AndriesTuinhof/stmbl/hardware/IRAM256A/doc/f405_dma.png

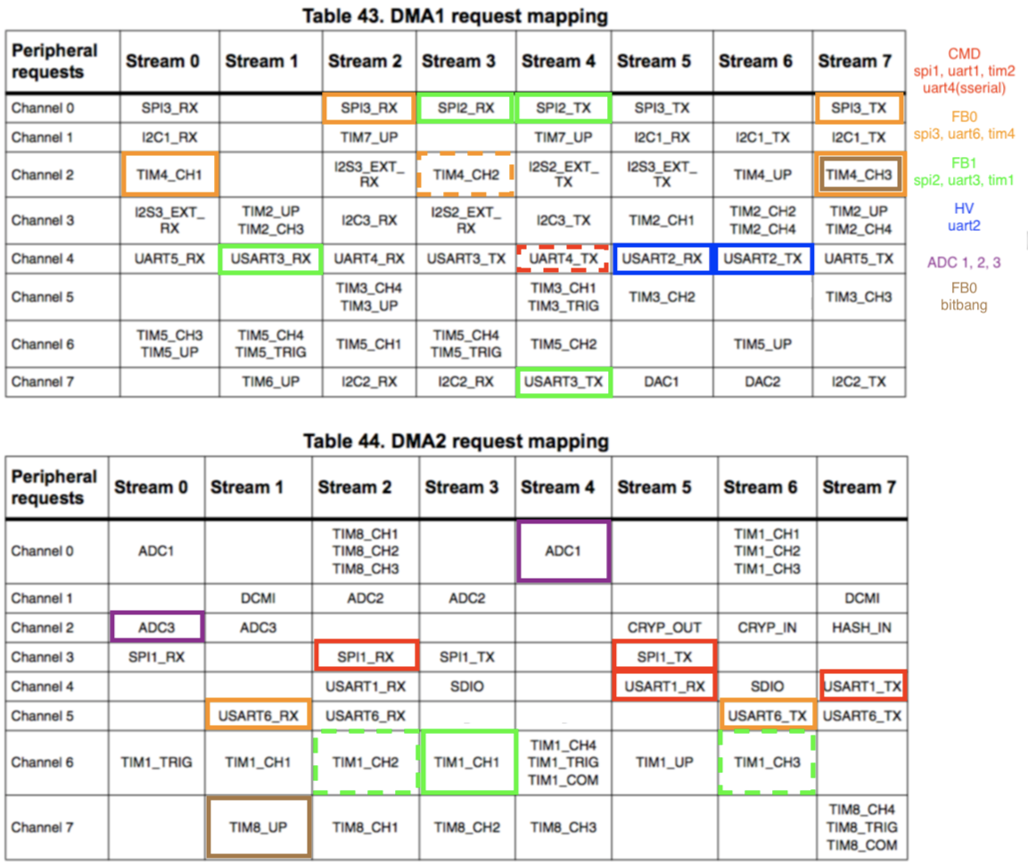
hardware/IRAM256A/doc/f405_dma.png
