AndriesTuinhof/stmbl/hardware/IRAM256A/doc/f303_dma1.png

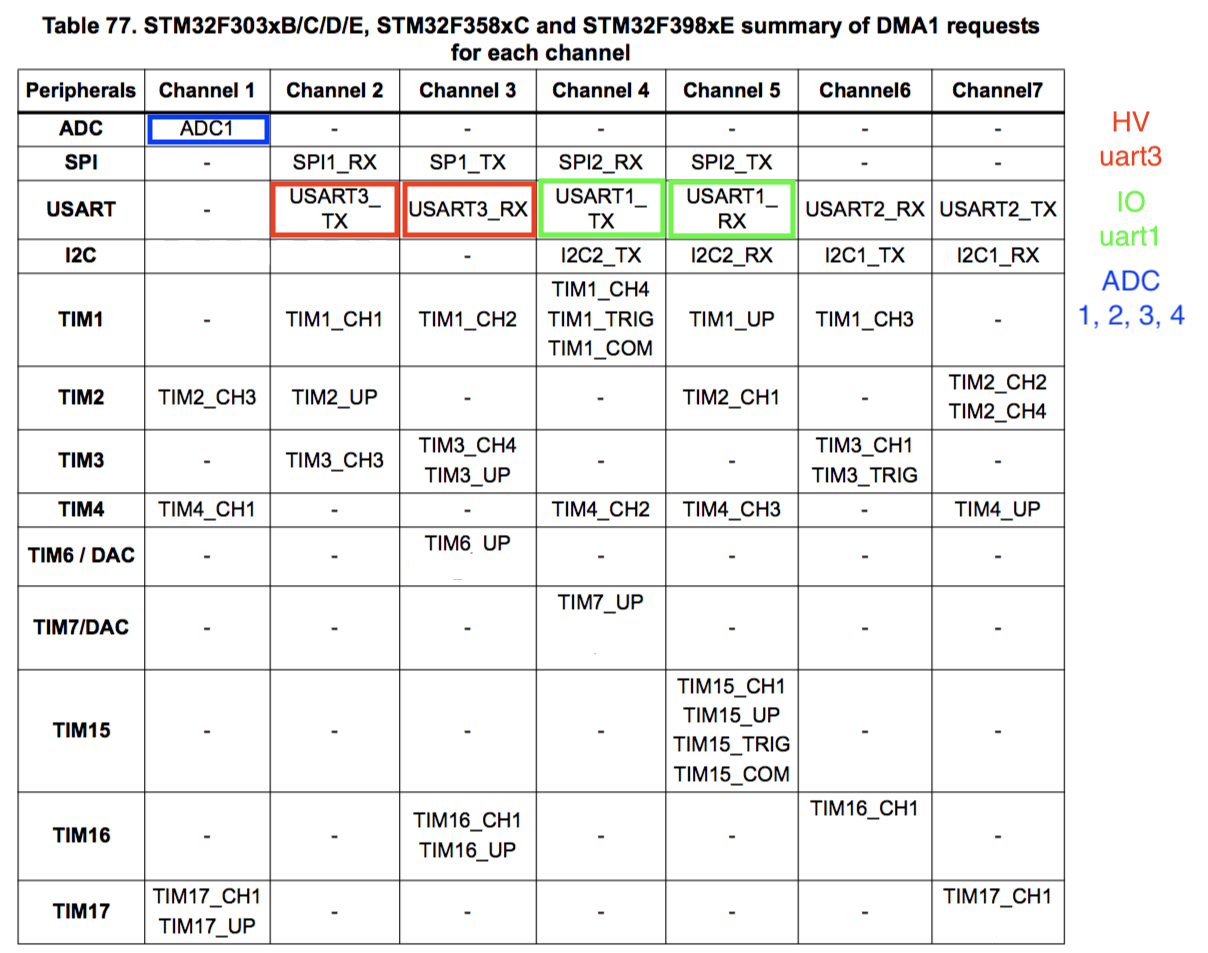
hardware/IRAM256A/doc/f303_dma1.png
