AndriesTuinhof/stmbl/hardware/IRAM256A/doc/f303_dma2.png

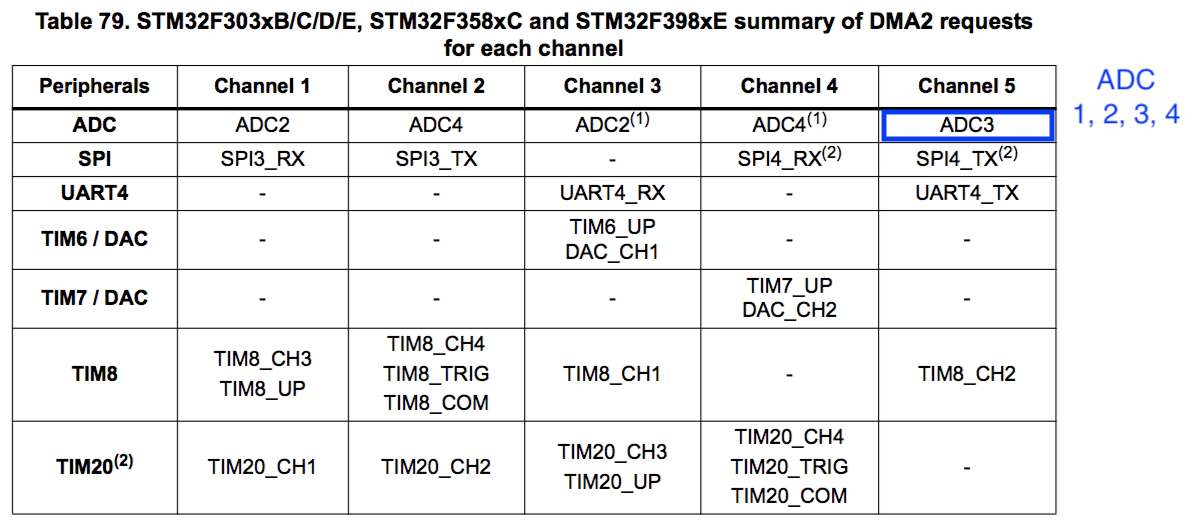
hardware/IRAM256A/doc/f303_dma2.png
