AndriesTuinhof/stmbl/hardware/IRAM256A/doc/heatsink.dxf

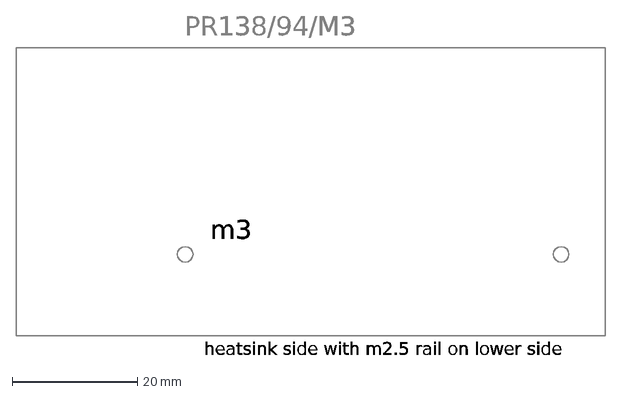
[picture p4: CAD file, 2022-10-24]
hardware/IRAM256A/doc/heatsink.dxf
m3
heatsink side with m2.5 rail on lower side
PR138/94/M3
