AndriesTuinhof/stmbl/hardware/old designs/kicad/troller/troller.dxf

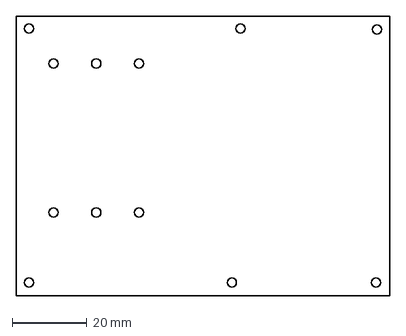
[picture p5: CAD file, 2022-10-24, an earlier design]
hardware/old designs/kicad/troller/troller.dxf
100.0 x 75.0 mm
