AndriesTuinhof/stmbl/hardware/old designs/platte.dxf

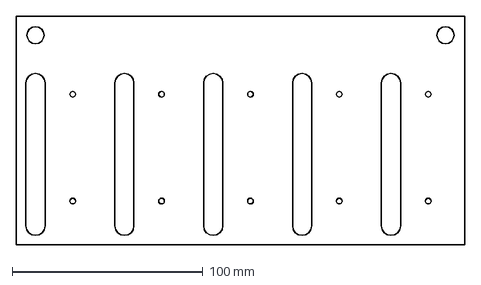
[picture p6: CAD file, 2022-10-24, an earlier design]
hardware/old designs/platte.dxf
235.0 x 120.0 mm
