AndriesTuinhof/stmbl/hardware/old designs/tools/case_v4.stl

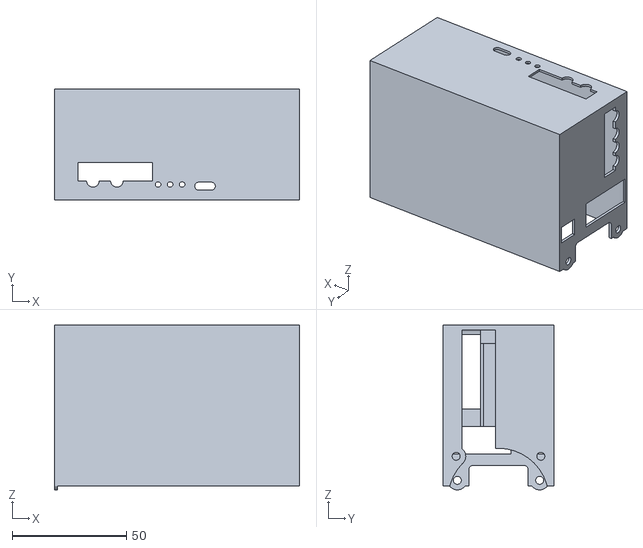
[picture p7: CAD file, 2022-10-24, an earlier design]
hardware/old designs/tools/case_v4.stl
107.1 x 48.6 x 72.0
