AndriesTuinhof/stmbl/hardware/old designs/tools/clip.dxf

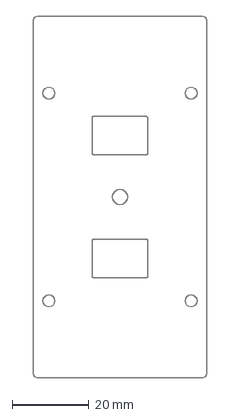
[picture p9: CAD file, 2022-10-24, an earlier design]
hardware/old designs/tools/clip.dxf
45.0 x 94.0 mm
