AndriesTuinhof/stmbl/hardware/old designs/tools/v4_bracket2.stl

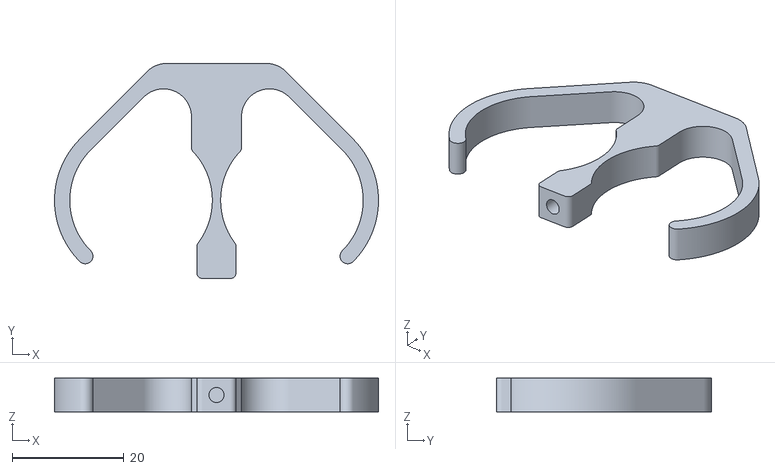
[picture p10: CAD file, 2022-10-24, an earlier design]
hardware/old designs/tools/v4_bracket2.stl
58.0 x 38.5 x 6.00
