AndriesTuinhof/stmbl/hardware/old designs/tools/v4_bracket3.stl

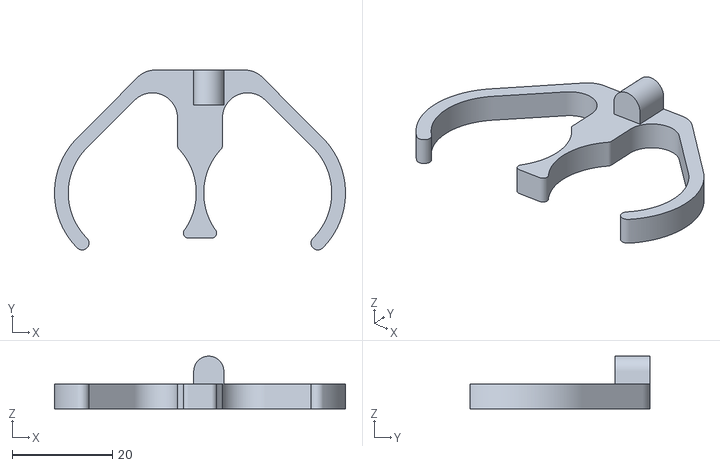
[picture p11: CAD file, 2022-10-24, an earlier design]
hardware/old designs/tools/v4_bracket3.stl
58.0 x 35.9 x 10.5
