AndriesTuinhof/stmbl/hardware/old designs/tools/sheet_metal_case_08.dxf

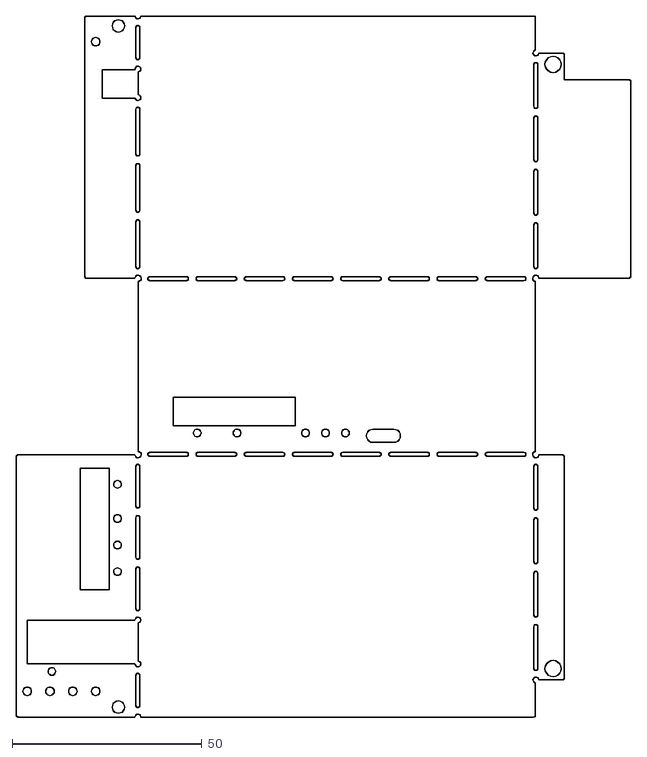
[picture p12: CAD file, 2022-10-24, an earlier design]
hardware/old designs/tools/sheet_metal_case_08.dxf
161.7 x 184.5
