AndriesTuinhof/stmbl/hardware/old designs/tools/v4_bracket.stl

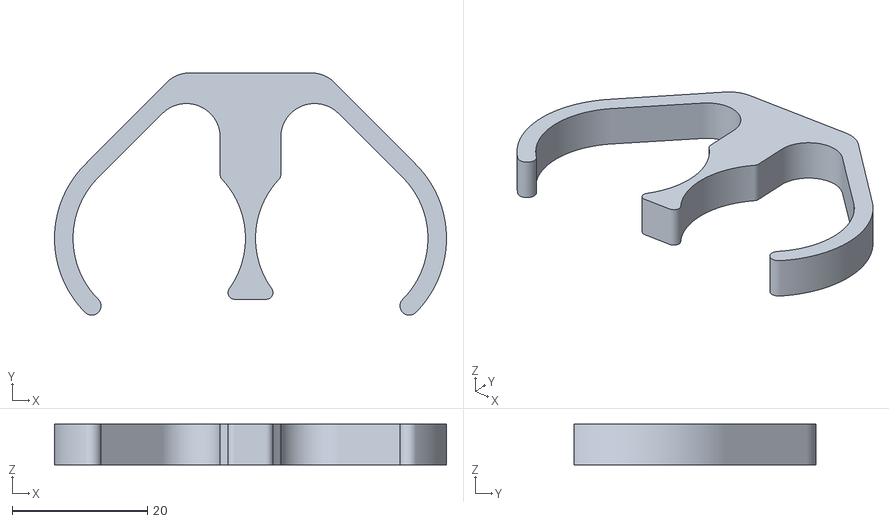
[picture p13: CAD file, 2022-10-24, an earlier design]
hardware/old designs/tools/v4_bracket.stl
58.0 x 35.9 x 6.00
