AndriesTuinhof/stmbl/(list of files, cad)

Other CAD files:
hardware/IRAM256A/stmbl.scad
hardware/old designs/tools/clip.scad
hardware/old designs/tools/lib.scad
hardware/old designs/tools/pcb.scad
hardware/old designs/tools/pcb_simple.scad
hardware/old designs/tools/sheet_metal_case.scad
hardware/old designs/tools/stmbl.scad
hardware/old designs/tools/v4_bracket.dxf
hardware/old designs/tools/v4_bracket.scad
