AndriesTuinhof/stmbl/hardware/IRAM256A/stmbl_4.0.kicad_pcb

## KiCad design hardware/IRAM256A/stmbl_4.0.kicad_pcb (2022-10-24)

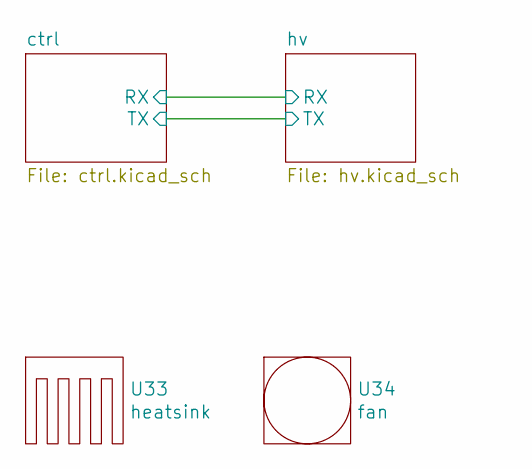
[picture p28: schematic stmbl_4.0.kicad_sch]

Parts:
U33: heatsink
U34: fan; Voltage 12V

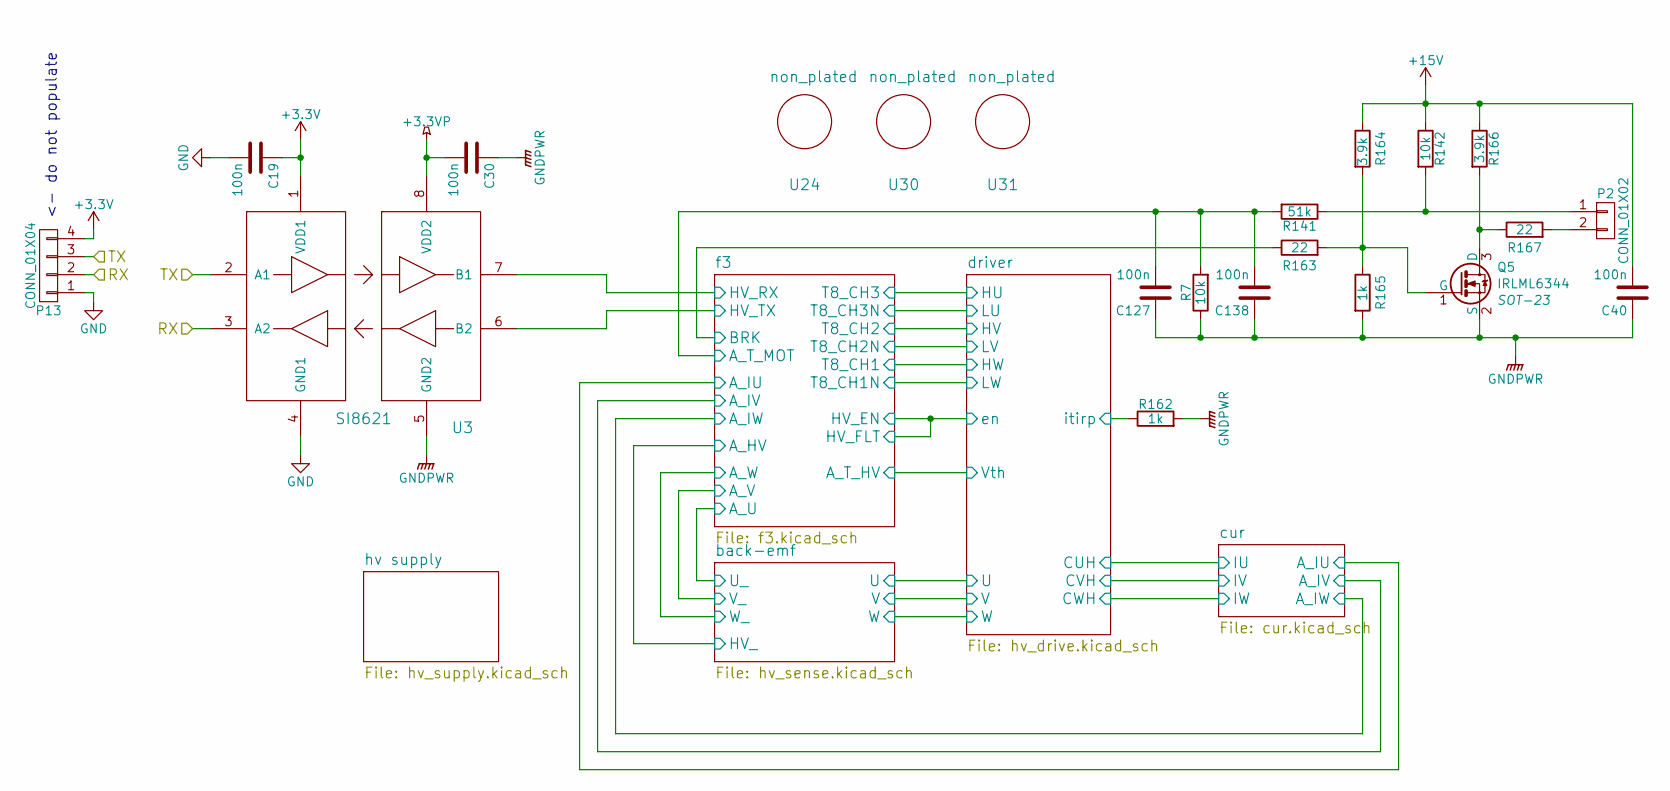
[picture p29: schematic hv.kicad_sch]

Parts:
C19, C30, C40, C127, C138: 100n; C_0603; Voltage 50V; Tolerance X5R
P2: CONN_01X02; RM3.5_1x2
P13: CONN_01X04; Socket_Strip_Straight_1x04
Q5: IRLML6344; SOT-23
R7, R142: 10k; R_0603; Tolerance 1%
R141: 51k; R_0603; Tolerance 1%
R162, R165: 1k; R_0603; Tolerance 1%
R163, R167: 22; R_0603; Tolerance 1%
R164, R166: 3.9k; R_0603; Tolerance 1%
U3: SI8621; SOIC-8-N
U24, U30, U31: non_plated; non_plated_3mm

Connections:
+3.3VP: C30.2, U3.8 (VDD2); also elsewhere on the board
+3V3: C19.1, P13.4, U3.1 (VDD1); also elsewhere on the board
+15V: C40.2, R142.1, R164.1, R166.1; also elsewhere on the board
/ctrl/RX: P13.2, U3.3 (A2); also elsewhere on the board
/ctrl/TX: P13.3, U3.2 (A1); also elsewhere on the board
/hv/driver/itirp: R162.1; also elsewhere on the board
/hv/f3/A_T_MOT: C127.2, C138.2, R7.2, R141.2; also elsewhere on the board
/hv/f3/BRK: R163.1; also elsewhere on the board
/hv/f3/HV_RX: U3.7 (B1); also elsewhere on the board
/hv/f3/HV_TX: U3.6 (B2); also elsewhere on the board
GND: C19.2, P13.1, U3.4 (GND1); also elsewhere on the board
GNDPWR: C30.1, C40.1, C127.1, C138.1, Q5.2 (S), R7.1, R162.2, R165.2, U3.5 (GND2); also elsewhere on the board
unnamed: P2.1, R141.1, R142.2
unnamed: P2.2, R167.2
unnamed: Q5.1 (G), R163.2, R164.2, R165.1
unnamed: Q5.3 (D), R166.2, R167.1

Notes on the sheet:
<- do not populate

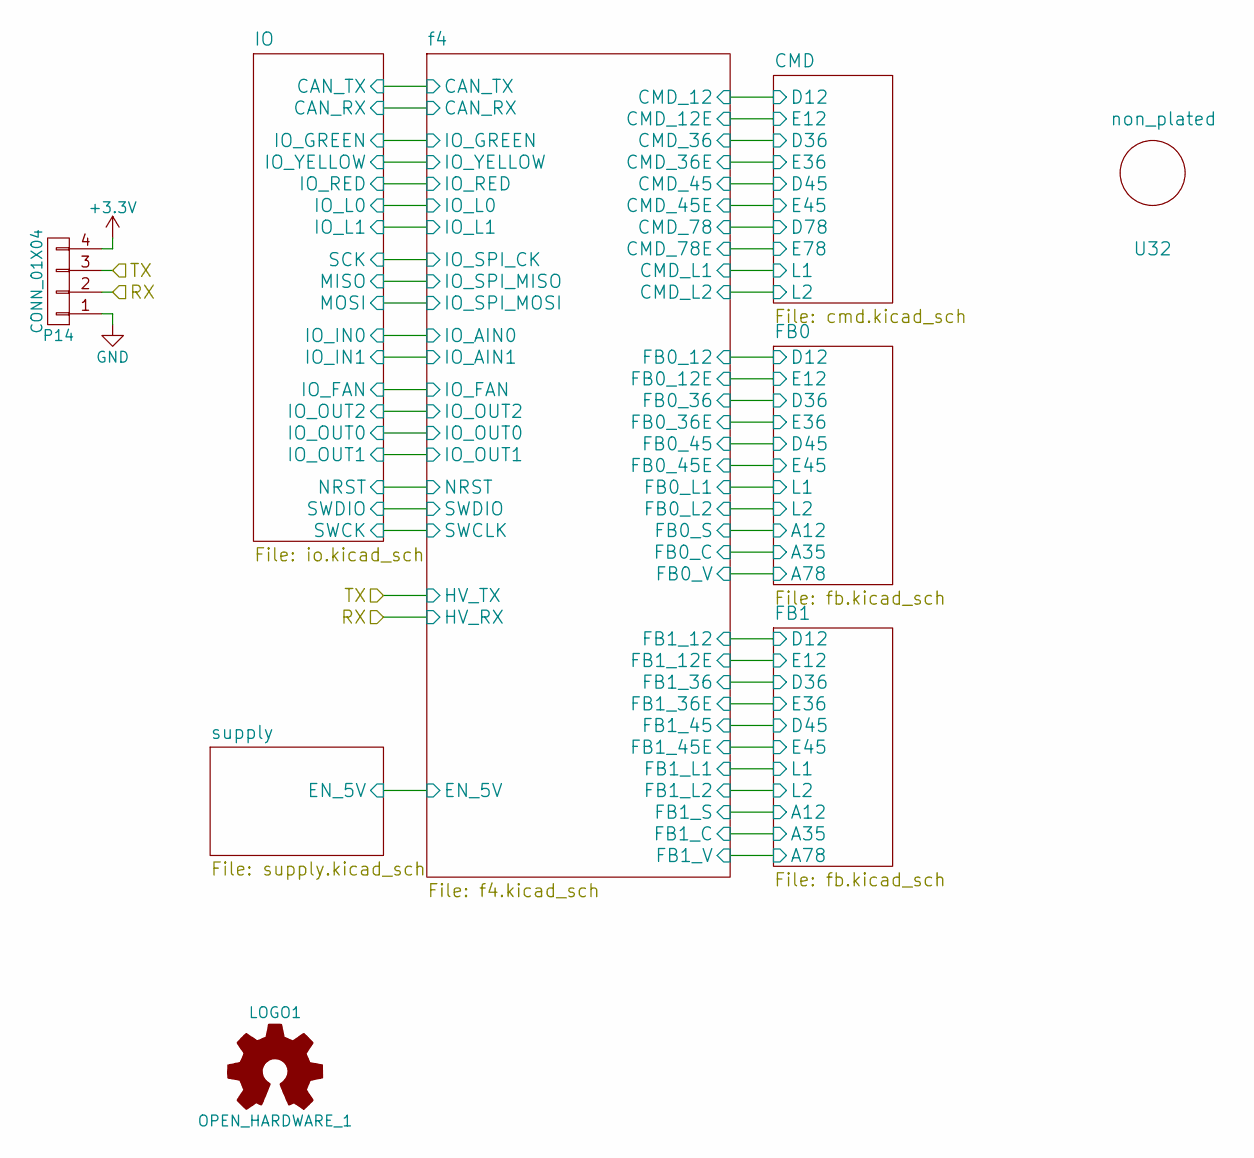
[picture p30: schematic ctrl.kicad_sch]

Parts:
LOGO1: OPEN_HARDWARE_1; Symbol_OSHW-Logo_SilkScreen
P14: CONN_01X04; Pin_Header_Angled_1x04
U32: non_plated; non_plated_3mm

Connections:
+3V3: P14.4; also elsewhere on the board
/ctrl/RX: P14.2; also elsewhere on the board
/ctrl/TX: P14.3; also elsewhere on the board
GND: P14.1; also elsewhere on the board

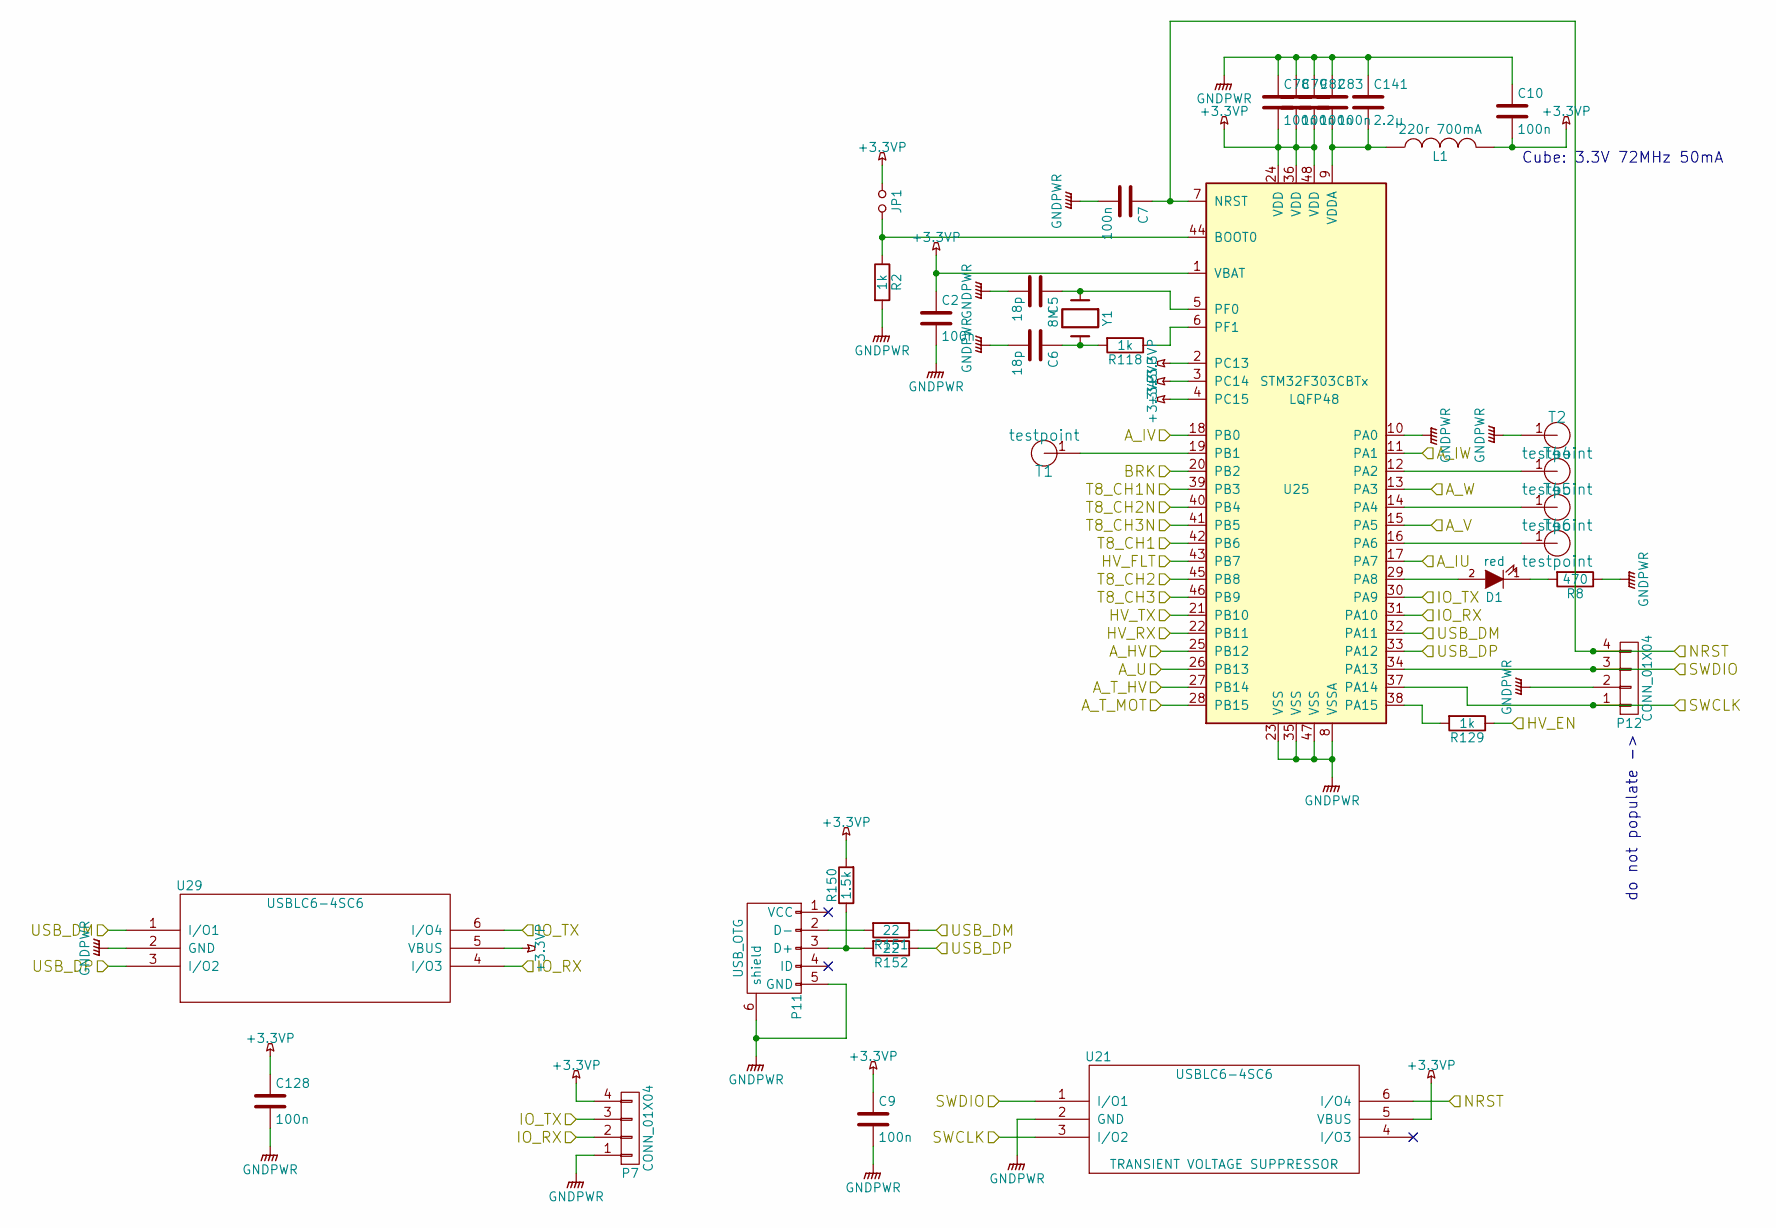
[picture p31: schematic f3.kicad_sch]

Parts:
C2, C7, C9, C10, C78, C79, C82, C83, C128: 100n; C_0603; Voltage 50V; Tolerance X5R
C5, C6: 18p; C_0603; Voltage 50V; Tolerance X5R
C141: 2.2µ; C_0603; Voltage 35V; Tolerance X5R
D1: red; LED-0805-SIDE
JP1: Jumper_NO_Small; SOLDER_JUMPER
L1: 220r 700mA; R_0603
P7, P12: CONN_01X04; Pin_Header_Straight_1x04
P11: USB_OTG; USB_Micro-B
R2, R118, R129: 1k; R_0603; Tolerance 1%
R8: 470; R_0603; Tolerance 1%
R150: 1.5k; R_0603; Tolerance 1%
R151, R152: 22; R_0603; Tolerance 1%
T1, T2, T44, T45, T46: testpoint; Measurement_Point_Round-SMD-Pad_Small
U21, U29: USBLC6-4SC6; SOT-23-6
U25: STM32F303CBTx; LQFP48
Y1: 8M; Crystal_SMD_0503_4Pads

Connections:
+3.3VP: C2.1, C9.1, C10.2, C78.2, C79.2, C82.2, C128.1, JP1.1, L1.2, P7.4, R150.2, U21.5 (VBUS), U25.1 (VBAT), U25.2 (PC13), U25.3 (PC14), U25.4 (PC15), U25.24 (VDD), U25.36 (VDD), U25.48 (VDD), U29.5 (VBUS); also elsewhere on the board
/hv/back-emf/HV_: U25.25 (PB12); also elsewhere on the board
/hv/back-emf/U_: U25.26 (PB13); also elsewhere on the board
/hv/back-emf/V_: U25.15 (PA5); also elsewhere on the board
/hv/back-emf/W_: U25.13 (PA3); also elsewhere on the board
/hv/cur/A_IU: U25.17 (PA7); also elsewhere on the board
/hv/cur/A_IV: U25.18 (PB0); also elsewhere on the board
/hv/cur/A_IW: U25.11 (PA1); also elsewhere on the board
/hv/driver/HU: U25.46 (PB9); also elsewhere on the board
/hv/driver/HV: U25.45 (PB8); also elsewhere on the board
/hv/driver/HW: U25.42 (PB6); also elsewhere on the board
/hv/driver/LU: U25.41 (PB5); also elsewhere on the board
/hv/driver/LV: U25.40 (PB4); also elsewhere on the board
/hv/driver/LW: U25.39 (PB3); also elsewhere on the board
/hv/driver/Vth: U25.27 (PB14); also elsewhere on the board
/hv/driver/en: R129.1, U25.43 (PB7); also elsewhere on the board
/hv/f3/A_T_MOT: U25.28 (PB15); also elsewhere on the board
/hv/f3/BRK: U25.20 (PB2); also elsewhere on the board
/hv/f3/HV_RX: U25.22 (PB11); also elsewhere on the board
/hv/f3/HV_TX: U25.21 (PB10); also elsewhere on the board
/hv/f3/IO_RX: P7.2, U25.31 (PA10), U29.4 (I/O3)
/hv/f3/IO_TX: P7.3, U25.30 (PA9), U29.6 (I/O4)
/hv/f3/NRST: C7.1, P12.4, U21.6 (I/O4), U25.7 (NRST)
/hv/f3/SWCLK: P12.1, U21.3 (I/O2), U25.37 (PA14)
/hv/f3/SWDIO: P12.3, U21.1 (I/O1), U25.34 (PA13)
/hv/f3/USB_DM: R151.1, U25.32 (PA11), U29.1 (I/O1)
/hv/f3/USB_DP: R152.1, U25.33 (PA12), U29.3 (I/O2)
GNDPWR: C2.2, C5.2, C6.2, C7.2, C9.2, C10.1, C78.1, C79.1, C82.1, C83.1, C128.2, C141.1, P7.1, P11.5 (GND), P11.6 (shield), P12.2, R2.2, R8.1, T2.1, U21.2 (GND), U25.8 (VSSA), U25.10 (PA0), U25.23 (VSS), U25.35 (VSS), U25.47 (VSS), U29.2 (GND); also elsewhere on the board
unnamed: C5.1, U25.5 (PF0), Y1.1
unnamed: C6.1, R118.2, Y1.2
unnamed: C83.2, C141.2, L1.1, U25.9 (VDDA)
unnamed: D1.1 (K), R8.2
unnamed: D1.2 (A), U25.29 (PA8)
unnamed: JP1.2, R2.1, U25.44 (BOOT0)
unnamed: P11.2 (D-), R151.2
unnamed: P11.3 (D+), R150.1, R152.2
unnamed: R118.1, U25.6 (PF1)
unnamed: R129.2, U25.38 (PA15)
unnamed: T1.1, U25.19 (PB1)
unnamed: T44.1, U25.12 (PA2)
unnamed: T45.1, U25.14 (PA4)
unnamed: T46.1, U25.16 (PA6)

Notes on the sheet:
Cube: 3.3V 72MHz 50mA
do not populate ->

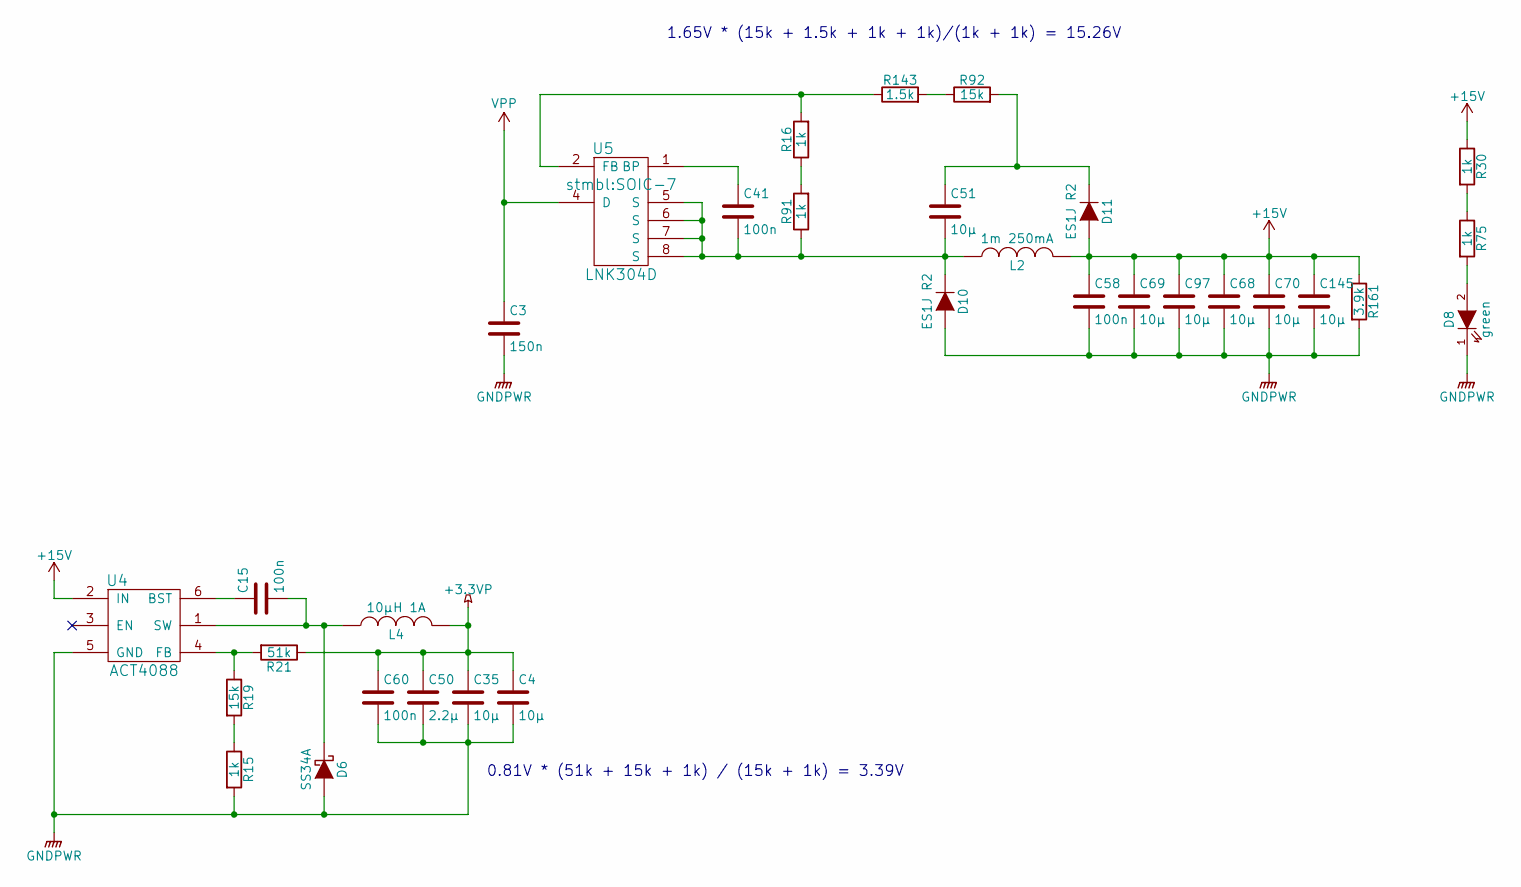
[picture p32: schematic hv_supply.kicad_sch]

Parts:
C3: 150n; C_1808; Voltage 500V; Tolerance X7R
C4, C35, C51, C68, C69, C70, C97, C145: 10µ; C_0805; Voltage 25V; Tolerance X5R
C15, C41, C58, C60: 100n; C_0603; Voltage 50V; Tolerance X5R
C50: 2.2µ; C_0603; Voltage 35V; Tolerance X5R
D6: SS34A; SMA_Standard
D8: green; LED-0805-SIDE
D10, D11: ES1J R2; SMA_Standard
L2: 1m 250mA; NPI31W
L4: 10µH 1A; SMD_INDUCTOR_32x25
R15, R16, R30, R75, R91: 1k; R_0603; Tolerance 1%
R19, R92: 15k; R_0603; Tolerance 1%
R21: 51k; R_0603; Tolerance 1%
R143: 1.5k; R_0603; Tolerance 1%
R161: 3.9k; R_0603; Tolerance 1%
U4: ACT4088; SOT-23-6
U5: LNK304D; SOIC-7

Connections:
+3.3VP: C4.1, C35.1, C50.1, C60.1, L4.2, R21.1; also elsewhere on the board
+15V: C58.1, C68.1, C69.1, C70.1, C97.1, C145.1, D11.2 (A), L2.2, R30.1, R161.1, U4.2 (IN); also elsewhere on the board
GNDPWR: C3.2, C4.2, C35.2, C50.2, C58.2, C60.2, C68.2, C69.2, C70.2, C97.2, C145.2, D6.2 (A), D8.1 (K), D10.2 (A), R15.2, R161.2, U4.5 (GND); also elsewhere on the board
unnamed: C15.1, U4.6 (BST)
unnamed: C15.2, D6.1 (K), L4.1, U4.1 (SW)
unnamed: C41.1, U5.1 (BP)
unnamed: C41.2, C51.2, D10.1 (K), L2.1, R91.1, U5.5 (S), U5.6 (S), U5.7 (S), U5.8 (S)
unnamed: C51.1, D11.1 (K), R92.2
unnamed: D8.2 (A), R75.2
unnamed: R15.1, R19.2
unnamed: R16.1, R91.2
unnamed: R19.1, R21.2, U4.4 (FB)
unnamed: R30.2, R75.1
unnamed: R16.2, R143.1, U5.2 (FB)
unnamed: R92.1, R143.2
VPP: C3.1, U5.4 (D); also elsewhere on the board

Notes on the sheet:
0.81V * (51k + 15k + 1k) / (15k + 1k) = 3.39V
1.65V * (15k + 1.5k + 1k + 1k)/(1k + 1k) = 15.26V

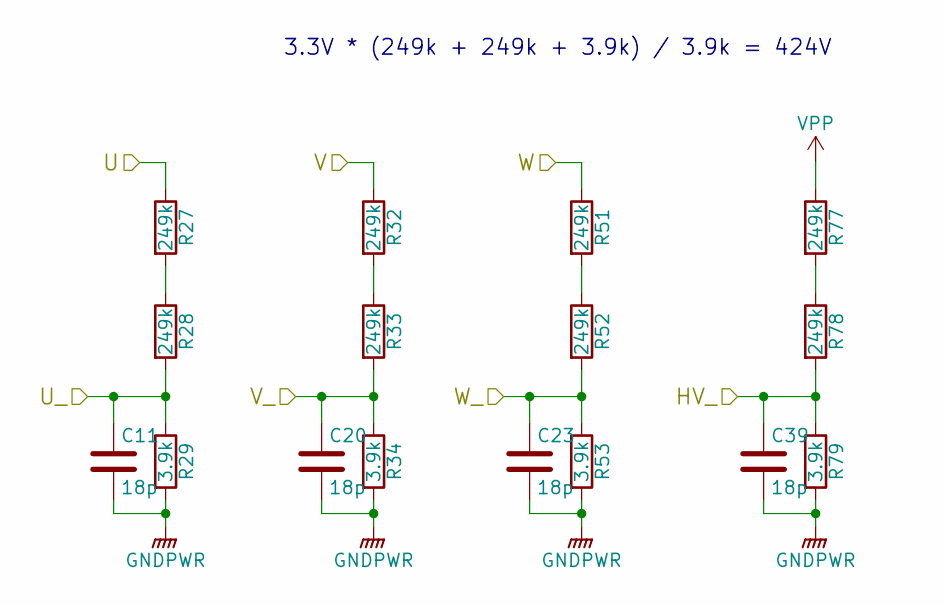
[picture p33: schematic hv_sense.kicad_sch]

Parts:
C11, C20, C23, C39: 18p; C_0603; Voltage 50V; Tolerance X5R
R27, R28, R32, R33, R51, R52, R77, R78: 249k; R_1206; Voltage 200V; Tolerance 1%
R29, R34, R53, R79: 3.9k; R_0603; Tolerance 1%

Connections:
/hv/back-emf/HV_: C39.1, R78.2, R79.1; also elsewhere on the board
/hv/back-emf/U: R27.1; also elsewhere on the board
/hv/back-emf/U_: C11.1, R28.2, R29.1; also elsewhere on the board
/hv/back-emf/V: R32.1; also elsewhere on the board
/hv/back-emf/V_: C20.1, R33.2, R34.1; also elsewhere on the board
/hv/back-emf/W: R51.1; also elsewhere on the board
/hv/back-emf/W_: C23.1, R52.2, R53.1; also elsewhere on the board
GNDPWR: C11.2, C20.2, C23.2, C39.2, R29.2, R34.2, R53.2, R79.2; also elsewhere on the board
unnamed: R27.2, R28.1
unnamed: R32.2, R33.1
unnamed: R51.2, R52.1
unnamed: R77.2, R78.1
VPP: R77.1; also elsewhere on the board

Notes on the sheet:
3.3V * (249k + 249k + 3.9k) / 3.9k = 424V

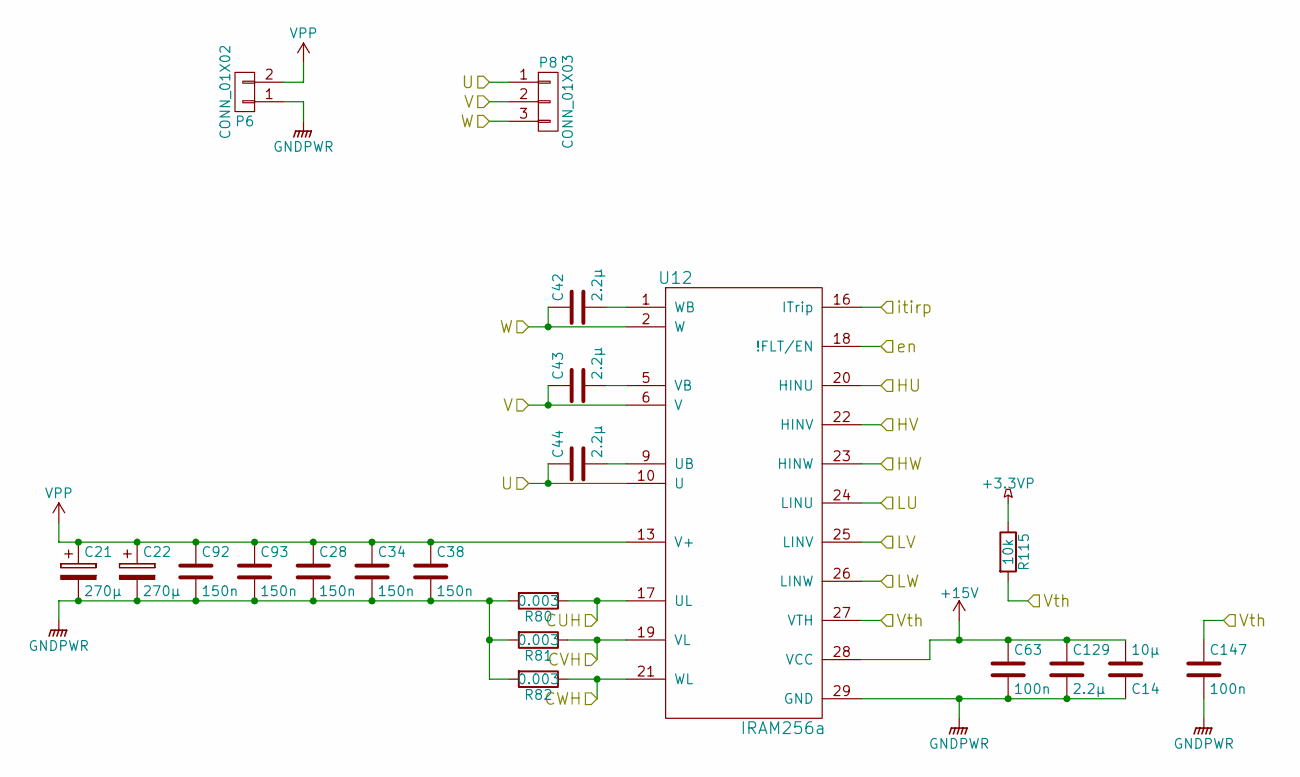
[picture p34: schematic hv_drive.kicad_sch]

Parts:
C14: 10µ; C_0805; Voltage 25V; Tolerance X5R
C21, C22: 270µ; C_Radial_D26_L45_P10; Voltage 400V
C28, C34, C38, C92, C93: 150n; C_1808; Voltage 500V; Tolerance X7R
C42, C43, C44, C129: 2.2µ; C_0603; Voltage 35V; Tolerance X5R
C63, C147: 100n; C_0603; Voltage 50V; Tolerance X5R
P6: CONN_01X02; RM5.08_1x2
P8: CONN_01X03; RM5.08_1x3
R80, R81, R82: 0.003; R_2512; Tolerance 1%
R115: 10k; R_0603; Tolerance 1%
U12: IRAM256a; IRAM256

Connections:
+3.3VP: R115.1; also elsewhere on the board
+15V: C14.2, C63.1, C129.1, U12.28 (VCC); also elsewhere on the board
/hv/back-emf/U: C44.1, P8.1, U12.10 (U); also elsewhere on the board
/hv/back-emf/V: C43.1, P8.2, U12.6 (V); also elsewhere on the board
/hv/back-emf/W: C42.1, P8.3, U12.2 (W); also elsewhere on the board
/hv/cur/IU: R80.1, U12.17 (UL); also elsewhere on the board
/hv/cur/IV: R81.1, U12.19 (VL); also elsewhere on the board
/hv/cur/IW: R82.1, U12.21 (WL); also elsewhere on the board
/hv/driver/HU: U12.20 (HINU); also elsewhere on the board
/hv/driver/HV: U12.22 (HINV); also elsewhere on the board
/hv/driver/HW: U12.23 (HINW); also elsewhere on the board
/hv/driver/LU: U12.24 (LINU); also elsewhere on the board
/hv/driver/LV: U12.25 (LINV); also elsewhere on the board
/hv/driver/LW: U12.26 (LINW); also elsewhere on the board
/hv/driver/Vth: C147.1, R115.2, U12.27 (VTH); also elsewhere on the board
/hv/driver/en: U12.18 (!FLT/EN); also elsewhere on the board
/hv/driver/itirp: U12.16 (ITrip); also elsewhere on the board
GNDPWR: C14.1, C21.2, C22.2, C28.2, C34.2, C38.2, C63.2, C92.2, C93.2, C129.2, C147.2, P6.1, R80.2, R81.2, R82.2, U12.29 (GND); also elsewhere on the board
unnamed: C42.2, U12.1 (WB)
unnamed: C43.2, U12.5 (VB)
unnamed: C44.2, U12.9 (UB)
VPP: C21.1, C22.1, C28.1, C34.1, C38.1, C92.1, C93.1, P6.2, U12.13 (V+); also elsewhere on the board

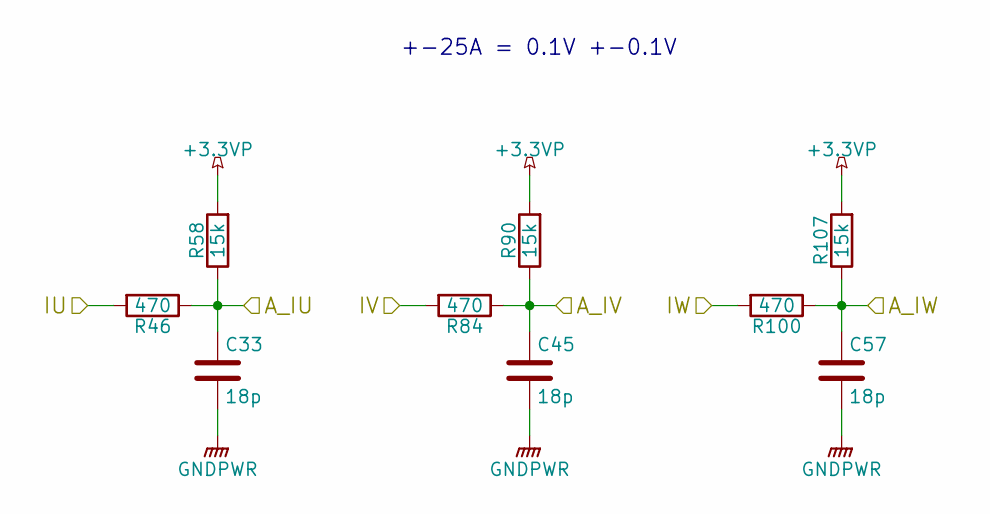
[picture p35: schematic cur.kicad_sch]

Parts:
C33, C45, C57: 18p; C_0603; Voltage 50V; Tolerance X5R
R46, R84, R100: 470; R_0603; Tolerance 1%
R58, R90, R107: 15k; R_0603; Tolerance 1%

Connections:
+3.3VP: R58.2, R90.2, R107.2; also elsewhere on the board
/hv/cur/A_IU: C33.1, R46.1, R58.1; also elsewhere on the board
/hv/cur/A_IV: C45.1, R84.1, R90.1; also elsewhere on the board
/hv/cur/A_IW: C57.1, R100.1, R107.1; also elsewhere on the board
/hv/cur/IU: R46.2; also elsewhere on the board
/hv/cur/IV: R84.2; also elsewhere on the board
/hv/cur/IW: R100.2; also elsewhere on the board
GNDPWR: C33.2, C45.2, C57.2; also elsewhere on the board

Notes on the sheet:
+-25A = 0.1V +-0.1V

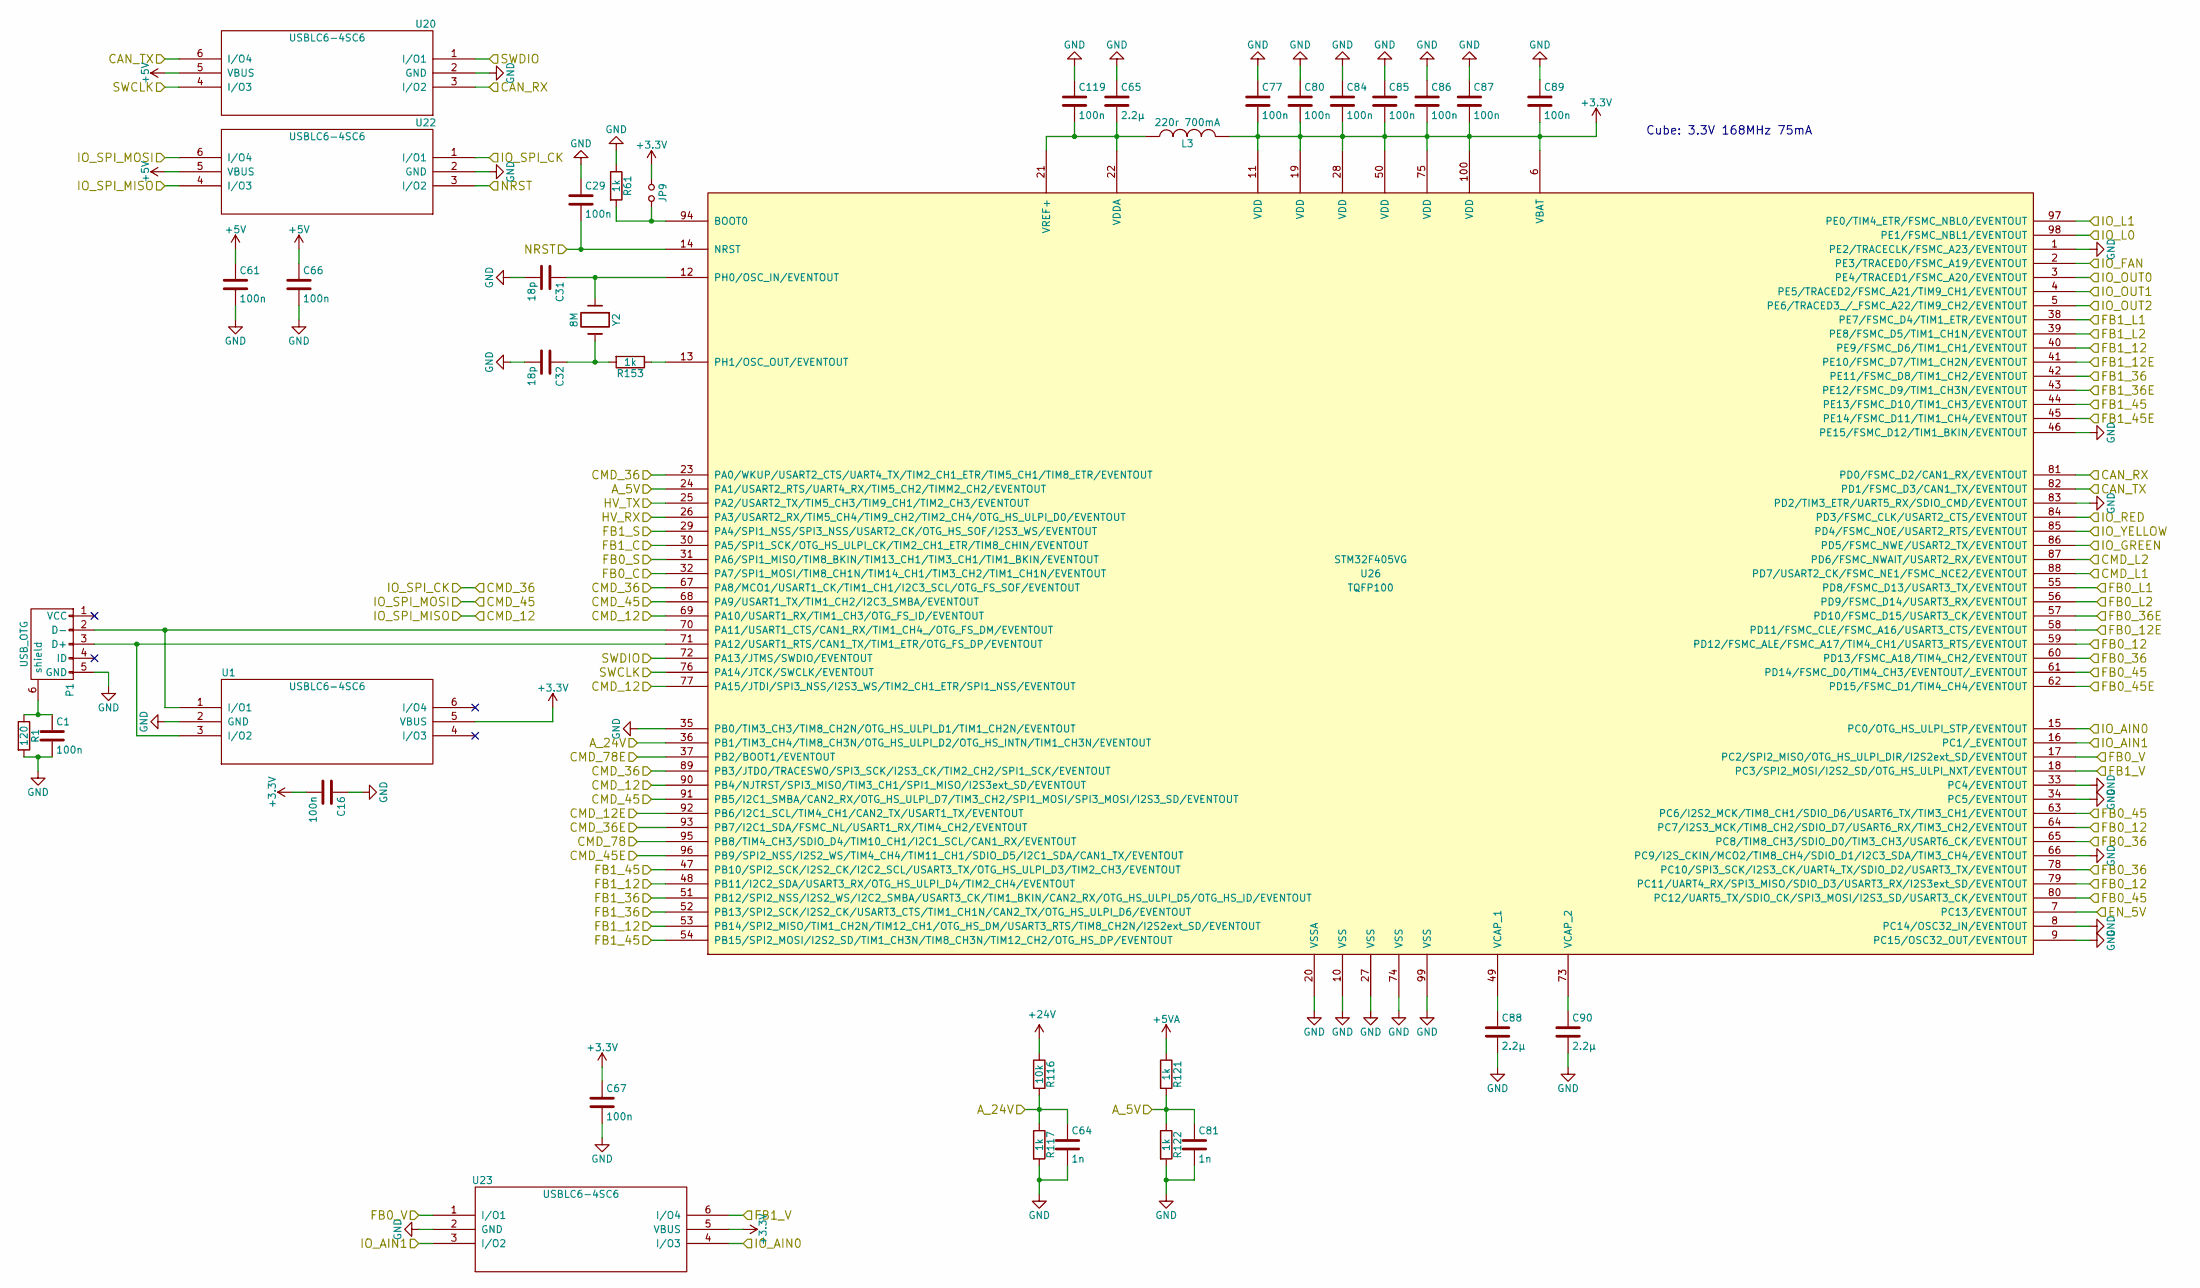
[picture p36: schematic f4.kicad_sch]

Parts:
C1, C16, C29, C61, C66, C67, C77, C80, C84, C85, C86, C87, C89, C119: 100n; C_0603; Voltage 50V; Tolerance X5R
C31, C32: 18p; C_0603; Voltage 50V; Tolerance X5R
C64, C81: 1n; C_0603; Voltage 50V; Tolerance X5R
C65, C88, C90: 2.2µ; C_0603; Voltage 35V; Tolerance X5R
JP9: Jumper_NO_Small; SOLDER_JUMPER
L3: 220r 700mA; R_0603
P1: USB_OTG; USB_Micro-B
R1: 120; R_0603; Tolerance 1%
R61, R117, R121, R122, R153: 1k; R_0603; Tolerance 1%
R116: 10k; R_0603; Tolerance 1%
U1, U20, U22, U23: USBLC6-4SC6; SOT-23-6
U26: STM32F405VG; TQFP100
Y2: 8M; Crystal_SMD_0503_4Pads

Connections:
+3V3: C16.2, C67.1, C77.2, C80.2, C84.2, C85.2, C86.2, C87.2, C89.2, JP9.1, L3.2, U1.5 (VBUS), U23.5 (VBUS), U26.6 (VBAT), U26.11 (VDD), U26.19 (VDD), U26.28 (VDD), U26.50 (VDD), U26.75 (VDD), U26.100 (VDD); also elsewhere on the board
+5V: C61.1, C66.1, U20.5 (VBUS), U22.5 (VBUS); also elsewhere on the board
+5VA: R121.1; also elsewhere on the board
+24V: R116.1; also elsewhere on the board
/ctrl/CMD/D12: U22.4 (I/O3), U26.69 (PA10/USART1_RX/TIM1_CH3/OTG_FS_ID/EVENT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), U26.77 (PA15/JTDI/SPI3_NSS/I2S3_WS/TIM2_CH1_ETR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), U26.90 (PB4/NJTRST/SPI3_MISO/TIM3_CH1/SPI1_MISO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); also elsewhere on the board
/ctrl/CMD/D36: U22.1 (I/O1), U26.23 (PA0/WKUP/USART2_CTS/UART4_TX/TIM2_CH1_E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), U26.67 (PA8/MCO1/USART1_CK/TIM1_CH1/I2C3_SCL/OT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), U26.89 (PB3/JTDO/TRACESWO/SPI3_SCK/I2S3_CK/TIM2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); also elsewhere on the board
/ctrl/CMD/D45: U22.6 (I/O4), U26.68 (PA9/USART1_TX/TIM1_CH2/I2C3_SMBA/EVENTO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), U26.91 (PB5/I2C1_SMBA/CAN2_RX/OTG_HS_ULPI_D7/TI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); also elsewhere on the board
/ctrl/CMD/D78: U26.95 (PB8/TIM4_CH3/SDIO_D4/TIM10_CH1/I2C1_SCL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); also elsewhere on the board
/ctrl/CMD/E12: U26.92 (PB6/I2C1_SCL/TIM4_CH1/CAN2_TX/USART1_TX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); also elsewhere on the board
/ctrl/CMD/E36: U26.93 (PB7/I2C1_SDA/FSMC_NL/USART1_RX/TIM4_CH2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); also elsewhere on the board
/ctrl/CMD/E45: U26.96 (PB9/SPI2_NSS/I2S2_WS/TIM4_CH4/TIM11_CH1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); also elsewhere on the board
/ctrl/CMD/E78: U26.37 (PB2/BOOT1/EVENTOUT); also elsewhere on the board
/ctrl/CMD/L1: U26.88 (PD7/USART2_CK/FSMC_NE1/FSMC_NCE2/EVENTO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); also elsewhere on the board
/ctrl/CMD/L2: U26.87 (PD6/FSMC_NWAIT/USART2_RX/EVENTOUT); also elsewhere on the board
/ctrl/FB0/A12: U26.31 (PA6/SPI1_MISO/TIM8_BKIN/TIM13_CH1/TIM3_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); also elsewhere on the board
/ctrl/FB0/A35: U26.32 (PA7/SPI1_MOSI/TIM8_CH1N/TIM14_CH1/TIM3_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); also elsewhere on the board
/ctrl/FB0/A78: U23.1 (I/O1), U26.17 (PC2/SPI2_MISO/OTG_HS_ULPI_DIR/I2S2ext_S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); also elsewhere on the board
/ctrl/FB0/D12: U26.59 (PD12/FSMC_ALE/FSMC_A17/TIM4_CH1/USART3_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), U26.64 (PC7/I2S3_MCK/TIM8_CH2/SDIO_D7/USART6_RX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), U26.79 (PC11/UART4_RX/SPI3_MISO/SDIO_D3/USART3_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); also elsewhere on the board
/ctrl/FB0/D36: U26.60 (PD13/FSMC_A18/TIM4_CH2/EVENTOUT), U26.65 (PC8/TIM8_CH3/SDIO_D0/TIM3_CH3/USART6_CK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), U26.78 (PC10/SPI3_SCK/I2S3_CK/UART4_TX/SDIO_D2/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); also elsewhere on the board
/ctrl/FB0/D45: U26.61 (PD14/FSMC_D0/TIM4_CH3/EVENTOUT/_EVENTOUT), U26.63 (PC6/I2S2_MCK/TIM8_CH1/SDIO_D6/USART6_TX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), U26.80 (PC12/UART5_TX/SDIO_CK/SPI3_MOSI/I2S3_SD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); also elsewhere on the board
/ctrl/FB0/E12: U26.58 (PD11/FSMC_CLE/FSMC_A16/USART3_CTS/EVENT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); also elsewhere on the board
/ctrl/FB0/E36: U26.57 (PD10/FSMC_D15/USART3_CK/EVENTOUT); also elsewhere on the board
/ctrl/FB0/E45: U26.62 (PD15/FSMC_D1/TIM4_CH4/EVENTOUT); also elsewhere on the board
/ctrl/FB0/L1: U26.55 (PD8/FSMC_D13/USART3_TX/EVENTOUT); also elsewhere on the board
/ctrl/FB0/L2: U26.56 (PD9/FSMC_D14/USART3_RX/EVENTOUT); also elsewhere on the board
/ctrl/FB1/A12: U26.29 (PA4/SPI1_NSS/SPI3_NSS/USART2_CK/OTG_HS_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); also elsewhere on the board
/ctrl/FB1/A35: U26.30 (PA5/SPI1_SCK/OTG_HS_ULPI_CK/TIM2_CH1_ET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); also elsewhere on the board
/ctrl/FB1/A78: U23.6 (I/O4), U26.18 (PC3/SPI2_MOSI/I2S2_SD/OTG_HS_ULPI_NXT/E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); also elsewhere on the board
/ctrl/FB1/D12: U26.40 (PE9/FSMC_D6/TIM1_CH1/EVENTOUT), U26.48 (PB11/I2C2_SDA/USART3_RX/OTG_HS_ULPI_D4/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), U26.53 (PB14/SPI2_MISO/TIM1_CH2N/TIM12_CH1/OTG_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); also elsewhere on the board
/ctrl/FB1/D36: U26.42 (PE11/FSMC_D8/TIM1_CH2/EVENTOUT), U26.51 (PB12/SPI2_NSS/I2S2_WS/I2C2_SMBA/USART3_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), U26.52 (PB13/SPI2_SCK/I2S2_CK/USART3_CTS/TIM1_C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); also elsewhere on the board
/ctrl/FB1/D45: U26.44 (PE13/FSMC_D10/TIM1_CH3/EVENTOUT), U26.47 (PB10/SPI2_SCK/I2S2_CK/I2C2_SCL/USART3_T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), U26.54 (PB15/SPI2_MOSI/I2S2_SD/TIM1_CH3N/TIM8_C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); also elsewhere on the board
/ctrl/FB1/E12: U26.41 (PE10/FSMC_D7/TIM1_CH2N/EVENTOUT); also elsewhere on the board
/ctrl/FB1/E36: U26.43 (PE12/FSMC_D9/TIM1_CH3N/EVENTOUT); also elsewhere on the board
/ctrl/FB1/E45: U26.45 (PE14/FSMC_D11/TIM1_CH4/EVENTOUT); also elsewhere on the board
/ctrl/FB1/L1: U26.38 (PE7/FSMC_D4/TIM1_ETR/EVENTOUT); also elsewhere on the board
/ctrl/FB1/L2: U26.39 (PE8/FSMC_D5/TIM1_CH1N/EVENTOUT); also elsewhere on the board
/ctrl/IO/CAN_RX: U20.3 (I/O2), U26.81 (PD0/FSMC_D2/CAN1_RX/EVENTOUT); also elsewhere on the board
/ctrl/IO/CAN_TX: U20.6 (I/O4), U26.82 (PD1/FSMC_D3/CAN1_TX/EVENTOUT); also elsewhere on the board
/ctrl/IO/IO_FAN: U26.2 (PE3/TRACED0/FSMC_A19/EVENTOUT); also elsewhere on the board
/ctrl/IO/IO_GREEN: U26.86 (PD5/FSMC_NWE/USART2_TX/EVENTOUT); also elsewhere on the board
/ctrl/IO/IO_IN0: U23.4 (I/O3), U26.15 (PC0/OTG_HS_ULPI_STP/EVENTOUT); also elsewhere on the board
/ctrl/IO/IO_IN1: U23.3 (I/O2), U26.16 (PC1/_EVENTOUT); also elsewhere on the board
/ctrl/IO/IO_L0: U26.98 (PE1/FSMC_NBL1/EVENTOUT); also elsewhere on the board
/ctrl/IO/IO_L1: U26.97 (PE0/TIM4_ETR/FSMC_NBL0/EVENTOUT); also elsewhere on the board
/ctrl/IO/IO_OUT0: U26.3 (PE4/TRACED1/FSMC_A20/EVENTOUT); also elsewhere on the board
/ctrl/IO/IO_OUT1: U26.4 (PE5/TRACED2/FSMC_A21/TIM9_CH1/EVENTOUT); also elsewhere on the board
/ctrl/IO/IO_OUT2: U26.5 (PE6/TRACED3_/_FSMC_A22/TIM9_CH2/EVENTOUT); also elsewhere on the board
/ctrl/IO/IO_RED: U26.84 (PD3/FSMC_CLK/USART2_CTS/EVENTOUT); also elsewhere on the board
/ctrl/IO/IO_YELLOW: U26.85 (PD4/FSMC_NOE/USART2_RTS/EVENTOUT); also elsewhere on the board
/ctrl/IO/NRST: C29.2, U22.3 (I/O2), U26.14 (NRST); also elsewhere on the board
/ctrl/IO/SWCK: U20.4 (I/O3), U26.76 (PA14/JTCK/SWCLK/EVENTOUT); also elsewhere on the board
/ctrl/IO/SWDIO: U20.1 (I/O1), U26.72 (PA13/JTMS/SWDIO/EVENTOUT); also elsewhere on the board
/ctrl/RX: U26.26 (PA3/USART2_RX/TIM5_CH4/TIM9_CH2/TIM2_CH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); also elsewhere on the board
/ctrl/TX: U26.25 (PA2/USART2_TX/TIM5_CH3/TIM9_CH1/TIM2_CH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); also elsewhere on the board
/ctrl/f4/A_5V: C81.1, R121.2, R122.1, U26.24 (PA1/USART2_RTS/UART4_RX/TIM5_CH2/TIMM2_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)
/ctrl/f4/A_24V: C64.1, R116.2, R117.1, U26.36 (PB1/TIM3_CH4/TIM8_CH3N/OTG_HS_ULPI_D2/O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)
/ctrl/f4/EN_5V: U26.7 (PC13/EVENTOUT); also elsewhere on the board
GND: C1.2, C16.1, C29.1, C31.2, C32.2, C61.2, C64.2, C65.1, C66.2, C67.2, C77.1, C80.1, C81.2, C84.1, C85.1, C86.1, C87.1, C88.2, C89.1, C90.2, C119.1, P1.5 (GND), R1.2, R61.1, R117.2, R122.2, U1.2 (GND), U20.2 (GND), U22.2 (GND), U23.2 (GND), U26.1 (PE2/TRACECLK/FSMC_A23/EVENTOUT), U26.8 (PC14/OSC32_IN/EVENTOUT), U26.9 (PC15/OSC32_OUT/EVENTOUT), U26.10 (VSS), U26.20 (VSSA), U26.27 (VSS), U26.33 (PC4/EVENTOUT), U26.34 (PC5/EVENTOUT), U26.35 (PB0/TIM3_CH3/TIM8_CH2N/OTG_HS_ULPI_D1/T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), U26.46 (PE15/FSMC_D12/TIM1_BKIN/EVENTOUT), U26.66 (PC9/I2S_CKIN/MCO2/TIM8_CH4/SDIO_D1/I2C3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), U26.74 (VSS), U26.83 (PD2/TIM3_ETR/UART5_RX/SDIO_CMD/EVENTOUT), U26.99 (VSS); also elsewhere on the board
unnamed: C1.1, P1.6 (shield), R1.1
unnamed: C31.1, U26.12 (PH0/OSC_IN/EVENTOUT), Y2.1
unnamed: C32.1, R153.2, Y2.2
unnamed: C88.1, U26.49 (VCAP_1)
unnamed: C90.1, U26.73 (VCAP_2)
unnamed: C65.2, C119.2, L3.1, U26.21 (VREF+), U26.22 (VDDA)
unnamed: JP9.2, R61.2, U26.94 (BOOT0)
unnamed: P1.2 (D-), U1.1 (I/O1), U26.70 (PA11/USART1_CTS/CAN1_RX/TIM1_CH4_/OTG_F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)
unnamed: P1.3 (D+), U1.3 (I/O2), U26.71 (PA12/USART1_RTS/CAN1_TX/TIM1_ETR/OTG_FS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)
unnamed: R153.1, U26.13 (PH1/OSC_OUT/EVENTOUT)

Notes on the sheet:
Cube: 3.3V 168MHz 75mA
