AndriesTuinhof/stmbl/hardware/IRAM256A/stmbl_4.0.kicad_pcb

## KiCad design hardware/IRAM256A/stmbl_4.0.kicad_pcb (continued)

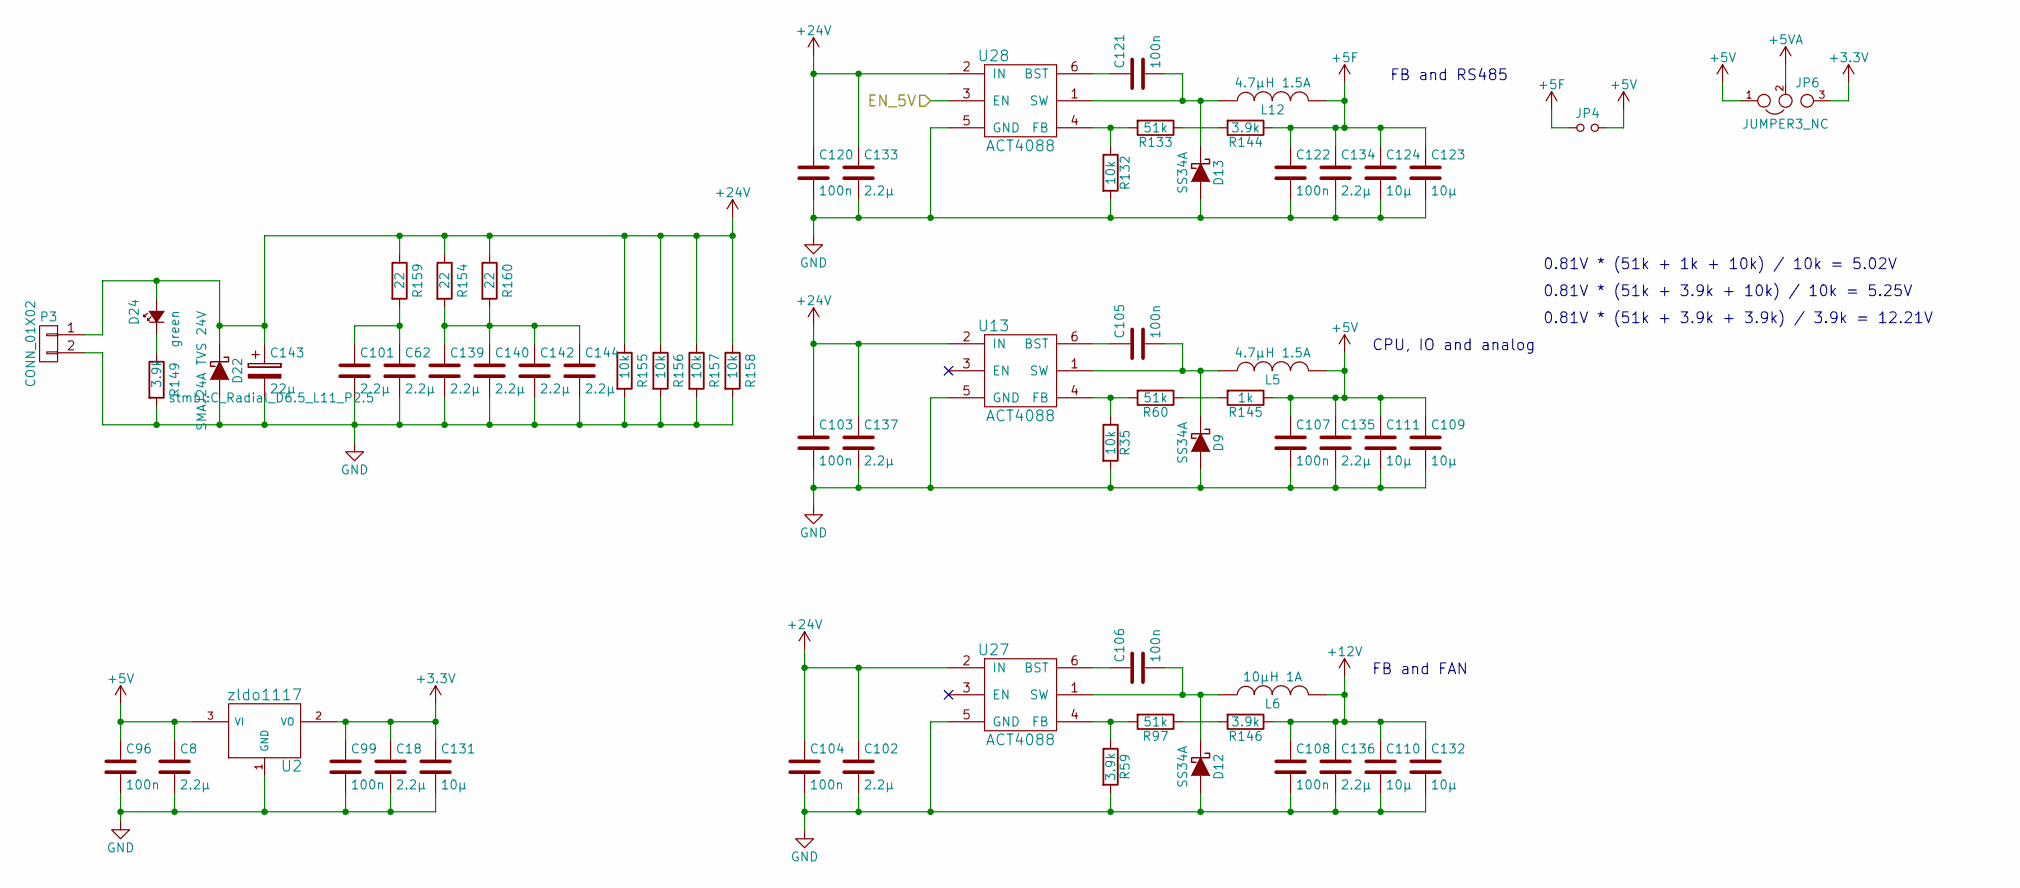
[picture p37: schematic supply.kicad_sch]

Parts:
C8, C18, C62, C101, C102, C133, C134, C135, C136, C137, C139, C140, C142, C144: 2.2µ; C_0603; Voltage 35V; Tolerance X5R
C96, C99, C103, C104, C105, C106, C107, C108, C120, C121, C122: 100n; C_0603; Voltage 50V; Tolerance X5R
C109, C110, C111, C123, C124, C131, C132: 10µ; C_0805; Voltage 25V; Tolerance X5R
C143: 22µ; C_Radial_D6.5_L11_P2.5; Voltage 50V
D9, D12, D13: SS34A; SMA_Standard
D22: SMAJ24A TVS 24V; SMA_Standard
D24: green; LED-0805-SIDE
JP4: Jumper_NO_Small; SOLDER_JUMPER
JP6: JUMPER3_NC; SOLDER_JUMPER_3_NC
L5, L12: 4.7µH 1.5A; SMD_INDUCTOR_32x25
L6: 10µH 1A; SMD_INDUCTOR_32x25
P3: CONN_01X02; RM3.5_1x2
R35, R132, R155, R156, R157, R158: 10k; R_0603; Tolerance 1%
R59, R144, R146, R149: 3.9k; R_0603; Tolerance 1%
R60, R97, R133: 51k; R_0603; Tolerance 1%
R145: 1k; R_0603; Tolerance 1%
R154, R159, R160: 22; R_0603; Tolerance 1%
U2: zldo1117; SOT-223
U13, U27, U28: ACT4088; SOT-23-6

Connections:
+3V3: C18.1, C99.1, C131.1, JP6.3, U2.2 (VO); also elsewhere on the board
+5F: C122.1, C123.1, C124.1, C134.1, JP4.1, L12.2, R144.1; also elsewhere on the board
+5V: C8.1, C96.1, C107.1, C109.1, C111.1, C135.1, JP4.2, JP6.1, L5.2, R145.1, U2.3 (VI); also elsewhere on the board
+5VA: JP6.2; also elsewhere on the board
+12V: C108.1, C110.1, C132.1, C136.1, L6.2, R146.1; also elsewhere on the board
+24V: C102.1, C103.1, C104.1, C120.1, C133.1, C137.1, C143.1, D22.1 (K), D24.2 (A), P3.1, R154.1, R155.1, R156.1, R157.1, R158.1, R159.1, R160.1, U13.2 (IN), U27.2 (IN), U28.2 (IN); also elsewhere on the board
/ctrl/f4/EN_5V: U28.3 (EN); also elsewhere on the board
GND: C8.2, C18.2, C62.2, C96.2, C99.2, C101.2, C102.2, C103.2, C104.2, C107.2, C108.2, C109.2, C110.2, C111.2, C120.2, C122.2, C123.2, C124.2, C131.2, C132.2, C133.2, C134.2, C135.2, C136.2, C137.2, C139.2, C140.2, C142.2, C143.2, C144.2, D9.2 (A), D12.2 (A), D13.2 (A), D22.2 (A), P3.2, R35.2, R59.2, R132.2, R149.2, R155.2, R156.2, R157.2, R158.2, U2.1 (GND), U13.5 (GND), U27.5 (GND), U28.5 (GND); also elsewhere on the board
unnamed: C62.1, C101.1, R159.2
unnamed: C105.1, U13.6 (BST)
unnamed: C105.2, D9.1 (K), L5.1, U13.1 (SW)
unnamed: C106.1, U27.6 (BST)
unnamed: C106.2, D12.1 (K), L6.1, U27.1 (SW)
unnamed: C121.1, U28.6 (BST)
unnamed: C121.2, D13.1 (K), L12.1, U28.1 (SW)
unnamed: C139.1, C140.1, C142.1, C144.1, R154.2, R160.2
unnamed: D24.1 (K), R149.1
unnamed: R35.1, R60.2, U13.4 (FB)
unnamed: R59.1, R97.2, U27.4 (FB)
unnamed: R132.1, R133.2, U28.4 (FB)
unnamed: R133.1, R144.2
unnamed: R60.1, R145.2
unnamed: R97.1, R146.2

Notes on the sheet:
0.81V * (51k + 3.9k + 3.9k) / 3.9k = 12.21V
0.81V * (51k + 3.9k + 10k) / 10k = 5.25V
0.81V * (51k + 1k + 10k) / 10k = 5.02V
FB and FAN
CPU, IO and analog
FB and RS485

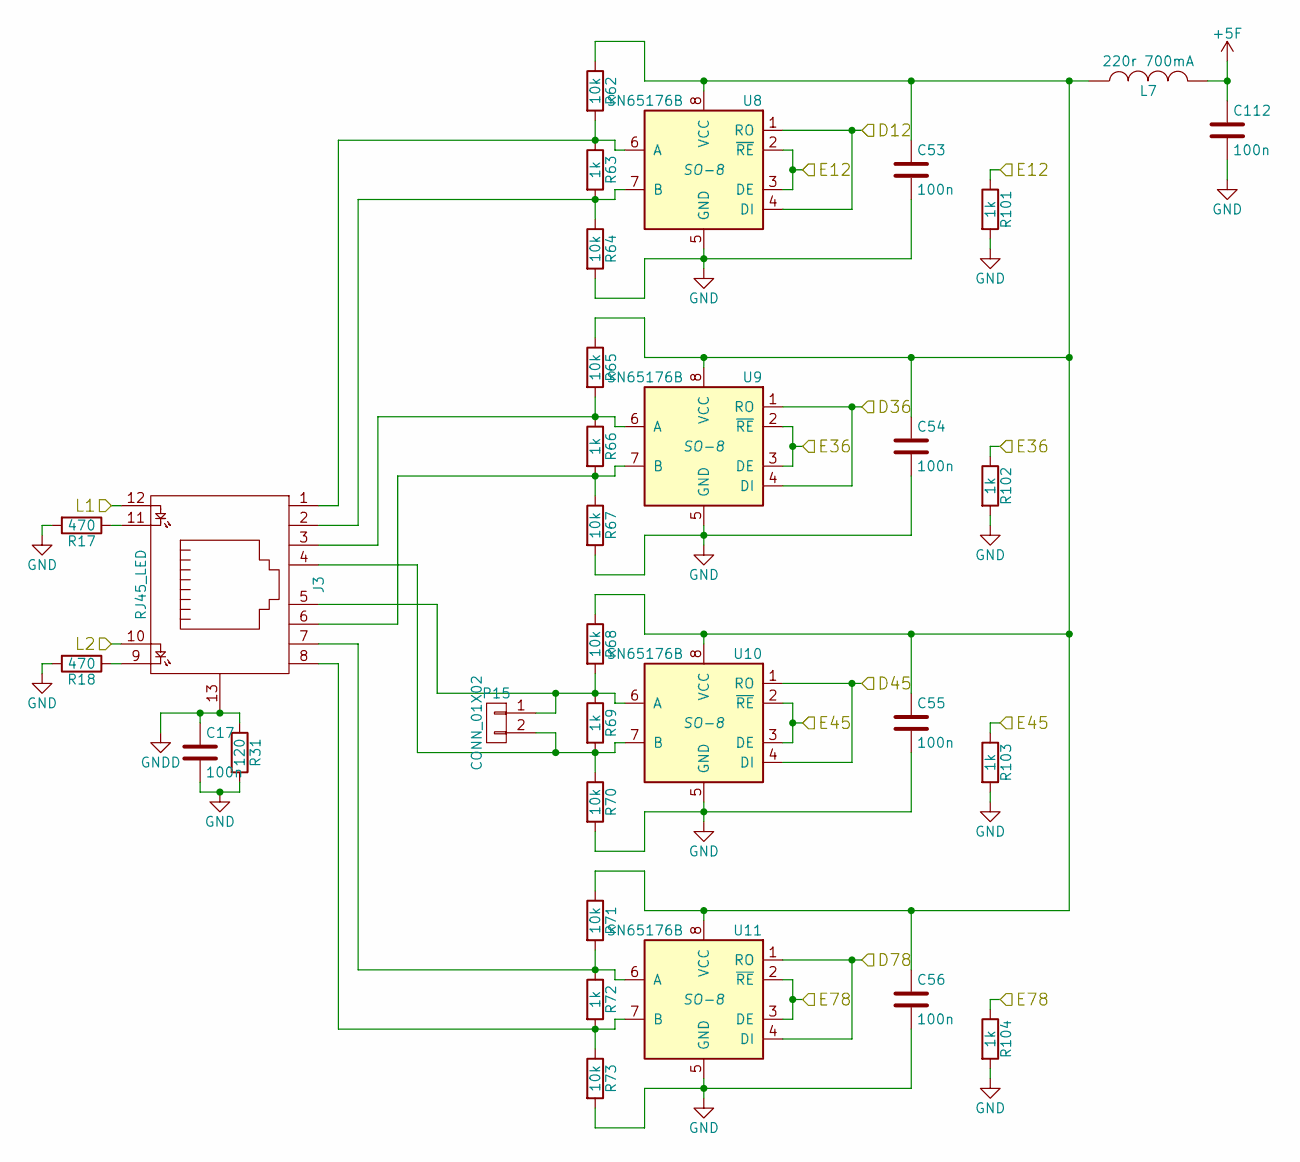
[picture p38: schematic cmd.kicad_sch]

Parts:
C17, C53, C54, C55, C56, C112: 100n; C_0603; Tolerance X5R; Voltage 50V
J3: RJ45_LED
L7: 220r 700mA; R_0603
P15: CONN_01X02; RM3.5_1x2
R17, R18: 470; R_0603; Tolerance 1%
R31: 120; R_0603; Tolerance 1%
R62, R64, R65, R67, R68, R70, R71, R73: 10k; R_0603; Tolerance 1%
R63, R66, R69, R72, R101, R102, R103, R104: 1k; R_0603; Tolerance 1%
U8, U9, U10, U11: SN65176B; SO-8

Connections:
+5F: C112.1, L7.2; also elsewhere on the board
/ctrl/CMD/D12: U8.1 (RO), U8.4 (DI); also elsewhere on the board
/ctrl/CMD/D36: U9.1 (RO), U9.4 (DI); also elsewhere on the board
/ctrl/CMD/D45: U10.1 (RO), U10.4 (DI); also elsewhere on the board
/ctrl/CMD/D78: U11.1 (RO), U11.4 (DI); also elsewhere on the board
/ctrl/CMD/E12: R101.1, U8.2 (~RE), U8.3 (DE); also elsewhere on the board
/ctrl/CMD/E36: R102.1, U9.2 (~RE), U9.3 (DE); also elsewhere on the board
/ctrl/CMD/E45: R103.1, U10.2 (~RE), U10.3 (DE); also elsewhere on the board
/ctrl/CMD/E78: R104.1, U11.2 (~RE), U11.3 (DE); also elsewhere on the board
/ctrl/CMD/L1: J3.12; also elsewhere on the board
/ctrl/CMD/L2: J3.10; also elsewhere on the board
GND: C17.2, C53.2, C54.2, C55.2, C56.2, C112.2, R17.2, R18.2, R31.2, R64.2, R67.2, R70.2, R73.2, R101.2, R102.2, R103.2, R104.2, U8.5 (GND), U9.5 (GND), U10.5 (GND), U11.5 (GND); also elsewhere on the board
GNDD: C17.1, J3.13, R31.1; also elsewhere on the board
unnamed: C53.1, C54.1, C55.1, C56.1, L7.1, R62.1, R65.1, R68.1, R71.1, U8.8 (VCC), U9.8 (VCC), U10.8 (VCC), U11.8 (VCC)
unnamed: J3.1, R62.2, R63.1, U8.6 (A)
unnamed: J3.2, R63.2, R64.1, U8.7 (B)
unnamed: J3.3, R65.2, R66.1, U9.6 (A)
unnamed: J3.4, P15.2, R69.2, R70.1, U10.7 (B)
unnamed: J3.5, P15.1, R68.2, R69.1, U10.6 (A)
unnamed: J3.6, R66.2, R67.1, U9.7 (B)
unnamed: J3.7, R71.2, R72.1, U11.6 (A)
unnamed: J3.8, R72.2, R73.1, U11.7 (B)
unnamed: J3.9, R18.1
unnamed: J3.11, R17.1

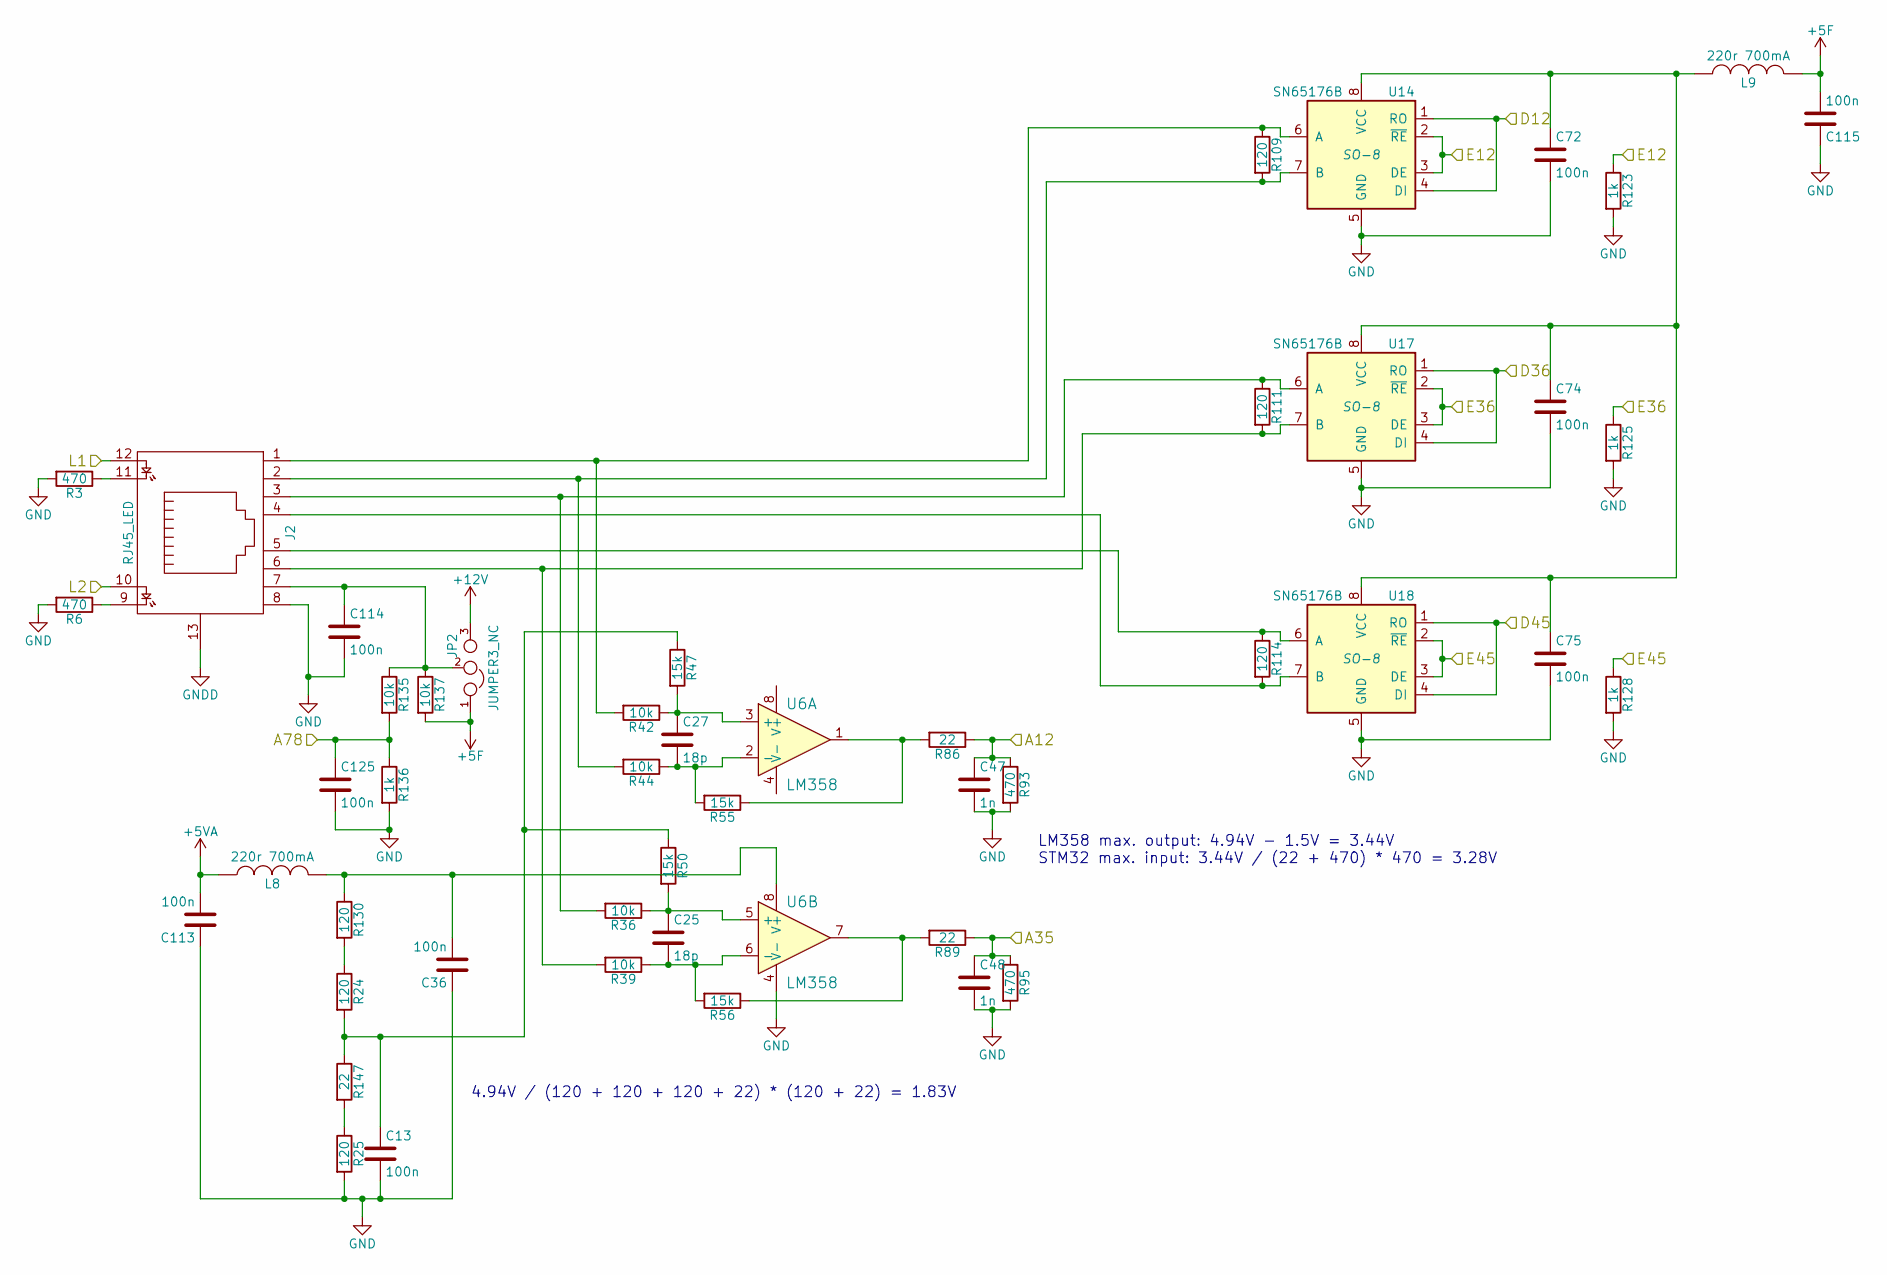
[picture p39: schematic fb.kicad_sch]

Parts:
C13, C36, C72, C74, C75, C113, C114, C115, C125: 100n; C_0603; Voltage 50V; Tolerance X5R
C25, C27: 18p; C_0603; Voltage 50V; Tolerance X5R
C47, C48: 1n; C_0603; Voltage 50V; Tolerance X5R
J2: RJ45_LED
JP2: JUMPER3_NC; SOLDER_JUMPER_3_NC
L8, L9: 220r 700mA; R_0603
R3, R6, R93, R95: 470; R_0603; Tolerance 1%
R24, R25, R109, R111, R114, R130: 120; R_0603; Tolerance 1%
R36, R39, R42, R44, R135, R137: 10k; R_0603; Tolerance 1%
R47, R50, R55, R56: 15k; R_0603; Tolerance 1%
R86, R89, R147: 22; R_0603; Tolerance 1%
R123, R125, R128, R136: 1k; R_0603; Tolerance 1%
U6: LM358; SOIC-8-N
U14, U17, U18: SN65176B; SO-8

Connections:
+5F: C115.2, JP2.1, L9.1, R137.2; also elsewhere on the board
+5VA: C113.2, L8.1; also elsewhere on the board
+12V: JP2.3; also elsewhere on the board
/ctrl/FB0/A12: C47.1, R86.1, R93.1; also elsewhere on the board
/ctrl/FB0/A35: C48.1, R89.1, R95.1; also elsewhere on the board
/ctrl/FB0/A78: C125.1, R135.2, R136.1; also elsewhere on the board
/ctrl/FB0/D12: U14.1 (RO), U14.4 (DI); also elsewhere on the board
/ctrl/FB0/D36: U17.1 (RO), U17.4 (DI); also elsewhere on the board
/ctrl/FB0/D45: U18.1 (RO), U18.4 (DI); also elsewhere on the board
/ctrl/FB0/E12: R123.1, U14.2 (~RE), U14.3 (DE); also elsewhere on the board
/ctrl/FB0/E36: R125.1, U17.2 (~RE), U17.3 (DE); also elsewhere on the board
/ctrl/FB0/E45: R128.1, U18.2 (~RE), U18.3 (DE); also elsewhere on the board
/ctrl/FB0/L1: J2.12; also elsewhere on the board
/ctrl/FB0/L2: J2.10; also elsewhere on the board
GND: C13.2, C36.1, C47.2, C48.2, C72.2, C74.2, C75.2, C113.1, C114.2, C115.1, C125.2, J2.8, R3.2, R6.2, R25.2, R93.2, R95.2, R123.2, R125.2, R128.2, R136.2, U6.4 (V-), U14.5 (GND), U17.5 (GND), U18.5 (GND); also elsewhere on the board
GNDD: J2.13; also elsewhere on the board
unnamed: C13.1, R24.2, R47.1, R50.1, R147.1
unnamed: C25.1, R36.1, R50.2, U6.5 (+)
unnamed: C25.2, R39.1, R56.2, U6.6 (-)
unnamed: C27.1, R42.1, R47.2, U6.3 (+)
unnamed: C27.2, R44.1, R55.2, U6.2 (-)
unnamed: C36.2, L8.2, R130.1, U6.8 (V+)
unnamed: C72.1, C74.1, C75.1, L9.2, U14.8 (VCC), U17.8 (VCC), U18.8 (VCC)
unnamed: C114.1, J2.7, JP2.2, R135.1, R137.1
unnamed: J2.1, R42.2, R109.1, U14.6 (A)
unnamed: J2.2, R44.2, R109.2, U14.7 (B)
unnamed: J2.3, R36.2, R111.1, U17.6 (A)
unnamed: J2.4, R114.2, U18.7 (B)
unnamed: J2.5, R114.1, U18.6 (A)
unnamed: J2.6, R39.2, R111.2, U17.7 (B)
unnamed: J2.9, R6.1
unnamed: J2.11, R3.1
unnamed: R55.1, R86.2, U6.1
unnamed: R56.1, R89.2, U6.7
unnamed: R24.1, R130.2
unnamed: R25.1, R147.2

Notes on the sheet:
4.94V / (120 + 120 + 120 + 22) * (120 + 22) = 1.83V
LM358 max. output: 4.94V - 1.5V = 3.44V STM32 max. input: 3.44V / (22 + 470) * 470 = 3.28V

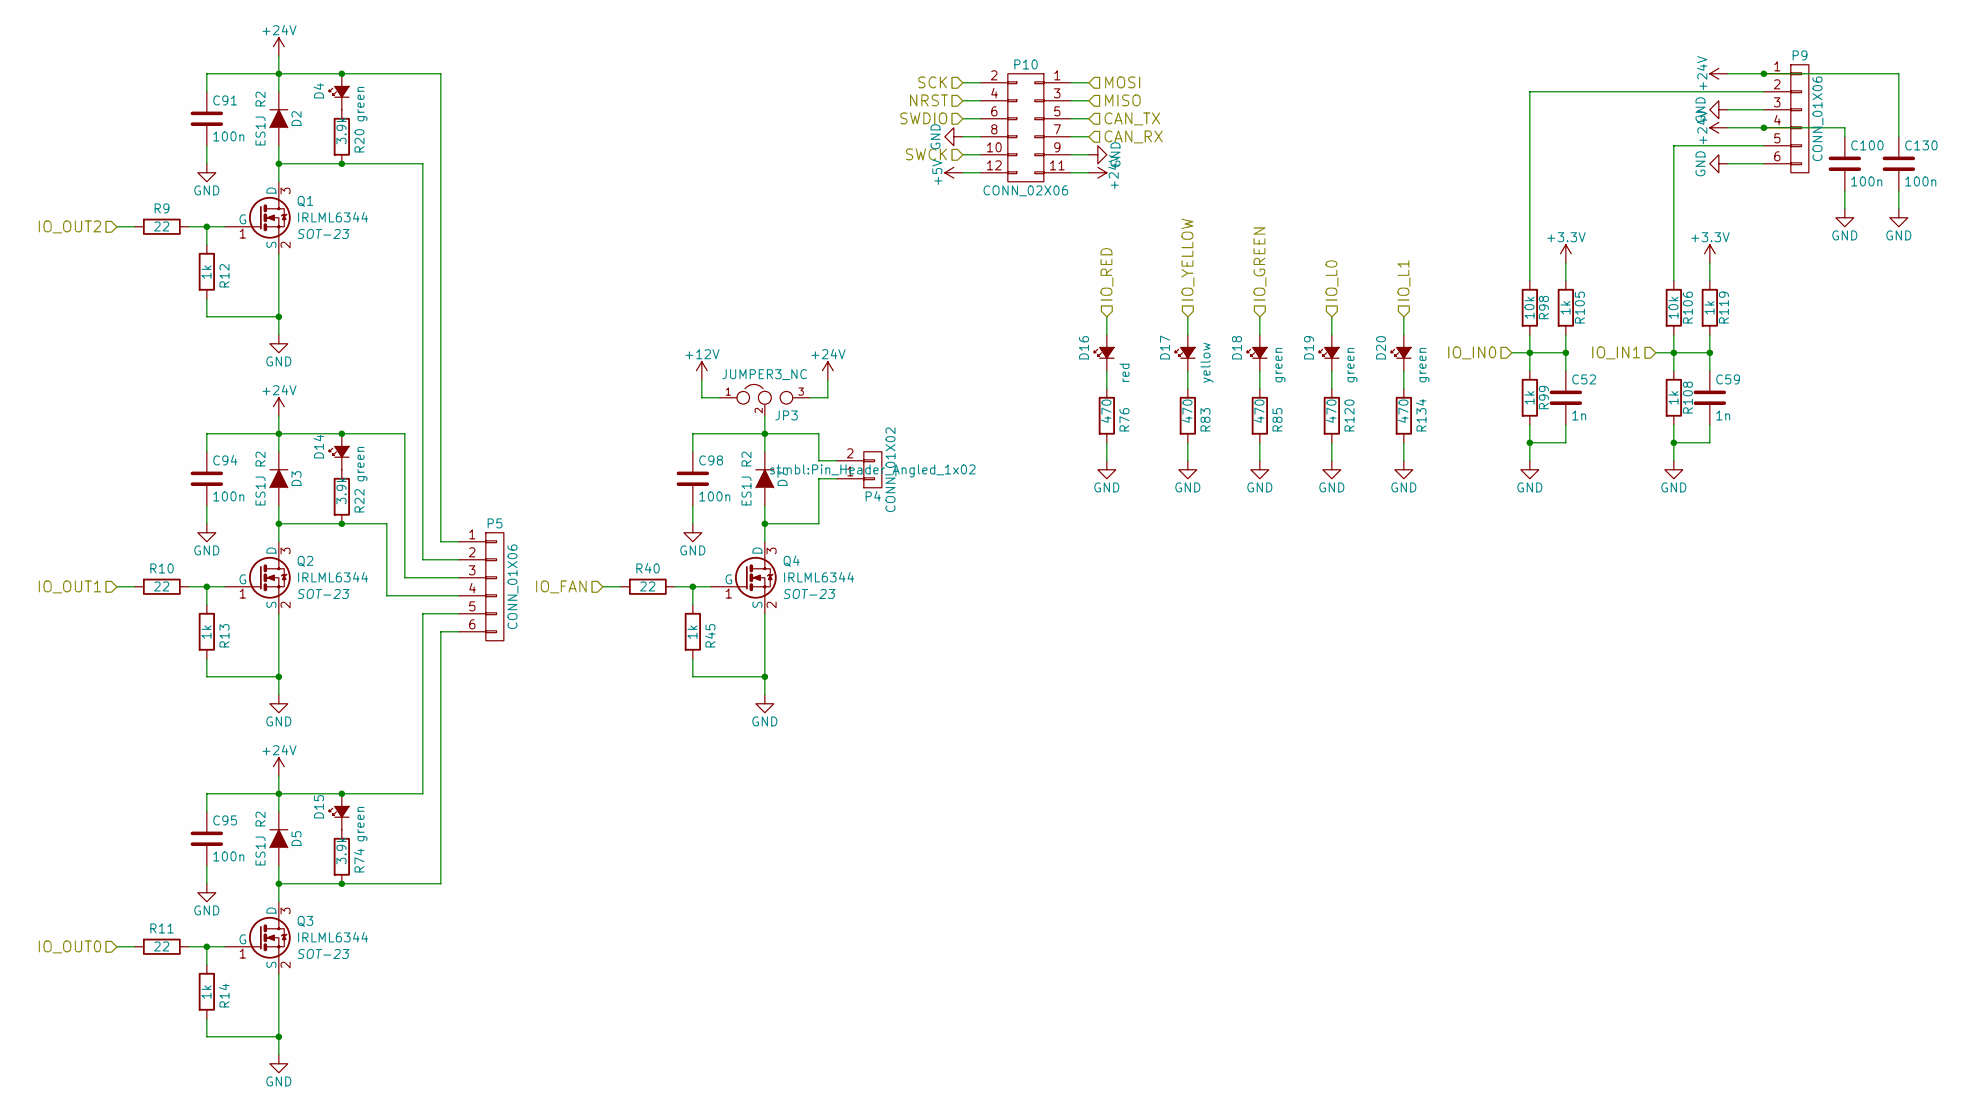
[picture p40: schematic io.kicad_sch]

Parts:
C52, C59: 1n; C_0603; Voltage 50V; Tolerance X5R
C91, C94, C95, C98, C100, C130: 100n; C_0603; Voltage 50V; Tolerance X5R
D2, D3, D5, D7: ES1J R2; SMA_Standard
D4, D14, D15, D18, D19, D20: green; LED-0805-SIDE
D16: red; LED-0805-SIDE
D17: yellow; LED-0805-SIDE
JP3: JUMPER3_NC; SOLDER_JUMPER_3_NC
P4: CONN_01X02; Pin_Header_Angled_1x02
P5, P9: CONN_01X06; RM3.5_1x6
P10: CONN_02X06; Socket_Strip_Angled_2x06
Q1, Q2, Q3, Q4: IRLML6344; SOT-23
R9, R10, R11, R40: 22; R_0603; Tolerance 1%
R12, R13, R14, R45, R99, R105, R108, R119: 1k; R_0603; Tolerance 1%
R20, R22, R74: 3.9k; R_0603; Tolerance 1%
R76, R83, R85, R120, R134: 470; R_0603; Tolerance 1%
R98, R106: 10k; R_0603; Tolerance 1%

Connections:
+3V3: R105.1, R119.1; also elsewhere on the board
+5V: P10.12; also elsewhere on the board
+12V: JP3.1; also elsewhere on the board
+24V: C91.1, C94.1, C95.1, C100.1, C130.1, D2.1 (K), D3.1 (K), D4.2 (A), D5.1 (K), D14.2 (A), D15.2 (A), JP3.3, P5.1, P5.3, P5.5, P9.1, P9.4, P10.11; also elsewhere on the board
/ctrl/CMD/D12: P10.3; also elsewhere on the board
/ctrl/CMD/D36: P10.2; also elsewhere on the board
/ctrl/CMD/D45: P10.1; also elsewhere on the board
/ctrl/IO/CAN_RX: P10.7; also elsewhere on the board
/ctrl/IO/CAN_TX: P10.5; also elsewhere on the board
/ctrl/IO/IO_FAN: R40.2; also elsewhere on the board
/ctrl/IO/IO_GREEN: D18.2 (A); also elsewhere on the board
/ctrl/IO/IO_IN0: C52.1, R98.2, R99.1, R105.2; also elsewhere on the board
/ctrl/IO/IO_IN1: C59.1, R106.2, R108.1, R119.2; also elsewhere on the board
/ctrl/IO/IO_L0: D19.2 (A); also elsewhere on the board
/ctrl/IO/IO_L1: D20.2 (A); also elsewhere on the board
/ctrl/IO/IO_OUT0: R11.2; also elsewhere on the board
/ctrl/IO/IO_OUT1: R10.2; also elsewhere on the board
/ctrl/IO/IO_OUT2: R9.2; also elsewhere on the board
/ctrl/IO/IO_RED: D16.2 (A); also elsewhere on the board
/ctrl/IO/IO_YELLOW: D17.2 (A); also elsewhere on the board
/ctrl/IO/NRST: P10.4; also elsewhere on the board
/ctrl/IO/SWCK: P10.10; also elsewhere on the board
/ctrl/IO/SWDIO: P10.6; also elsewhere on the board
GND: C52.2, C59.2, C91.2, C94.2, C95.2, C98.2, C100.2, C130.2, P9.3, P9.6, P10.8, P10.9, Q1.2 (S), Q2.2 (S), Q3.2 (S), Q4.2 (S), R12.2, R13.2, R14.2, R45.2, R76.2, R83.2, R85.2, R99.2, R108.2, R120.2, R134.2; also elsewhere on the board
unnamed: C98.1, D7.1 (K), JP3.2, P4.2
unnamed: D2.2 (A), P5.2, Q1.3 (D), R20.2
unnamed: D3.2 (A), P5.4, Q2.3 (D), R22.2
unnamed: D4.1 (K), R20.1
unnamed: D5.2 (A), P5.6, Q3.3 (D), R74.2
unnamed: D7.2 (A), P4.1, Q4.3 (D)
unnamed: D14.1 (K), R22.1
unnamed: D15.1 (K), R74.1
unnamed: D16.1 (K), R76.1
unnamed: D17.1 (K), R83.1
unnamed: D18.1 (K), R85.1
unnamed: D19.1 (K), R120.1
unnamed: D20.1 (K), R134.1
unnamed: P9.2, R98.1
unnamed: P9.5, R106.1
unnamed: Q1.1 (G), R9.1, R12.1
unnamed: Q2.1 (G), R10.1, R13.1
unnamed: Q3.1 (G), R11.1, R14.1
unnamed: Q4.1 (G), R40.1, R45.1

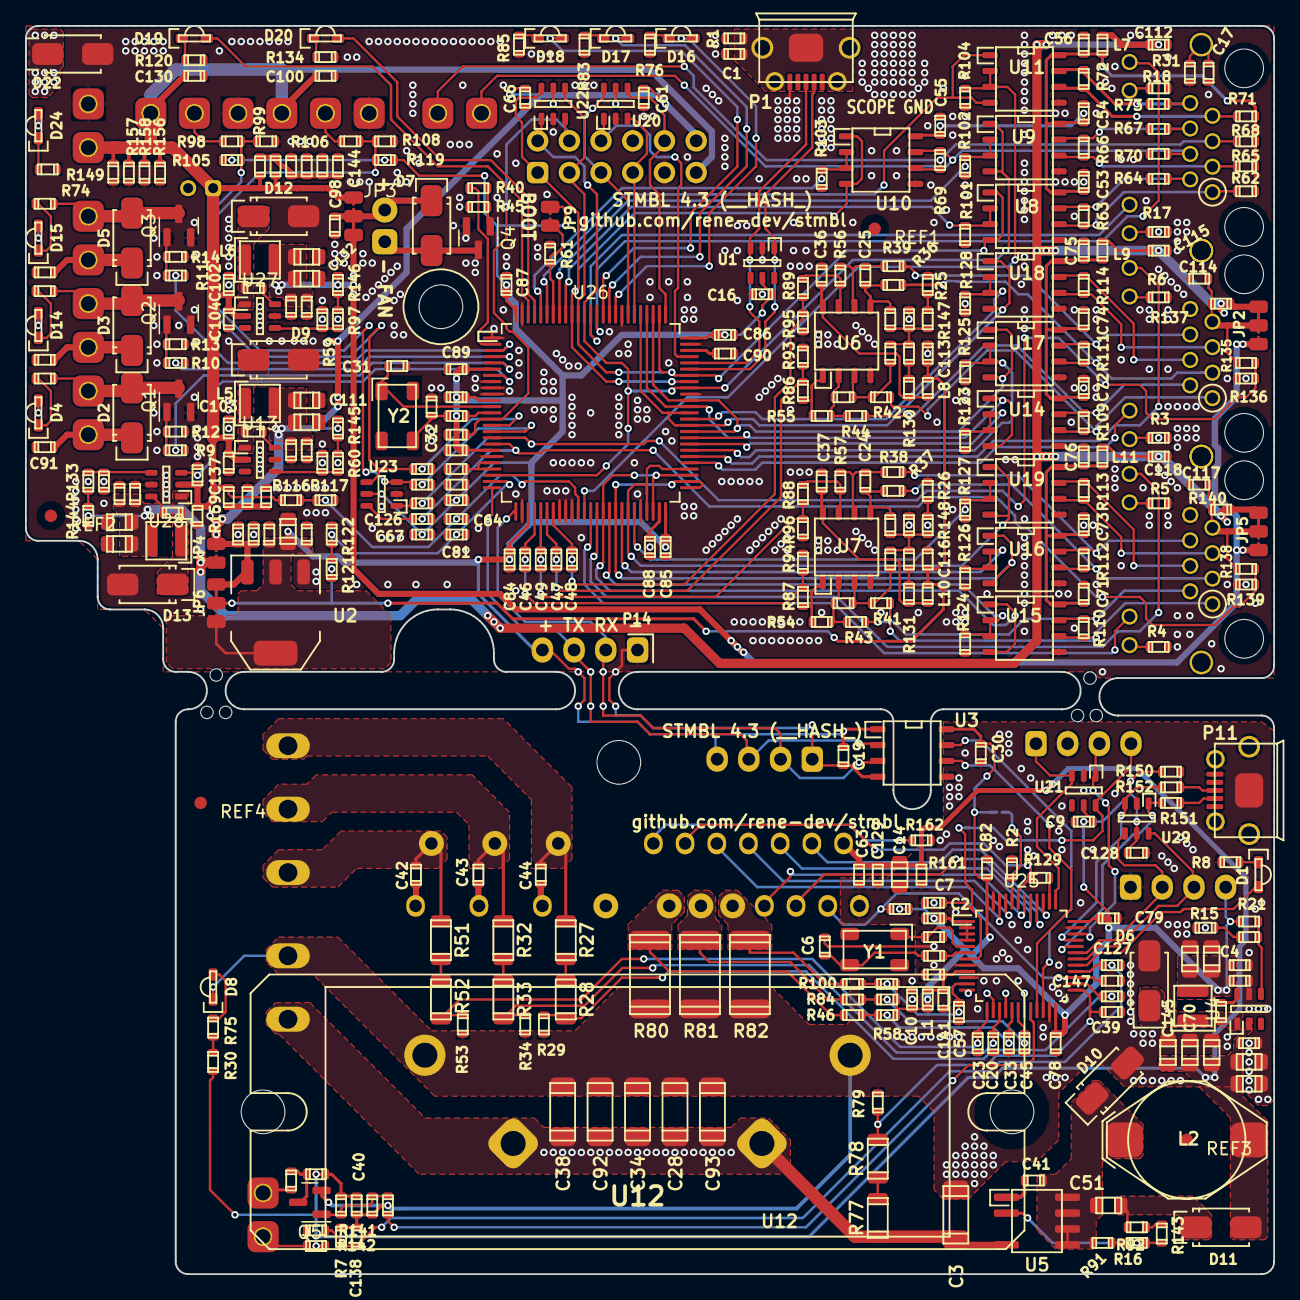
[picture p41: board stmbl_4.0.kicad_pcb from above]

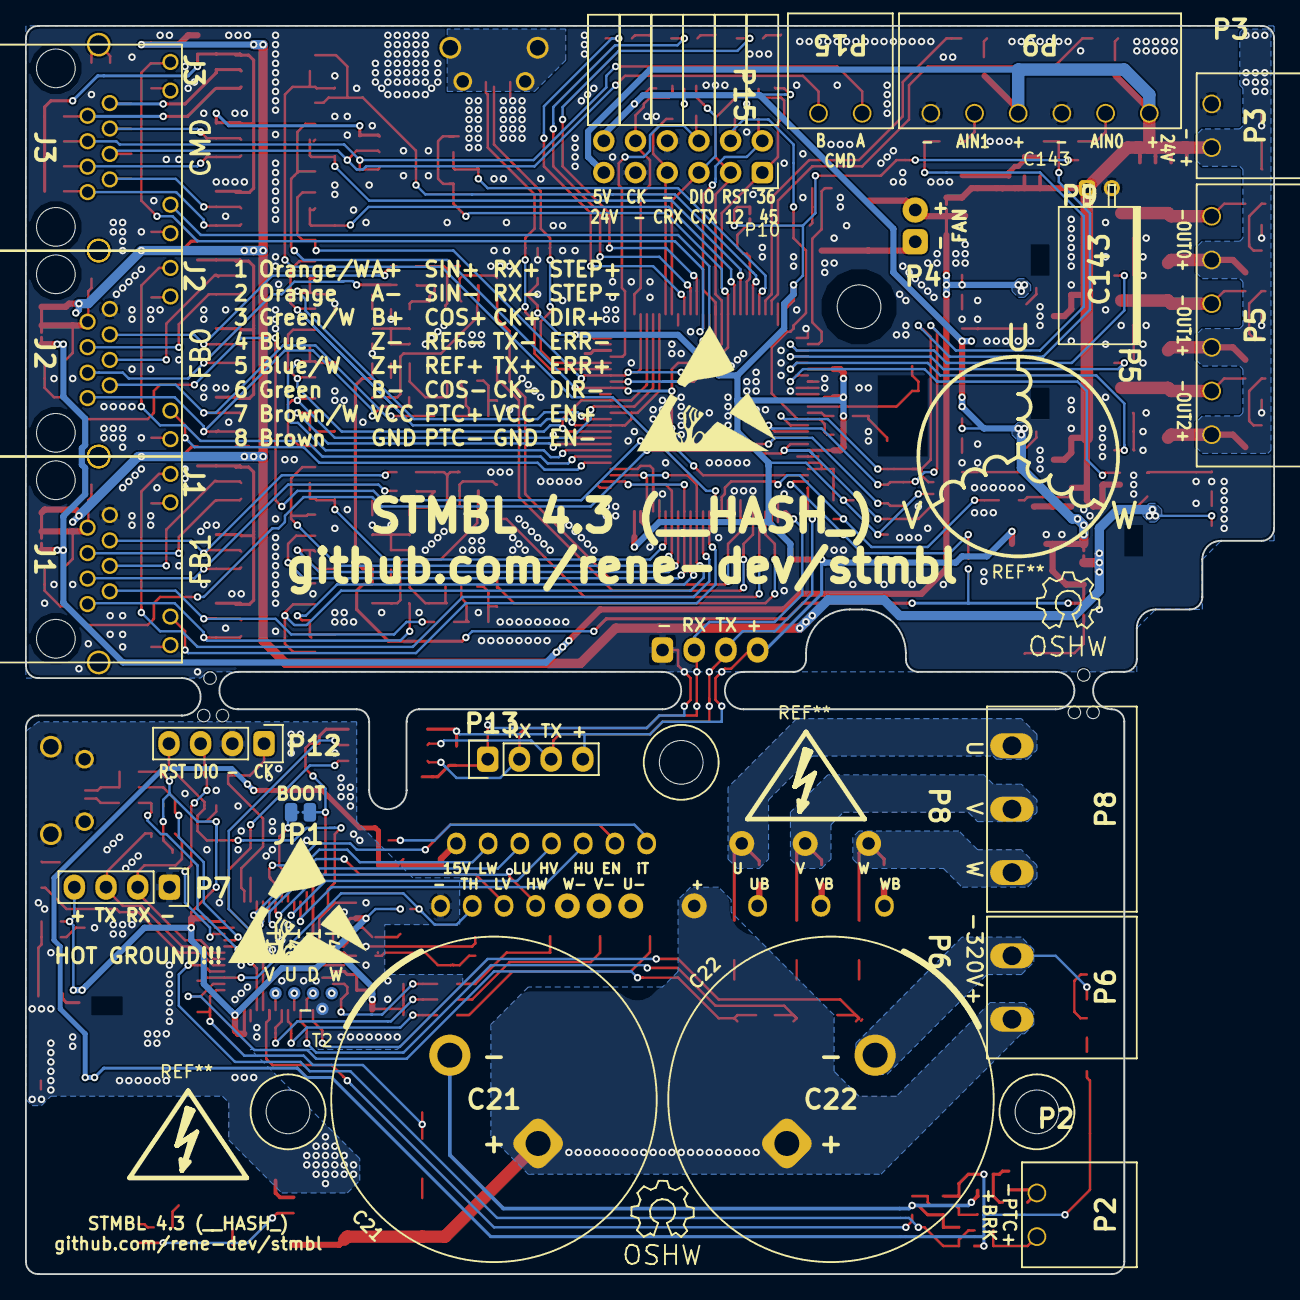
[picture p42: board stmbl_4.0.kicad_pcb from below]

Board: 2 copper layers, 100.0 x 100.0 mm, 428 parts (29 on the bottom side), 230 nets.

Other parts of the board:
C12, C37, C71, C73, C76, C116, C117, C118, C126: 100n; C_0603
C24, C26: 18p; C_0603
C46, C49: 1n; C_0603
J1: RJ45_LED
JP5: JUMPER3_NC; SOLDER_JUMPER_3_NC
L10, L11: 220r 700mA; R_0603
LOGO1#2: OPEN_HARDWARE_1; Symbol_OSHW-Logo_SilkScreen
R4, R5, R94, R96: 470; R_0603
R23, R26, R110, R112, R113, R131: 120; R_0603
R37, R38, R41, R43, R138, R140: 10k; R_0603
R48, R49, R54, R57: 15k; R_0603
R87, R88, R148: 22; R_0603
R124, R126, R127, R139: 1k; R_0603
REF1, REF2, REF3, REF4: Fiducial_1mm_Dia_2.54mm_Outer_CopperTop; Fiducial_1mm_Outer_CopperTop
U7: LM358; SOIC-8-N
U15, U16, U19: SN65176B; SOIC-8-N
U35, U36, U37, U39: non_plated; non_plated_1mm

Their connections:
+5F: C118.2, JP5.1, L11.1, R140.2; also elsewhere on the board
+5VA: C116.2, L10.1; also elsewhere on the board
+12V: JP5.3; also elsewhere on the board
/ctrl/FB1/A12: C46.1, R87.1, R94.1; also elsewhere on the board
/ctrl/FB1/A35: C49.1, R88.1, R96.1; also elsewhere on the board
/ctrl/FB1/A78: C126.1, R138.2, R139.1; also elsewhere on the board
/ctrl/FB1/D12: U15.1 (RO), U15.4 (DI); also elsewhere on the board
/ctrl/FB1/D36: U16.1 (RO), U16.4 (DI); also elsewhere on the board
/ctrl/FB1/D45: U19.1 (RO), U19.4 (DI); also elsewhere on the board
/ctrl/FB1/E12: R124.1, U15.2 (~RE), U15.3 (DE); also elsewhere on the board
/ctrl/FB1/E36: R126.1, U16.2 (~RE), U16.3 (DE); also elsewhere on the board
/ctrl/FB1/E45: R127.1, U19.2 (~RE), U19.3 (DE); also elsewhere on the board
/ctrl/FB1/L1: J1.12; also elsewhere on the board
/ctrl/FB1/L2: J1.10; also elsewhere on the board
GND: C12.2, C37.1, C46.2, C49.2, C71.2, C73.2, C76.2, C116.1, C117.2, C118.1, C126.2, J1.8, R4.2, R5.2, R26.2, R94.2, R96.2, R124.2, R126.2, R127.2, R139.2, U7.4 (V-), U15.5 (GND), U16.5 (GND), U19.5 (GND); also elsewhere on the board
GNDD: J1.13; also elsewhere on the board
unnamed: C12.1, R23.2, R48.1, R49.1, R148.1
unnamed: C24.1, R37.1, R49.2, U7.5 (+)
unnamed: C24.2, R38.1, R57.2, U7.6 (-)
unnamed: C26.1, R41.1, R48.2, U7.3 (+)
unnamed: C26.2, R43.1, R54.2, U7.2 (-)
unnamed: C37.2, L10.2, R131.1, U7.8 (V+)
unnamed: C71.1, C73.1, C76.1, L11.2, U15.8 (VCC), U16.8 (VCC), U19.8 (VCC)
unnamed: C117.1, J1.7, JP5.2, R138.1, R140.1
unnamed: J1.1, R41.2, R110.1, U15.6 (A)
unnamed: J1.2, R43.2, R110.2, U15.7 (B)
unnamed: J1.3, R37.2, R112.1, U16.6 (A)
unnamed: J1.4, R113.2, U19.7 (B)
unnamed: J1.5, R113.1, U19.6 (A)
unnamed: J1.6, R38.2, R112.2, U16.7 (B)
unnamed: J1.9, R5.1
unnamed: J1.11, R4.1
unnamed: R54.1, R87.2, U7.1
unnamed: R57.1, R88.2, U7.7
unnamed: R23.1, R131.2
unnamed: R26.1, R148.2
