AndriesTuinhof/stmbl/hardware/old designs/kicad/bob/db25_bob_v2/db25_bob_v2.kicad_pcb

## KiCad design hardware/old designs/kicad/bob/db25_bob_v2/db25_bob_v2.kicad_pcb (2022-10-24, an earlier design)

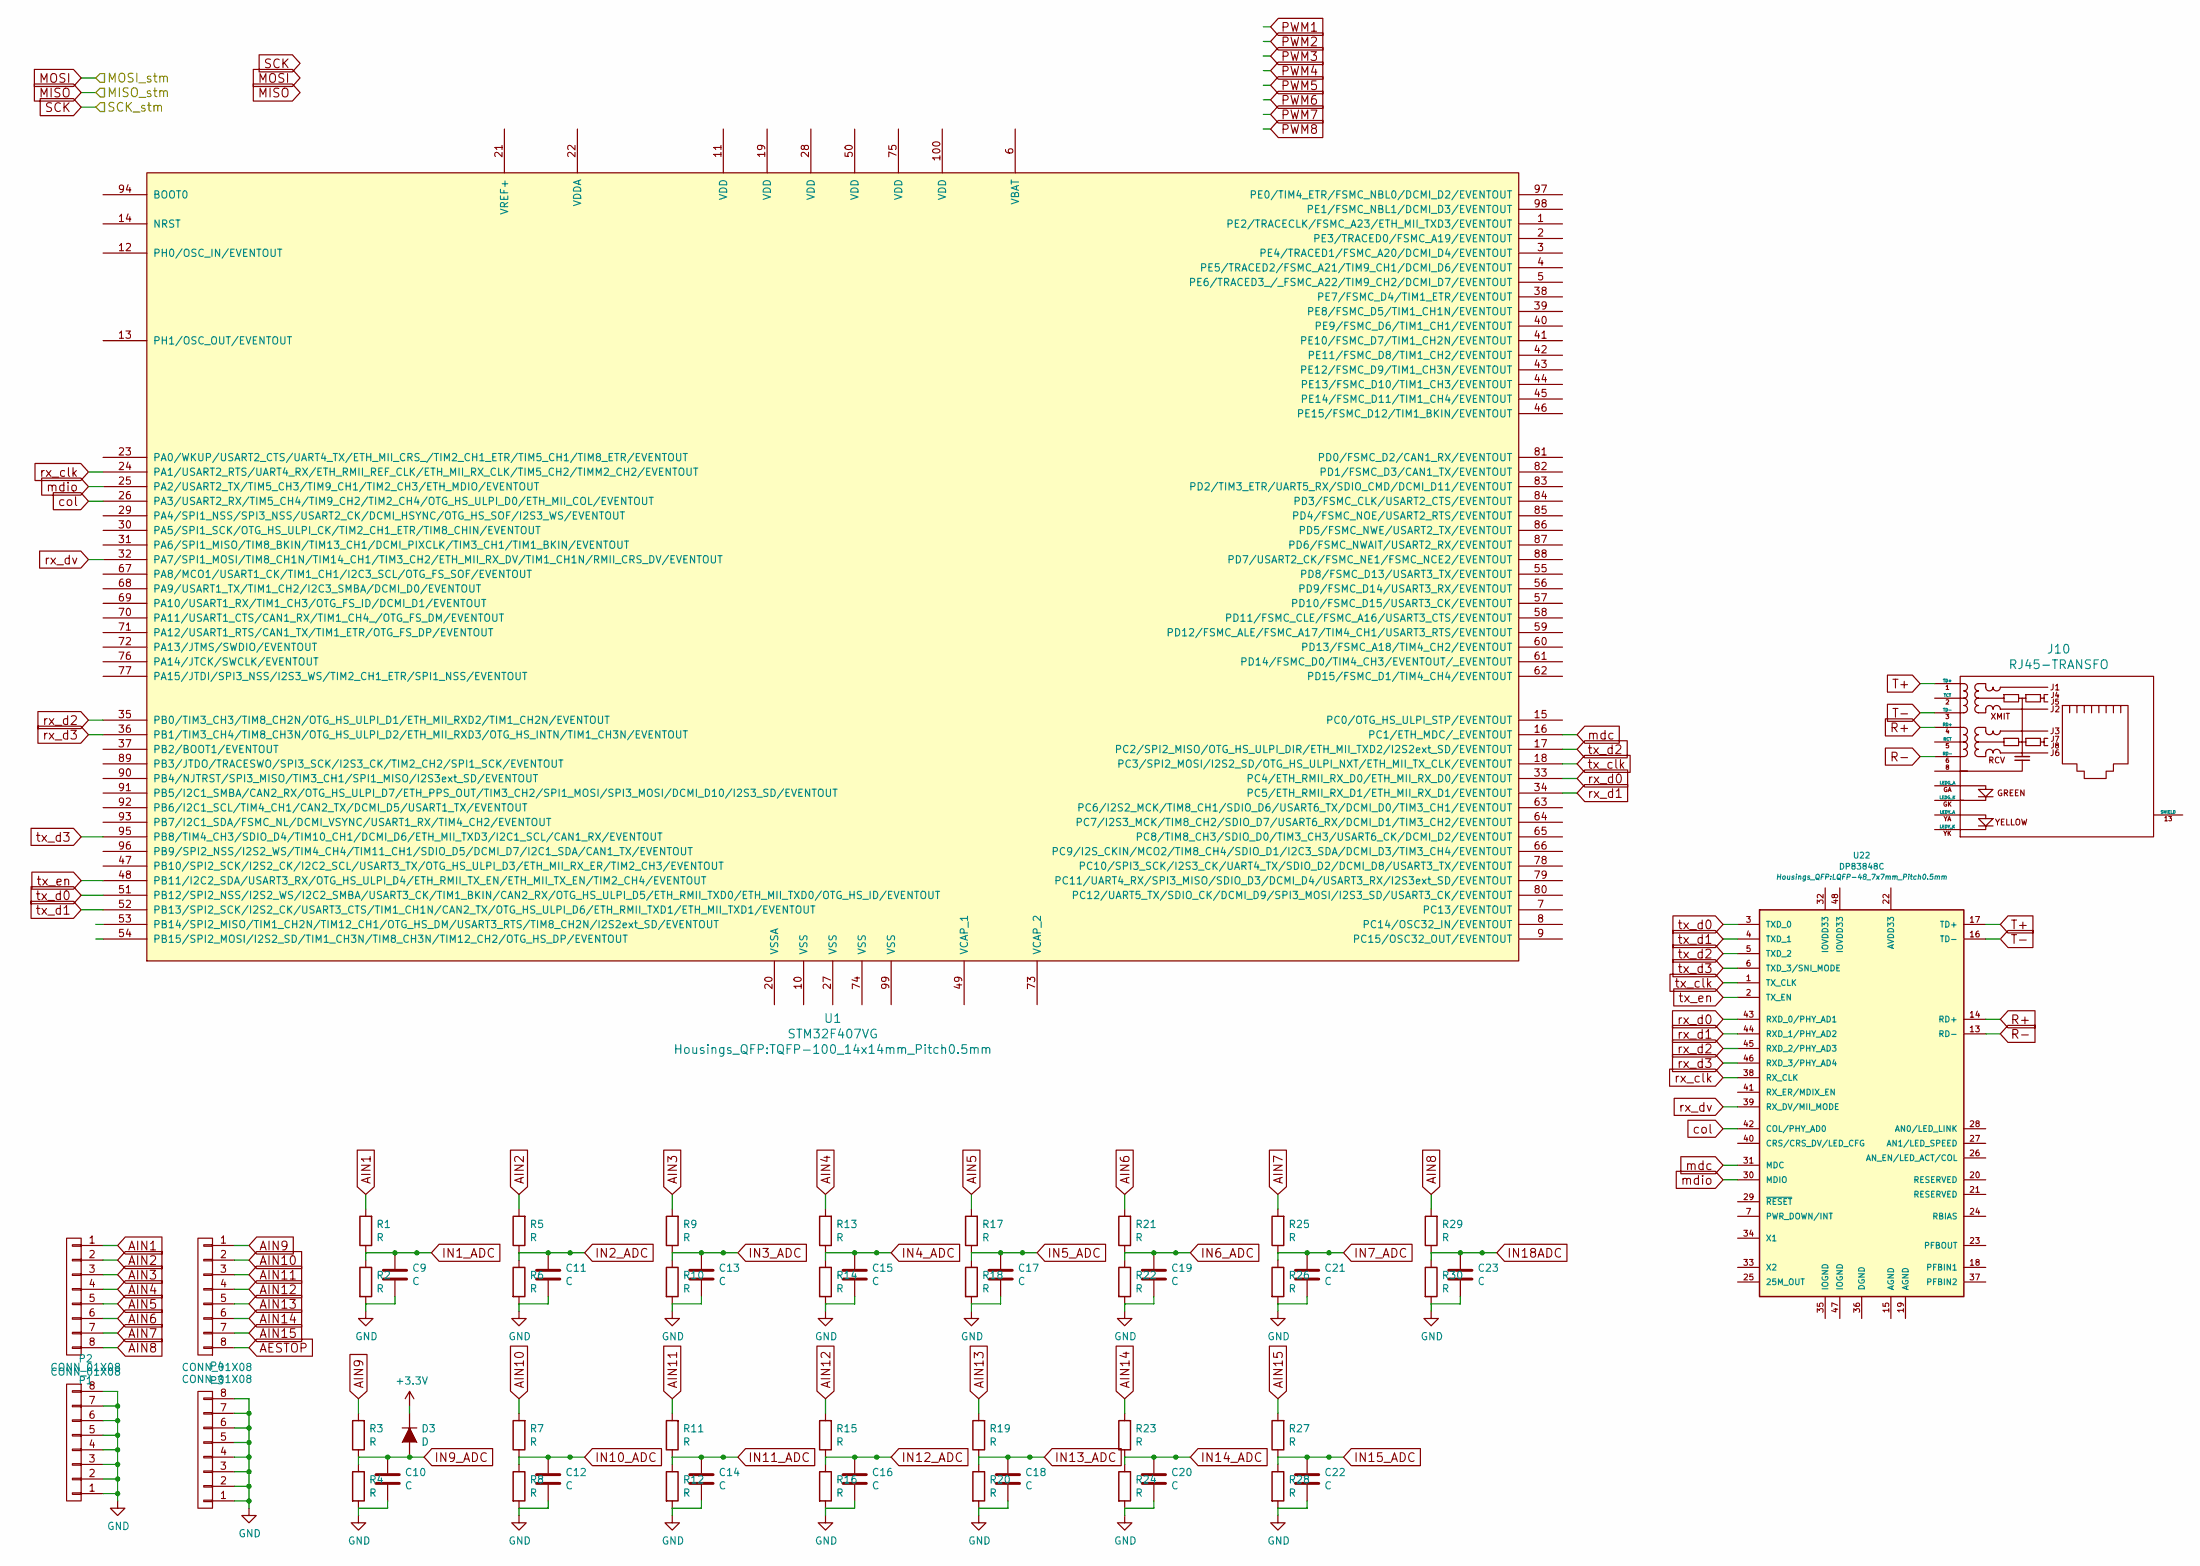
[picture p43: schematic stm32.sch]

Parts:
C9, C10, C11, C12, C13, C14, C15, C16, C17, C18, C19, C20, C21, C22, C23: C; C_0603
D3: D; MiniMELF_Standard
J10: RJ45-TRANSFO; MHRJJ88NFVS
P1, P2, P3, P4: CONN_01X08; TerminalBlock_Pheonix_MPT-2.54mm_8pol
R1, R2, R3, R4, R5, R6, R7, R8, R9, R10, R11, R12, R13, R14, R15, R16, R17, R18, R19, R20, R21, R22, R23, R24, R25, R26, R27, R28, R29, R30: R; R_0805
U1: STM32F407VG; TQFP-100_14x14mm_Pitch0.5mm
U22: DP83848C; LQFP-48_7x7mm_Pitch0.5mm

Connections:
+3V3: D3.1 (K); also elsewhere on the board
AESTOP: P3.8
AIN1: P1.1, R1.2
AIN2: P1.2, R5.2
AIN3: P1.3, R9.2
AIN4: P1.4, R13.2
AIN5: P1.5, R17.2
AIN6: P1.6, R21.2
AIN7: P1.7, R25.2
AIN8: P1.8, R29.2
AIN9: P3.1, R3.2
AIN10: P3.2, R7.2
AIN11: P3.3, R11.2
AIN12: P3.4, R15.2
AIN13: P3.5, R19.2
AIN14: P3.6, R23.2
AIN15: P3.7, R27.2
GND: C9.2, C10.2, C11.2, C12.2, C13.2, C14.2, C15.2, C16.2, C17.2, C18.2, C19.2, C20.2, C21.2, C22.2, C23.2, P2.1, P2.2, P2.3, P2.4, P2.5, P2.6, P2.7, P2.8, P4.1, P4.2, P4.3, P4.4, P4.5, P4.6, P4.7, P4.8, R2.2, R4.2, R6.2, R8.2, R10.2, R12.2, R14.2, R16.2, R18.2, R20.2, R22.2, R24.2, R26.2, R28.2, R30.2; also elsewhere on the board
IN1_ADC: C9.1, R1.1, R2.1
IN2_ADC: C11.1, R5.1, R6.1
IN3_ADC: C13.1, R9.1, R10.1
IN4_ADC: C15.1, R13.1, R14.1
IN5_ADC: C17.1, R17.1, R18.1
IN6_ADC: C19.1, R21.1, R22.1
IN7_ADC: C21.1, R25.1, R26.1
IN9_ADC: C10.1, D3.2 (A), R3.1, R4.1
IN10_ADC: C12.1, R7.1, R8.1
IN11_ADC: C14.1, R11.1, R12.1
IN12_ADC: C16.1, R15.1, R16.1
IN13_ADC: C18.1, R19.1, R20.1
IN14_ADC: C20.1, R23.1, R24.1
IN15_ADC: C22.1, R27.1, R28.1
IN18ADC: C23.1, R29.1, R30.1
R+: J10.4 (RD+), U22.14 (RD+)
R-: J10.6 (RD-), U22.13 (RD-)
T+: J10.1 (TD+), U22.17 (TD+)
T-: J10.3 (TD-), U22.16 (TD-)
col: U1.26 (PA3/USART2_RX/TIM5_CH4/TIM9_CH2/TIM2_CH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), U22.42 (COL/PHY_AD0)
mdc: U1.16 (PC1/ETH_MDC/_EVENTOUT), U22.31 (MDC)
mdio: U1.25 (PA2/USART2_TX/TIM5_CH3/TIM9_CH1/TIM2_CH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), U22.30 (MDIO)
rx_clk: U1.24 (PA1/USART2_RTS/UART4_RX/ETH_RMII_REF_CL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), U22.38 (RX_CLK)
rx_d0: U1.33 (PC4/ETH_RMII_RX_D0/ETH_MII_RX_D0/EVENTO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), U22.43 (RXD_0/PHY_AD1)
rx_d1: U1.34 (PC5/ETH_RMII_RX_D1/ETH_MII_RX_D1/EVENTO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), U22.44 (RXD_1/PHY_AD2)
rx_d2: U1.35 (PB0/TIM3_CH3/TIM8_CH2N/OTG_HS_ULPI_D1/E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), U22.45 (RXD_2/PHY_AD3)
rx_d3: U1.36 (PB1/TIM3_CH4/TIM8_CH3N/OTG_HS_ULPI_D2/E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), U22.46 (RXD_3/PHY_AD4)
rx_dv: U1.32 (PA7/SPI1_MOSI/TIM8_CH1N/TIM14_CH1/TIM3_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), U22.39 (RX_DV/MII_MODE)
tx_clk: U1.18 (PC3/SPI2_MOSI/I2S2_SD/OTG_HS_ULPI_NXT/E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), U22.1 (TX_CLK)
tx_d0: U1.51 (PB12/SPI2_NSS/I2S2_WS/I2C2_SMBA/USART3_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), U22.3 (TXD_0)
tx_d1: U1.52 (PB13/SPI2_SCK/I2S2_CK/USART3_CTS/TIM1_C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), U22.4 (TXD_1)
tx_d2: U1.17 (PC2/SPI2_MISO/OTG_HS_ULPI_DIR/ETH_MII_T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), U22.5 (TXD_2)
tx_d3: U1.95 (PB8/TIM4_CH3/SDIO_D4/TIM10_CH1/DCMI_D6/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), U22.6 (TXD_3/SNI_MODE)
tx_en: U1.48 (PB11/I2C2_SDA/USART3_RX/OTG_HS_ULPI_D4/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), U22.2 (TX_EN)

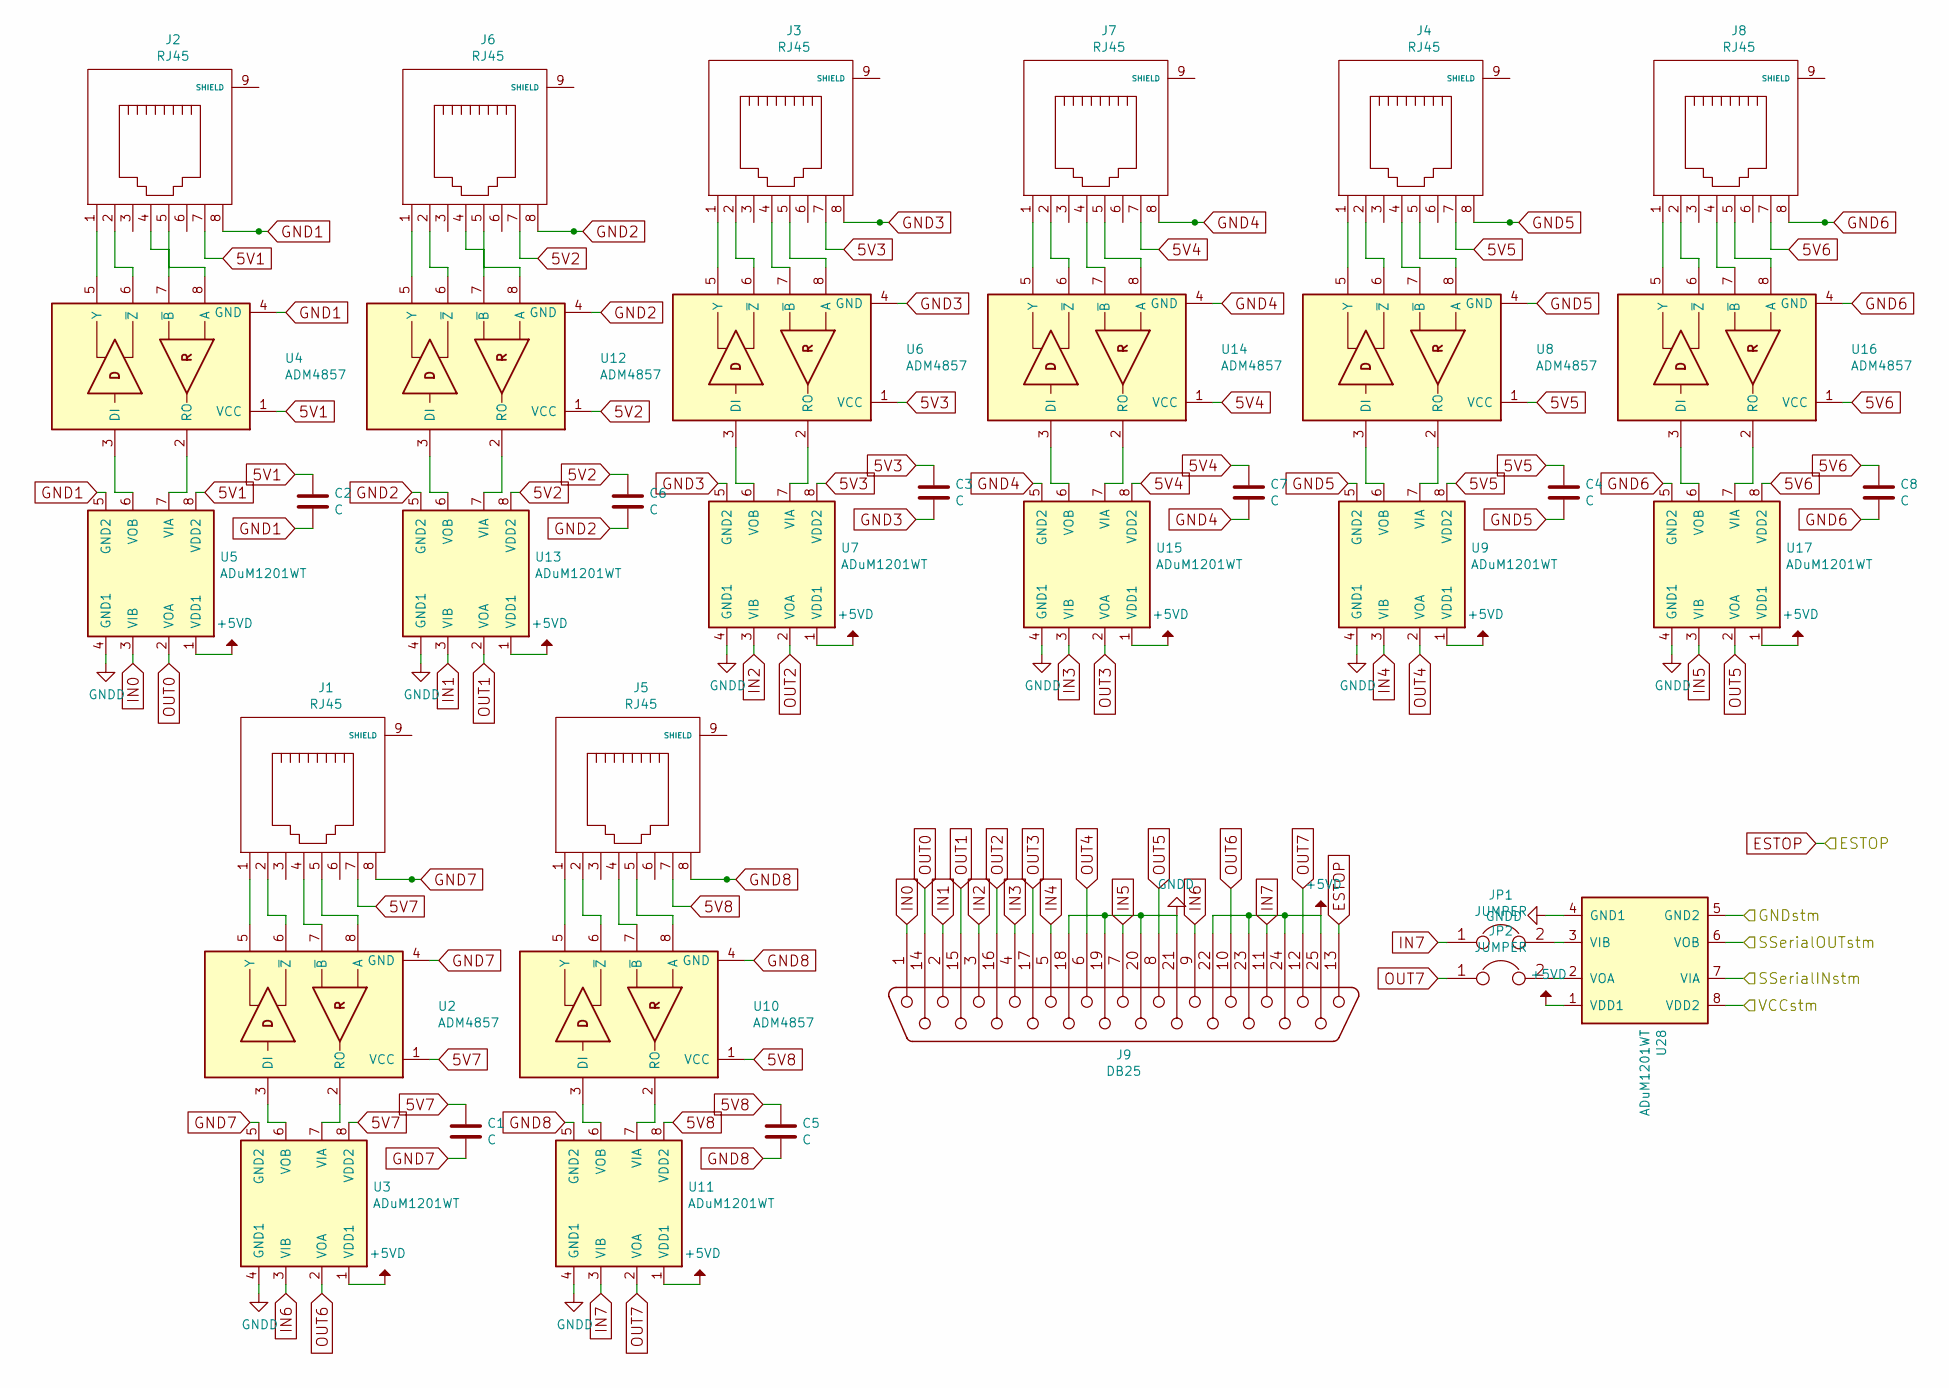
[picture p44: schematic sserial.sch]

Parts:
C1, C2, C3, C4, C5, C6, C7, C8: C; C_1206
J1, J2, J3, J4, J5, J6, J7, J8: RJ45; MHRJJ88NFVS
J9: DB25; DB25FD
JP1, JP2: JUMPER; Pin_Header_Straight_1x02
U2, U4, U6, U8, U10, U12, U14, U16: ADM4857; SOIC-8_3.9x4.9mm_Pitch1.27mm
U3, U5, U7, U9, U11, U13, U15, U17, U28: ADuM1201WT; SOIC-8_3.9x4.9mm_Pitch1.27mm

Connections:
5V1: C2.1, J2.7, U4.1 (VCC), U5.8 (VDD2)
5V2: C6.1, J6.7, U12.1 (VCC), U13.8 (VDD2)
5V3: C3.1, J3.7, U6.1 (VCC), U7.8 (VDD2)
5V4: C7.1, J7.7, U14.1 (VCC), U15.8 (VDD2)
5V5: C4.1, J4.7, U8.1 (VCC), U9.8 (VDD2)
5V6: C8.1, J8.7, U16.1 (VCC), U17.8 (VDD2)
5V7: C1.1, J1.7, U2.1 (VCC), U3.8 (VDD2)
5V8: C5.1, J5.7, U10.1 (VCC), U11.8 (VDD2)
+5VD: J9.22, J9.23, J9.24, J9.25, U3.1 (VDD1), U5.1 (VDD1), U7.1 (VDD1), U9.1 (VDD1), U11.1 (VDD1), U13.1 (VDD1), U15.1 (VDD1), U17.1 (VDD1), U28.1 (VDD1)
/sserial/GNDstm: U28.5 (GND2)
/sserial/SSerialINstm: U28.7 (VIA)
/sserial/SSerialOUTstm: U28.6 (VOB)
/sserial/VCCstm: U28.8 (VDD2)
ESTOP: J9.13
GND1: C2.2, J2.8, U4.4 (GND), U5.5 (GND2)
GND2: C6.2, J6.8, U12.4 (GND), U13.5 (GND2)
GND3: C3.2, J3.8, U6.4 (GND), U7.5 (GND2)
GND4: C7.2, J7.8, U14.4 (GND), U15.5 (GND2)
GND5: C4.2, J4.8, U8.4 (GND), U9.5 (GND2)
GND6: C8.2, J8.8, U16.4 (GND), U17.5 (GND2)
GND7: C1.2, J1.8, U2.4 (GND), U3.5 (GND2)
GND8: C5.2, J5.8, U10.4 (GND), U11.5 (GND2)
GNDD: J9.18, J9.19, J9.20, J9.21, U3.4 (GND1), U5.4 (GND1), U7.4 (GND1), U9.4 (GND1), U11.4 (GND1), U13.4 (GND1), U15.4 (GND1), U17.4 (GND1), U28.4 (GND1)
IN0: J9.1, U5.3 (VIB)
IN1: J9.2, U13.3 (VIB)
IN2: J9.3, U7.3 (VIB)
IN3: J9.4, U15.3 (VIB)
IN4: J9.5, U9.3 (VIB)
IN5: J9.7, U17.3 (VIB)
IN6: J9.9, U3.3 (VIB)
IN7: J9.11, JP1.1, U11.3 (VIB)
unnamed: J1.1, U2.5 (Y)
unnamed: J1.2, U2.6 (~Z~)
unnamed: J1.4, U2.7 (~B)
unnamed: J1.5, U2.8 (A)
unnamed: J2.1, U4.5 (Y)
unnamed: J2.2, U4.6 (~Z~)
unnamed: J2.4, U4.7 (~B)
unnamed: J2.5, U4.8 (A)
unnamed: J3.1, U6.5 (Y)
unnamed: J3.2, U6.6 (~Z~)
unnamed: J3.4, U6.7 (~B)
unnamed: J3.5, U6.8 (A)
unnamed: J4.1, U8.5 (Y)
unnamed: J4.2, U8.6 (~Z~)
unnamed: J4.4, U8.7 (~B)
unnamed: J4.5, U8.8 (A)
unnamed: J5.1, U10.5 (Y)
unnamed: J5.2, U10.6 (~Z~)
unnamed: J5.4, U10.7 (~B)
unnamed: J5.5, U10.8 (A)
unnamed: J6.1, U12.5 (Y)
unnamed: J6.2, U12.6 (~Z~)
unnamed: J6.4, U12.7 (~B)
unnamed: J6.5, U12.8 (A)
unnamed: J7.1, U14.5 (Y)
unnamed: J7.2, U14.6 (~Z~)
unnamed: J7.4, U14.7 (~B)
unnamed: J7.5, U14.8 (A)
unnamed: J8.1, U16.5 (Y)
unnamed: J8.2, U16.6 (~Z~)
unnamed: J8.4, U16.7 (~B)
unnamed: J8.5, U16.8 (A)
unnamed: JP1.2, U28.3 (VIB)
unnamed: JP2.2, U28.2 (VOA)
unnamed: U2.2 (RO), U3.7 (VIA)
unnamed: U2.3 (DI), U3.6 (VOB)
unnamed: U4.2 (RO), U5.7 (VIA)
unnamed: U4.3 (DI), U5.6 (VOB)
unnamed: U6.2 (RO), U7.7 (VIA)
unnamed: U6.3 (DI), U7.6 (VOB)
unnamed: U8.2 (RO), U9.7 (VIA)
unnamed: U8.3 (DI), U9.6 (VOB)
unnamed: U10.2 (RO), U11.7 (VIA)
unnamed: U10.3 (DI), U11.6 (VOB)
unnamed: U12.2 (RO), U13.7 (VIA)
unnamed: U12.3 (DI), U13.6 (VOB)
unnamed: U14.2 (RO), U15.7 (VIA)
unnamed: U14.3 (DI), U15.6 (VOB)
unnamed: U16.2 (RO), U17.7 (VIA)
unnamed: U16.3 (DI), U17.6 (VOB)
OUT0: J9.14, U5.2 (VOA)
OUT1: J9.15, U13.2 (VOA)
OUT2: J9.16, U7.2 (VOA)
OUT3: J9.17, U15.2 (VOA)
OUT4: J9.6, U9.2 (VOA)
OUT5: J9.8, U17.2 (VOA)
OUT6: J9.10, U3.2 (VOA)
OUT7: J9.12, JP2.1, U11.2 (VOA)

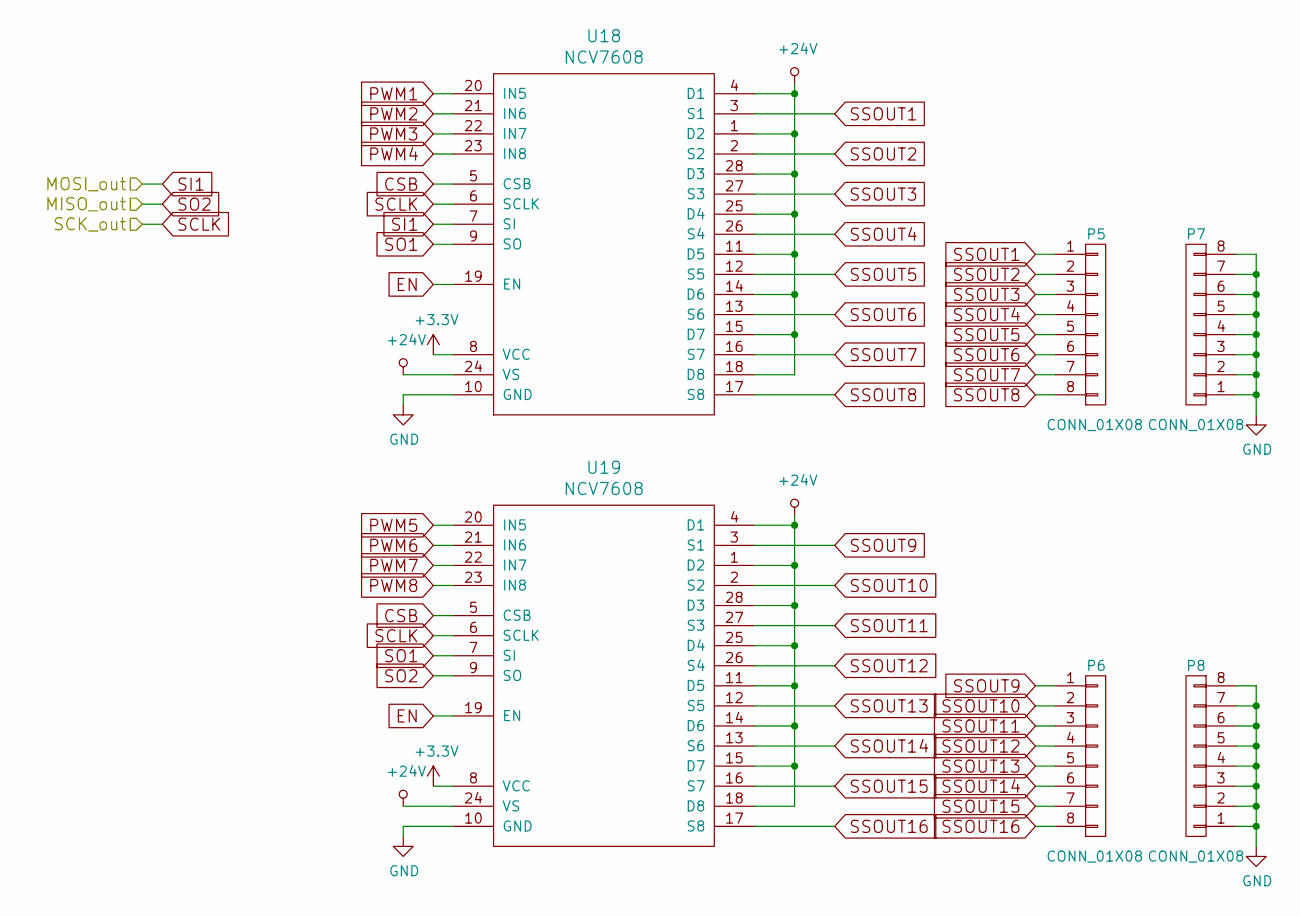
[picture p45: schematic output.sch]

Parts:
P5, P6, P7, P8: CONN_01X08; TerminalBlock_Pheonix_MPT-2.54mm_8pol
U18, U19: NCV7608; SOIC-28

Connections:
+3V3: U18.8 (VCC), U19.8 (VCC); also elsewhere on the board
+24V: U18.1 (D2), U18.4 (D1), U18.11 (D5), U18.14 (D6), U18.15 (D7), U18.18 (D8), U18.24 (VS), U18.25 (D4), U18.28 (D3), U19.1 (D2), U19.4 (D1), U19.11 (D5), U19.14 (D6), U19.15 (D7), U19.18 (D8), U19.24 (VS), U19.25 (D4), U19.28 (D3)
CSB: U18.5 (CSB), U19.5 (CSB)
EN: U18.19 (EN), U19.19 (EN)
GND: P7.1, P7.2, P7.3, P7.4, P7.5, P7.6, P7.7, P7.8, P8.1, P8.2, P8.3, P8.4, P8.5, P8.6, P8.7, P8.8, U18.10 (GND), U19.10 (GND); also elsewhere on the board
MISO: U19.9 (SO)
MOSI: U18.7 (SI)
PWM1: U18.20 (IN5)
PWM2: U18.21 (IN6)
PWM3: U18.22 (IN7)
PWM4: U18.23 (IN8)
PWM5: U19.20 (IN5)
PWM6: U19.21 (IN6)
PWM7: U19.22 (IN7)
PWM8: U19.23 (IN8)
SCK: U18.6 (SCLK), U19.6 (SCLK)
SO1: U18.9 (SO), U19.7 (SI)
SSOUT1: P5.1, U18.3 (S1)
SSOUT2: P5.2, U18.2 (S2)
SSOUT3: P5.3, U18.27 (S3)
SSOUT4: P5.4, U18.26 (S4)
SSOUT5: P5.5, U18.12 (S5)
SSOUT6: P5.6, U18.13 (S6)
SSOUT7: P5.7, U18.16 (S7)
SSOUT8: P5.8, U18.17 (S8)
SSOUT9: P6.1, U19.3 (S1)
SSOUT10: P6.2, U19.2 (S2)
SSOUT11: P6.3, U19.27 (S3)
SSOUT12: P6.4, U19.26 (S4)
SSOUT13: P6.5, U19.12 (S5)
SSOUT14: P6.6, U19.13 (S6)
SSOUT15: P6.7, U19.16 (S7)
SSOUT16: P6.8, U19.17 (S8)

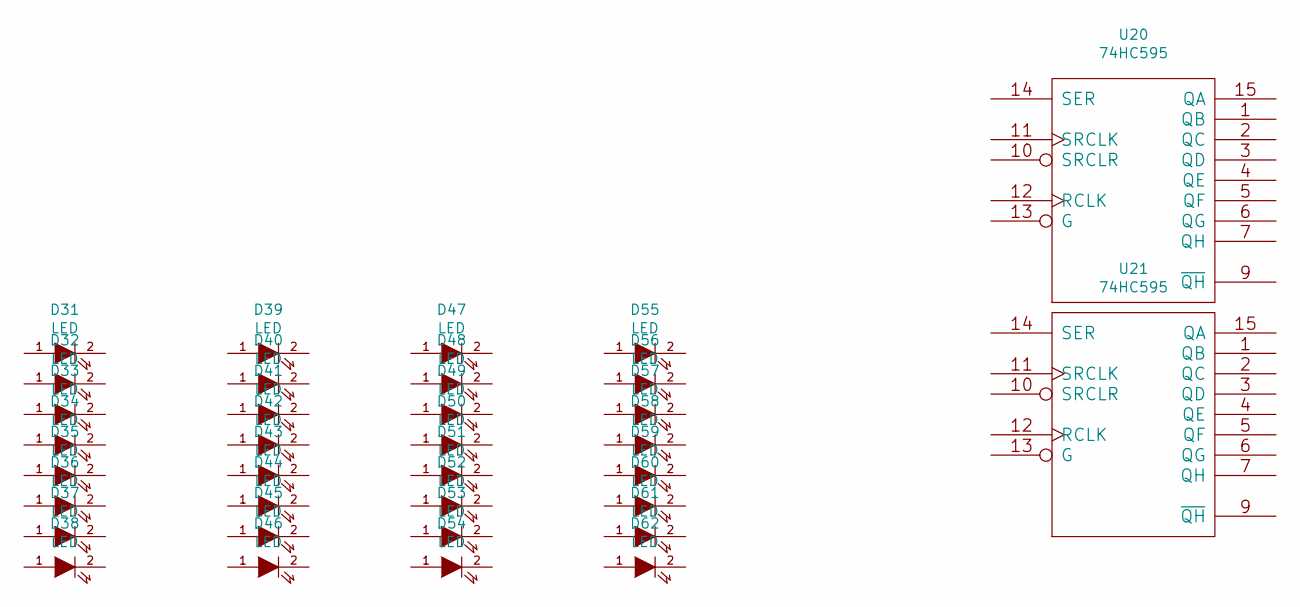
[picture p46: schematic led.sch]

Parts:
D31, D32, D33, D34, D35, D36, D37, D38, D39, D40, D41, D42, D43, D44, D45, D46, D47, D48, D49, D50, D51, D52, D53, D54, D55, D56, D57, D58, D59, D60, D61, D62: LED; LED_0603
U20, U21: 74HC595; SO-16-N

Connections:
GND: U20.8 (GND), U21.8 (GND); also elsewhere on the board
VCC: U20.16 (VCC), U21.16 (VCC)

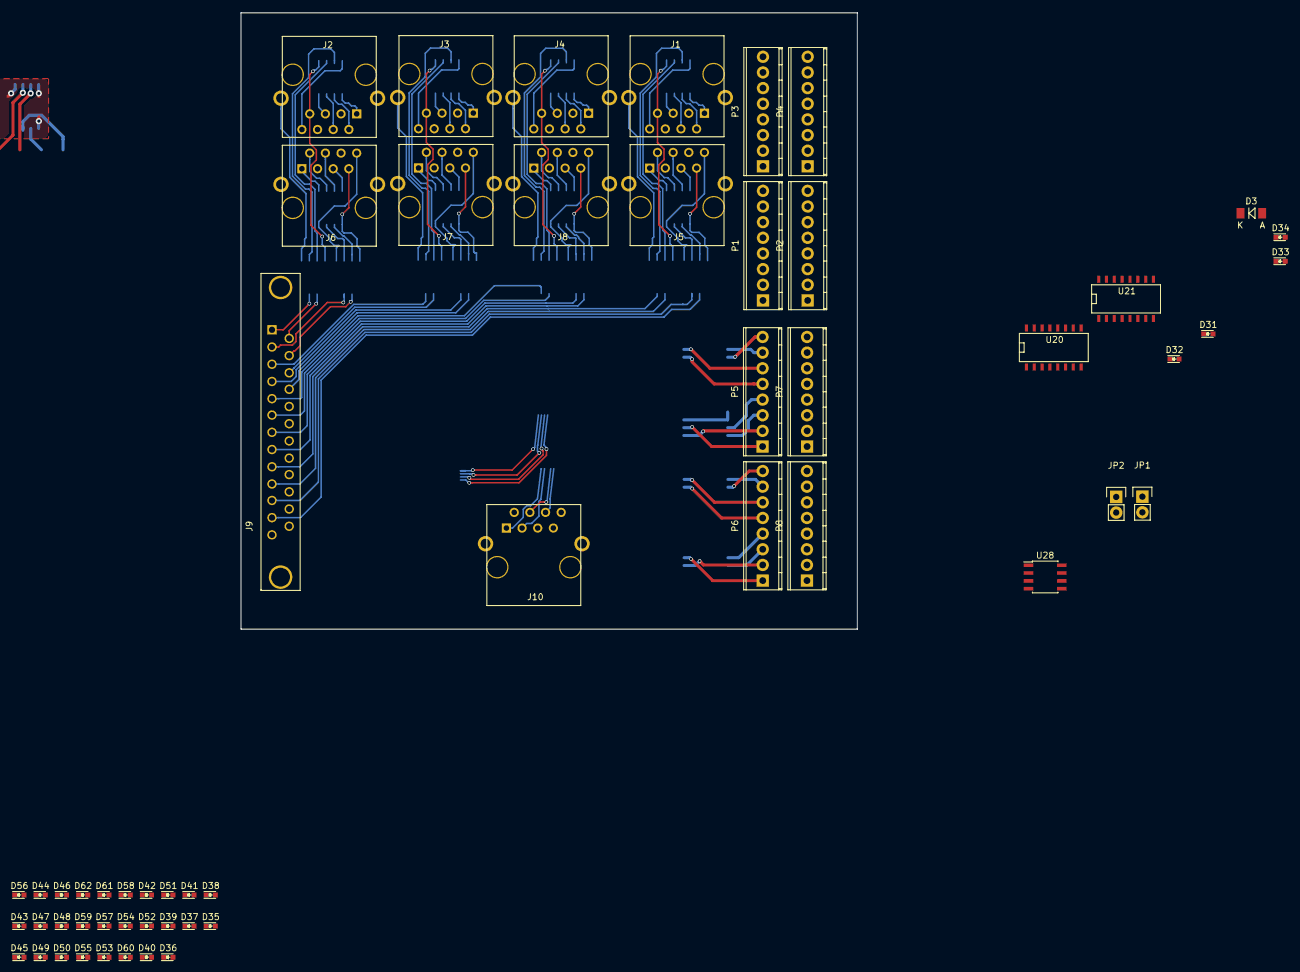
[picture p47: board db25_bob_v2.kicad_pcb from above]

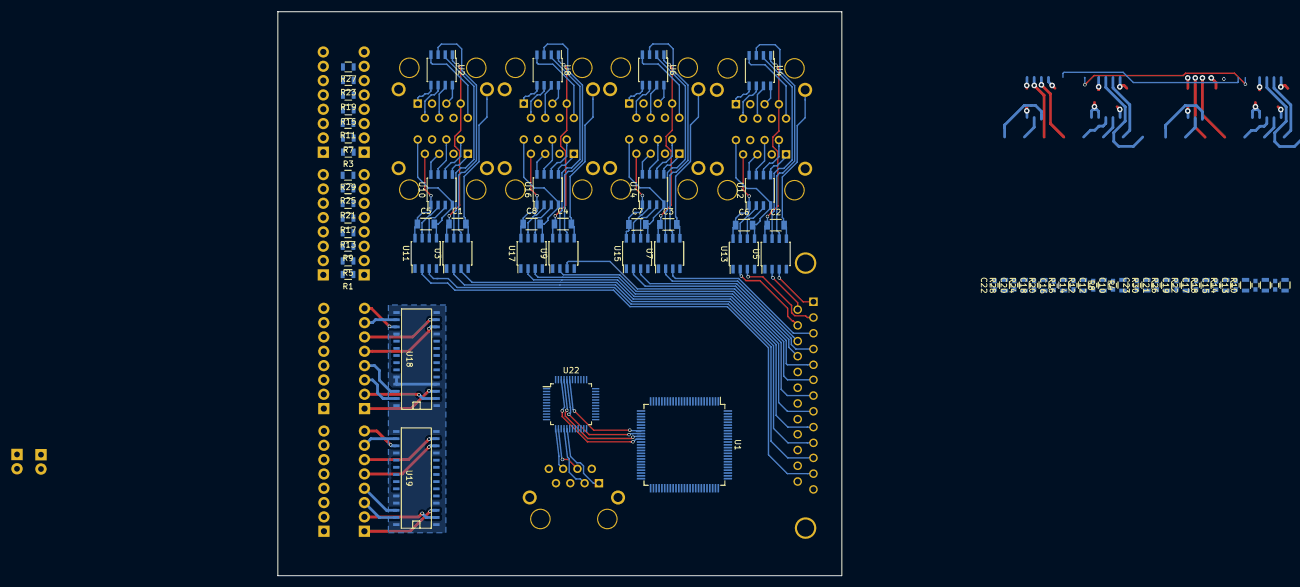
[picture p48: board db25_bob_v2.kicad_pcb from below]

Board: 2 copper layers, 100.0 x 100.0 mm, 129 parts (73 on the bottom side), 157 nets.
