AndriesTuinhof/stmbl/hardware/old designs/kicad/bob/db25_bob/db25_bob.kicad_pcb

## KiCad design hardware/old designs/kicad/bob/db25_bob/db25_bob.kicad_pcb (2022-10-24, an earlier design)

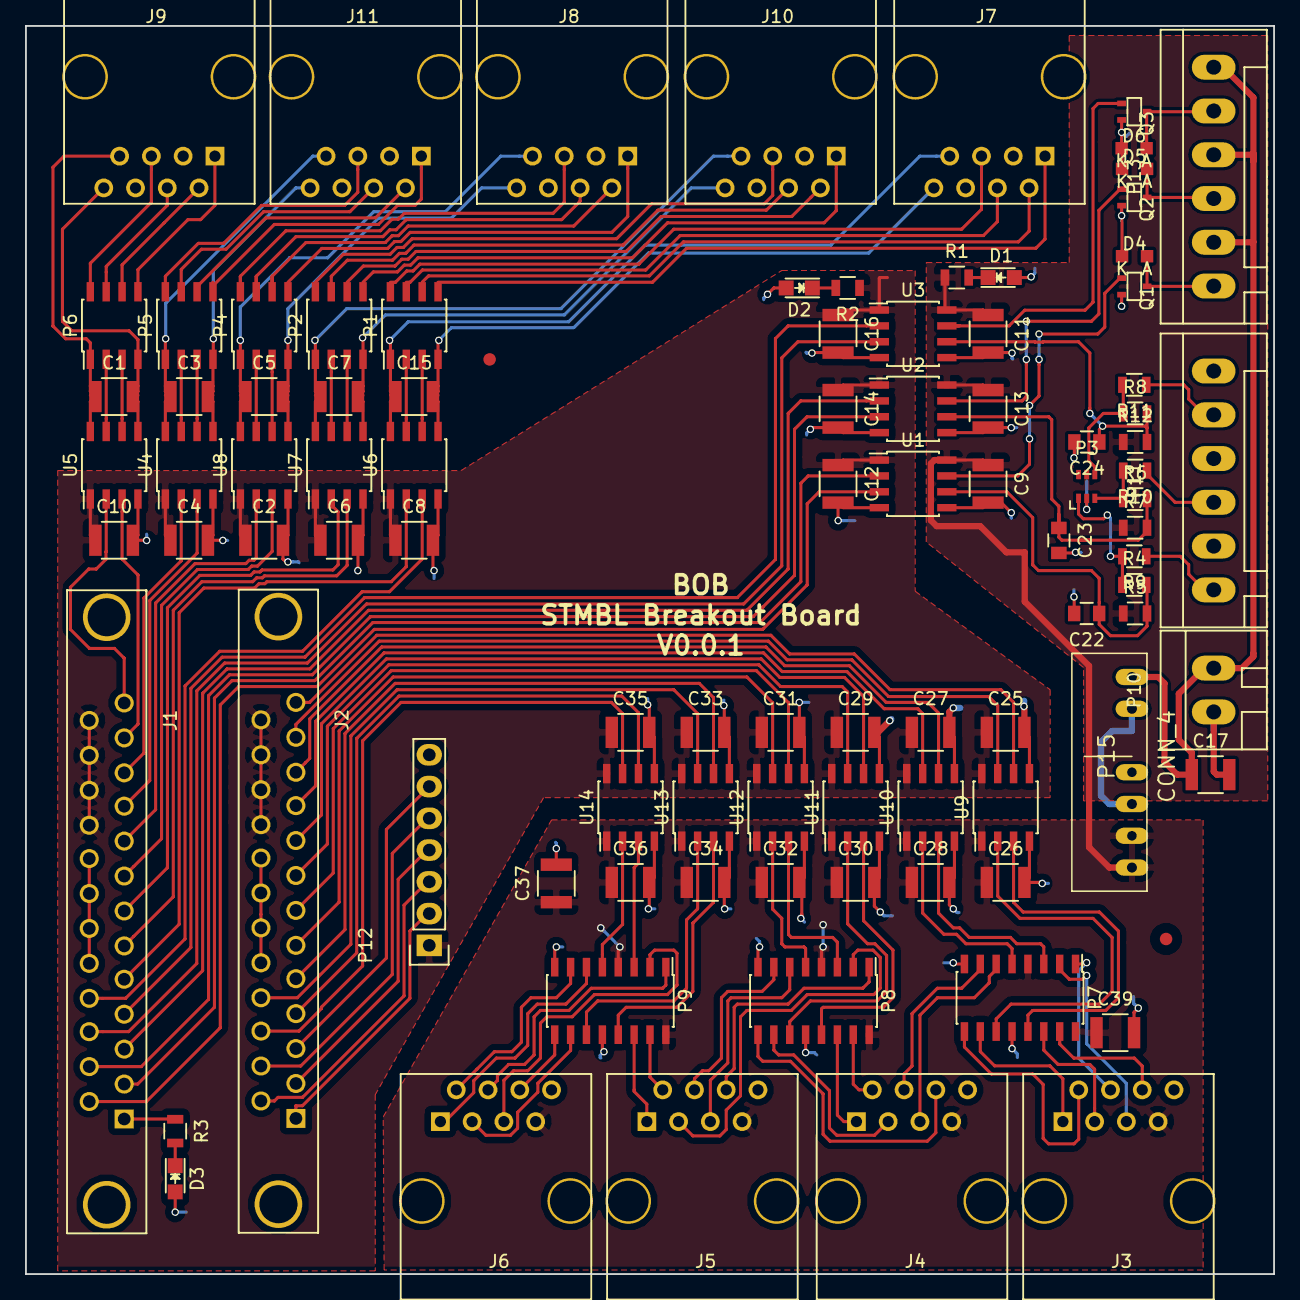
[picture p49: board db25_bob.kicad_pcb from above]

Board: 2 copper layers, 99.8 x 99.8 mm, 94 parts (0 on the bottom side), 133 nets.

Parts:
C1, C2, C3, C4, C5, C6, C7, C8, C9, C10, C11, C12, C13, C14, C15, C16, C17, C25, C26, C27, C28, C29, C30, C31, C32, C33, C34, C35, C36, C37, C39: C; C_1210
C22, C23, C24: C; C_0805
D1, D2, D3: LED; LED-0805
D4, D5, D6: DIODE; MiniMELF_Standard
J1, J2: DB25; DB25FD
J3, J4, J5, J6, J7, J8, J9, J10, J11: RJ45; RJ45_8
P1, P2, P4, P5, P6: DIL8; SOIC-8_3.9x4.9mm_Pitch1.27mm
P3: DIL6; SC-70-6
P7, P8, P9: DIL16; SOIC-16_3.9x9.9mm_Pitch1.27mm
P10: CONN_2; WAGO_734_2pin_Straight_RuggedPads
P11, P13: CONN_6; WAGO_734_6pin_Straight_RuggedPads
P12: CONN_7; Socket_Strip_Straight_1x07
P15: CONN_4; SIP7
Q1, Q2, Q3: FET_N; sc70
R1, R2, R3, R4, R5, R6, R7, R8, R9, R10, R11, R12: R; R_0805
U1, U2, U3, U4, U5, U6, U7, U8: ADuM1201WT; SOIC-8_3.9x4.9mm_Pitch1.27mm
U9, U10, U11, U12, U13, U14: ADuM1200CR; SOIC-8_3.9x4.9mm_Pitch1.27mm

Connections:
0RX: P1.2, U6.7
0RX+: J7.5, P1.8
0RX-: J7.4, P1.7
0TX: P1.3, U6.6
0TX+: J7.1, P1.5
0TX-: J7.2, P1.6
1RX: P2.2, U7.7
1RX+: J10.5, P2.8
1RX-: J10.4, P2.7
1TX: P2.3, U7.6
1TX+: J10.1, P2.5
1TX-: J10.2, P2.6
2RX: P4.2, U8.7
2RX+: J8.5, P4.8
2RX-: J8.4, P4.7
2TX: P4.3, U8.6
2TX+: J8.1, P4.5
2TX-: J8.2, P4.6
3RX: P5.2, U4.7
3RX+: J11.5, P5.8
3RX-: J11.4, P5.7
3TX: P5.3, U4.6
3TX+: J11.1, P5.5
3TX-: J11.2, P5.6
4RX: P6.2, U5.7
4RX+: J9.5, P6.8
4RX-: J9.4, P6.7
4TX: P6.3, U5.6
4TX+: J9.1, P6.5
4TX-: J9.2, P6.6
5V0: C15.1, J7.7, P1.1, U6.8
5V1: C7.1, J10.7, P2.1, U7.8
5V2: C5.1, J8.7, P4.1, U8.8
5V3: C3.1, J11.7, P5.1, U4.8
5V4: C1.1, J9.7, P6.1, U5.8
+5V: C2.1, C4.1, C6.1, C8.1, C10.1, C12.1, C14.1, C16.1, C25.1, C27.1, C29.1, C31.1, C33.1, C35.1, J1.22, J1.23, J1.24, J1.25, J2.22, J2.23, J2.24, J2.25, P12.1, R2.1, U1.1, U2.1, U3.1, U4.1, U5.1, U6.1, U7.1, U8.1, U9.8, U10.8, U11.8, U12.8, U13.8, U14.8
+5VA: C9.1, C11.1, C13.1, C26.1, C28.1, C30.1, C32.1, C34.1, C36.1, C37.1, C39.1, J3.7, J4.7, J5.7, J6.7, P3.5, P7.4, P7.16, P8.4, P8.16, P9.4, P9.16, P15.4, R1.1, R5.1, R7.1, R12.1, U1.8, U2.8, U3.8, U9.1, U10.1, U11.1, U12.1, U13.1, U14.1
+24V: C17.1, P10.2, P13.2, P13.4, P13.6, P15.1
EN-: C9.2, C11.2, C13.2, C17.2, C22.2, C23.2, C24.2, C26.2, C28.2, C30.2, C32.2, C34.2, C36.2, C37.2, C39.2, D1.2, D4.1, D5.1, D6.1, J3.8, J4.8, J5.8, J6.8, P3.2, P7.8, P7.12, P8.8, P8.12, P9.8, P9.12, P10.1, P11.2, P11.4, P11.6, P15.2, P15.3, Q1.S, Q2.S, Q3.S, U1.5, U2.5, U3.5, U9.4, U10.4, U11.4, U12.4, U13.4, U14.4
ENC0A: P7.11, U9.2
ENC0A+: J3.1, P7.10
ENC0A-: J3.2, P7.9
ENC0AO: J2.12, U9.7
ENC0B: P7.13, U9.3
ENC0B+: J3.3, P7.14
ENC0B-: J3.6, P7.15
ENC0BO: J2.13, U9.6
ENC0Z: P7.3, U10.3
ENC0Z+: J3.5, P7.2
ENC0Z-: J3.4, P7.1
ENC0ZO: J2.11, U10.6
ENC1A: P8.13, U11.3
ENC1A+: J4.1, P8.14
ENC1A-: J4.2, P8.15
ENC1AO: J2.9, U11.6
ENC1B: P8.11, U11.2
ENC1B+: J4.3, P8.10
ENC1B-: J4.6, P8.9
ENC1BO: J2.8, U11.7
ENC1Z: P7.5, U10.2
ENC1Z+: J4.5, P7.6
ENC1Z-: J4.4, P7.7
ENC1ZO: J2.10, U10.7
ENC2A: P9.13, U13.3
ENC2A+: J5.1, P9.14
ENC2A-: J5.2, P9.15
ENC2AO: J2.5, U13.6
ENC2B: P8.3, U12.3
ENC2B+: J5.3, P8.2
ENC2B-: J5.6, P8.1
ENC2BO: J2.7, U12.6
ENC2Z: P8.5, U12.2
ENC2Z+: J5.5, P8.6
ENC2Z-: J5.4, P8.7
ENC2ZO: J2.6, U12.7
ENC3A: P9.5, U14.2
ENC3A+: J6.1, P9.6
ENC3A-: J6.2, P9.7
ENC3AO: J2.16, U14.7
ENC3B: P9.11, U13.2
ENC3B+: J6.3, P9.10
ENC3B-: J6.6, P9.9
ENC3BO: J2.17, U13.7
ENC3Z: P9.3, U14.3
ENC3Z+: J6.5, P9.2
ENC3Z-: J6.4, P9.1
ENC3ZO: J2.4, U14.6
GND: C2.2, C4.2, C6.2, C8.2, C10.2, C12.2, C14.2, C16.2, C25.2, C27.2, C29.2, C31.2, C33.2, C35.2, D2.2, D3.2, J1.18, J1.19, J1.20, J1.21, J2.18, J2.19, J2.20, J2.21, P12.7, U1.4, U2.4, U3.4, U4.4, U5.4, U6.4, U7.4, U8.4, U9.5, U10.5, U11.5, U12.5, U13.5, U14.5
GND0: C15.2, J7.8, P1.4, U6.5
GND1: C7.2, J10.8, P2.4, U7.5
GND2: C5.2, J8.8, P4.4, U8.5
GND3: C3.2, J11.8, P5.4, U4.5
GND4: C1.2, J9.8, P6.4, U5.5
IN0: P11.1, R9.1
IN0P: C22.1, R4.2, R5.2, U1.6
IN0R: P3.1, R4.1, R9.2
IN1: P11.3, R10.1
IN1P: C23.1, R6.2, R7.2, U2.6
IN1R: P3.3, R6.1, R10.2
IN2: P11.5, R11.1
IN2P: C24.1, R8.2, R12.2, U3.6
IN2R: P3.4, R8.1, R11.2
IO0: J1.17, U6.3
IO1: J1.5, U6.2
IO2: J1.6, U7.3
IO3: J1.7, U7.2
IO4: J1.8, U8.3
IO5: J1.9, U8.2
IO6: J1.10, U4.3
IO7: J1.11, U4.2
IO8: J1.12, U5.3
IO9: J1.13, U5.2
IO10: J1.14, U1.3
IO11: J1.2, U1.2
IO12: J1.15, U2.3
IO13: J1.3, U2.2
IO14: J1.16, U3.3
IO15: J1.4, U3.2
IO16: J1.1, R3.1
unnamed: D1.1, R1.2
unnamed: D2.1, R2.2
unnamed: D3.1, R3.2
unnamed: J2.1, P12.2
unnamed: J2.2, P12.4
unnamed: J2.3, P12.6
unnamed: J2.14, P12.3
unnamed: J2.15, P12.5
OUT0: Q1.G, U1.7
OUT0FET: D4.2, P13.1, Q1.D
OUT1: Q2.G, U2.7
OUT1FET: D5.2, P13.3, Q2.D
OUT2: Q3.G, U3.7
OUT2FET: D6.2, P13.5, Q3.D
