AndriesTuinhof/stmbl/hardware/old designs/kicad/stmsp/stmsp.kicad_pcb

## KiCad design hardware/old designs/kicad/stmsp/stmsp.kicad_pcb (2022-10-24, an earlier design)

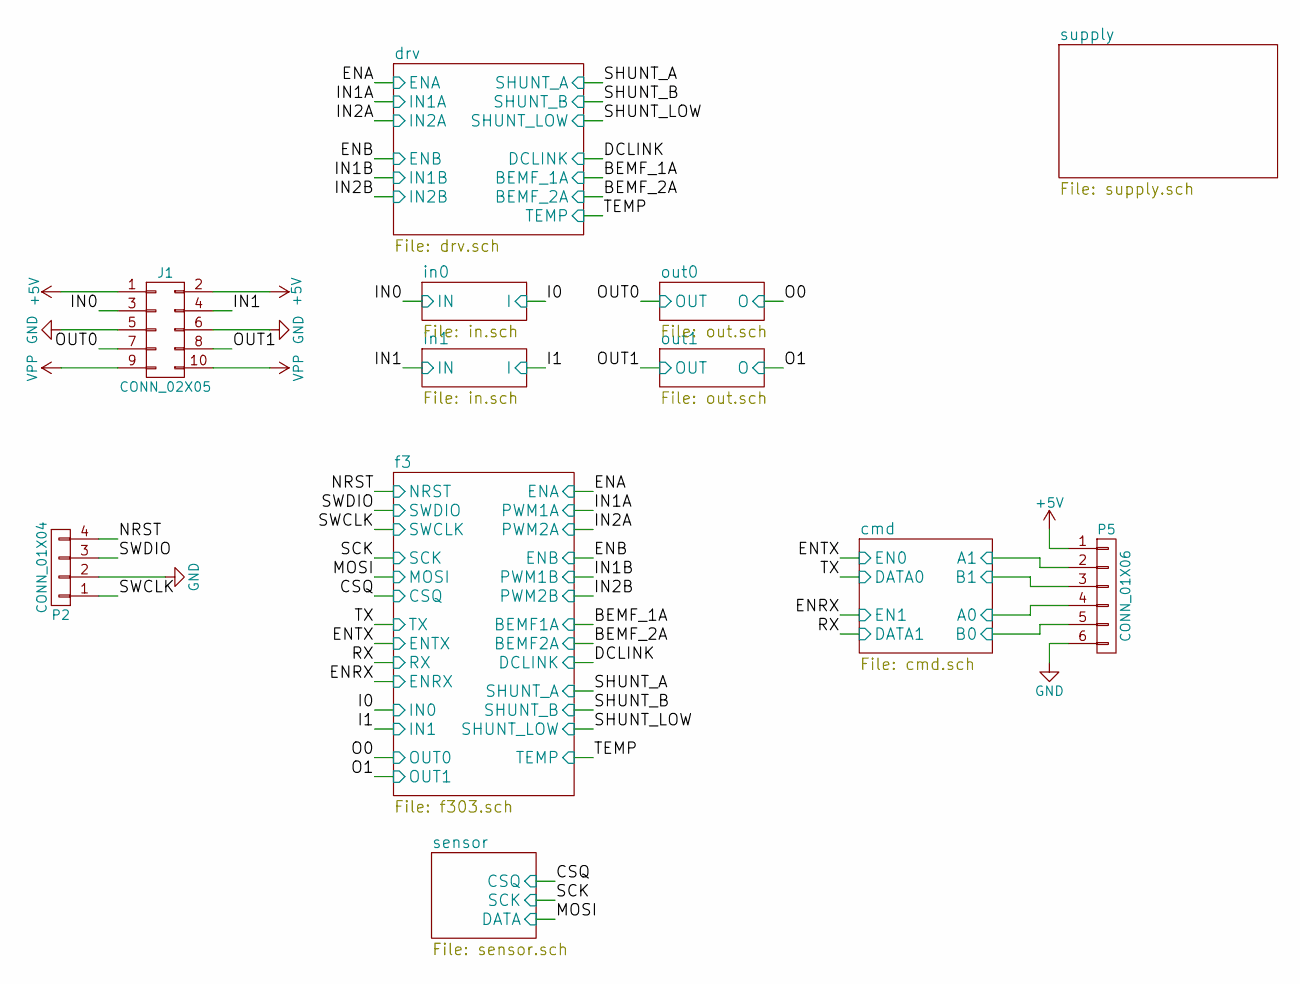
[picture p50: schematic stmsp.sch]

Parts:
J1: CONN_02X05; Pin_Header_Straight_2x05
P2: CONN_01X04; Pin_Header_Straight_1x04
P5: CONN_01X06; Pin_Header_Straight_1x06

Connections:
+5V: J1.1, J1.2, P5.1; also elsewhere on the board
/IN0: J1.3; also elsewhere on the board
/IN1: J1.4; also elsewhere on the board
/NRST: P2.4; also elsewhere on the board
/OUT0: J1.7; also elsewhere on the board
/OUT1: J1.8; also elsewhere on the board
/SWCLK: P2.1; also elsewhere on the board
/SWDIO: P2.3; also elsewhere on the board
/cmd/A0: P5.4; also elsewhere on the board
/cmd/A1: P5.2; also elsewhere on the board
/cmd/B0: P5.5; also elsewhere on the board
/cmd/B1: P5.3; also elsewhere on the board
GND: J1.5, J1.6, P2.2, P5.6; also elsewhere on the board
VPP: J1.9, J1.10; also elsewhere on the board
