AndriesTuinhof/stmbl/hardware/old designs/kicad/stmsp/stmsp.kicad_pcb

## KiCad design hardware/old designs/kicad/stmsp/stmsp.kicad_pcb (continued)

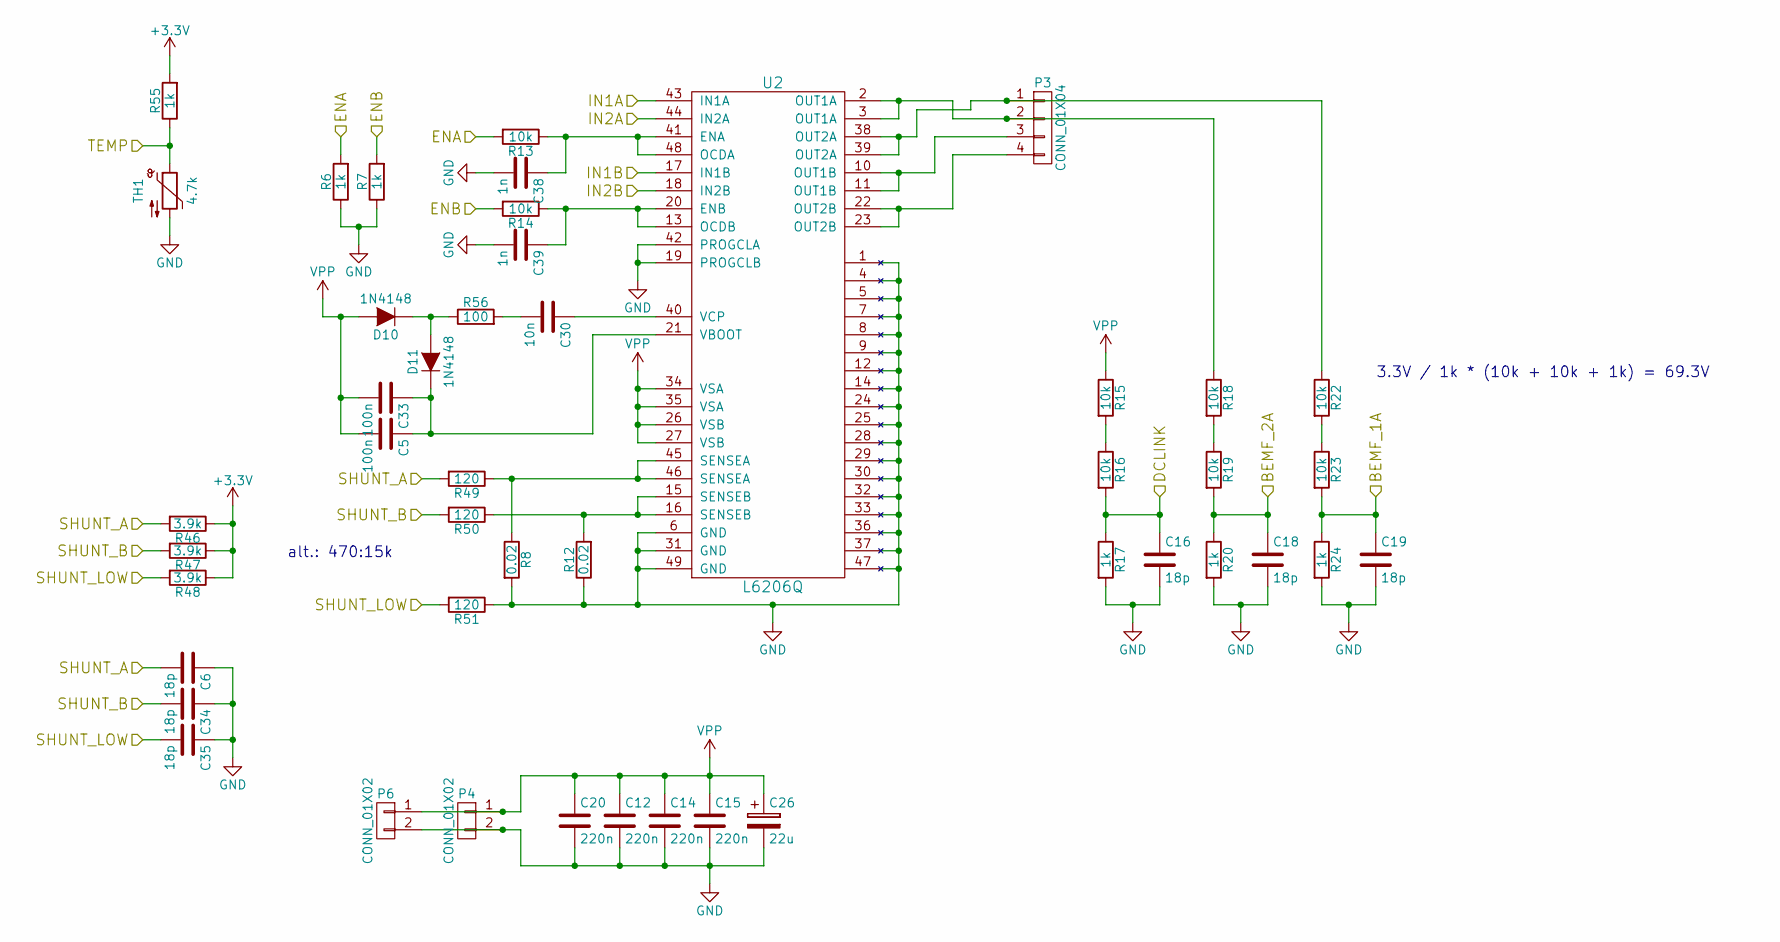
[picture p51: schematic drv.sch]

Parts:
C5, C33: 100n; C_0603
C6, C16, C18, C19, C34, C35: 18p; C_0603
C12, C14, C15, C20: 220n; C_0805
C26: 22u; c_elec_5x5.3
C30: 10n; C_0603
C38, C39: 1n; C_0603
D10, D11: 1N4148; SOD-123
P3: CONN_01X04; Pin_Header_Straight_1x04_dual
P4: CONN_01X02; akl182-2
P6: CONN_01X02; akl183-2
R6, R7, R17, R20, R24, R55: 1k; R_0603
R8, R12: 0.02; R_0805
R13, R14, R15, R16, R18, R19, R22, R23: 10k; R_0603
R46, R47, R48: 3.9k; R_0603
R49, R50, R51: 120; R_0603
R56: 100; R_0603
TH1: 4.7k; R_0603
U2: L6206Q; VFQFPN48

Connections:
+3V3: R46.1, R47.1, R48.1, R55.2; also elsewhere on the board
/BEMF_1A: C19.1, R23.2, R24.1; also elsewhere on the board
/BEMF_2A: C18.1, R19.2, R20.1; also elsewhere on the board
/DCLINK: C16.1, R16.2, R17.1; also elsewhere on the board
/ENA: R6.2, R13.2; also elsewhere on the board
/ENB: R7.2, R14.2; also elsewhere on the board
/IN1A: U2.43 (IN1A); also elsewhere on the board
/IN1B: U2.17 (IN1B); also elsewhere on the board
/IN2A: U2.44 (IN2A); also elsewhere on the board
/IN2B: U2.18 (IN2B); also elsewhere on the board
/SHUNT_A: C6.2, R46.2, R49.2; also elsewhere on the board
/SHUNT_B: C34.2, R47.2, R50.2; also elsewhere on the board
/SHUNT_LOW: C35.2, R48.2, R51.2; also elsewhere on the board
/TEMP: R55.1, TH1.1; also elsewhere on the board
GND: C6.1, C12.2, C14.2, C15.2, C16.2, C18.2, C19.2, C20.2, C26.2, C34.1, C35.1, C38.2, C39.2, P4.2, P6.2, R6.1, R7.1, R8.2, R12.1, R17.2, R20.2, R24.2, R51.1, TH1.2, U2.1, U2.4, U2.5, U2.6 (GND), U2.7, U2.8, U2.9, U2.12, U2.14, U2.19 (PROGCLB), U2.24, U2.25, U2.28, U2.29, U2.30, U2.31 (GND), U2.32, U2.33, U2.36, U2.37, U2.42 (PROGCLA), U2.47, U2.49 (GND); also elsewhere on the board
unnamed: C30.1, U2.40 (VCP)
unnamed: C30.2, R56.2
unnamed: C5.1, C33.1, D11.1 (K), U2.21 (VBOOT)
unnamed: C38.1, R13.1, U2.41 (ENA), U2.48 (OCDA)
unnamed: C39.1, R14.1, U2.13 (OCDB), U2.20 (ENB)
unnamed: D10.1 (K), D11.2 (A), R56.1
unnamed: P3.1, R22.1, U2.38 (OUT2A), U2.39 (OUT2A)
unnamed: P3.2, R18.1, U2.2 (OUT1A), U2.3 (OUT1A)
unnamed: P3.3, U2.10 (OUT1B), U2.11 (OUT1B)
unnamed: P3.4, U2.22 (OUT2B), U2.23 (OUT2B)
unnamed: R12.2, R50.1, U2.15 (SENSEB), U2.16 (SENSEB)
unnamed: R15.2, R16.1
unnamed: R18.2, R19.1
unnamed: R22.2, R23.1
unnamed: R8.1, R49.1, U2.45 (SENSEA), U2.46 (SENSEA)
VPP: C5.2, C12.1, C14.1, C15.1, C20.1, C26.1, C33.2, D10.2 (A), P4.1, P6.1, R15.1, U2.26 (VSB), U2.27 (VSB), U2.34 (VSA), U2.35 (VSA); also elsewhere on the board

Notes on the sheet:
3.3V / 1k * (10k + 10k + 1k) = 69.3V
alt.: 470:15k

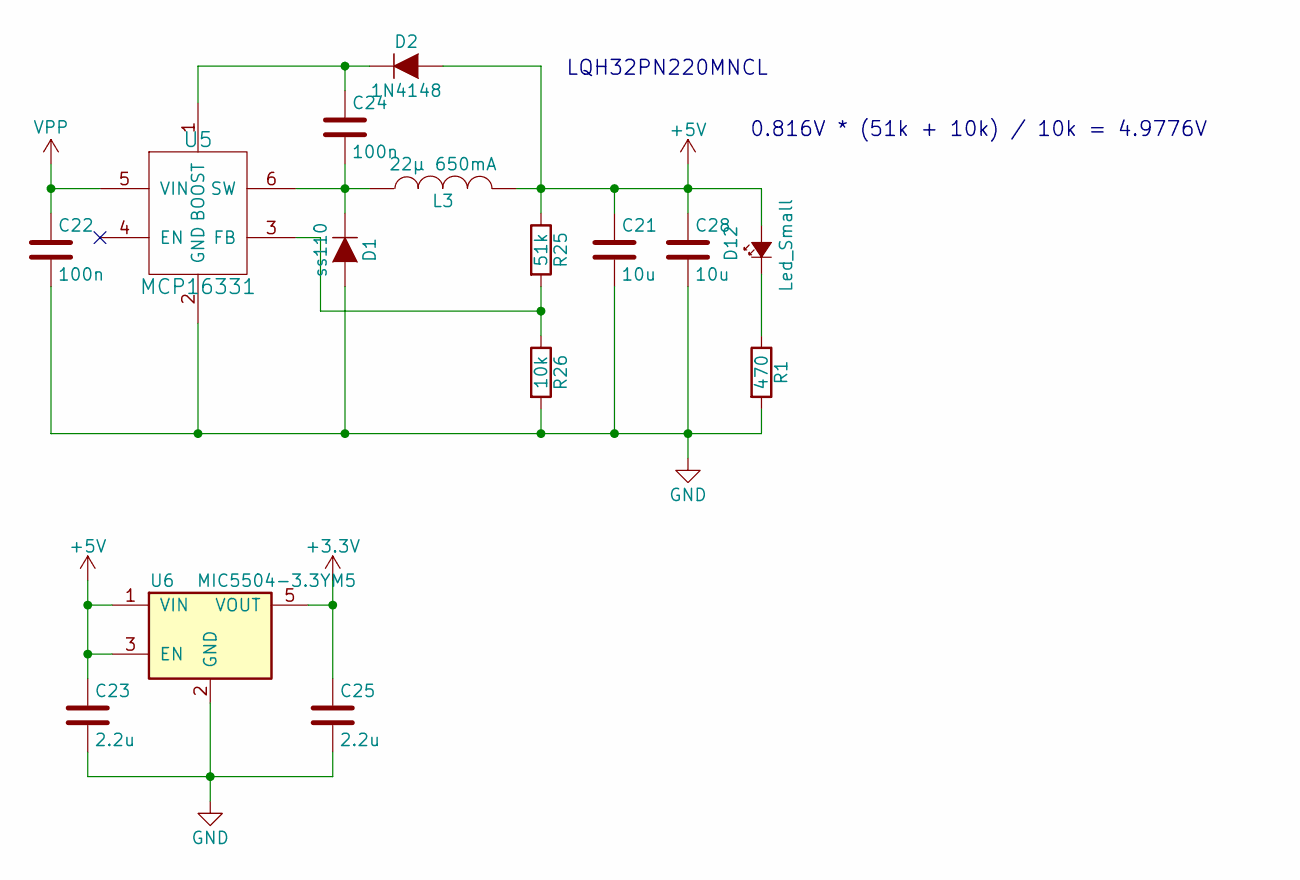
[picture p52: schematic supply.sch]

Parts:
C21, C28: 10u; C_0805
C22, C24: 100n; C_0603
C23, C25: 2.2u; C_0603
D1: ss110; SMA_Standard
D2: 1N4148; SOD-123
D12: Led_Small; LED-0805-SIDE
L3: 22µ 650mA; SMD_INDUCTOR_32x25
R1: 470; R_0603
R25: 51k; R_0603
R26: 10k; R_0603
U5: MCP16331; SOT-23-6
U6: MIC5504-3.3YM5; SOT-23-5

Connections:
+3V3: C25.1, U6.5 (VOUT); also elsewhere on the board
+5V: C21.1, C23.1, C28.1, D2.2 (A), D12.2 (A), L3.2, R25.1, U6.1 (VIN), U6.3 (EN); also elsewhere on the board
GND: C21.2, C22.2, C23.2, C25.2, C28.2, D1.2 (A), R1.2, R26.2, U5.2 (GND), U6.2 (GND); also elsewhere on the board
unnamed: C24.1, D2.1 (K), U5.1 (BOOST)
unnamed: C24.2, D1.1 (K), L3.1, U5.6 (SW)
unnamed: D12.1 (K), R1.1
unnamed: R25.2, R26.1, U5.3 (FB)
VPP: C22.1, U5.5 (VIN); also elsewhere on the board

Notes on the sheet:
LQH32PN220MNCL
0.816V * (51k + 10k) / 10k = 4.9776V

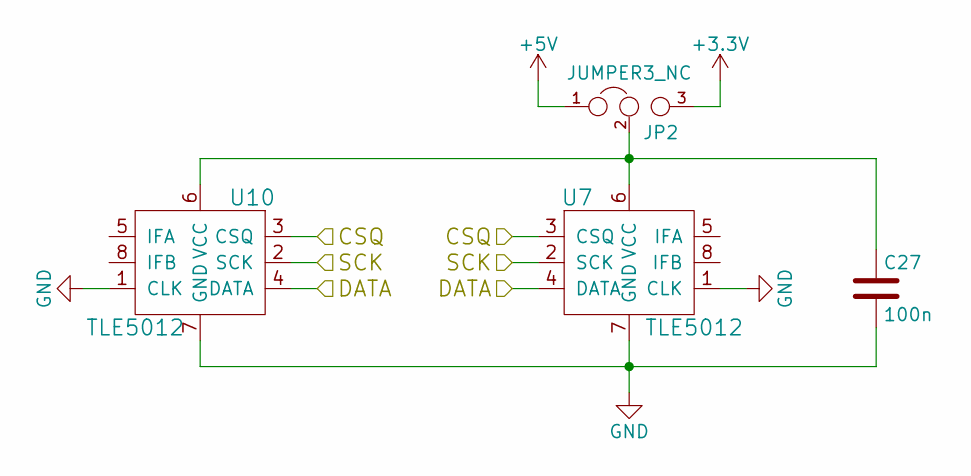
[picture p53: schematic sensor.sch]

Parts:
C27: 100n; C_0603
JP2: JUMPER3_NC; SOLDER_JUMPER_3_NC
U7, U10: TLE5012; SOIC-8-N

Connections:
+3V3: JP2.3; also elsewhere on the board
+5V: JP2.1; also elsewhere on the board
/CSQ: U7.3 (CSQ), U10.3 (CSQ); also elsewhere on the board
/MOSI: U7.4 (DATA), U10.4 (DATA); also elsewhere on the board
/SCK: U7.2 (SCK), U10.2 (SCK); also elsewhere on the board
GND: C27.2, U7.1 (CLK), U7.7 (GND), U10.1 (CLK), U10.7 (GND); also elsewhere on the board
unnamed: C27.1, JP2.2, U7.6 (VCC), U10.6 (VCC)

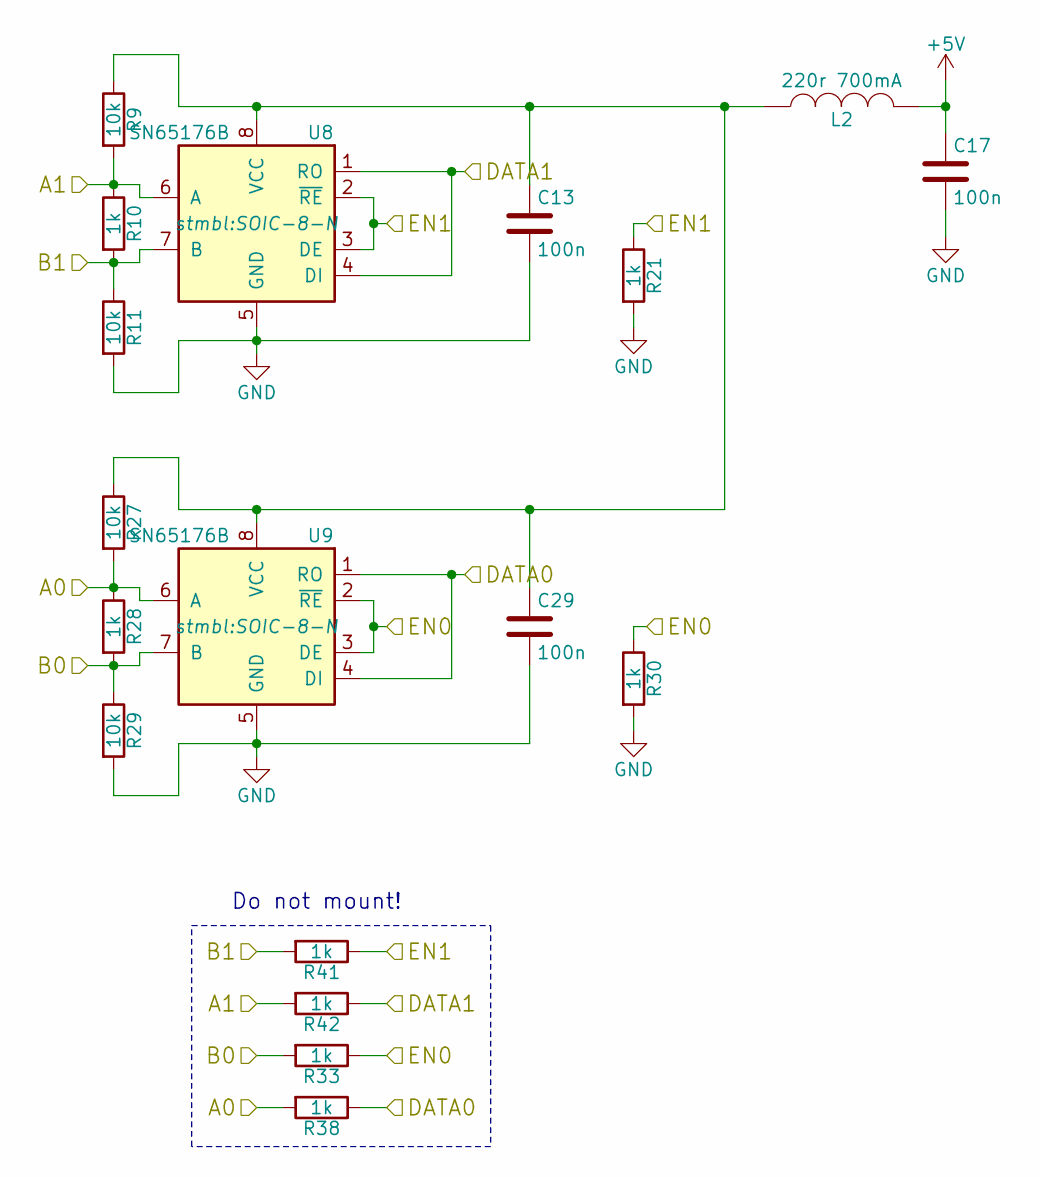
[picture p54: schematic cmd.sch]

Parts:
C13, C17, C29: 100n; C_0603
L2: 220r 700mA; R_0603
R9, R11, R27, R29: 10k; R_0603
R10, R21, R28, R30, R33, R38, R41, R42: 1k; R_0603
U8, U9: SN65176B; SOIC-8-N

Connections:
+5V: C17.1, L2.2; also elsewhere on the board
/ENRX: R21.1, R41.1, U8.2 (~RE~), U8.3 (DE); also elsewhere on the board
/ENTX: R30.1, R33.1, U9.2 (~RE~), U9.3 (DE); also elsewhere on the board
/RX: R42.1, U8.1 (RO), U8.4 (DI); also elsewhere on the board
/TX: R38.1, U9.1 (RO), U9.4 (DI); also elsewhere on the board
/cmd/A0: R27.2, R28.1, R38.2, U9.6 (A); also elsewhere on the board
/cmd/A1: R9.2, R10.1, R42.2, U8.6 (A); also elsewhere on the board
/cmd/B0: R28.2, R29.1, R33.2, U9.7 (B); also elsewhere on the board
/cmd/B1: R10.2, R11.1, R41.2, U8.7 (B); also elsewhere on the board
GND: C13.2, C17.2, C29.2, R11.2, R21.2, R29.2, R30.2, U8.5 (GND), U9.5 (GND); also elsewhere on the board
unnamed: C13.1, C29.1, L2.1, R9.1, R27.1, U8.8 (VCC), U9.8 (VCC)

Notes on the sheet:
Do not mount!

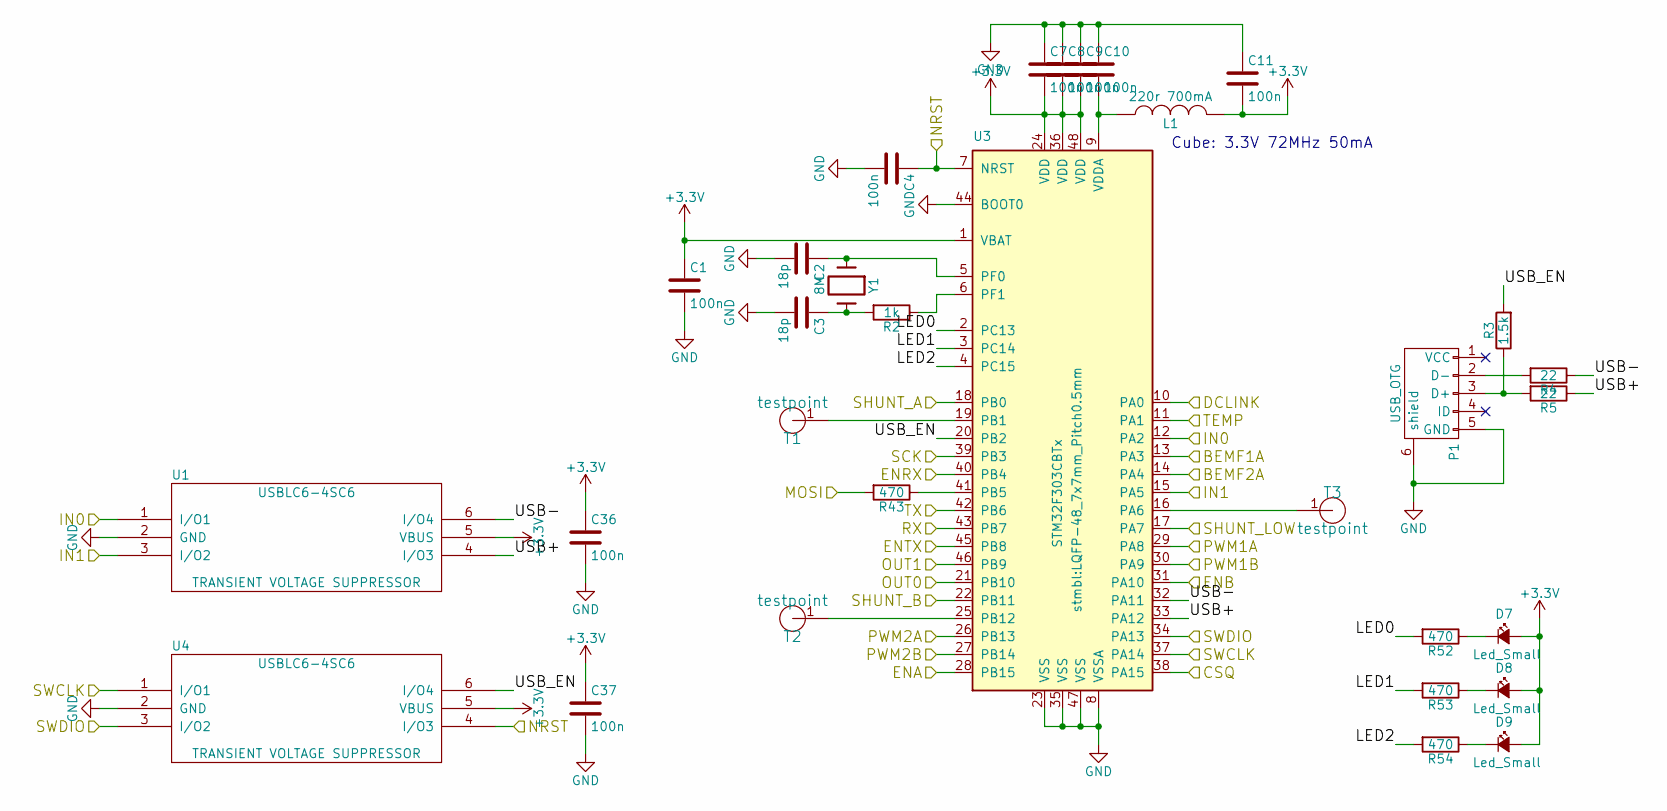
[picture p55: schematic f303.sch]

Parts:
C1, C4, C7, C8, C9, C10, C11, C36, C37: 100n; C_0603
C2, C3: 18p; C_0603
D7, D8, D9: Led_Small; LED-0805-SIDE
L1: 220r 700mA; R_0603
P1: USB_OTG; USB_Micro-B
R2: 1k; R_0603
R3: 1.5k; R_0603
R4, R5: 22; R_0603
R43, R52, R53, R54: 470; R_0603
T1, T2, T3: testpoint; Measurement_Point_Round-SMD-Pad_Small
U1, U4: USBLC6-4SC6; SOT-23-6
U3: STM32F303CBTx; LQFP-48_7x7mm_Pitch0.5mm
Y1: 8M; Crystal_SMD_0503_4Pads

Connections:
+3V3: C1.1, C7.2, C8.2, C9.2, C11.2, C36.1, C37.1, D7.2 (A), D8.2 (A), D9.2 (A), L1.2, U1.5 (VBUS), U3.1 (VBAT), U3.24 (VDD), U3.36 (VDD), U3.48 (VDD), U4.5 (VBUS); also elsewhere on the board
/BEMF_1A: U3.13 (PA3); also elsewhere on the board
/BEMF_2A: U3.14 (PA4); also elsewhere on the board
/CSQ: U3.38 (PA15); also elsewhere on the board
/DCLINK: U3.10 (PA0); also elsewhere on the board
/ENA: U3.28 (PB15); also elsewhere on the board
/ENB: U3.31 (PA10); also elsewhere on the board
/ENRX: U3.40 (PB4); also elsewhere on the board
/ENTX: U3.45 (PB8); also elsewhere on the board
/I0: U1.1 (I/O1), U3.12 (PA2); also elsewhere on the board
/I1: U1.3 (I/O2), U3.15 (PA5); also elsewhere on the board
/IN1A: U3.29 (PA8); also elsewhere on the board
/IN1B: U3.30 (PA9); also elsewhere on the board
/IN2A: U3.26 (PB13); also elsewhere on the board
/IN2B: U3.27 (PB14); also elsewhere on the board
/MOSI: R43.2; also elsewhere on the board
/NRST: C4.1, U3.7 (NRST), U4.4 (I/O3); also elsewhere on the board
/O0: U3.21 (PB10); also elsewhere on the board
/O1: U3.46 (PB9); also elsewhere on the board
/RX: U3.43 (PB7); also elsewhere on the board
/SCK: U3.39 (PB3); also elsewhere on the board
/SHUNT_A: U3.18 (PB0); also elsewhere on the board
/SHUNT_B: U3.22 (PB11); also elsewhere on the board
/SHUNT_LOW: U3.17 (PA7); also elsewhere on the board
/SWCLK: U3.37 (PA14), U4.1 (I/O1); also elsewhere on the board
/SWDIO: U3.34 (PA13), U4.3 (I/O2); also elsewhere on the board
/TEMP: U3.11 (PA1); also elsewhere on the board
/TX: U3.42 (PB6); also elsewhere on the board
/f3/LED0: R52.2, U3.2 (PC13)
/f3/LED1: R53.2, U3.3 (PC14)
/f3/LED2: R54.2, U3.4 (PC15)
/f3/USB+: R5.1, U1.4 (I/O3), U3.33 (PA12)
/f3/USB-: R4.1, U1.6 (I/O4), U3.32 (PA11)
/f3/USB_EN: R3.2, U3.20 (PB2), U4.6 (I/O4)
GND: C1.2, C2.2, C3.2, C4.2, C7.1, C8.1, C9.1, C10.1, C11.1, C36.2, C37.2, P1.5 (GND), P1.6 (shield), U1.2 (GND), U3.8 (VSSA), U3.23 (VSS), U3.35 (VSS), U3.44 (BOOT0), U3.47 (VSS), U4.2 (GND); also elsewhere on the board
unnamed: C2.1, U3.5 (PF0), Y1.1
unnamed: C3.1, R2.2, Y1.2
unnamed: C10.2, L1.1, U3.9 (VDDA)
unnamed: D7.1 (K), R52.1
unnamed: D8.1 (K), R53.1
unnamed: D9.1 (K), R54.1
unnamed: P1.2 (D-), R4.2
unnamed: P1.3 (D+), R3.1, R5.2
unnamed: R2.1, U3.6 (PF1)
unnamed: R43.1, U3.41 (PB5)
unnamed: T1.1, U3.19 (PB1)
unnamed: T2.1, U3.25 (PB12)
unnamed: T3.1, U3.16 (PA6)

Notes on the sheet:
Cube: 3.3V 72MHz 50mA

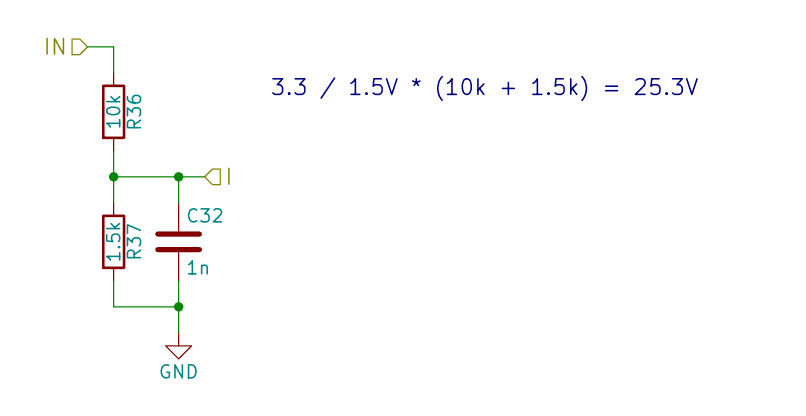
[picture p56: schematic in.sch]

Parts:
C31: 1n; C_0603
R31: 10k; R_0603
R32: 1.5k; R_0603

Connections:
/I0: C31.1, R31.2, R32.1; also elsewhere on the board
/IN0: R31.1; also elsewhere on the board
GND: C31.2, R32.2; also elsewhere on the board

Parts of its further copies:
C32: 1n; C_0603
R36: 10k; R_0603
R37: 1.5k; R_0603

Connections of its further copies:
/I1: C32.1, R36.2, R37.1; also elsewhere on the board
/IN1: R36.1; also elsewhere on the board
GND: C32.2, R37.2; also elsewhere on the board

Notes on the sheet:
3.3 / 1.5V * (10k + 1.5k) = 25.3V

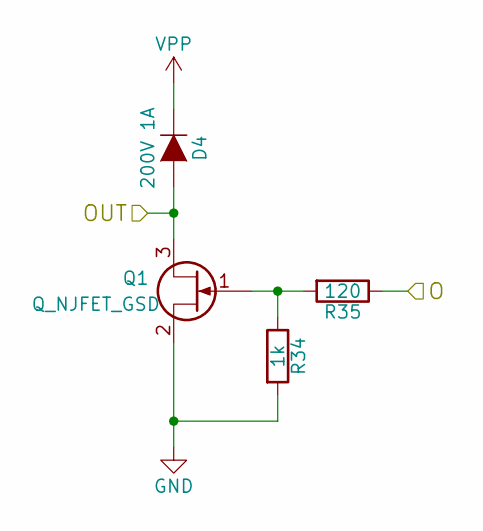
[picture p57: schematic out.sch]

Parts:
D4: 200V 1A; SOD-123
Q1: Q_NJFET_GSD; SOT-23
R34: 1k; R_0603
R35: 120; R_0603

Connections:
/O0: R35.1; also elsewhere on the board
/OUT0: D4.2 (A), Q1.3 (D); also elsewhere on the board
GND: Q1.2 (S), R34.2; also elsewhere on the board
unnamed: Q1.1 (G), R34.1, R35.2
VPP: D4.1 (K); also elsewhere on the board

Parts of its further copies:
D6: 200V 1A; SOD-123
Q2: Q_NJFET_GSD; SOT-23
R39: 1k; R_0603
R40: 120; R_0603

Connections of its further copies:
/O1: R40.1; also elsewhere on the board
/OUT1: D6.2 (A), Q2.3 (D); also elsewhere on the board
GND: Q2.2 (S), R39.2; also elsewhere on the board
unnamed: Q2.1 (G), R39.1, R40.2
VPP: D6.1 (K); also elsewhere on the board

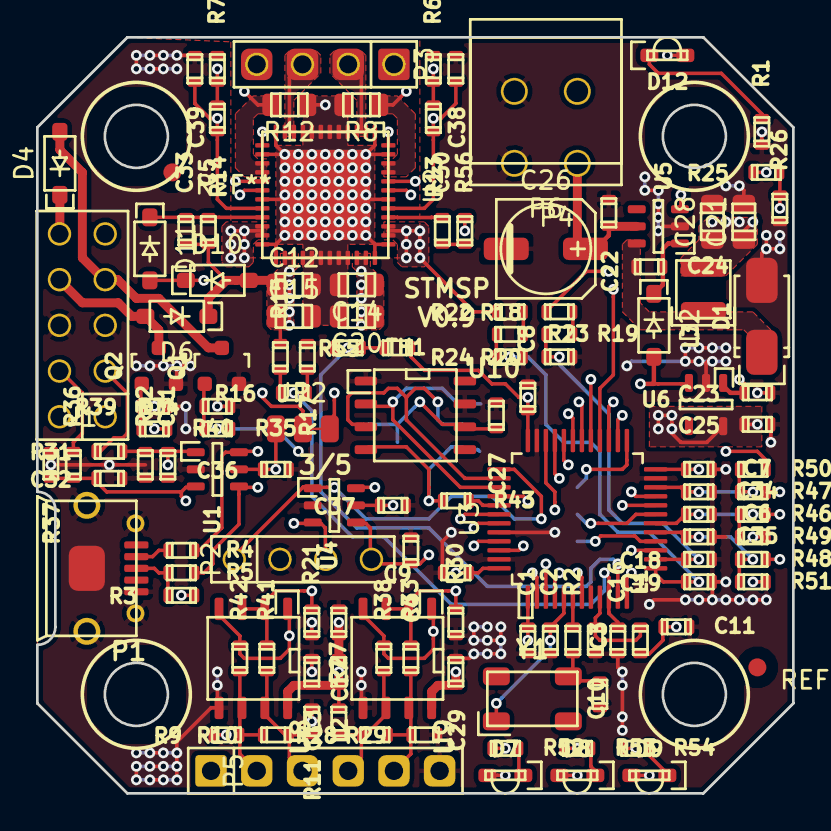
[picture p58: board stmsp.kicad_pcb from above]

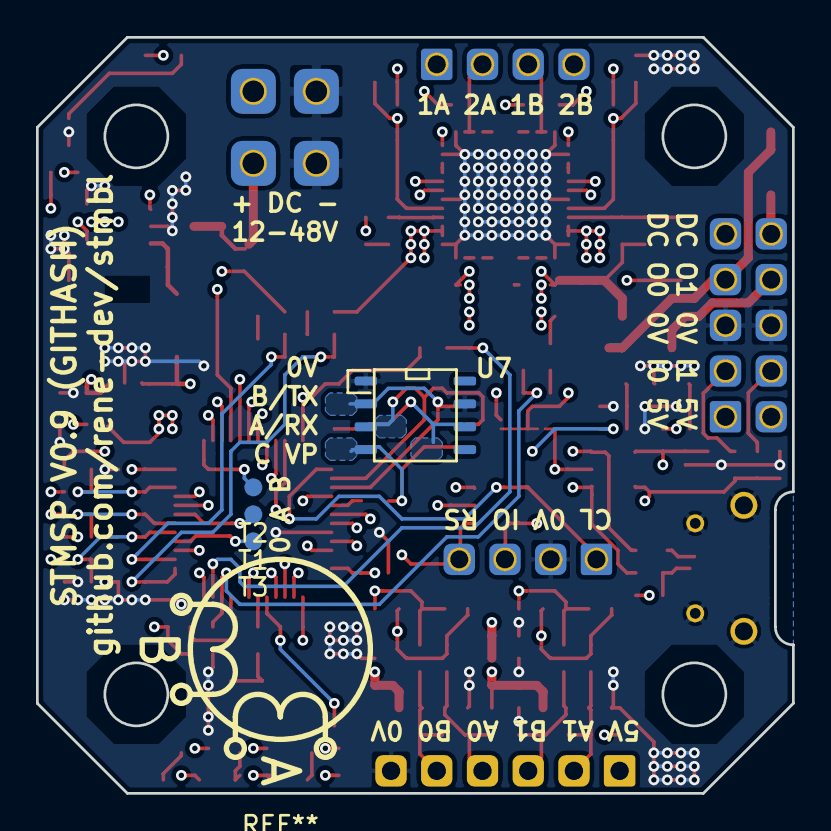
[picture p59: board stmsp.kicad_pcb from below]

Board: 4 copper layers, 42.0 x 42.0 mm, 131 parts (4 on the bottom side), 81 nets.
