AndriesTuinhof/stmbl/hardware/old designs/kicad/trollerV2/trollerv2.kicad_pcb

## KiCad design hardware/old designs/kicad/trollerV2/trollerv2.kicad_pcb (2022-10-24, an earlier design)

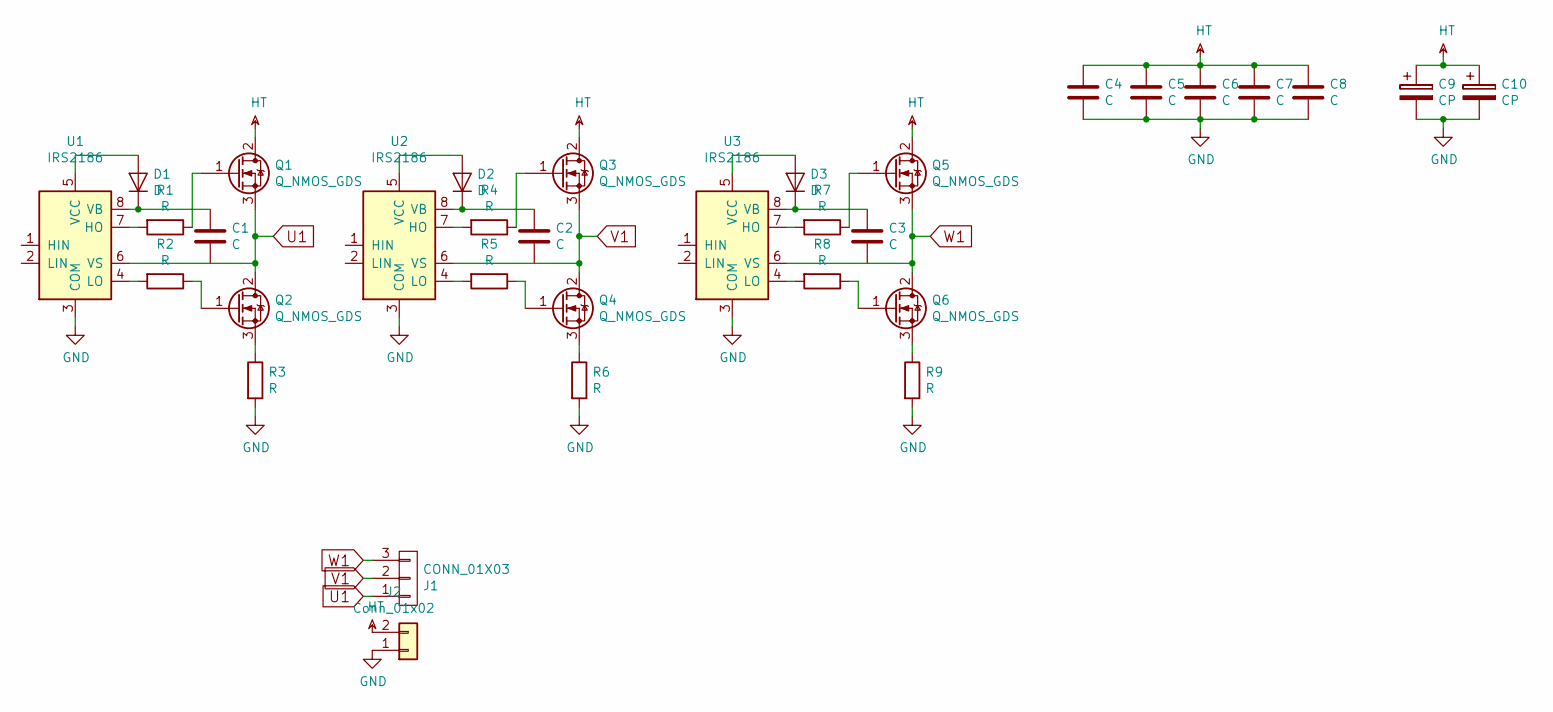
[picture p60: schematic trollerv2.sch]

Parts:
C1, C2, C3, C4, C5, C6, C7, C8: C; C_1210
C9, C10: CP; C_Radial_D26_L45_P10
D1, D2, D3: D; D_SMA
J1: CONN_01X03; RM5.08_1x3
J2: Conn_01x02; RM5.08_1x2
Q1, Q2, Q3, Q4, Q5, Q6: Q_NMOS_GDS; TO-263-2
R1, R2, R4, R5, R7, R8: R; R_1206
R3, R6, R9: R; R_2010
U1, U2, U3: IRS2186; SOIC-8_3.9x4.9mm_Pitch1.27mm

Connections:
GND: C4.2, C5.2, C6.2, C7.2, C8.2, C9.2, C10.2, J2.1, R3.2, R6.2, R9.2, U1.3 (COM), U2.3 (COM), U3.3 (COM)
HT: C4.1, C5.1, C6.1, C7.1, C8.1, C9.1, C10.1, J2.2, Q1.2 (D), Q3.2 (D), Q5.2 (D)
unnamed: C1.1, D1.1 (K), U1.8 (VB)
unnamed: C2.1, D2.1 (K), U2.8 (VB)
unnamed: C3.1, D3.1 (K), U3.8 (VB)
unnamed: D1.2 (A), U1.5 (VCC)
unnamed: D2.2 (A), U2.5 (VCC)
unnamed: D3.2 (A), U3.5 (VCC)
unnamed: Q1.1 (G), R1.1
unnamed: Q2.1 (G), R2.1
unnamed: Q2.3 (S), R3.1
unnamed: Q3.1 (G), R4.1
unnamed: Q4.1 (G), R5.1
unnamed: Q4.3 (S), R6.1
unnamed: Q5.1 (G), R7.1
unnamed: Q6.1 (G), R8.1
unnamed: Q6.3 (S), R9.1
unnamed: R1.2, U1.7 (HO)
unnamed: R2.2, U1.4 (LO)
unnamed: R4.2, U2.7 (HO)
unnamed: R5.2, U2.4 (LO)
unnamed: R7.2, U3.7 (HO)
unnamed: R8.2, U3.4 (LO)
U1: J1.1, Q1.3 (S), Q2.2 (D), U1.6 (VS)
V1: J1.2, Q3.3 (S), Q4.2 (D), U2.6 (VS)
W1: J1.3, Q5.3 (S), Q6.2 (D), U3.6 (VS)

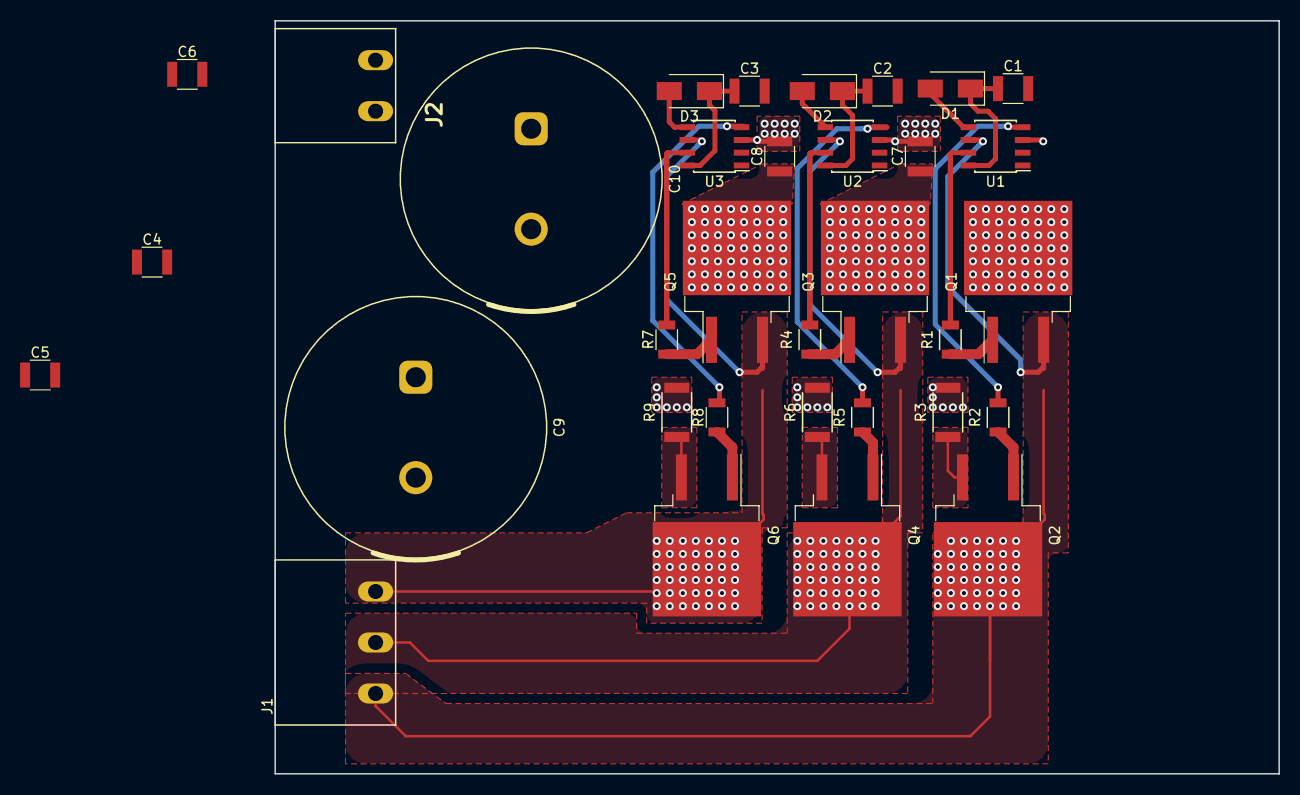
[picture p61: board trollerv2.kicad_pcb from above]

Board: 4 copper layers, 100.0 x 75.0 mm, 33 parts (0 on the bottom side), 26 nets.
