AndriesTuinhof/stmbl/hardware/old designs/kicad/rj45_breakout/rj45_breakout.kicad_pcb

## KiCad design hardware/old designs/kicad/rj45_breakout/rj45_breakout.kicad_pcb (2022-10-24, an earlier design)

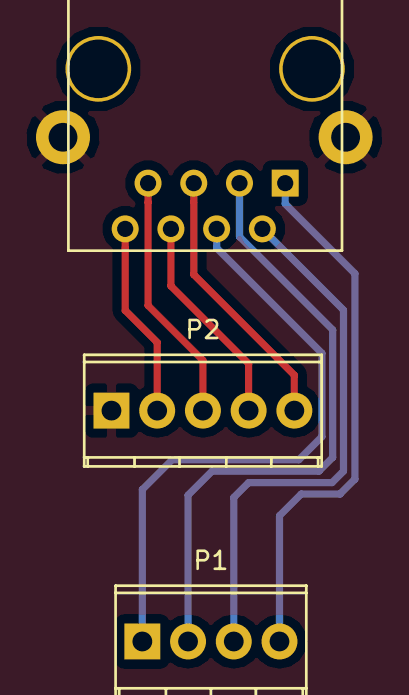
[picture p62: board rj45_breakout.kicad_pcb from above]

Board: 2 copper layers, 3 parts (0 on the bottom side), 9 nets.

Parts:
J1: RJ45; RJ45_8
P1: CONN_4; TerminalBlock_Pheonix_MPT-2.54mm_4pol
P2: CONN_5; TerminalBlock_Pheonix_MPT-2.54mm_5pol

Connections:
unnamed: J1.1, P1.4
unnamed: J1.2, P1.3
unnamed: J1.3, P1.2
unnamed: J1.4, P1.1
unnamed: J1.5, P2.5
unnamed: J1.6, P2.4
unnamed: J1.7, P2.3
unnamed: J1.8, P2.2
unnamed: J1.9, P2.1
