AndriesTuinhof/stmbl/hardware/old designs/kicad/de0bob/Bob.kicad_pcb

## KiCad design hardware/old designs/kicad/de0bob/Bob.kicad_pcb (2022-10-24, an earlier design)

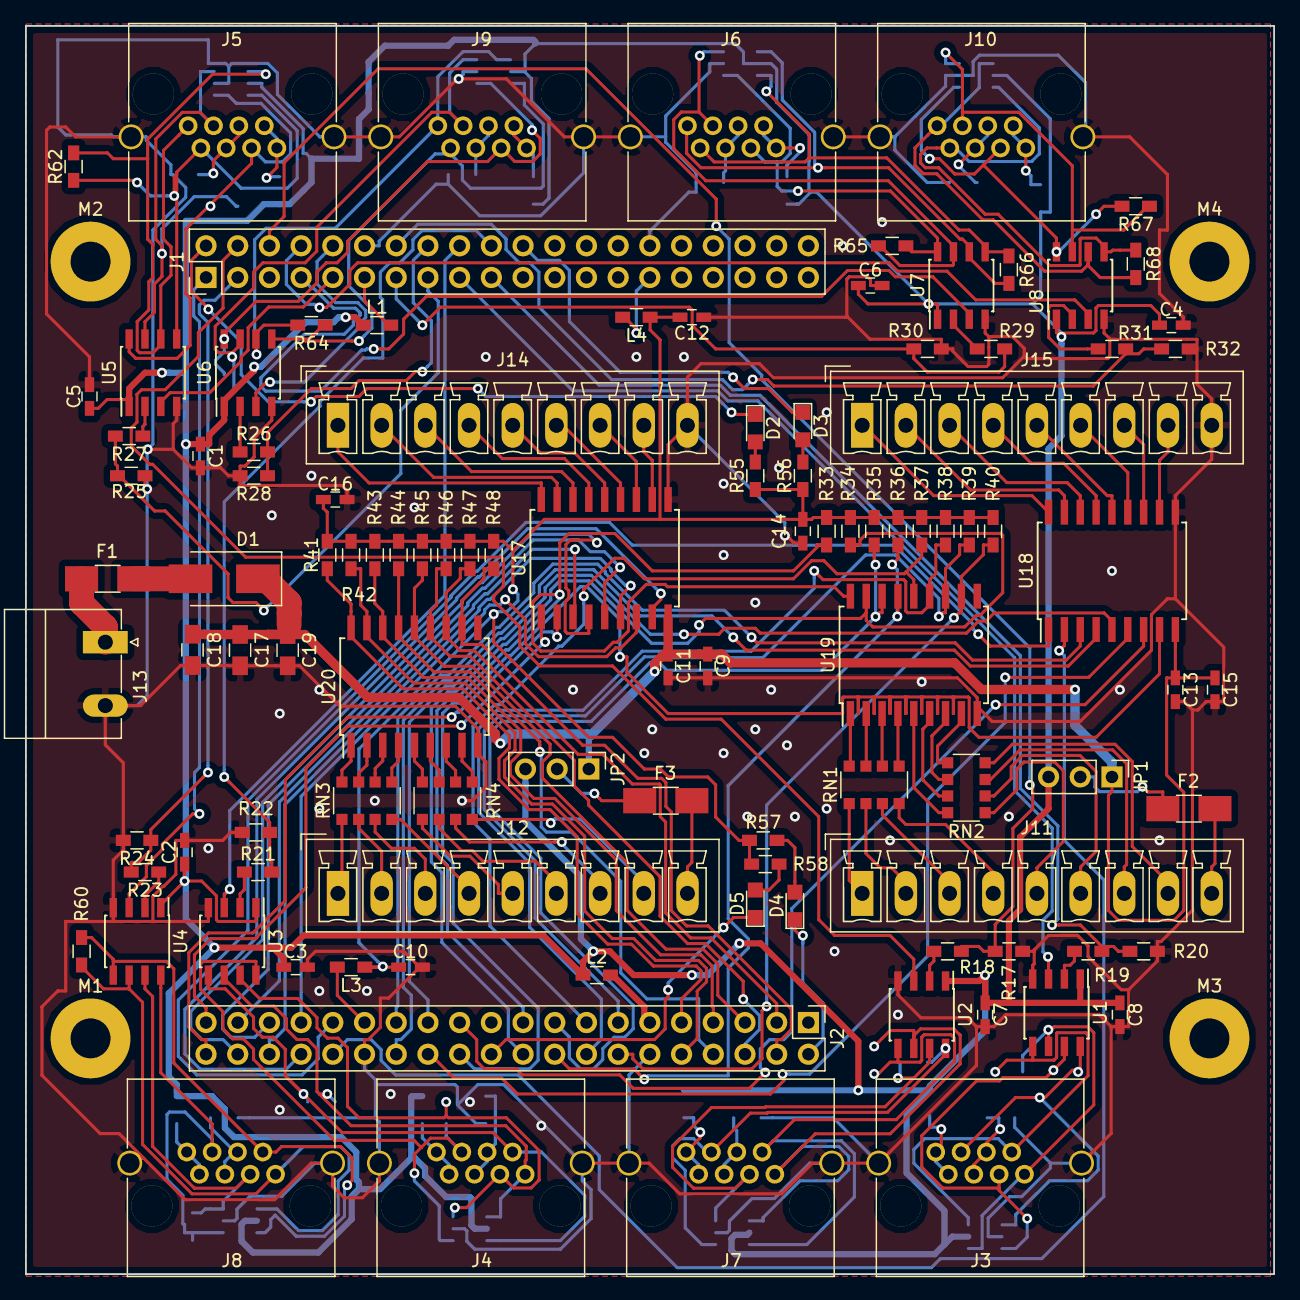
[picture p63: board Bob.kicad_pcb from above]

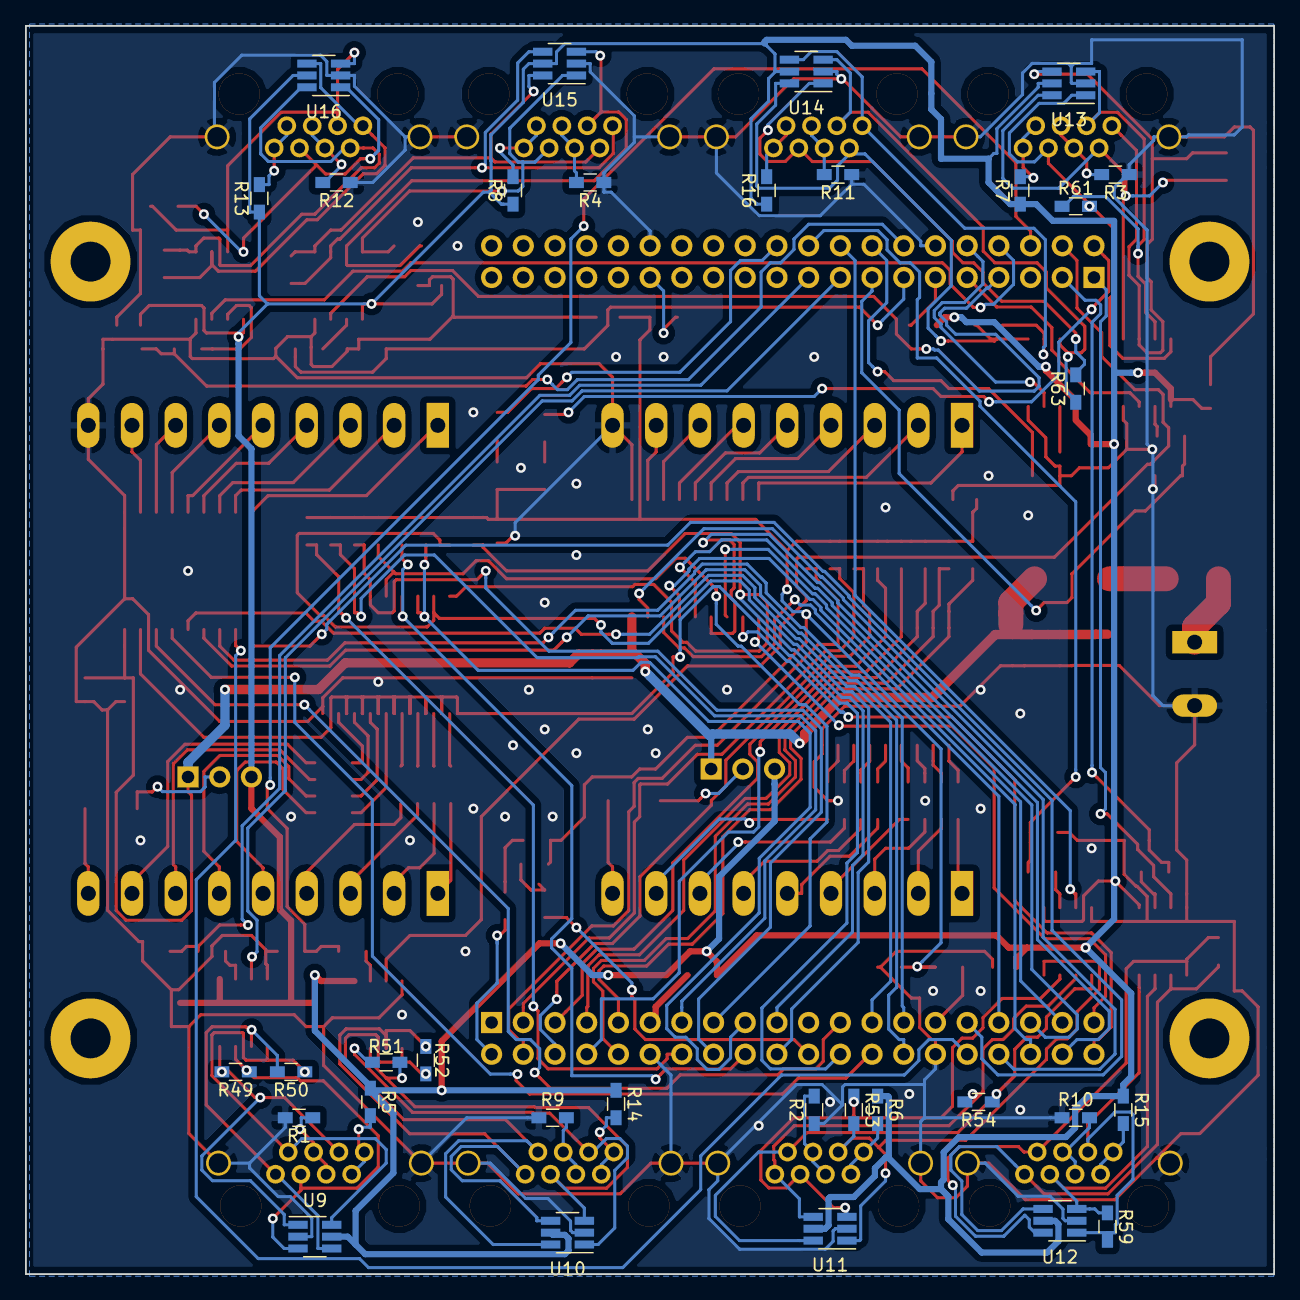
[picture p64: board Bob.kicad_pcb from below]

Board: 2 copper layers, 100.0 x 100.0 mm, 144 parts (33 on the bottom side), 174 nets.

Parts:
C1, C2, C3, C4, C5, C6, C7, C8, C9, C10, C11, C12, C13, C14, C15, C16: C; C_0603_HandSoldering
C17, C18, C19: C; C_0805_HandSoldering
D1: D; D_SMB_Handsoldering
D2, D3, D4, D5: LED; LED_0805
F1, F2, F3: Fuse; Fuse_SMD1206_HandSoldering
J1, J2: CONN_02X20; Pin_Header_Straight_2x20_Pitch2.54mm
J3, J4, J5, J6, J7, J8, J9, J10: RJ45
J11, J12, J14, J15: CONN_01X09; PhoenixContact_MCV-G_09x3.50mm_Vertical
J13: CONN_01X02; PhoenixContact_MC-G_02x5.08mm_Angled
JP1, JP2: Jumper_NC_Dual; Pin_Header_Straight_1x03_Pitch2.54mm
L1, L2, L3, L4: L_Small; R_0603_HandSoldering
M1, M2, M3, M4: MOUNT_3mm; MountingHole_3.2mm_M3_Pad
R1, R2, R5, R6, R9, R14: 0; R_0603_HandSoldering
R3, R4, R7, R8, R10, R11, R12, R13, R15, R16, R17, R18, R19, R20, R21, R22, R23, R24, R25, R26, R27, R28, R29, R30, R31, R32, R55, R56, R57, R58: R; R_0603_HandSoldering
R33, R34, R35, R36, R37, R38, R39, R40, R41, R42, R43, R44, R45, R46, R47, R48, R49, R50, R51, R52, R53, R54, R59, R60, R61, R62, R63, R64, R65, R66, R67, R68: 1k; R_0603_HandSoldering
RN1, RN2, RN3, RN4: R_Pack04; R_Array_Convex_4x1206
U1, U2, U3, U4, U5, U6, U7, U8: ADM4857; SOIC-8_3.9x4.9mm_Pitch1.27mm
U9, U10, U11, U12, U13, U14, U15, U16: USBLC6-4SC6; SOT-23-6_Handsoldering
U17, U18: TBD62783A; SOIC-18W_7.5x11.6mm_Pitch1.27mm
U19, U20: ULN2803ADWR; SOIC-18W_7.5x11.6mm_Pitch1.27mm

Connections:
+3V3: C10.1, C12.1, C14.1, C16.1, L3.1, L4.1, R33.1, R34.1, R35.1, R36.1, R37.1, R38.1, R39.1, R40.1, R41.1, R42.1, R43.1, R44.1, R45.1, R46.1, R47.1, R48.1, R55.1, R56.1, R57.1, R58.1
+5V: C1.1, C2.1, C3.1, C4.1, C5.1, C6.1, C7.1, C8.1, JP1.3, JP2.3, L1.1, L2.1, R5.1, R6.1, R7.1, R8.1, R13.1, R14.1, R15.1, R16.1, U1.1, U2.1, U3.1, U4.1, U5.1, U6.1, U7.1, U8.1, U9.5, U10.5, U11.5, U12.5, U13.5, U14.5, U15.5, U16.5
+24V: C9.1, C11.1, C13.1, C15.1, C17.1, C18.1, C19.1, D1.1, JP1.1, JP2.1, U17.9, U18.9
GND: C1.2, C2.2, C3.2, C4.2, C5.2, C6.2, C7.2, C8.2, C9.2, C10.2, C11.2, C12.2, C13.2, C14.2, C15.2, C16.2, C17.2, C18.2, C19.2, J1.12, J1.30, J2.12, J2.30, J3.9, J4.9, J5.9, J6.9, J7.9, J8.9, J9.9, J10.9, J13.2, J14.9, J15.9, R1.2, R2.1, R3.1, R4.1, R9.1, R10.1, R11.1, R12.1, R17.2, R20.2, R22.2, R24.2, R25.2, R28.2, R30.2, R32.2, U1.4, U2.4, U3.4, U4.4, U5.4, U6.4, U7.4, U8.4, U9.2, U10.2, U11.2, U12.2, U13.2, U14.2, U15.2, U16.2, U17.10, U18.10, U19.9, U20.9
J1B0: J1.19, R19.2, R20.1
J1B1: J1.20, R21.2, R22.1
J1B2: J1.17, U1.3
J1B3: J1.18, U3.3
J1B4: J1.15, R25.1, R27.2
J1B5: J1.16, R26.2, R28.1
J1B6: J1.13, R29.2, R30.1
J1B7: J1.14, R31.2, R32.1
J1B8: J1.9, U5.3
J1B9: J1.10, U6.3
J1B10: J1.7, U7.3
J1B11: J1.8, U8.3
J1B13: J1.6, R17.1, R18.2
J1B14: J1.3, R23.2, R24.1
J1B15: J1.4, U2.3
J1B16: J1.1, U4.3
J3B0: J2.19, R33.2, U19.18
J3B1: J2.20, R34.2, U19.17
J3B2: J2.17, R35.2, U19.16
J3B3: J2.18, R36.2, U19.15
J3B4: J2.15, R37.2, U19.14
J3B5: J2.16, R38.2, U19.13
J3B6: J2.13, R39.2, U19.12
J3B7: J2.14, R40.2, U19.11
J3B8: J2.9, R41.2, U20.18
J3B9: J2.10, R42.2, U20.17
J3B10: J2.7, R43.2, U20.16
J3B11: J2.8, R44.2, U20.15
J3B12: J2.5, R45.2, U20.14
J3B13: J2.6, R46.2, U20.13
J3B14: J2.3, R47.2, U20.12
J3B15: J2.4, R48.2, U20.11
J4B0: J2.39, U17.1
J4B1: J2.40, U17.2
J4B2: J2.37, U17.3
J4B3: J2.38, U17.4
J4B4: J2.35, U17.5
J4B5: J2.36, U17.6
J4B6: J2.33, U17.7
J4B7: J2.34, U17.8
J4B8: J2.31, U18.1
J4B9: J2.32, U18.2
J4B10: J2.27, U18.3
J4B11: J2.28, U18.4
J4B12: J2.25, U18.5
J4B13: J2.26, U18.6
J4B14: J2.23, U18.7
J4B15: J2.24, U18.8
LED0: D2.1, J1.2
LED1: D3.1, J1.22
LED2: D4.1, J2.2
LED3: D5.1, J2.22
NRX0: J3.3, R49.1, U1.7, U9.3
NRX1: J7.3, R51.1, U2.7, U10.3
NRX2: J4.3, R53.1, U3.7, U11.3
NRX3: J8.3, R59.1, U4.7, U12.3
NRX4: J5.3, R61.1, U5.7, U13.3
NRX5: J9.3, R63.1, U6.7, U14.3
NRX6: J6.3, R65.1, U7.7, U15.3
NRX7: J10.3, R67.1, U8.7, U16.3
NTX0: J3.1, R50.2, U1.6, U9.4
NTX1: J7.1, R52.2, U2.6, U10.4
NTX2: J4.1, R54.2, U3.6, U11.4
NTX3: J8.1, R60.2, U4.6, U12.4
NTX4: J5.1, R62.2, U5.6, U13.4
NTX5: J9.1, R64.2, U6.6, U14.4
NTX6: J6.1, R66.2, U7.6, U15.4
NTX7: J10.1, R68.2, U8.6, U16.4
unnamed: D1.2, F1.2
unnamed: D2.2, R55.2
unnamed: D3.2, R56.2
unnamed: D4.2, R57.2
unnamed: D5.2, R58.2
unnamed: F1.1, J13.1
unnamed: F2.1, JP1.2
unnamed: F2.2, J11.9
unnamed: F3.1, JP2.2
unnamed: F3.2, J12.9
unnamed: J1.11, L1.2
unnamed: J1.29, L4.2
unnamed: J2.11, L2.2
unnamed: J2.29, L3.2
unnamed: J3.4, J3.5, R1.1
unnamed: J3.7, J3.8, R5.2
unnamed: J4.4, J4.5, R2.2
unnamed: J4.7, J4.8, R6.2
unnamed: J5.4, J5.5, R3.2
unnamed: J5.7, J5.8, R7.2
unnamed: J6.4, J6.5, R4.2
unnamed: J6.7, J6.8, R8.2
unnamed: J7.4, J7.5, R9.2
unnamed: J7.7, J7.8, R14.2
unnamed: J8.4, J8.5, R10.2
unnamed: J8.7, J8.8, R15.2
unnamed: J9.4, J9.5, R11.2
unnamed: J9.7, J9.8, R16.2
unnamed: J10.4, J10.5, R12.2
unnamed: J10.7, J10.8, R13.2
unnamed: J11.1, RN1.1
unnamed: J11.2, RN1.2
unnamed: J11.3, RN1.3
unnamed: J11.4, RN1.4
unnamed: J11.5, RN2.1
unnamed: J11.6, RN2.2
unnamed: J11.7, RN2.3
unnamed: J11.8, RN2.4
unnamed: J12.1, RN3.1
unnamed: J12.2, RN3.2
unnamed: J12.3, RN3.3
unnamed: J12.4, RN3.4
unnamed: J12.5, RN4.1
unnamed: J12.6, RN4.2
unnamed: J12.7, RN4.3
unnamed: J12.8, RN4.4
unnamed: J14.1, U17.18
unnamed: J14.2, U17.17
unnamed: J14.3, U17.16
unnamed: J14.4, U17.15
unnamed: J14.5, U17.14
unnamed: J14.6, U17.13
unnamed: J14.7, U17.12
unnamed: J14.8, U17.11
unnamed: J15.1, U18.18
unnamed: J15.2, U18.17
unnamed: J15.3, U18.16
unnamed: J15.4, U18.15
unnamed: J15.5, U18.14
unnamed: J15.6, U18.13
unnamed: J15.7, U18.12
unnamed: J15.8, U18.11
unnamed: R18.1, U2.2
unnamed: R19.1, U1.2
unnamed: R21.1, U3.2
unnamed: R23.1, U4.2
unnamed: R26.1, U6.2
unnamed: R27.1, U5.2
unnamed: R29.1, U7.2
unnamed: R31.1, U8.2
unnamed: RN1.5, U19.4
unnamed: RN1.6, U19.3
unnamed: RN1.7, U19.2
unnamed: RN1.8, U19.1
unnamed: RN2.5, U19.8
unnamed: RN2.6, U19.7
unnamed: RN2.7, U19.6
unnamed: RN2.8, U19.5
unnamed: RN3.5, U20.4
unnamed: RN3.6, U20.3
unnamed: RN3.7, U20.2
unnamed: RN3.8, U20.1
unnamed: RN4.5, U20.8
unnamed: RN4.6, U20.7
unnamed: RN4.7, U20.6
unnamed: RN4.8, U20.5
RX0: J3.6, R49.2, U1.8, U9.1
RX1: J7.6, R51.2, U2.8, U10.1
RX2: J4.6, R53.2, U3.8, U11.1
RX3: J8.6, R59.2, U4.8, U12.1
RX4: J5.6, R61.2, U5.8, U13.1
RX5: J9.6, R63.2, U6.8, U14.1
RX6: J6.6, R65.2, U7.8, U15.1
RX7: J10.6, R67.2, U8.8, U16.1
TX0: J3.2, R50.1, U1.5, U9.6
TX1: J7.2, R52.1, U2.5, U10.6
TX2: J4.2, R54.1, U3.5, U11.6
TX3: J8.2, R60.1, U4.5, U12.6
TX4: J5.2, R62.1, U5.5, U13.6
TX5: J9.2, R64.1, U6.5, U14.6
TX6: J6.2, R66.1, U7.5, U15.6
TX7: J10.2, R68.1, U8.5, U16.6
