AndriesTuinhof/stmbl/hardware/old designs/kicad/rectifier2/rectifier.kicad_pcb

## KiCad design hardware/old designs/kicad/rectifier2/rectifier.kicad_pcb (2022-10-24, an earlier design)

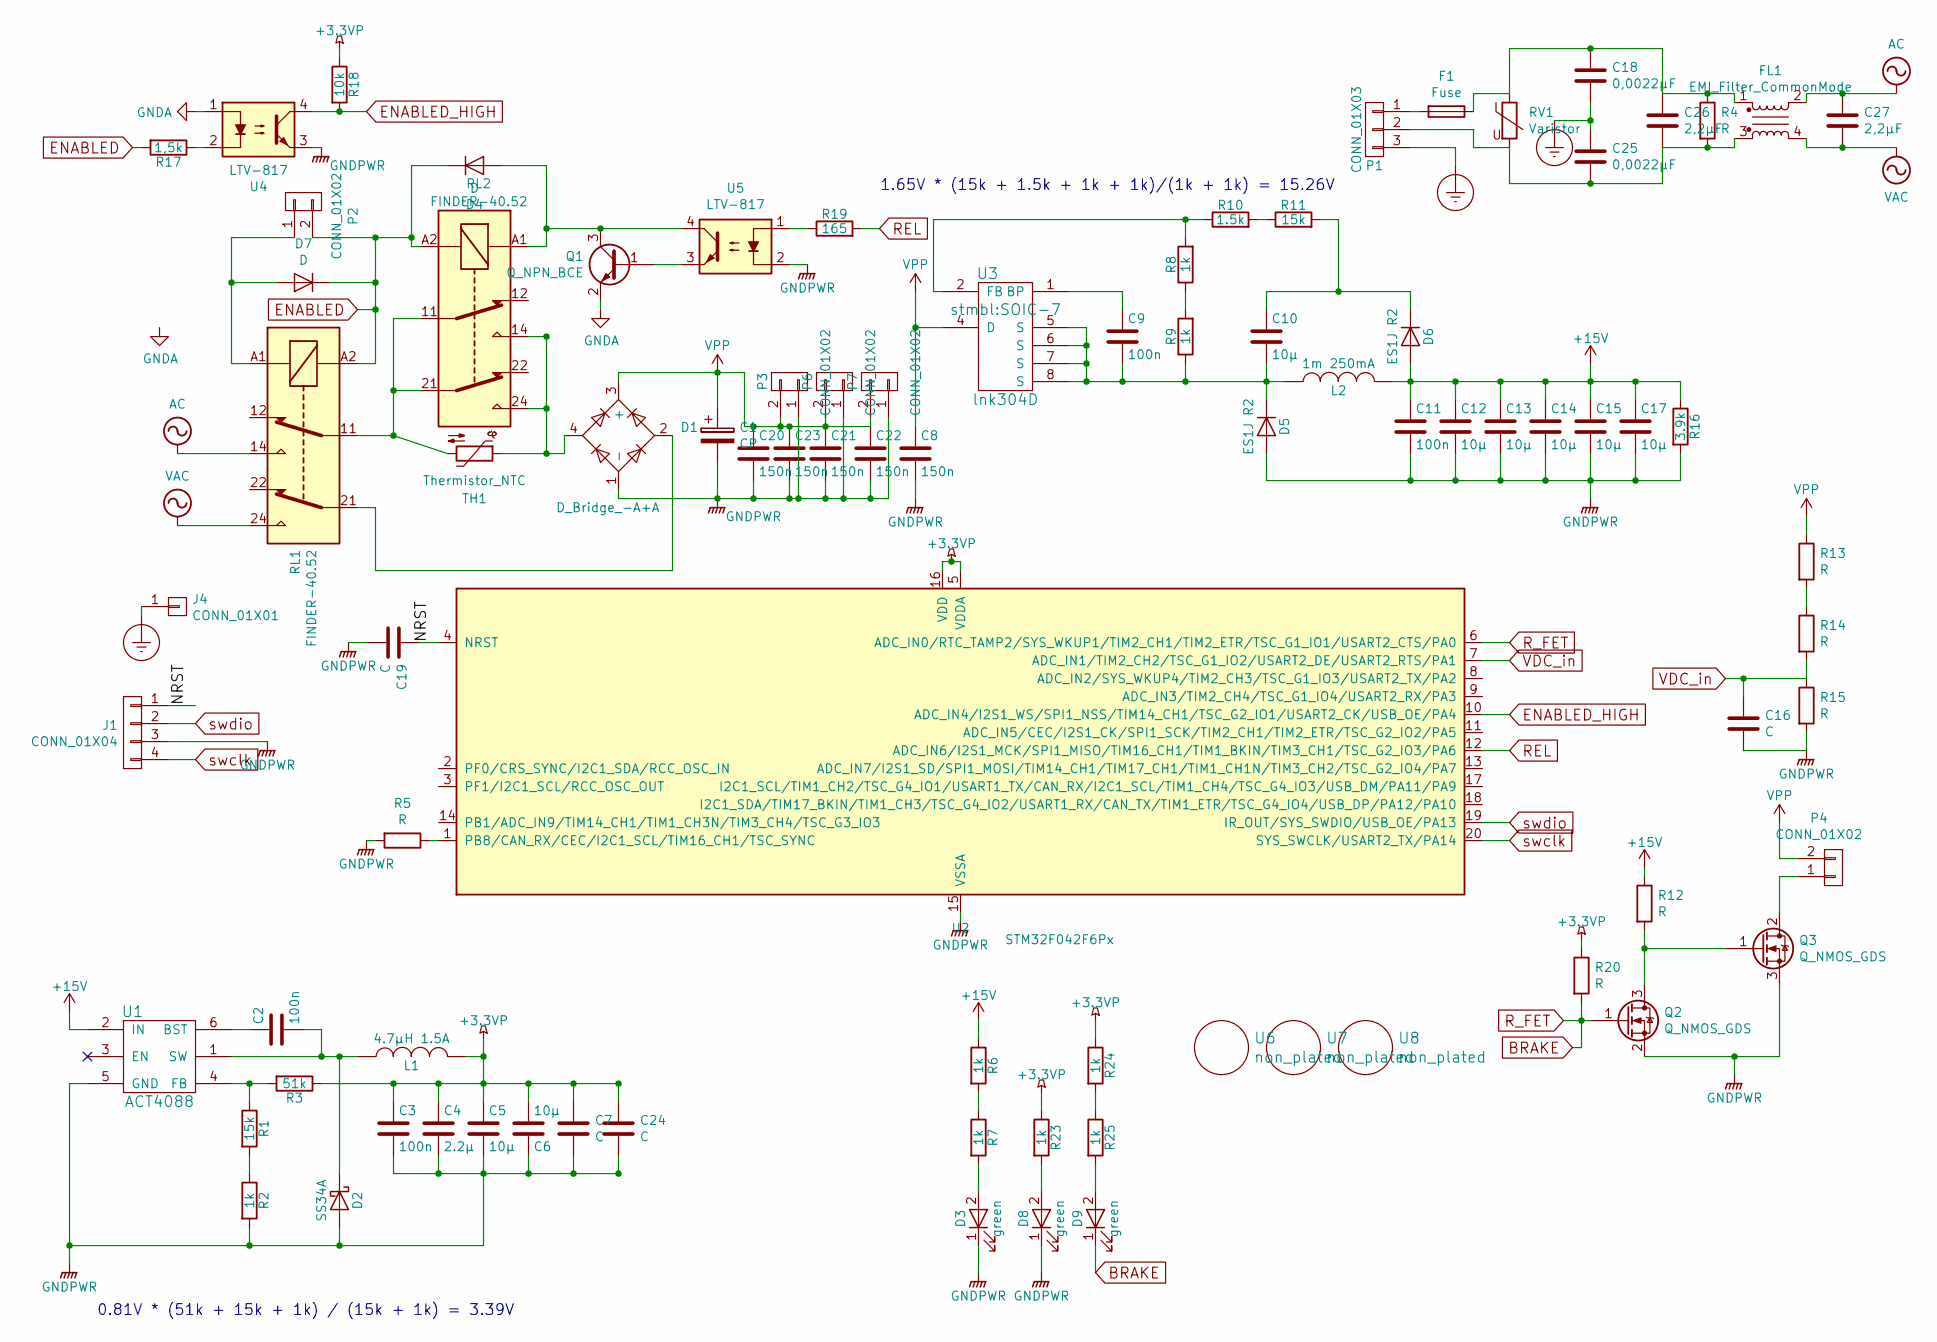
[picture p65: schematic rectifier.sch]

Parts:
C1: CP; C_Radial_D26_L31_P10
C2, C3: 100n; C_0603
C4: 2.2µ; C_0603; Voltage 25V
C5, C6, C12, C13, C14, C15, C17: 10µ; C_0805; Voltage 6.3V
C7, C16, C19, C24: C; C_0603
C8, C20, C21, C22, C23: 150n; C_1808
C9, C11: 100n; C_0603; Voltage 25V
C10: 10µ; C_0805; Voltage 25V
C18, C25: 0,0022µF; C_Rect_L18.0mm_W7.0mm_P15.00mm_FKS3_FKP3
C26, C27: 2,2µF; C_Rect_L31.5mm_W15.0mm_P27.50mm_MKS4; Part No EPCOS/TDK B32924C3225M
D1: D_Bridge_-A+A; dfb_bridge
D2: SS34A; SMA_Standard
D3, D8, D9: green; LED-0805-SIDE
D4, D7: D; SMA_Standard
D5, D6: ES1J R2; SMA_Standard
F1: Fuse; Fuseholder5x20_horiz_SemiClosed_Casing10x25mm
FL1: EMI_Filter_CommonMode; 7448061507
J1: CONN_01X04; Pin_Header_Straight_1x04
J4: CONN_01X01; MountingHole_3.2mm_M3
L1: 4.7µH 1.5A; SMD_INDUCTOR_32x25
L2: 1m 250mA; NPI31W
P1: CONN_01X03; RM5.08_1x3
P2: CONN_01X02; akl182-2
P3, P4, P6, P7: CONN_01X02; RM5.08_1x2
Q1: Q_NPN_BCE; SOT-23
Q2: Q_NMOS_GDS; SOT-23
Q3: Q_NMOS_GDS; TO-247_Horizontal_Neutral123_largePads
R1, R11: 15k; R_0603
R2, R6, R7, R8, R9, R23, R24, R25: 1k; R_0603
R3: 51k; R_0603
R4: R
R5, R12, R15, R20: R; R_0603
R10: 1.5k; R_0603
R13, R14: R; R_1206
R16: 3.9k; R_0603
R17: 1,5k; R_0603
R18: 10k; R_0603
R19: 165; R_0603
RL1, RL2: FINDER-40.52; Relay_DPDT_Schrack-RT2_RM5mm
RV1: Varistor; RV_Disc_D15.5_W5.4_P7.5
TH1: Thermistor_NTC; RV_Disc_D21.5_W6.1_P7.5
U1: ACT4088; SOT-23-6
U2: STM32F042F6Px; TSSOP-20_4.4x6.5mm_Pitch0.65mm
U3: lnk304D; SOIC-7
U4, U5: LTV-817; Optocoupler_SMD_HandSoldering_KPC357_LTV35x_PC357_SingleCha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
U6, U7, U8: non_plated; MountingHole_3.2mm_M3

Connections:
+3.3VP: C3.1, C4.1, C5.1, C6.2, C7.1, C24.1, L1.2, R3.1, R18.1, R20.1, R23.1, R24.1, U2.5 (VDDA), U2.16 (VDD)
+15V: C11.1, C12.1, C13.1, C14.1, C15.1, C17.1, D6.2 (A), L2.2, R6.1, R12.1, R16.1, U1.2 (IN)
/NRST: C19.1, J1.1, U2.4 (NRST)
AC: C27.1, FL1.2, RL1.14
BRAKE: D9.1 (K), Q2.1 (G), R20.2, U2.6 (ADC_IN0/RTC_TAMP2/SYS_WKUP1/TIM2_CH1/TI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)
ENABLED: D4.1 (K), D7.1 (K), P2.2, R17.2, RL1.A2, RL2.A2
ENABLED_HIGH: R18.2, U2.10 (ADC_IN4/I2S1_WS/SPI1_NSS/TIM14_CH1/TSC_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), U4.4
Earth_Protective: C18.2, C25.1, J4.1, P1.3
GNDA: Q1.2 (E), U4.1
GNDPWR: C1.2, C3.2, C4.2, C5.2, C6.1, C7.2, C8.2, C11.2, C12.2, C13.2, C14.2, C15.2, C16.2, C17.2, C19.2, C20.2, C21.2, C22.2, C23.2, C24.2, D1.1 (-), D2.2 (A), D3.1 (K), D5.2 (A), D8.1 (K), J1.3, P3.1, P6.1, P7.1, Q2.2 (S), Q3.3 (S), R2.2, R5.2, R15.2, R16.2, U1.5 (GND), U2.15 (VSSA), U4.3, U5.2
unnamed: C2.1, U1.6 (BST)
unnamed: C2.2, D2.1 (K), L1.1, U1.1 (SW)
unnamed: C9.1, U3.1 (BP)
unnamed: C10.1, D6.1 (K), R11.2
unnamed: C9.2, C10.2, D5.1 (K), L2.1, R9.1, U3.5 (S), U3.6 (S), U3.7 (S), U3.8 (S)
unnamed: C18.1, C26.1, F1.1, FL1.1, R4.1, RV1.1
unnamed: C25.2, C26.2, FL1.3, P1.2, R4.2, RV1.2
unnamed: D1.2, RL1.21
unnamed: D1.4, RL2.14, RL2.24, TH1.1
unnamed: D3.2 (A), R7.2
unnamed: D4.2 (A), Q1.3 (C), RL2.A1, U5.4
unnamed: D7.2 (A), P2.1, RL1.A1
unnamed: D8.2 (A), R23.2
unnamed: D9.2 (A), R25.2
unnamed: F1.2, P1.1
unnamed: P4.1, Q3.2 (D)
unnamed: Q1.1 (B), U5.3
unnamed: Q2.3 (D), Q3.1 (G), R12.2
unnamed: R1.1, R3.2, U1.4 (FB)
unnamed: R1.2, R2.1
unnamed: R5.1, U2.1 (PB8/CAN_RX/CEC/I2C1_SCL/TIM16_CH1/TSC_S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)
unnamed: R6.2, R7.1
unnamed: R8.1, R9.2
unnamed: R8.2, R10.1, U3.2 (FB)
unnamed: R10.2, R11.1
unnamed: R13.2, R14.1
unnamed: R17.1, U4.2
unnamed: R19.1, U5.1
unnamed: R24.2, R25.1
unnamed: RL1.11, RL2.11, RL2.21, TH1.2
REL: R19.2, U2.12 (ADC_IN6/I2S1_MCK/SPI1_MISO/TIM16_CH1/TI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)
VAC: C27.2, FL1.4, RL1.24
VDC_in: C16.1, R14.2, R15.1, U2.7 (ADC_IN1/TIM2_CH2/TSC_G1_IO2/USART2_DE/U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)
VPP: C1.1, C8.1, C20.1, C21.1, C22.1, C23.1, D1.3 (+), P3.2, P4.2, P6.2, P7.2, R13.1, U3.4 (D)
swclk: J1.4, U2.20 (SYS_SWCLK/USART2_TX/PA14)
swdio: J1.2, U2.19 (IR_OUT/SYS_SWDIO/USB_OE/PA13)

Notes on the sheet:
0.81V * (51k + 15k + 1k) / (15k + 1k) = 3.39V
1.65V * (15k + 1.5k + 1k + 1k)/(1k + 1k) = 15.26V

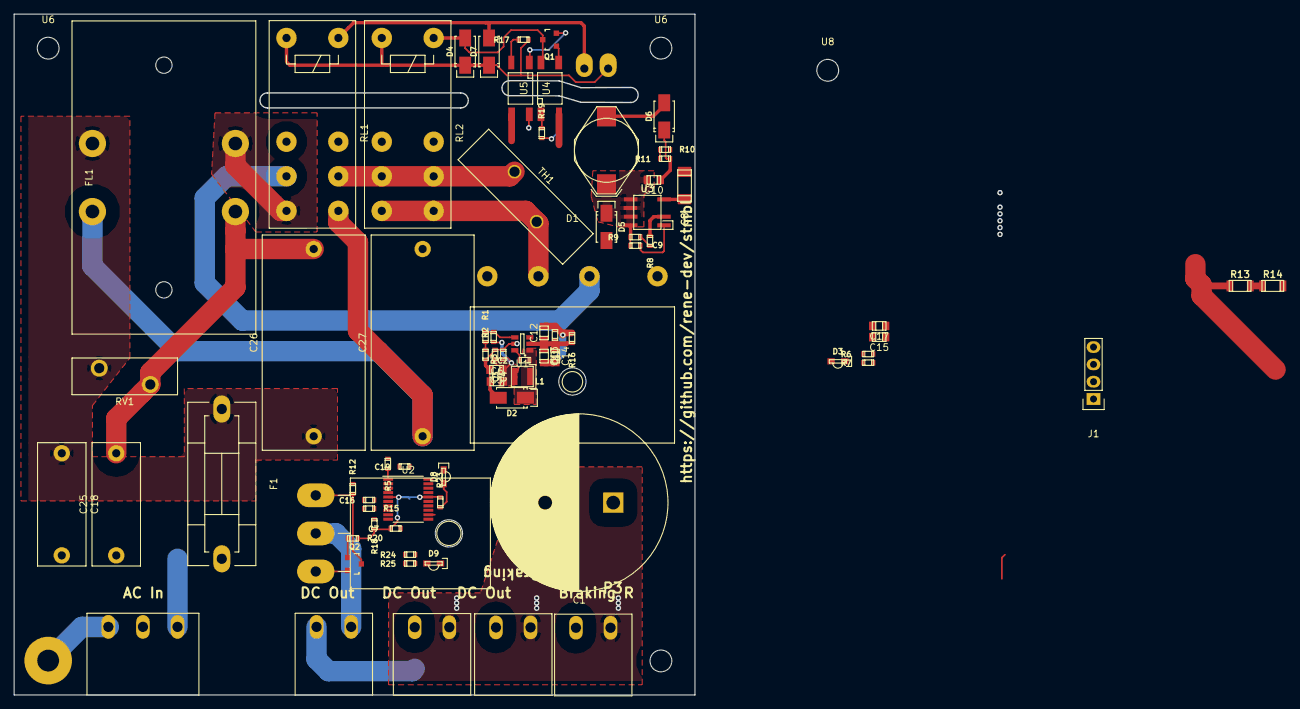
[picture p66: board hardware/old designs/kicad/rectifier2/rectifier.kicad_pcb from above]

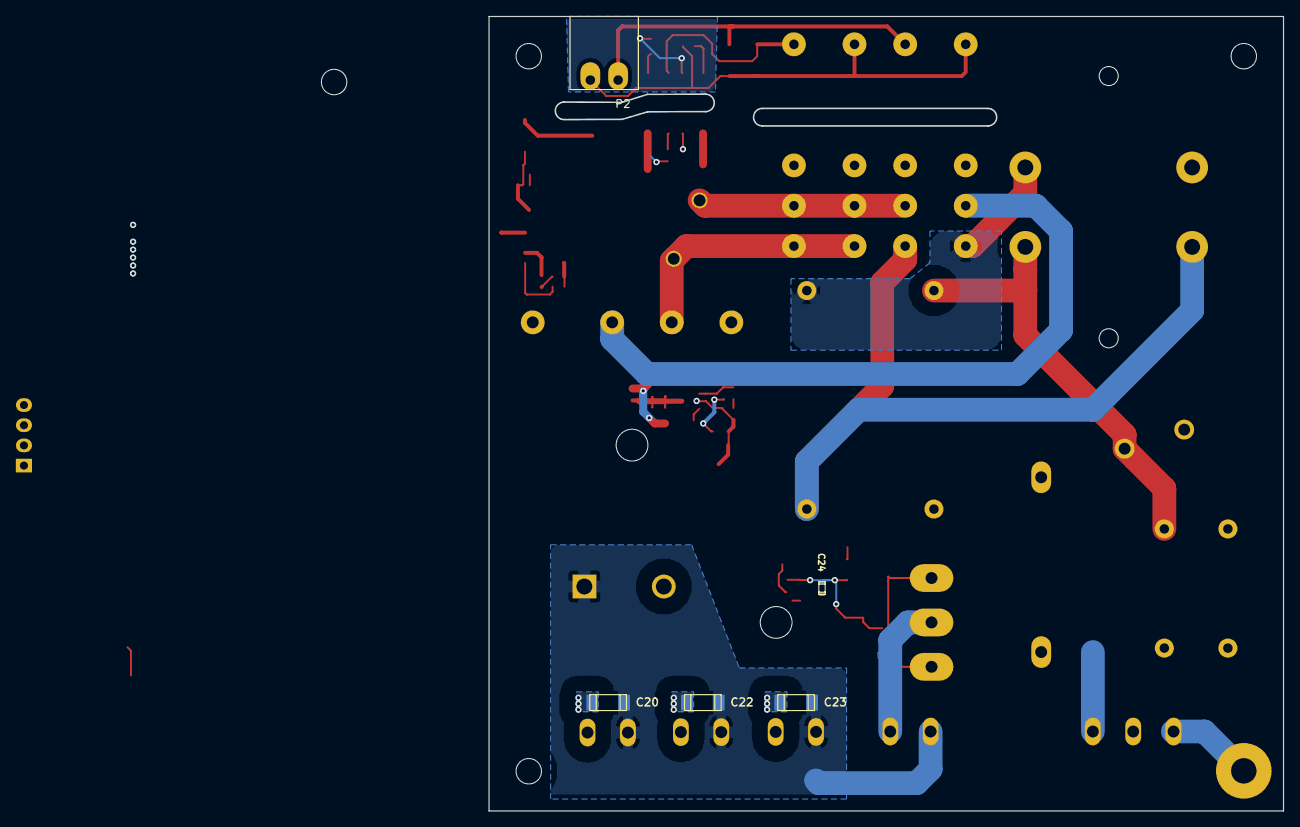
[picture p67: board hardware/old designs/kicad/rectifier2/rectifier.kicad_pcb from below]

Board: 2 copper layers, 100.0 x 100.0 mm, 85 parts (5 on the bottom side), 46 nets.

Other parts of the board:
U6#2: non_plated; MountingHole_3.2mm_M3
