AndriesTuinhof/stmbl/hardware/old designs/kicad/bob/ethernet_bob/io_base/io_base.kicad_pcb

## KiCad design hardware/old designs/kicad/bob/ethernet_bob/io_base/io_base.kicad_pcb (2022-10-24, an earlier design)

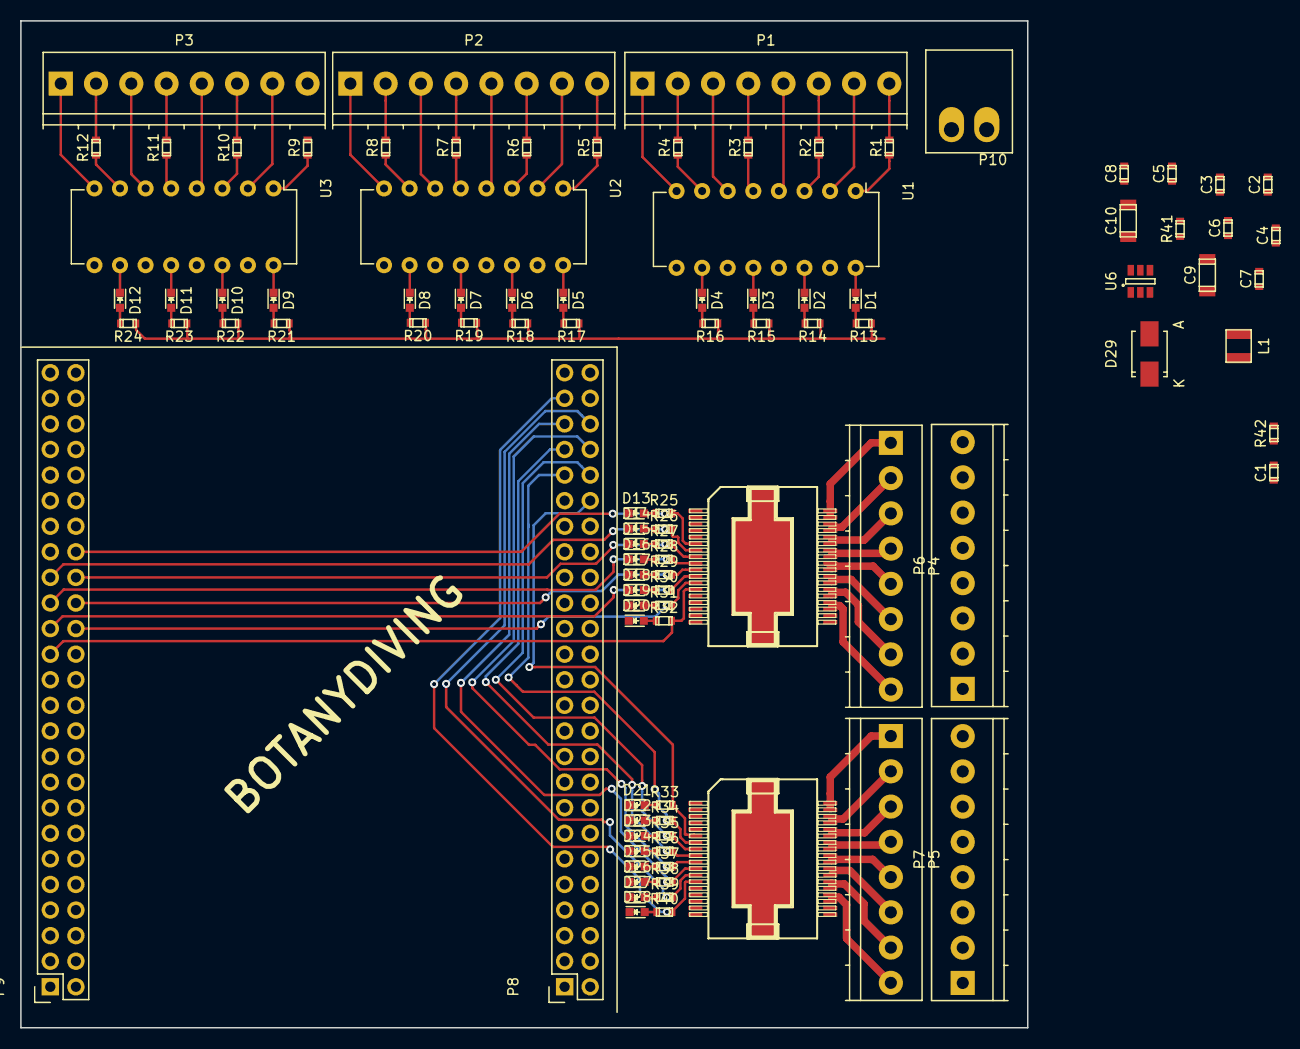
[picture p68: board io_base.kicad_pcb from above]

Board: 2 copper layers, 99.9 x 99.9 mm, 98 parts (0 on the bottom side), 115 nets.

Parts:
C1, C2, C3, C4, C5, C6, C7, C8: 100n; C_0603
C9, C10: 10µ; C_1206
D1, D2, D3, D4, D5, D6, D7, D8, D9, D10, D11, D12, D13, D14, D15, D16, D17, D18, D19, D20, D21, D22, D23, D24, D25, D26, D27, D28: LED; LED_0603
D29: B240A; SMA_Standard
L1: 4.7µH 1.5A; SMD_INDUCTOR_32x25
P1, P2, P3, P4, P5, P6, P7: CONN_01X08; TerminalBlock_Pheonix_PT-3.5mm_8pol
P8, P9: CONN_02X25; Socket_Strip_Straight_2x25
P10: CONN_01X02; akl182-2
R1, R2, R3, R4, R5, R6, R7, R8, R9, R10, R11, R12, R13, R14, R15, R16, R17, R18, R19, R20, R21, R22, R23, R24, R25, R26, R27, R28, R29, R30, R31, R32, R33, R34, R35, R36, R37, R38, R39, R40: R; R_0603
R41: 10k; R_0603
R42: 50k; R_0603
U1, U2, U3: OPTO-TRANSISTOR-4; DIP-16_W7.62mm
U4, U5: VN808; POWERSO36
U6: ACT4088; SOT-23-6

Connections:
+3V3: P8.3, P8.4, P9.5, P9.6, P9.22, R13.1, R14.1, R15.1, R16.1, R17.1, R18.1, R19.1, R20.1, R21.1, R22.1, R23.1, R24.1
+5V: C8.1, C9.1, C10.1, L1.2, P9.3, P9.4, R42.1
+24V: C1.1, C2.1, C3.1, C4.1, C5.1, C6.1, P10.2, U4.1, U5.1, U6.2
GND: C1.2, C2.2, C3.2, C4.2, C5.2, C6.2, C8.2, C9.2, C10.2, D13.1, D14.1, D15.1, D16.1, D17.1, D18.1, D19.1, D20.1, D21.1, D22.1, D23.1, D24.1, D25.1, D26.1, D27.1, D28.1, D29.2, P6.1, P6.2, P6.3, P6.4, P6.5, P6.6, P6.7, P6.8, P7.1, P7.2, P7.3, P7.4, P7.5, P7.6, P7.7, P7.8, P8.1, P8.2, P8.5, P8.23, P8.49, P8.50, P9.1, P9.2, P9.49, P9.50, P10.1, R41.2, U1.9, U1.11, U1.13, U1.15, U2.9, U2.11, U2.13, U2.15, U3.9, U3.11, U3.13, U3.15, U4.19, U5.19, U6.5
IN1: D1.1, P9.16, U1.16
IN2: D2.1, P8.26, U1.14
IN3: D3.1, P8.25, U1.12
IN4: D4.1, P8.28, U1.10
IN5: D5.1, P8.27, U2.16
IN6: D6.1, P8.30, U2.14
IN7: D7.1, P8.29, U2.12
IN8: D8.1, P8.32, U2.10
IN9: D9.1, P8.31, U3.16
IN10: D10.1, P9.13, U3.14
IN11: D11.1, P8.33, U3.12
IN12: D12.1, P9.11, U3.10
unnamed: C7.1, U6.6
unnamed: C7.2, D29.1, L1.1, U6.1
unnamed: D1.2, R13.2
unnamed: D2.2, R14.2
unnamed: D3.2, R15.2
unnamed: D4.2, R16.2
unnamed: D5.2, R17.2
unnamed: D6.2, R18.2
unnamed: D7.2, R19.2
unnamed: D8.2, R20.2
unnamed: D9.2, R21.2
unnamed: D10.2, R22.2
unnamed: D11.2, R23.2
unnamed: D12.2, R24.2
unnamed: D13.2, R25.1
unnamed: D14.2, R26.1
unnamed: D15.2, R27.1
unnamed: D16.2, R28.1
unnamed: D17.2, R29.1
unnamed: D18.2, R30.1
unnamed: D19.2, R31.1
unnamed: D20.2, R32.1
unnamed: D21.2, R33.1
unnamed: D22.2, R34.1
unnamed: D23.2, R35.1
unnamed: D24.2, R36.1
unnamed: D25.2, R37.1
unnamed: D26.2, R38.1
unnamed: D27.2, R39.1
unnamed: D28.2, R40.1
unnamed: P1.1, U1.8
unnamed: P1.2, R4.2
unnamed: P1.3, U1.6
unnamed: P1.4, R3.2
unnamed: P1.5, U1.4
unnamed: P1.6, R2.2
unnamed: P1.7, U1.2
unnamed: P1.8, R1.2
unnamed: P2.1, U2.8
unnamed: P2.2, R8.2
unnamed: P2.3, U2.6
unnamed: P2.4, R7.2
unnamed: P2.5, U2.4
unnamed: P2.6, R6.2
unnamed: P2.7, U2.2
unnamed: P2.8, R5.2
unnamed: P3.1, U3.8
unnamed: P3.2, R12.2
unnamed: P3.3, U3.6
unnamed: P3.4, R11.2
unnamed: P3.5, U3.4
unnamed: P3.6, R10.2
unnamed: P3.7, U3.2
unnamed: P3.8, R9.2
unnamed: R1.1, U1.1
unnamed: R2.1, U1.3
unnamed: R3.1, U1.5
unnamed: R4.1, U1.7
unnamed: R5.1, U2.1
unnamed: R6.1, U2.3
unnamed: R7.1, U2.5
unnamed: R8.1, U2.7
unnamed: R9.1, U3.1
unnamed: R10.1, U3.3
unnamed: R11.1, U3.5
unnamed: R12.1, U3.7
unnamed: R41.1, R42.2, U6.4
OUT1: P9.36, R25.2, U4.6
OUT2: P9.33, R26.2, U4.7
OUT3: P9.34, R27.2, U4.8
OUT4: P9.31, R28.2, U4.9
OUT5: P9.32, R29.2, U4.10
OUT6: P9.29, R30.2, U4.11
OUT7: P9.30, R31.2, U4.12
OUT8: P9.27, R32.2, U4.13
OUT9: P8.40, R33.2, U5.6
OUT10: P8.41, R34.2, U5.7
OUT11: P8.42, R35.2, U5.8
OUT12: P8.43, R36.2, U5.9
OUT13: P8.44, R37.2, U5.10
OUT14: P8.45, R38.2, U5.11
OUT15: P8.46, R39.2, U5.12
OUT16: P8.47, R40.2, U5.13
PO1: P4.1, U4.35
PO2: P4.2, U4.33
PO3: P4.3, U4.31
PO4: P4.4, U4.29
PO5: P4.5, U4.27
PO6: P4.6, U4.25
PO7: P4.7, U4.23
PO8: P4.8, U4.21
PO9: P5.1, U5.35
PO10: P5.2, U5.33
PO11: P5.3, U5.31
PO12: P5.4, U5.29
PO13: P5.5, U5.27
PO14: P5.6, U5.25
PO15: P5.7, U5.23
PO16: P5.8, U5.21
