AndriesTuinhof/stmbl/hardware/old designs/kicad/powerstep/powerstep.kicad_pcb

## KiCad design hardware/old designs/kicad/powerstep/powerstep.kicad_pcb (2022-10-24, an earlier design)

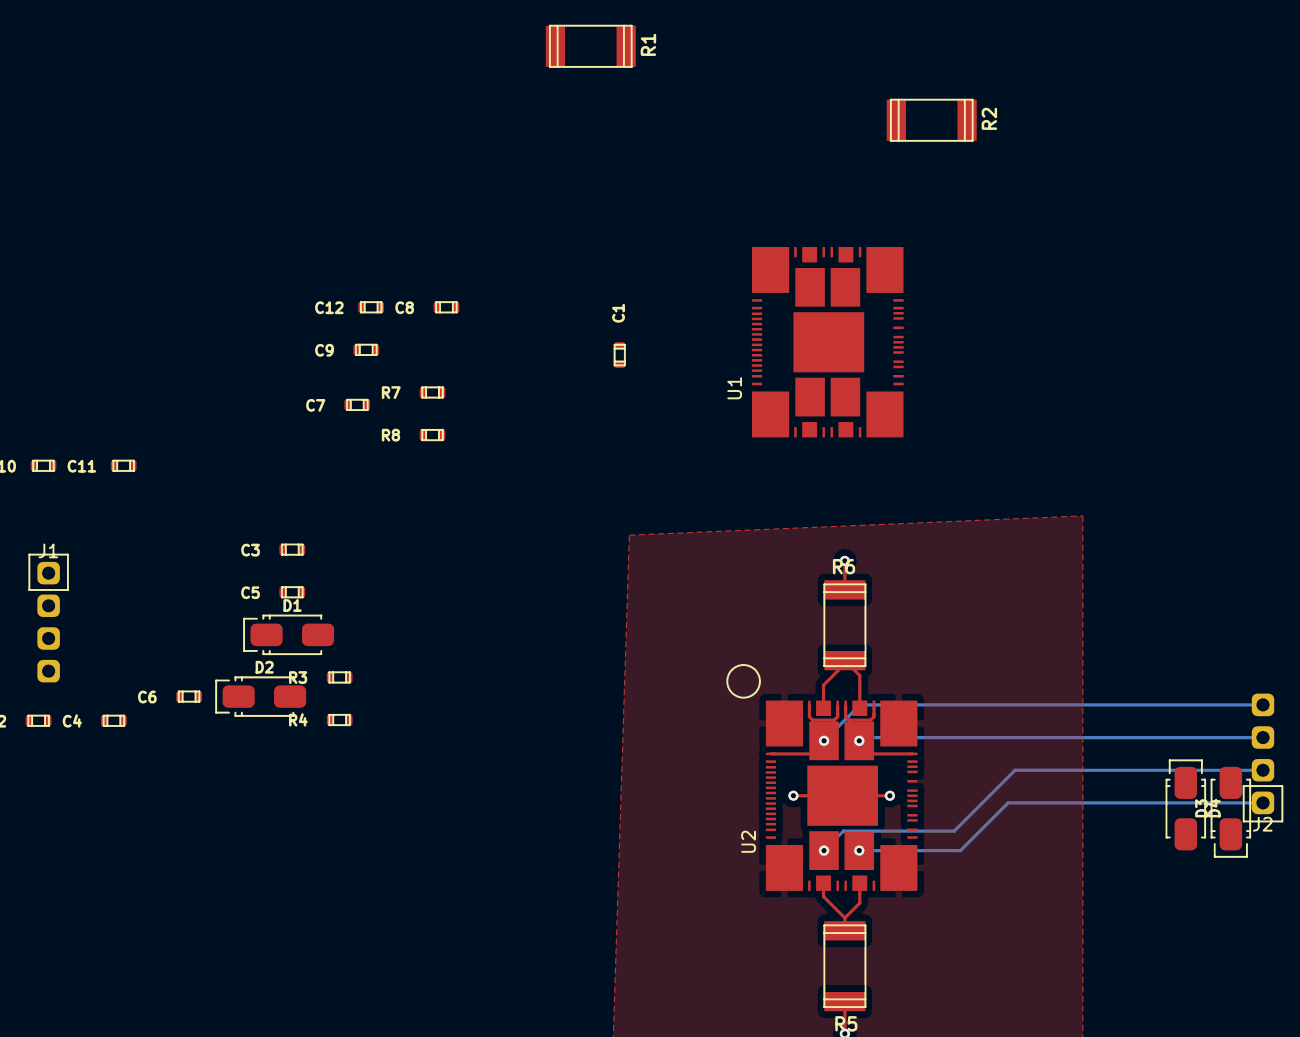
[picture p69: board powerstep.kicad_pcb from above]

Board: 4 copper layers, 28 parts (0 on the bottom side), 31 nets.

Parts:
C1, C2, C3, C4, C5, C6, C7, C8, C9, C10, C11, C12: C; C_0603
D1, D2, D3, D4: D; SMA_Standard
J1, J2: CONN_01X04; CONN_1x04_2.54
R1, R2, R5, R6: R; R_2512
R3, R4, R7, R8: R; R_0603
U1, U2: POWERSTEP01; VFQFPNPSTEP

Connections:
/stepper2/SDI: U1.14, U2.12
/stepper/CK: U1.11, U2.11
/stepper/~CS: U1.10, U2.10
/stepper/~STBY: U1.19, U2.19
GND: C1.1, C2.1, C5.1, C6.1, C7.1, C8.1, C11.1, C12.1, R1.2, R2.2, R4.2, R5.2, R6.2, R8.2, U1.8, U2.8
unnamed: C1.2, U1.13, U1.62
unnamed: C2.2, U1.58, U1.60
unnamed: C3.1, D2.1, U1.56
unnamed: C3.2, C5.2, C6.2, D1.2, R3.1, U1.1, U1.61
unnamed: C4.1, D1.1, D2.2
unnamed: C4.2, U1.57
unnamed: C7.2, U2.13, U2.62
unnamed: C8.2, U2.58, U2.60
unnamed: C9.1, D4.1, U2.56
unnamed: C10.1, D3.1, D4.2
unnamed: C10.2, U2.57
unnamed: C9.2, C11.2, C12.2, D3.2, R7.1, U2.1, U2.61
unnamed: J1.1, U1.38
unnamed: J1.2, U1.22
unnamed: J1.3, U1.65
unnamed: J1.4, U1.7
unnamed: J2.1, U2.38
unnamed: J2.2, U2.22
unnamed: J2.3, U2.65
unnamed: J2.4, U2.7
unnamed: R1.1, U1.20, U1.34
unnamed: R2.1, U1.9, U1.77
unnamed: R3.2, R4.1, U1.54
unnamed: R5.1, U2.20, U2.34
unnamed: R6.1, U2.9, U2.77
unnamed: R7.2, R8.1, U2.54
