AndriesTuinhof/stmbl/hardware/old designs/kicad/rectifier/rectifier.kicad_pcb

## KiCad design hardware/old designs/kicad/rectifier/rectifier.kicad_pcb (2022-10-24, an earlier design)

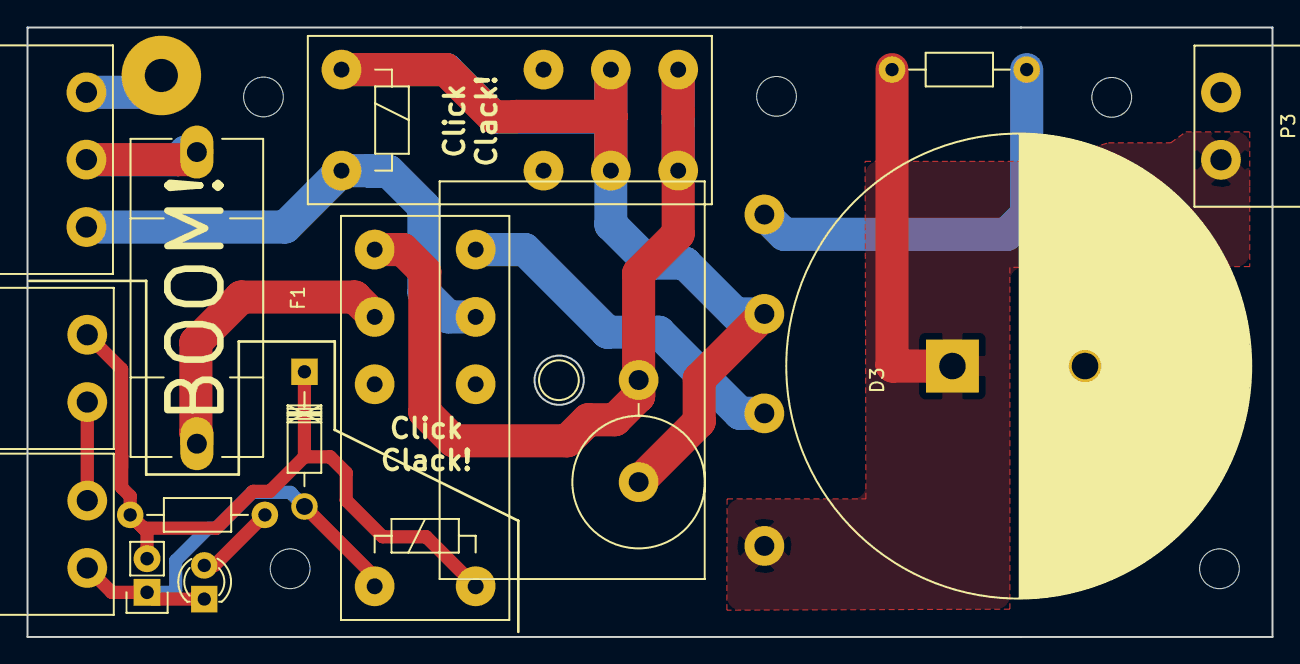
[picture p70: board hardware/old designs/kicad/rectifier/rectifier.kicad_pcb from above]

Board: 2 copper layers, 93.9 x 46.0 mm, 16 parts (0 on the bottom side), 13 nets.

Parts:
C1: CP1; C_Radial_D35_L51_P10
D1: LED; LED-3MM
D2: DIODE; Diode_DO-41_SOD81_Horizontal_RM10
D3: BRIDGE; dfb_bridge
F1: FUSE; Fuseholder5x20_horiz_SemiClosed_Casing10x25mm
K1: CONN_3; WE313-3
P1, P2, P3: CONN_2; WE313-2
P4: CONN_2; Socket_Strip_Straight_1x02
P5: CONN_1; SolderWirePad_single_2-5mmDrill
R1, R3: R; Resistor_Horizontal_RM10mm
R2: R; Resistor_Vertical_RM7.5mm
RL1, RL2: FINDER-40.52; Relay_DPDT_Schrack-RT2_RM5mm

Connections:
AC_fused: F1.2, RL2.11
AC_ntc: D3.4, R2.1, RL1.11, RL1.21, RL1.A1
AC_switched: R2.2, RL1.14, RL1.24, RL2.14
DC+: C1.1, D3.3, P3.1, R3.1
DC-: C1.2, D3.1, P3.2, R3.2
unnamed: D1.1, D2.2, P1.2, P4.1, RL2.A1
unnamed: D1.2, R1.1
unnamed: D2.1, P2.1, P4.2, R1.2, RL2.A2
unnamed: F1.1, K1.2
unnamed: P1.1, P2.2
Neutral: K1.3, RL1.A2, RL2.21
Neutral_Switched: D3.2, RL2.24
PE: K1.1, P5.1
