AndriesTuinhof/stmbl/hardware/old designs/kicad/mesabob/mesabob.kicad_pcb

## KiCad design hardware/old designs/kicad/mesabob/mesabob.kicad_pcb (2022-10-24, an earlier design)

Schematic: mesabob.sch

Parts:
C9, C10, C11: CP; CP_EIA-2012-12_Kemet-R
P1: CONN_02X13; IDC_Header_Straight_26pins

Connections:
+5V: C9.1, C10.1, C11.1, P1.18, P1.20, P1.22, P1.24; also elsewhere on the board
/rx0: P1.1; also elsewhere on the board
/rx1: P1.2; also elsewhere on the board
/rx2: P1.3; also elsewhere on the board
/rx3: P1.4; also elsewhere on the board
/rx4: P1.9; also elsewhere on the board
/rx5: P1.11; also elsewhere on the board
/rx6: P1.13; also elsewhere on the board
/rx7: P1.15; also elsewhere on the board
/tx0: P1.5; also elsewhere on the board
/tx1: P1.6; also elsewhere on the board
/tx2: P1.7; also elsewhere on the board
/tx3: P1.8; also elsewhere on the board
/tx4: P1.17; also elsewhere on the board
/tx5: P1.19; also elsewhere on the board
/tx6: P1.21; also elsewhere on the board
/tx7: P1.23; also elsewhere on the board
GND: C9.2, C10.2, C11.2, P1.10, P1.12, P1.14, P1.16; also elsewhere on the board
