AndriesTuinhof/stmbl/hardware/old designs/kicad/mesabob/mesabob.kicad_pcb

## KiCad design hardware/old designs/kicad/mesabob/mesabob.kicad_pcb (continued)

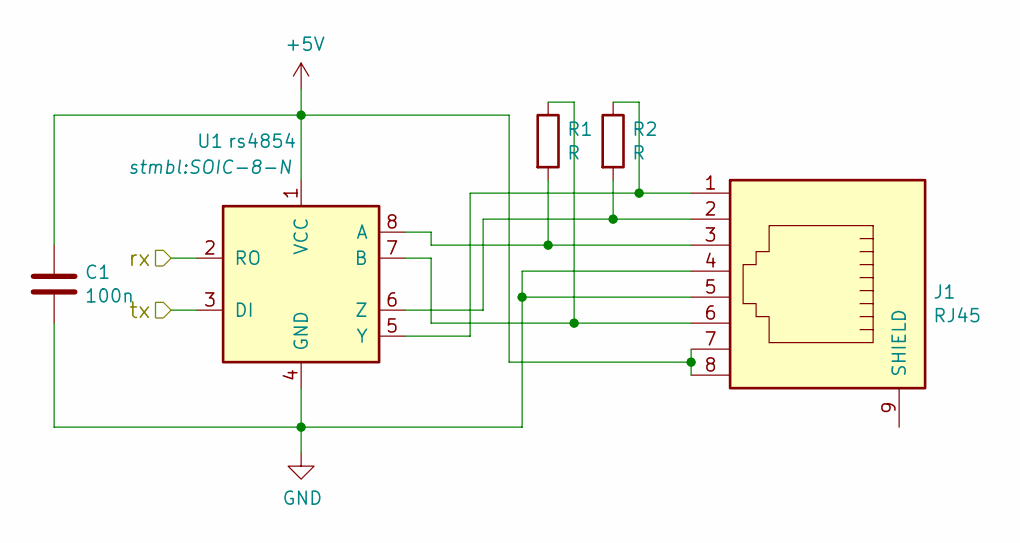
[picture p71: schematic port.sch]

Parts:
C1: 100n; C_0603
J1: RJ45; RJ45_8
R1, R2: R; R_0603
U1: rs4854; SOIC-8-N

Connections:
+5V: C1.1, J1.7, J1.8, U1.1 (VCC); also elsewhere on the board
/rx0: U1.2 (RO); also elsewhere on the board
/tx0: U1.3 (DI); also elsewhere on the board
GND: C1.2, J1.4, J1.5, U1.4 (GND); also elsewhere on the board
unnamed: J1.1, R2.1, U1.5 (Y)
unnamed: J1.2, R2.2, U1.6 (Z)
unnamed: J1.3, R1.2, U1.8 (A)
unnamed: J1.6, R1.1, U1.7 (B)

Parts of its further copies:
C2, C3, C4, C5, C6, C7, C8: 100n; C_0603
J2, J3, J4, J5, J6, J7, J8: RJ45; RJ45_8
R3, R4, R5, R6, R7, R8, R9, R10, R11, R12, R13, R14, R15, R16: R; R_0603
U2, U3, U4, U5, U6, U7, U8: rs4854; SOIC-8-N

Connections of its further copies:
+5V: C2.1, C3.1, C4.1, C5.1, C6.1, C7.1, C8.1, J2.7, J2.8, J3.7, J3.8, J4.7, J4.8, J5.7, J5.8, J6.7, J6.8, J7.7, J7.8, J8.7, J8.8, U2.1 (VCC), U3.1 (VCC), U4.1 (VCC), U5.1 (VCC), U6.1 (VCC), U7.1 (VCC), U8.1 (VCC); also elsewhere on the board
/rx1: U2.2 (RO); also elsewhere on the board
/rx2: U3.2 (RO); also elsewhere on the board
/rx3: U4.2 (RO); also elsewhere on the board
/rx4: U5.2 (RO); also elsewhere on the board
/rx5: U6.2 (RO); also elsewhere on the board
/rx6: U7.2 (RO); also elsewhere on the board
/rx7: U8.2 (RO); also elsewhere on the board
/tx1: U2.3 (DI); also elsewhere on the board
/tx2: U3.3 (DI); also elsewhere on the board
/tx3: U4.3 (DI); also elsewhere on the board
/tx4: U5.3 (DI); also elsewhere on the board
/tx5: U6.3 (DI); also elsewhere on the board
/tx6: U7.3 (DI); also elsewhere on the board
/tx7: U8.3 (DI); also elsewhere on the board
GND: C2.2, C3.2, C4.2, C5.2, C6.2, C7.2, C8.2, J2.4, J2.5, J3.4, J3.5, J4.4, J4.5, J5.4, J5.5, J6.4, J6.5, J7.4, J7.5, J8.4, J8.5, U2.4 (GND), U3.4 (GND), U4.4 (GND), U5.4 (GND), U6.4 (GND), U7.4 (GND), U8.4 (GND); also elsewhere on the board
unnamed: J2.1, R4.1, U2.5 (Y)
unnamed: J2.2, R4.2, U2.6 (Z)
unnamed: J2.3, R3.2, U2.8 (A)
unnamed: J2.6, R3.1, U2.7 (B)
unnamed: J3.1, R6.1, U3.5 (Y)
unnamed: J3.2, R6.2, U3.6 (Z)
unnamed: J3.3, R5.2, U3.8 (A)
unnamed: J3.6, R5.1, U3.7 (B)
unnamed: J4.1, R8.1, U4.5 (Y)
unnamed: J4.2, R8.2, U4.6 (Z)
unnamed: J4.3, R7.2, U4.8 (A)
unnamed: J4.6, R7.1, U4.7 (B)
unnamed: J5.1, R10.1, U5.5 (Y)
unnamed: J5.2, R10.2, U5.6 (Z)
unnamed: J5.3, R9.2, U5.8 (A)
unnamed: J5.6, R9.1, U5.7 (B)
unnamed: J6.1, R12.1, U6.5 (Y)
unnamed: J6.2, R12.2, U6.6 (Z)
unnamed: J6.3, R11.2, U6.8 (A)
unnamed: J6.6, R11.1, U6.7 (B)
unnamed: J7.1, R14.1, U7.5 (Y)
unnamed: J7.2, R14.2, U7.6 (Z)
unnamed: J7.3, R13.2, U7.8 (A)
unnamed: J7.6, R13.1, U7.7 (B)
unnamed: J8.1, R16.1, U8.5 (Y)
unnamed: J8.2, R16.2, U8.6 (Z)
unnamed: J8.3, R15.2, U8.8 (A)
unnamed: J8.6, R15.1, U8.7 (B)

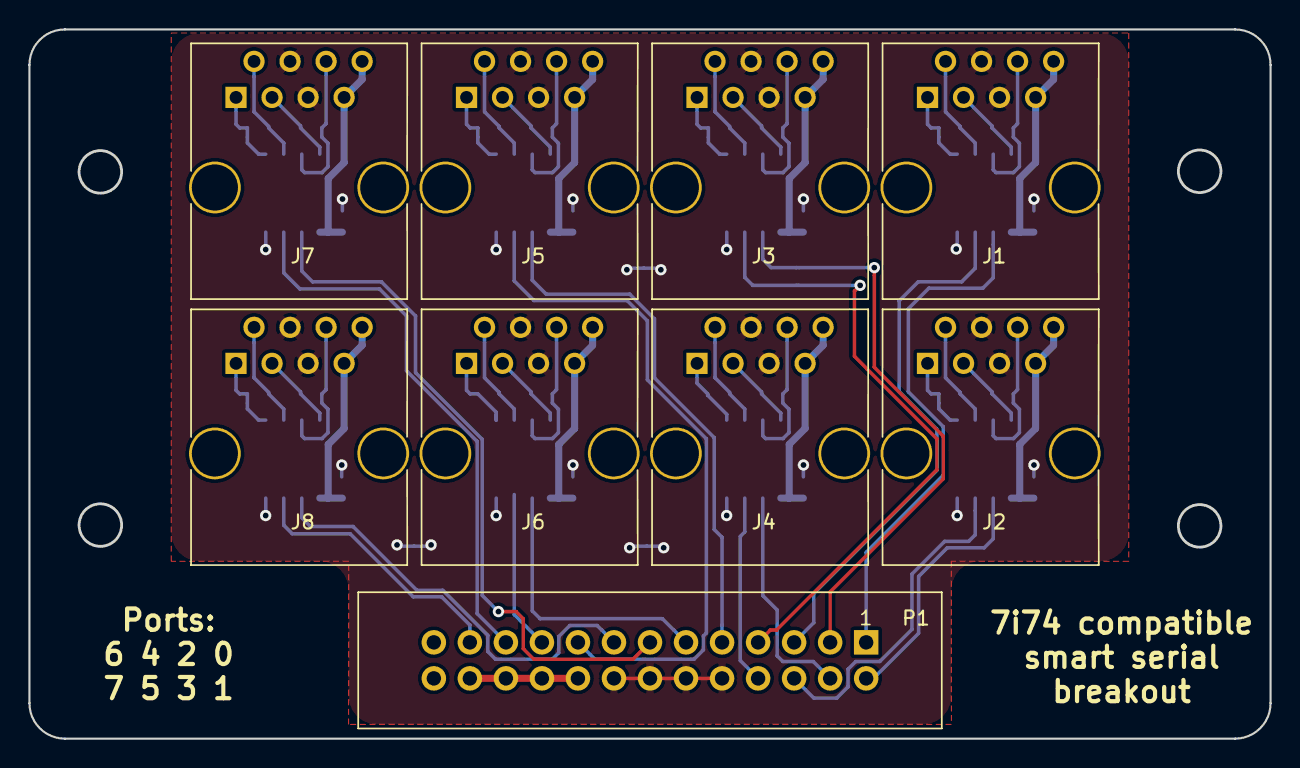
[picture p72: board mesabob.kicad_pcb from above]

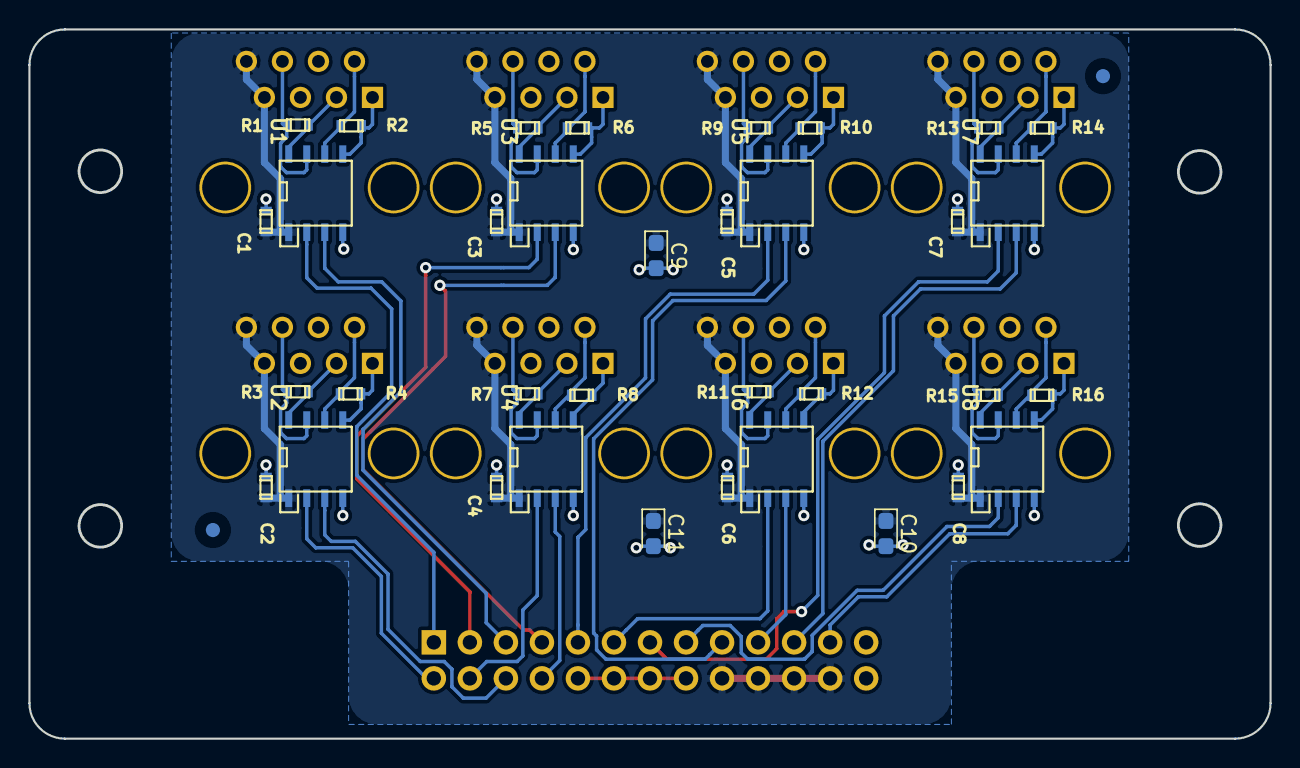
[picture p73: board mesabob.kicad_pcb from below]

Board: 2 copper layers, 87.5 x 50.0 mm, 44 parts (35 on the bottom side), 50 nets.
