AndriesTuinhof/stmbl/hardware/old designs/kicad/bob/ethernet_bob/ethernet_bob.kicad_pcb

## KiCad design hardware/old designs/kicad/bob/ethernet_bob/ethernet_bob.kicad_pcb (2022-10-24, an earlier design)

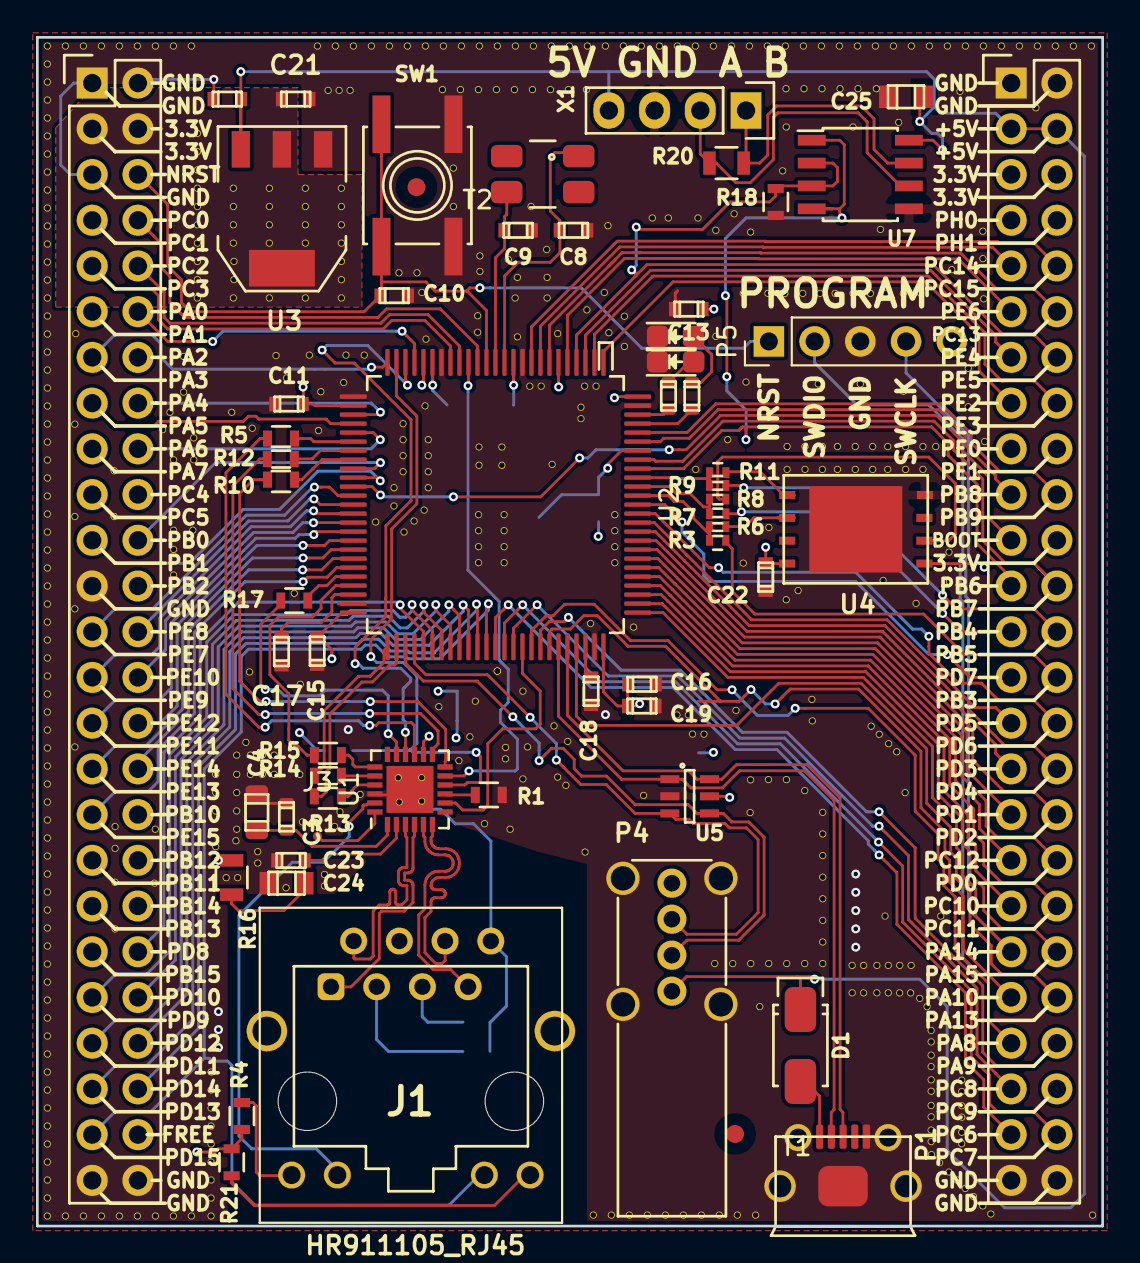
[picture p74: board ethernet_bob.kicad_pcb from above]

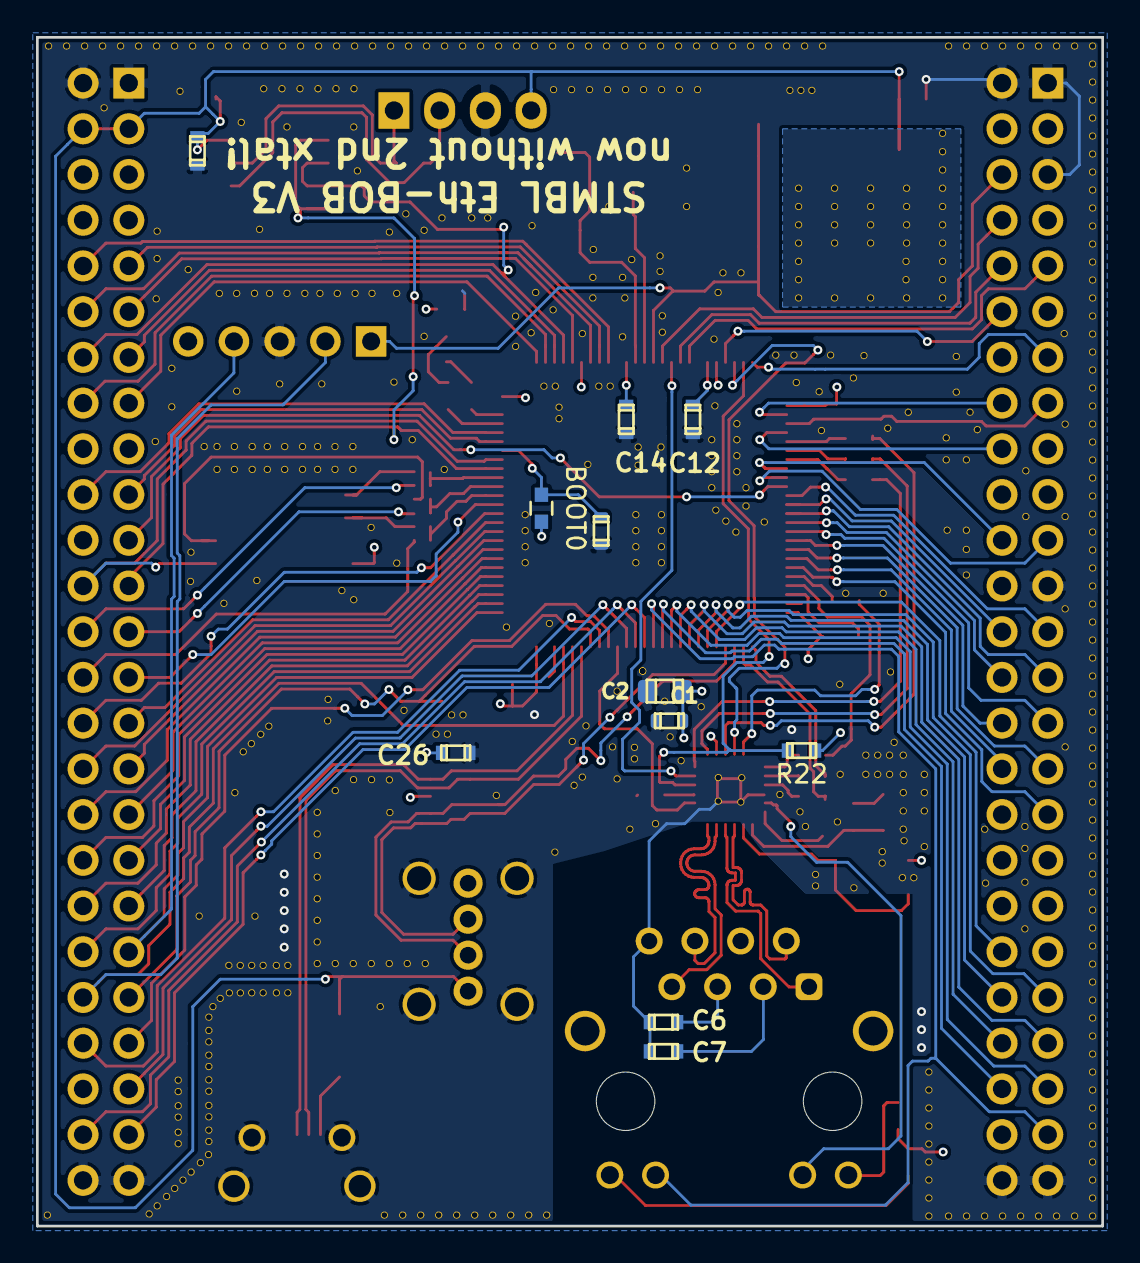
[picture p75: board ethernet_bob.kicad_pcb from below]

Board: 4 copper layers, 59.2 x 66.0 mm, 71 parts (11 on the bottom side), 120 nets.

Parts:
C1, C3, C6, C7, C11, C12, C13, C14, C15, C16, C17, C18, C19, C23, C26: 100n; C_0603
C2, C4, C24: 22µ; C_0805
C5, C10, C20, C21, C22: C; C_0603
C8, C9: 18pF; C_0603
C25: C; C_0805
D1: D_Schottky; SMA_Standard
D2, D3: LED; LED-0805
J1: HR911105_RJ45; HY951180A_RJ45
J3: CONN_01X01; Measurement_Point_Round-SMD-Pad_Big
JP1: BOOT0; C_0603
P1: USB_OTG; USB_Micro-B
P2, P3: CONN_02X25; Pin_Header_Straight_2x25
P4: USB_A; USB_A_Vertical
P5: CONN_01X04; PinHeader_1x05_P2.54mm_Vertical
P6: CONN_01X04; Pin_Header_Straight_1x04
R1: 6k49; R_0603
R3, R6, R7, R8, R9, R11: R; R_0402
R4, R21: 220; R_0603
R5, R10, R12, R13, R14, R15, R17: 1k; R_0603
R16, R20: R; R_0805
R18, R19, R22, R23, R24: R; R_0603
SW1: SW_PUSH; SW_SPST_EVQQ2
T1, T2: testpoint; Fiducial_1mm_Outer_CopperTop
U1: KSZ8081; QFN-24-1EP_4x4mm_Pitch0.5mm
U2: STM32F407VETx; LQFP-100_14x14mm_Pitch0.5mm
U3: NCP1117ST33T3G; SOT-223
U4: CAT250_EEPROM; MLP8_8x6
U5: USBLC6-4SC6; SOT-23-6
U7: SP3485EN; SOIC-8_3.9x4.9mm_Pitch1.27mm
X1: CRYSTAL_SMD_4pin; Crystal_SMD_0603_4Pads

Connections:
+1V2: C3.1, C4.1, U1.1
+3V3: C1.1, C2.1, C11.2, C12.2, C13.2, C14.2, C15.2, C16.2, C19.2, C21.1, C22.1, C26.2, JP1.1, P2.3, P2.4, P3.5, P3.6, P3.22, P5.5, R4.1, R16.2, R21.1, R22.1, U1.14, U2.6, U2.11, U2.20, U2.21, U2.27, U2.50, U2.75, U2.100, U3.2, U4.8, U5.5
+5VP: C5.1, C20.1, C25.1, D1.1, P3.3, P3.4, P4.1, P6.4, U3.3, U7.8
/Phy and RJ45/LED1A: J1.9, R4.2
/Phy and RJ45/LED1K: J1.10, U1.23
/Phy and RJ45/LED2A: J1.12, R21.2
/Phy and RJ45/PHY_CRS: R5.2, U2.31
/Phy and RJ45/PHY_MDC: U1.11, U2.16
/Phy and RJ45/PHY_MDIO: R22.2, U1.10, U2.24
/Phy and RJ45/PHY_REFCLK: U1.16, U2.23
/Phy and RJ45/PHY_RST: J3.1, U1.24
/Phy and RJ45/PHY_RXD0: R12.2, U2.32
/Phy and RJ45/PHY_RXD1: R10.2, U2.33
/Phy and RJ45/PHY_RXER: R17.1, U2.46
/Phy and RJ45/PHY_TXD0: R14.1, U2.51
/Phy and RJ45/PHY_TXD1: R13.1, U2.52
/Phy and RJ45/PHY_TXEN: R15.1, U2.47
/Phy and RJ45/PHY_XI: U1.8, U2.66
/flash/FLASH_MISO: R8.1, U4.2
/flash/FLASH_MOSI: R11.1, U4.5
/flash/FLASH_SCK: R6.1, U4.6
BOOT1: P3.21, U2.36
GND: C1.2, C2.2, C3.2, C4.2, C5.2, C6.2, C7.2, C8.2, C9.2, C10.2, C11.1, C12.1, C13.1, C14.1, C15.1, C16.1, C17.1, C18.1, C19.1, C20.2, C21.2, C22.2, C23.2, C24.2, C25.2, C26.1, D2.1, D3.1, J1.8, P1.5, P1.6, P2.1, P2.2, P2.5, P2.23, P2.49, P2.50, P3.1, P3.2, P3.49, P3.50, P4.5, P5.3, P6.3, R1.2, R18.2, R19.2, SW1.1, U1.22, U1.25, U2.10, U2.19, U2.26, U2.49, U2.74, U2.99, U3.1, U4.4, U5.2, U7.5
LED2: J1.11, P2.47, U2.62
NRST: C10.1, P2.6, P5.1, SW1.2, U2.14
unnamed: C6.1, J1.5
unnamed: C7.1, J1.3
unnamed: C8.1, U2.12, X1.1
unnamed: C9.1, U2.13, X1.2
unnamed: C17.2, U2.48
unnamed: C18.2, U2.73
unnamed: D1.2, P1.1
unnamed: D2.2, R23.2
unnamed: D3.2, R24.2
unnamed: JP1.2, R19.1, U2.94
unnamed: P6.1, R20.2, U7.7
unnamed: P6.2, R20.1, U7.6
unnamed: R1.1, U1.9
unnamed: R3.2, R6.2, U2.89
unnamed: R5.1, U1.15
unnamed: R7.2, R8.2, U2.90
unnamed: R10.1, U1.12
unnamed: R9.2, R11.2, U2.91
unnamed: R12.1, U1.13
unnamed: R13.2, U1.21
unnamed: R14.2, U1.20
unnamed: R15.2, U1.19
unnamed: R17.2, U1.17
unnamed: R23.1, U2.97
unnamed: R24.1, U2.98
PA0: P2.12, U2.22
PA3: P2.13, U2.25
PA4: P2.16, U2.28
PA5: P2.15, U2.29
PA6: P2.18, U2.30
PA8: P3.43, U2.67
PA9: P3.44, U2.68
PA10: P3.41, U2.69
PA13: P3.42, P5.2, U2.72
PA14: P3.39, P5.4, U2.76
PA15: P3.40, U2.77
PB0: P2.22, U2.34
PB1: P2.21, U2.35
PB3: P3.28, R3.1
PB4: P3.25, R7.1
PB5: P3.26, R9.1
PB6: P3.23, U2.92, U7.1, U7.4
PB7: P3.24, U2.93, U4.1
PB8: P3.19, U2.95
PB9: P3.20, U2.96
PC0: P2.8, U2.15
PC2: P2.10, U2.17
PC3: P2.9, U2.18
PC6: P3.47, U2.63
PC7: P3.48, U2.64
PC8: P3.45, U2.65
PC10: P3.37, U2.78
PC11: P3.38, U2.79
PC12: P3.35, U2.80
PC13: P3.12, U2.7
PC14: P3.9, U2.8
PC15: P3.10, U2.9
PD0: P3.36, U2.81
PD1: P3.33, U2.82
PD2: P3.34, U2.83
PD3: P3.31, U2.84
PD4: P3.32, U2.85
PD5: P3.29, U2.86
PD6: P3.30, U2.87
PD7: P3.27, U2.88
PD8: P2.40, U2.55
PD9: P2.41, U2.56
PD10: P2.42, U2.57
PD11: P2.43, U2.58
PD12: P2.44, U2.59
PD13: P2.45, U2.60
PD14: P2.46, U2.61
PE2: P3.15, U2.1
PE3: P3.16, U2.2
PE4: P3.13, U2.3
PE5: P3.14, R18.1, U2.4, U7.2, U7.3
PE6: P3.11, U2.5
PE7: P2.25, U2.37
PE8: P2.26, U2.38
PE9: P2.27, U2.39
PE10: P2.28, U2.40
PE11: P2.29, U2.41
PE12: P2.30, U2.42
PE13: P2.31, U2.43
PE14: P2.32, U2.44
PE15: P2.33, U2.45
RX_N: J1.2, U1.3
RX_P: J1.1, U1.4
TX_N: J1.7, U1.5
TX_P: J1.6, U1.6
USB+: P1.3, U2.71, U5.6
USB-: P1.2, U2.70, U5.1
USB_OTG+: P4.3, U2.54, U5.3
USB_OTG-: P4.2, U2.53, U5.4
VDDA: C23.1, C24.1, R16.1, U1.2
