AndriesTuinhof/stmbl/hardware/old designs/kicad/bob/ethernet_bob_base/ethernet_bob_base.kicad_pcb

## KiCad design hardware/old designs/kicad/bob/ethernet_bob_base/ethernet_bob_base.kicad_pcb (2022-10-24, an earlier design)

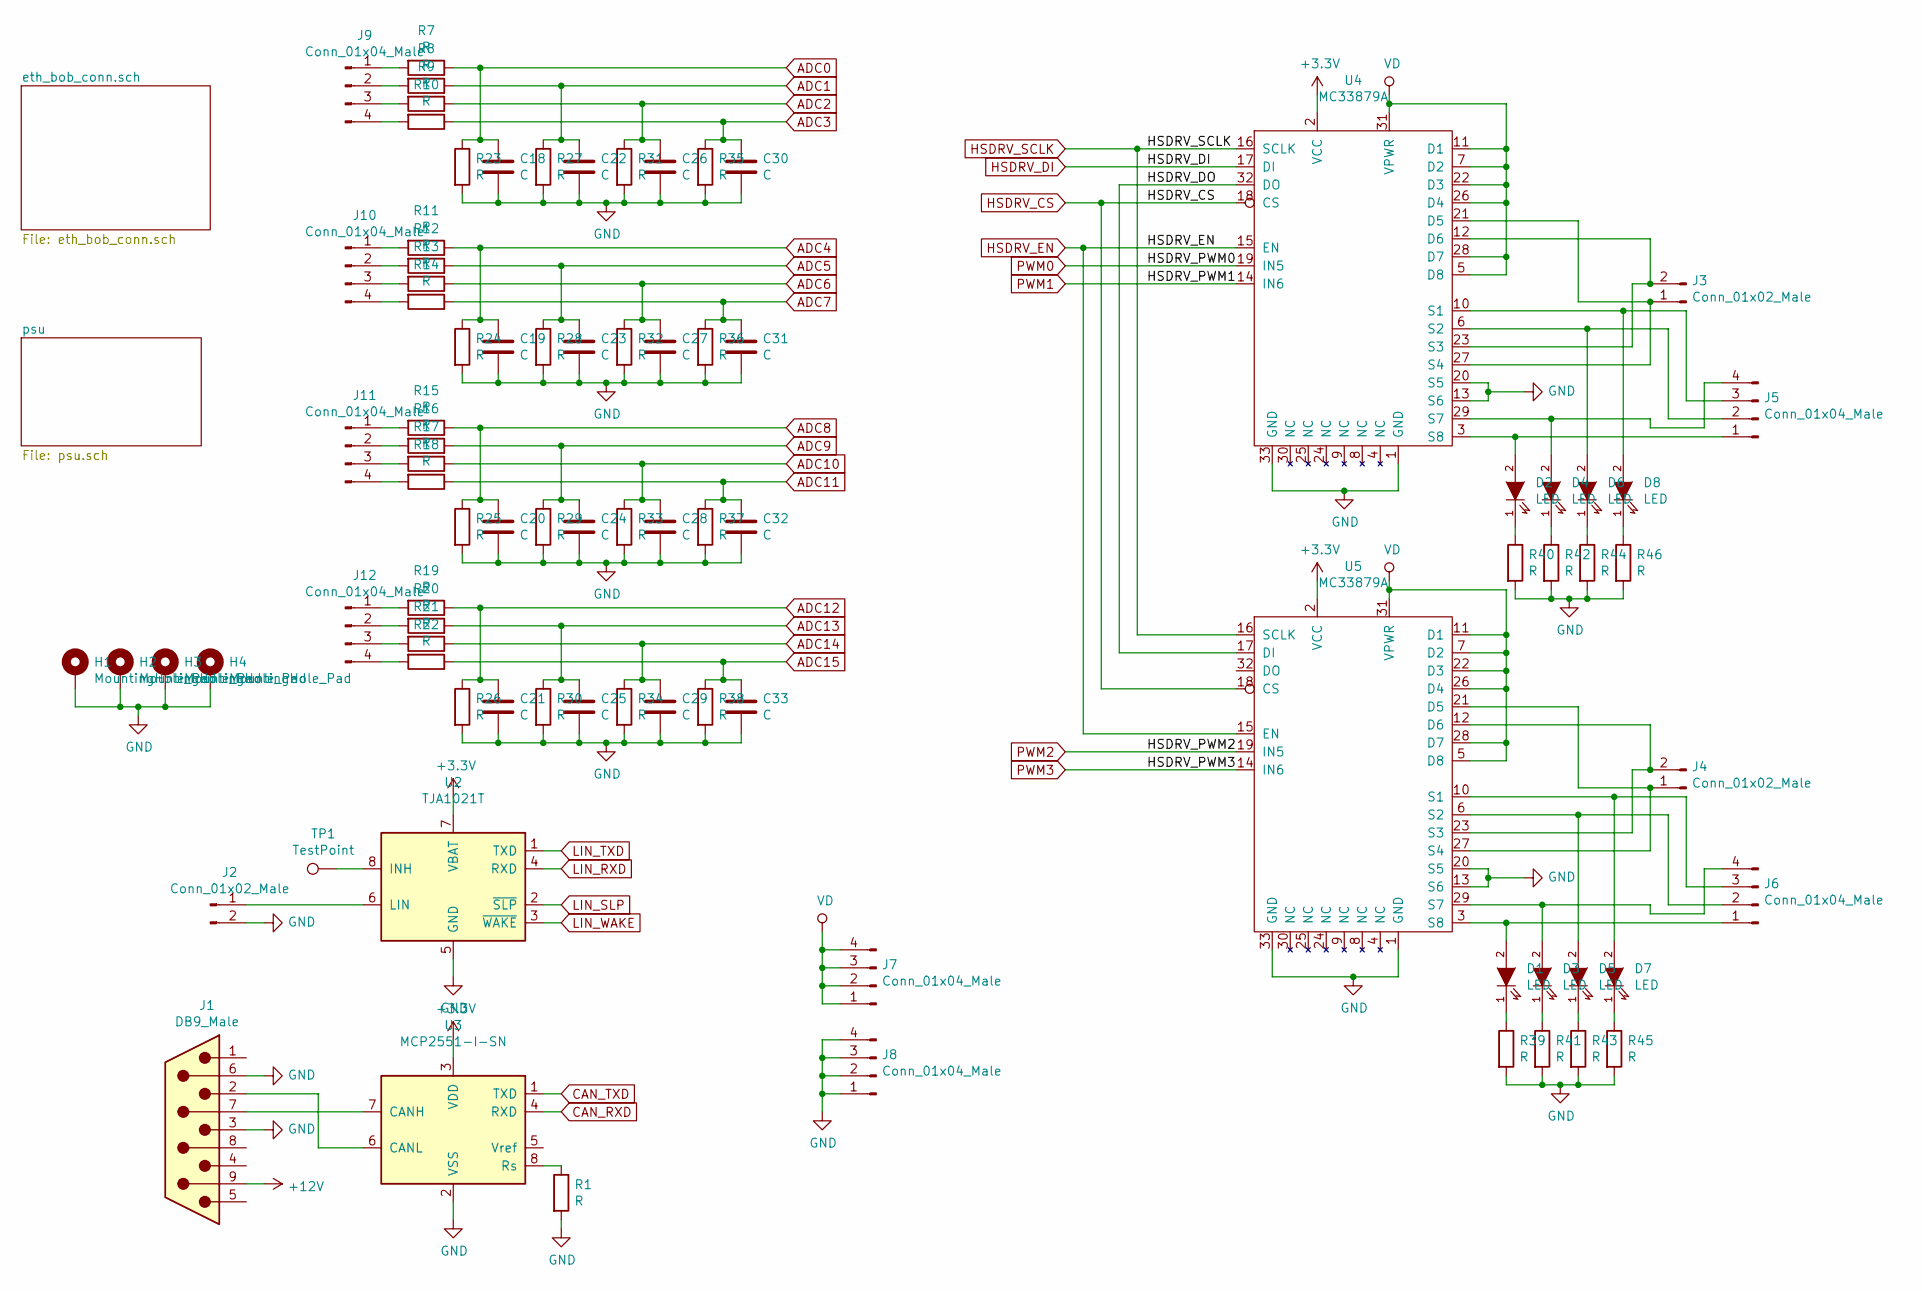
[picture p76: schematic ethernet_bob_base.sch]

Parts:
C18, C19, C20, C21, C22, C23, C24, C25, C26, C27, C28, C29, C30, C31, C32, C33: C; C_0805
D1, D2, D3, D4, D5, D6, D7, D8: LED; LED-0805
H1, H2, H3, H4: MountingHole_Pad; MountingHole_3.2mm_M3_Pad_Via
J1: DB9_Male; DSUB-9_Male_Vertical_Pitch2.77x2.84mm_MountingHoles
J2: Conn_01x02_Male; Pin_Header_Straight_1x02_Pitch2.54mm
J3, J4: Conn_01x02_Male; RM3.5_1x2_UP
J5, J6, J7, J8, J9, J10, J11, J12: Conn_01x04_Male; RM3.5_1x4_UP
R1, R7, R8, R9, R10, R11, R12, R13, R14, R15, R16, R17, R18, R19, R20, R21, R22, R23, R24, R25, R26, R27, R28, R29, R30, R31, R32, R33, R34, R35, R36, R37, R38, R39, R40, R41, R42, R43, R44, R45, R46: R; R_0603
TP1: TestPoint; Measurement_Point_Round-TH_Small
U2: TJA1021T; SOIC-8-N
U3: MCP2551-I-SN; SOIC-8-N
U4, U5: MC33879A; SOICW_32_EPAD

Connections:
+12V: J1.9
/HSDRV_DO: U4.32 (DO), U5.17 (DI)
ADC0: C18.1, R7.1, R23.1; also elsewhere on the board
ADC1: C22.1, R8.1, R27.1; also elsewhere on the board
ADC2: C26.1, R9.1, R31.1; also elsewhere on the board
ADC3: C30.1, R10.1, R35.1; also elsewhere on the board
ADC4: C19.1, R11.1, R24.1; also elsewhere on the board
ADC5: C23.1, R12.1, R28.1; also elsewhere on the board
ADC6: C27.1, R13.1, R32.1; also elsewhere on the board
ADC7: C31.1, R14.1, R36.1; also elsewhere on the board
ADC8: C20.1, R15.1, R25.1; also elsewhere on the board
ADC9: C24.1, R16.1, R29.1; also elsewhere on the board
ADC10: C28.1, R17.1, R33.1; also elsewhere on the board
ADC11: C32.1, R18.1, R37.1; also elsewhere on the board
ADC12: C21.1, R19.1, R26.1; also elsewhere on the board
ADC13: C25.1, R20.1, R30.1; also elsewhere on the board
ADC14: C29.1, R21.1, R34.1; also elsewhere on the board
ADC15: C33.1, R22.1, R38.1; also elsewhere on the board
CAN_RXD: U3.4 (RXD); also elsewhere on the board
CAN_TXD: U3.1 (TXD); also elsewhere on the board
GND: C18.2, C19.2, C20.2, C21.2, C22.2, C23.2, C24.2, C25.2, C26.2, C27.2, C28.2, C29.2, C30.2, C31.2, C32.2, C33.2, H1.1, H2.1, H3.1, H4.1, J1.3, J1.6, J2.2, J8.1, J8.2, J8.3, J8.4, R1.2, R23.2, R24.2, R25.2, R26.2, R27.2, R28.2, R29.2, R30.2, R31.2, R32.2, R33.2, R34.2, R35.2, R36.2, R37.2, R38.2, R39.2, R40.2, R41.2, R42.2, R43.2, R44.2, R45.2, R46.2, U2.5 (GND), U3.2 (VSS), U4.1 (GND), U4.13 (S6), U4.20 (S5), U4.33 (GND), U5.1 (GND), U5.13 (S6), U5.20 (S5), U5.33 (GND); also elsewhere on the board
HSDRV_CS: U4.18 (CS), U5.18 (CS); also elsewhere on the board
HSDRV_DI: U4.17 (DI); also elsewhere on the board
HSDRV_EN: U4.15 (EN), U5.15 (EN); also elsewhere on the board
HSDRV_SCLK: U4.16 (SCLK), U5.16 (SCLK); also elsewhere on the board
LIN_RXD: U2.4 (RXD); also elsewhere on the board
LIN_SLP: U2.2 (~SLP~)
LIN_TXD: U2.1 (TXD); also elsewhere on the board
LIN_WAKE: U2.3 (~WAKE~)
unnamed: D1.1 (K), R39.1
unnamed: D1.2 (A), J6.1, U5.3 (S8)
unnamed: D2.1 (K), R40.1
unnamed: D2.2 (A), J5.1, U4.3 (S8)
unnamed: D3.1 (K), R41.1
unnamed: D3.2 (A), J6.4, U5.29 (S7)
unnamed: D4.1 (K), R42.1
unnamed: D4.2 (A), J5.4, U4.29 (S7)
unnamed: D5.1 (K), R43.1
unnamed: D5.2 (A), J6.2, U5.6 (S2)
unnamed: D6.1 (K), R44.1
unnamed: D6.2 (A), J5.2, U4.6 (S2)
unnamed: D7.1 (K), R45.1
unnamed: D7.2 (A), J6.3, U5.10 (S1)
unnamed: D8.1 (K), R46.1
unnamed: D8.2 (A), J5.3, U4.10 (S1)
unnamed: J1.2, U3.6 (CANL)
unnamed: J1.7, U3.7 (CANH)
unnamed: J2.1, U2.6 (LIN)
unnamed: J3.1, U4.21 (D5), U4.27 (S4)
unnamed: J3.2, U4.12 (D6), U4.23 (S3)
unnamed: J4.1, U5.21 (D5), U5.27 (S4)
unnamed: J4.2, U5.12 (D6), U5.23 (S3)
unnamed: J9.1, R7.2
unnamed: J9.2, R8.2
unnamed: J9.3, R9.2
unnamed: J9.4, R10.2
unnamed: J10.1, R11.2
unnamed: J10.2, R12.2
unnamed: J10.3, R13.2
unnamed: J10.4, R14.2
unnamed: J11.1, R15.2
unnamed: J11.2, R16.2
unnamed: J11.3, R17.2
unnamed: J11.4, R18.2
unnamed: J12.1, R19.2
unnamed: J12.2, R20.2
unnamed: J12.3, R21.2
unnamed: J12.4, R22.2
unnamed: R1.1, U3.8 (Rs)
unnamed: TP1.1, U2.8 (INH)
PC6: U5.19 (IN5); also elsewhere on the board
PC7: U5.14 (IN6); also elsewhere on the board
PD11: U4.14 (IN6); also elsewhere on the board
PD12: U4.19 (IN5); also elsewhere on the board
VD: J7.1, J7.2, J7.3, J7.4, U4.5 (D8), U4.7 (D2), U4.11 (D1), U4.22 (D3), U4.26 (D4), U4.28 (D7), U4.31 (VPWR), U5.5 (D8), U5.7 (D2), U5.11 (D1), U5.22 (D3), U5.26 (D4), U5.28 (D7), U5.31 (VPWR); also elsewhere on the board

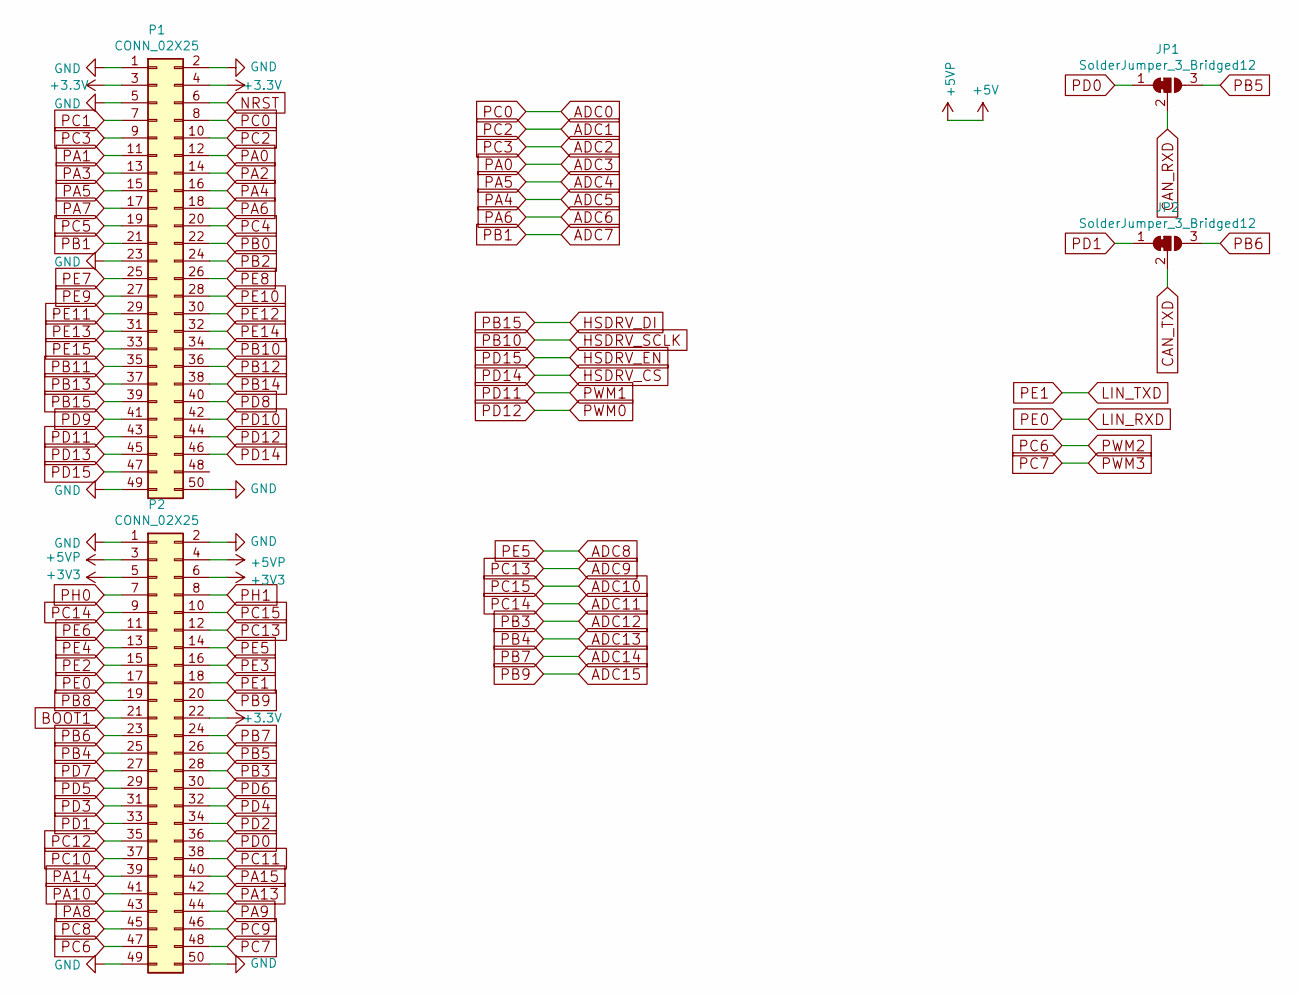
[picture p77: schematic eth_bob_conn.sch]

Parts:
JP1, JP2: SolderJumper_3_Bridged12; SOLDER_JUMPER_3_NC
P1, P2: CONN_02X25; Pin_Header_Straight_2x25_Pitch2.54mm

Connections:
+5V: P2.3, P2.4; also elsewhere on the board
ADC0: P1.8; also elsewhere on the board
ADC1: P1.10; also elsewhere on the board
ADC2: P1.9; also elsewhere on the board
ADC3: P1.12; also elsewhere on the board
ADC4: P1.15; also elsewhere on the board
ADC5: P1.16; also elsewhere on the board
ADC6: P1.18; also elsewhere on the board
ADC7: P1.21; also elsewhere on the board
ADC8: P2.14; also elsewhere on the board
ADC9: P2.12; also elsewhere on the board
ADC10: P2.10; also elsewhere on the board
ADC11: P2.9; also elsewhere on the board
ADC12: P2.28; also elsewhere on the board
ADC13: P2.25; also elsewhere on the board
ADC14: P2.24; also elsewhere on the board
ADC15: P2.20; also elsewhere on the board
BOOT1: P2.21
CAN_RXD: JP1.2 (C); also elsewhere on the board
CAN_TXD: JP2.2 (C); also elsewhere on the board
GND: P1.1, P1.2, P1.5, P1.23, P1.49, P1.50, P2.1, P2.2, P2.49, P2.50; also elsewhere on the board
HSDRV_CS: P1.46; also elsewhere on the board
HSDRV_DI: P1.39; also elsewhere on the board
HSDRV_EN: P1.47; also elsewhere on the board
HSDRV_SCLK: P1.34; also elsewhere on the board
LIN_RXD: P2.17; also elsewhere on the board
LIN_TXD: P2.18; also elsewhere on the board
NRST: P1.6
PA1: P1.11
PA2: P1.14
PA3: P1.13
PA7: P1.17
PA8: P2.43
PA9: P2.44
PA10: P2.41
PA13: P2.42
PA14: P2.39
PA15: P2.40
PB0: P1.22
PB2: P1.24
PB5: JP1.3 (B), P2.26
PB6: JP2.3 (B), P2.23
PB8: P2.19
PB11: P1.35
PB12: P1.36
PB13: P1.37
PB14: P1.38
PC1: P1.7
PC4: P1.20
PC5: P1.19
PC6: P2.47; also elsewhere on the board
PC7: P2.48; also elsewhere on the board
PC8: P2.45
PC9: P2.46
PC10: P2.37
PC11: P2.38
PC12: P2.35
PD0: JP1.1 (A), P2.36
PD1: JP2.1 (A), P2.33
PD2: P2.34
PD3: P2.31
PD4: P2.32
PD5: P2.29
PD6: P2.30
PD7: P2.27
PD8: P1.40
PD9: P1.41
PD10: P1.42
PD11: P1.43; also elsewhere on the board
PD12: P1.44; also elsewhere on the board
PD13: P1.45
PE2: P2.15
PE3: P2.16
PE4: P2.13
PE6: P2.11
PE7: P1.25
PE8: P1.26
PE9: P1.27
PE10: P1.28
PE11: P1.29
PE12: P1.30
PE13: P1.31
PE14: P1.32
PE15: P1.33
PH0: P2.7
PH1: P2.8

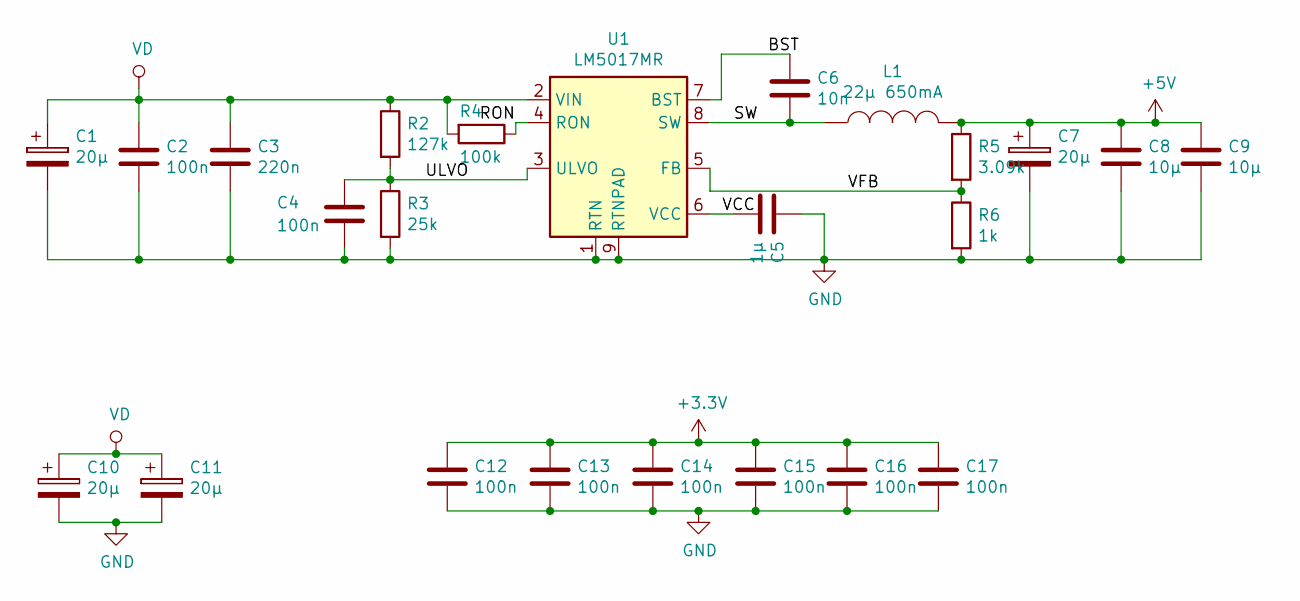
[picture p78: schematic psu.sch]

Parts:
C1, C7, C10, C11: 20µ; CP_Elec_6.3x7.7
C2, C12, C13, C14, C15, C16, C17: 100n; C_0805
C3: 220n; C_0805
C4: 100n; C_0603
C5: 1µ; C_0805
C6: 10n; C_0603
C8, C9: 10µ; C_0805
L1: 22µ 650mA; SMD_INDUCTOR_32x25
R2: 127k; R_0603
R3: 25k; R_0603
R4: 100k; R_0603
R5: 3.09k; R_0603
R6: 1k; R_0603
U1: LM5017MR; SO8_PowerPAD

Connections:
+5V: C7.1, C8.1, C9.1, L1.2, R5.1; also elsewhere on the board
/psu/BST: C6.1, U1.7 (BST)
/psu/RON: R4.1, U1.4 (RON)
/psu/SW: C6.2, L1.1, U1.8 (SW)
/psu/ULVO: C4.1, R2.2, R3.1, U1.3 (ULVO)
/psu/VCC: C5.2, U1.6 (VCC)
/psu/VFB: R5.2, R6.1, U1.5 (FB)
GND: C1.2, C2.2, C3.2, C4.2, C5.1, C7.2, C8.2, C9.2, C10.2, C11.2, C12.2, C13.2, C14.2, C15.2, C16.2, C17.2, R3.2, R6.2, U1.1 (RTN), U1.9 (RTNPAD); also elsewhere on the board
VD: C1.1, C2.1, C3.1, C10.1, C11.1, R2.1, R4.2, U1.2 (VIN); also elsewhere on the board

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
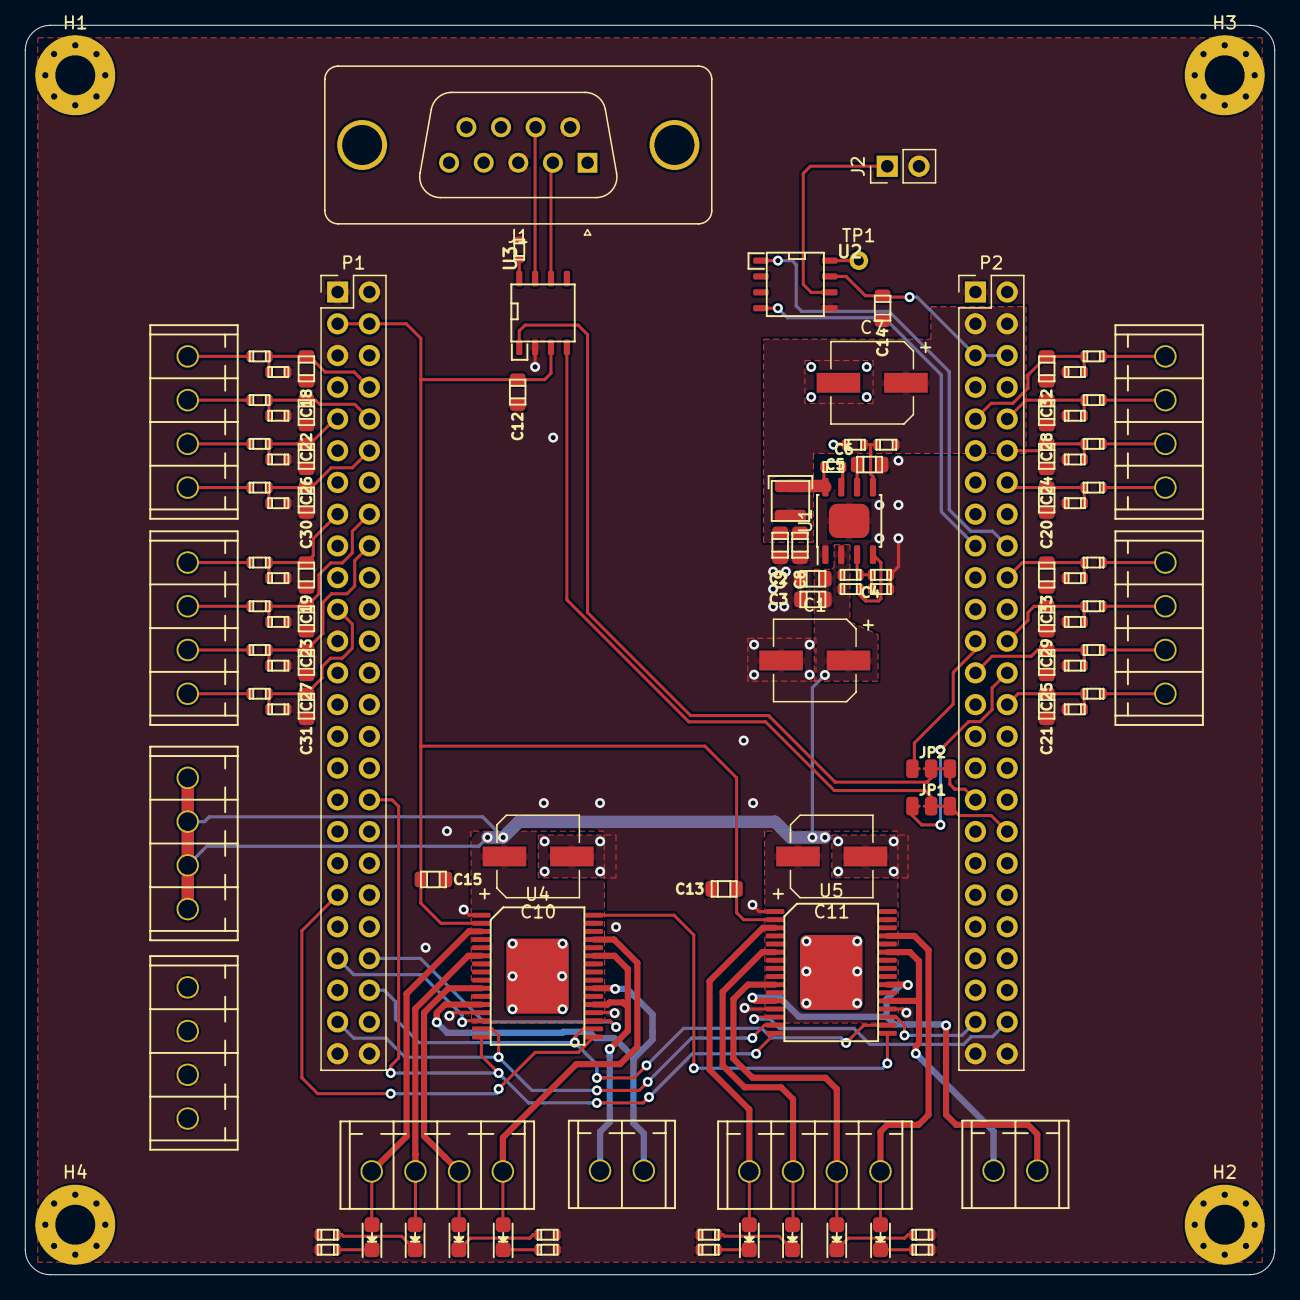
[picture p79: board ethernet_bob_base.kicad_pcb from above]

Board: 2 copper layers, 100.0 x 100.0 mm, 112 parts (0 on the bottom side), 84 nets.
