AndriesTuinhof/stmbl/hardware/old designs/kicad/troller/to220_powerstage.kicad_pcb

## KiCad design hardware/old designs/kicad/troller/to220_powerstage.kicad_pcb (2022-10-24, an earlier design)

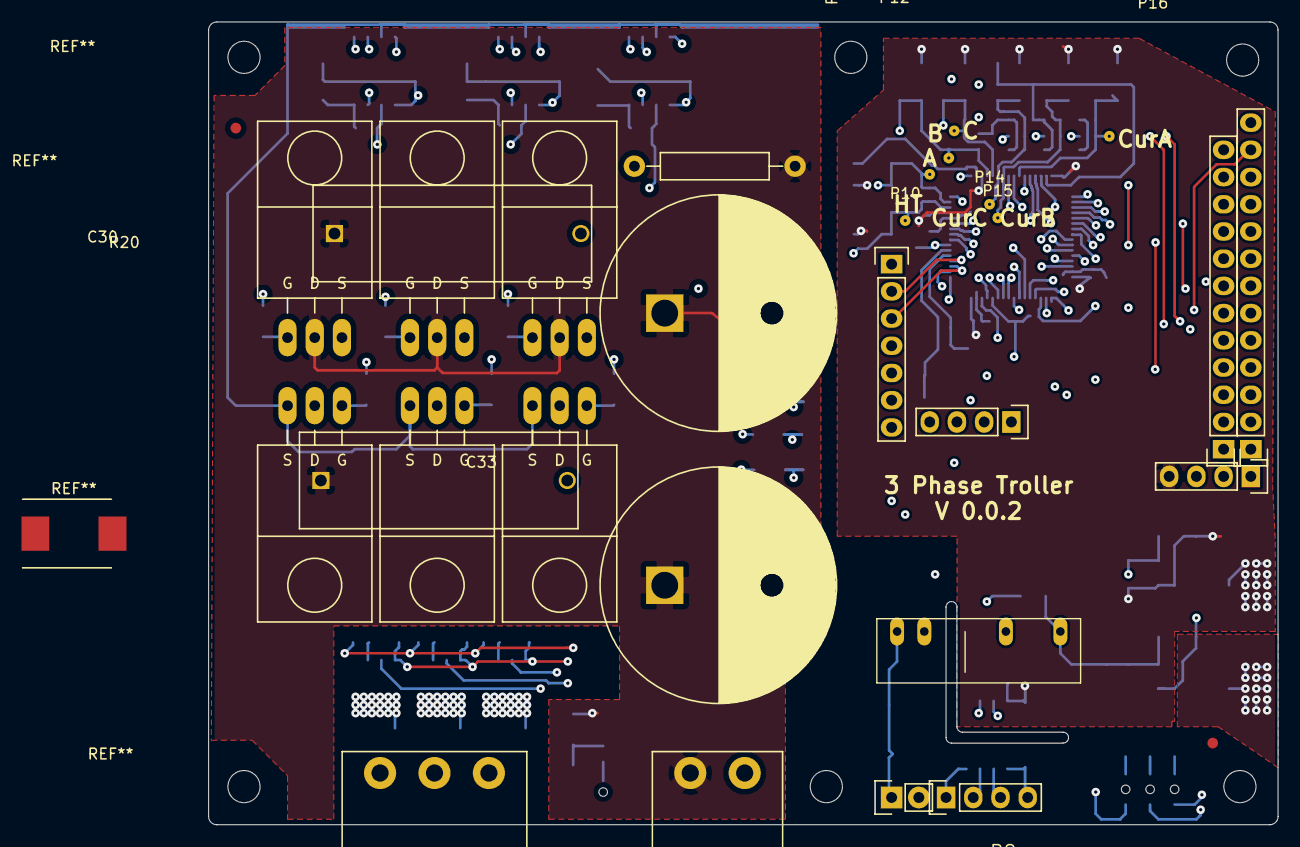
[picture p80: board to220_powerstage.kicad_pcb from above]

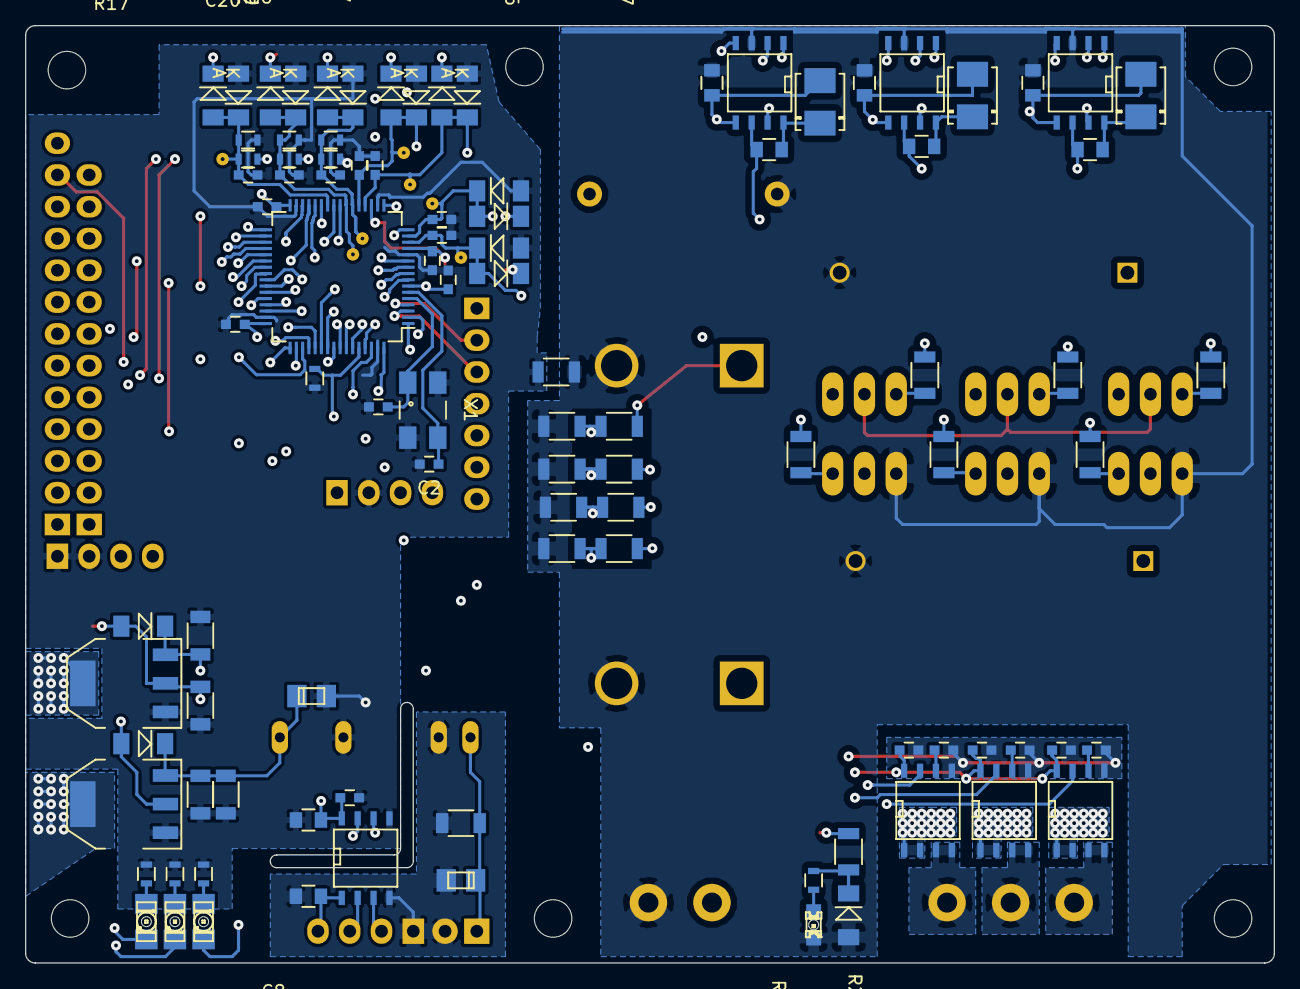
[picture p81: board to220_powerstage.kicad_pcb from below]

Board: 4 copper layers, 99.8 x 74.9 mm, 125 parts (97 on the bottom side), 97 nets.

Parts:
C1, C2, C5, C6, C7, C8, C9, C10, C11, C14, C17, C20, C21, C23, C24, C25, C26, C27, C28, C31: C; C_0603
C3, C4, C34, C35, C36, C37, C38, C39: C; C_0805
C12, C13, C16, C19, C22: C; C_1206
C15, C18: CP; TantalC_SizeR_EIA-2012
C29, C30: CP; C_Radial_D22_L41_P10
C32, C33: C; C_Rect_L27_W9_H17_P23
D1, D2, D5: LED; LED-1206
D3, D4, D6, D7, D8, D9, D10, D11, D12, D13, D14, D15, D16, D17, D18, D19: DIODE; Diode-MiniMELF_Standard
D20: ZENER; Diode-MiniMELF_Standard
D21: LED; LED-0805
D22, D23, D24: DIODE; Diode-DO-214BA
K1: CONN_3; WE313-3
P1, P2, P5: CONN_4; Socket_Strip_Straight_1x04
P3: CONN_12; Socket_Strip_Straight_1x12
P4: CONN_13; Socket_Strip_Straight_1x13
P6: CONN_7; Socket_Strip_Straight_1x07
P7: CONN_2; Socket_Strip_Straight_1x02
P8: CONN_4; SIP7
P9: CONN_2; WE313-2
P10, P11, P12, P13, P14, P15, P16: CONN_1; SolderWirePad_single_0-8mmDrill
Q1, Q2, Q3, Q4, Q5, Q6: MOSFET_N; TO-220_FET-GDS_Horizontal_LargePads
R1, R2, R3, R5, R6, R7, R12, R13, R17, R18, R22: R; R_0603
R20: R; Resistor_Horizontal_RM15mm
R21, R23, R24, R25, R26, R27, R28, R29, R30, R31, R32, R33, R34, R35, R36, R37: R; R_1206
U1: STM32F105RC; LQFP-64_10x10mm_Pitch0.5mm
U2: SI862x; SOIC-8-N
U3: NCP1117ST50T3G; SOT-223
U4: NCP1117ST33T3G; SOT-223
U5, U6, U7: ACS712; SOIC-8-N
U8, U9, U10: IR2184S; SOIC-8-N
X1: CRYSTAL_SMD; Crystal_SMD_0603_4Pads

Connections:
15V: C12.1, C16.1, C18.1, C37.1, C38.1, C39.1, D10.2, D22.1, D23.1, D24.1, P8.4, U3.3, U8.5, U9.5, U10.5
+3.3V: C4.1, C5.1, C6.1, C7.1, C8.1, C22.1, D3.2, D6.2, D8.2, D11.2, D13.2, D15.1, D16.2, D18.2, P2.4, U1.13, U1.19, U1.32, U1.48, U1.64, U2.8, U4.2
+3.3VP: C3.1, P5.4, U2.1
+5V: C19.1, C23.1, C24.1, C25.1, D10.1, D15.2, P2.3, U3.2, U4.3, U5.8, U6.8, U7.8
+24V: C13.1, C15.1, P7.1, P8.1
A: C34.2, Q1.S, Q2.D, R28.1, U5.1, U5.2, U8.6
ADC12_IN0: C9.1, D3.1, D4.2, P10.1, R23.2, R24.1, U1.14
ADC12_IN1: C11.1, D8.1, D9.2, P11.1, R28.2, R29.1, U1.15
ADC12_IN4: C17.1, D13.1, D14.2, P12.1, R30.2, R31.1, U1.20
ADC12_IN5: C21.1, D18.1, D19.2, P13.1, R32.2, R33.1, U1.21
ADC12_IN6: C10.1, D6.1, D7.2, P14.1, R6.1, R7.2, U1.22
ADC12_IN7: C14.1, D11.1, D12.2, P15.1, R12.1, R13.2, U1.23
ADC12_IN8: C20.1, D16.1, D17.2, P16.1, R17.1, R18.2, U1.26
Aout: K1.1, U5.3, U5.4
B: C35.2, Q3.S, Q4.D, R30.1, U6.1, U6.2, U9.6
BOOT0: P4.13, R1.2, U1.60
Bout: K1.2, U6.3, U6.4
C: C36.2, Q5.S, Q6.D, R32.1, U7.1, U7.2, U10.6
CURA: R17.2, U5.7
CURB: R12.2, U6.7
CURC: R6.2, U7.7
Cout: K1.3, U7.3, U7.4
GAH: Q1.G, R34.2
GAL: Q2.G, R25.1
GBH: Q3.G, R35.2
GBL: Q4.G, R26.1
GCH: Q5.G, R36.2
GCL: Q6.G, R27.1
GND: C1.2, C2.2, C4.2, C5.2, C6.2, C7.2, C8.2, C9.2, C10.2, C11.2, C12.2, C14.2, C16.2, C17.2, C18.2, C19.2, C20.2, C21.2, C22.2, C23.2, C24.2, C25.2, C26.2, C27.2, C28.2, C31.1, D4.1, D7.1, D9.1, D12.1, D14.1, D17.1, D19.1, P1.2, P2.1, P2.2, P8.3, R1.1, R2.2, R3.2, R5.2, R7.1, R13.1, R18.1, R37.2, U1.12, U1.18, U1.31, U1.47, U1.63, U2.5, U3.1, U4.1, U5.5, U6.5, U7.5, X1.3
GNDA: C3.2, C13.2, C15.2, P5.1, P7.2, P8.2, U2.4
GNDPWR: C29.2, C30.2, C32.2, C33.2, C37.2, C38.2, C39.2, D20.1, D21.2, P9.2, Q2.S, Q4.S, Q6.S, R20.2, R24.2, R29.2, R31.2, R33.2, R37.1, U8.3, U9.3, U10.3
HT: C29.1, C30.1, C32.1, C33.1, P9.1, Q1.D, Q3.D, Q5.D, R20.1, R21.1, R23.1
LED1: D1.2, U1.8
LED2: D2.2, U1.9
LED3: D5.2, U1.10
NRST: C31.2, P1.4, U1.7
unnamed: C1.1, U1.5, X1.1
unnamed: C2.1, U1.6, X1.2
unnamed: C26.1, U5.6
unnamed: C27.1, U6.6
unnamed: C28.1, U7.6
unnamed: C34.1, D22.2, U8.8
unnamed: C35.1, D23.2, U9.8
unnamed: C36.1, D24.2, U10.8
unnamed: D1.1, R2.1
unnamed: D2.1, R3.1
unnamed: D5.1, R5.1
unnamed: D20.2, R21.2, R22.1
unnamed: D21.1, R22.2
unnamed: R25.2, U8.4
unnamed: R26.2, U9.4
unnamed: R27.2, U10.4
unnamed: R34.1, U8.7
unnamed: R35.1, U9.7
unnamed: R36.1, U10.7
PA11: P6.7, U1.44
PA12: P6.6, U1.45
PA15: P4.12, U1.50
PB1: U1.27, U8.2
PB2: U1.28, U9.2
PB3: P4.7, U1.55, U10.2
PB4: P4.6, U1.56
PB5: P4.5, U1.57
PB6: P4.4, U1.58
PB7: P4.3, U1.59
PB8: P4.2, U1.61
PB9: P4.1, U1.62
PB10: P3.12, U1.29
PB11: P3.11, U1.30
PB12: P3.10, U1.33
PB13: P3.9, U1.34
PB14: P3.8, U1.35
PB15: P3.7, U1.36
PC3: P6.1, U1.11
PC4: P3.5, U1.24
PC5: P3.6, U1.25
PC6: P3.4, U1.37
PC7: P3.3, U1.38
PC8: P3.2, U1.39
PC9: P3.1, U1.40
PC10: P4.11, U1.51
PC11: P4.10, U1.52
PC12: P4.9, U1.53
PC13: P6.4, U1.2
PC14: P6.3, U1.3
PC15: P6.2, U1.4
PD2: P4.8, U1.54
RX: U1.17, U2.7
RX_I: P5.2, U2.3
SWCLK: P1.1, U1.49
SWDIO: P1.3, U1.46
TIM1_1: U1.41, U8.1
TIM1_2: U1.42, U9.1
TIM1_3: U1.43, U10.1
TX: U1.16, U2.6
TX_I: P5.3, U2.2
VBAT: P6.5, U1.1
