AndriesTuinhof/stmbl/hardware/old designs/kicad/diff_driver/diff_driver.kicad_pcb

## KiCad design hardware/old designs/kicad/diff_driver/diff_driver.kicad_pcb (2022-10-24, an earlier design)

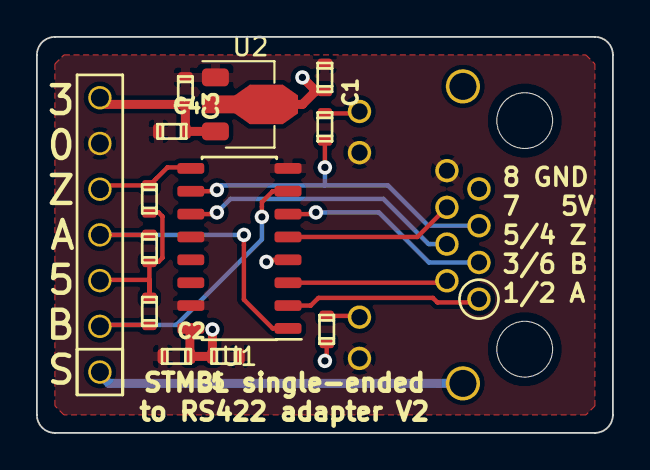
[picture p82: board diff_driver.kicad_pcb from above]

Board: 2 copper layers, 32.0 x 22.0 mm, 14 parts (1 on the bottom side), 15 nets.

Parts:
C1, C2, C3: 100n; C_0603
C4, C5: 1n; C_0603
J1: CONN_01X07; Pin_Header_RM2.54_1x7_UP
J2: RJ45_LED
R1, R2, R3: 3.9k; R_0603
R4, R5: 560; R_0603
U1: am26ls31; SOIC-16
U2: HT75XX-1; SOT-89-3

Connections:
+3V3: C3.1, C4.1, J1.7, U2.3
+5V: C1.1, C2.1, C5.1, J1.3, J2.7, R1.1, R2.1, R3.1, R4.1, U1.4, U1.16, U2.2
A: J1.4, R1.2, U1.1
B: J1.2, R2.2, U1.7
GND: C1.2, C2.2, C3.2, C4.2, C5.2, J1.6, J2.8, J2.9, J2.11, U1.8, U1.12, U1.15, U2.1
GNDA: J1.1, J2.13
IDX: J1.5, R3.2, U1.9
unnamed: J2.1, U1.2
unnamed: J2.2, U1.3
unnamed: J2.3, U1.6
unnamed: J2.4, U1.11
unnamed: J2.5, R5.1, U1.10
unnamed: J2.6, U1.5
unnamed: J2.10, R5.2
unnamed: J2.12, R4.2
