AndriesTuinhof/stmbl/hardware/old designs/kicad/11ua/11ua.kicad_pcb

## KiCad design hardware/old designs/kicad/11ua/11ua.kicad_pcb (2022-10-24, an earlier design)

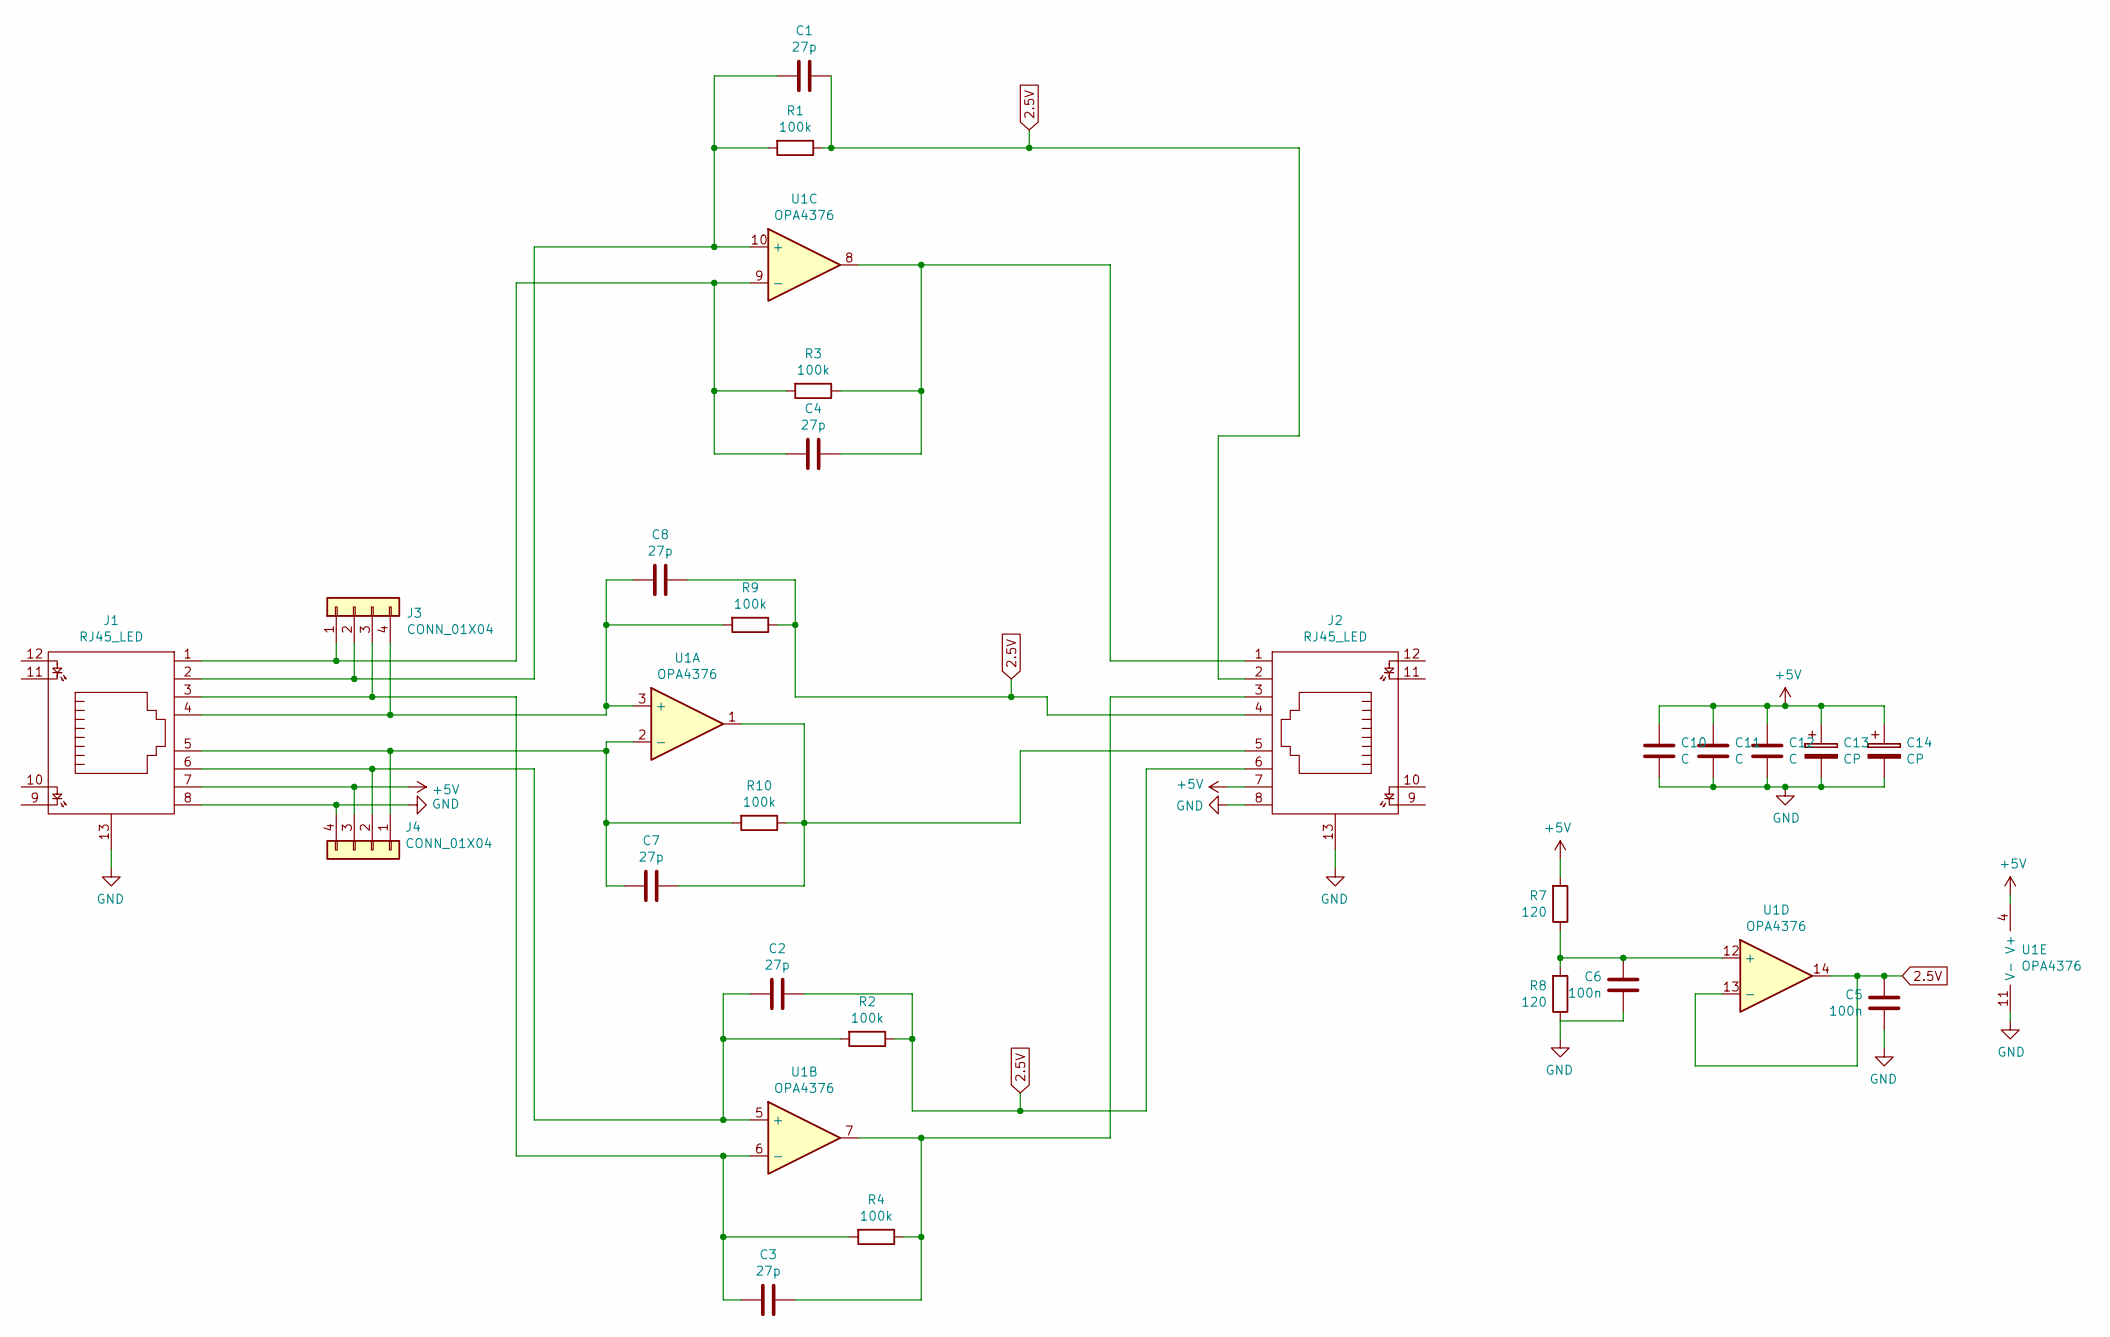
[picture p83: schematic 11ua.sch, 11µA to differential adapter with index]

Parts:
C1, C2, C3, C4, C7, C8: 27p; C_0603
C5, C6: 100n; C_0603
C10, C11, C12: C; C_0603
C13, C14: CP; CP_EIA-2012-15_AVX-P
J1, J2: RJ45_LED
J3, J4: CONN_01X04; RM3.81_1x4_UP
R1, R2, R3, R4, R9, R10: 100k; R_0603
R7, R8: 120; R_0603
U1: OPA4376; TSSOP-14_4.4x5mm_Pitch0.65mm

Connections:
2.5V: C1.1, C2.1, C5.2, C8.1, J2.2, J2.4, J2.6, R1.1, R2.1, R9.1, U1.13 (-), U1.14
+5V: C10.1, C11.1, C12.1, C13.1, C14.1, J1.7, J2.7, J4.3, R7.2, U1.4 (V+)
GND: C5.1, C6.1, C10.2, C11.2, C12.2, C13.2, C14.2, J1.8, J1.13, J2.8, J2.13, J4.4, R8.1, U1.11 (V-)
unnamed: C1.2, J1.2, J3.2, R1.2, U1.10 (+)
unnamed: C2.2, J1.6, J4.2, R2.2, U1.5 (+)
unnamed: C3.1, J2.3, R4.1, U1.7
unnamed: C3.2, J1.3, J3.3, R4.2, U1.6 (-)
unnamed: C4.1, J2.1, R3.1, U1.8
unnamed: C4.2, J1.1, J3.1, R3.2, U1.9 (-)
unnamed: C6.2, R7.1, R8.2, U1.12 (+)
unnamed: C7.1, J2.5, R10.1, U1.1
unnamed: C7.2, J1.5, J4.1, R10.2, U1.2 (-)
unnamed: C8.2, J1.4, J3.4, R9.2, U1.3 (+)

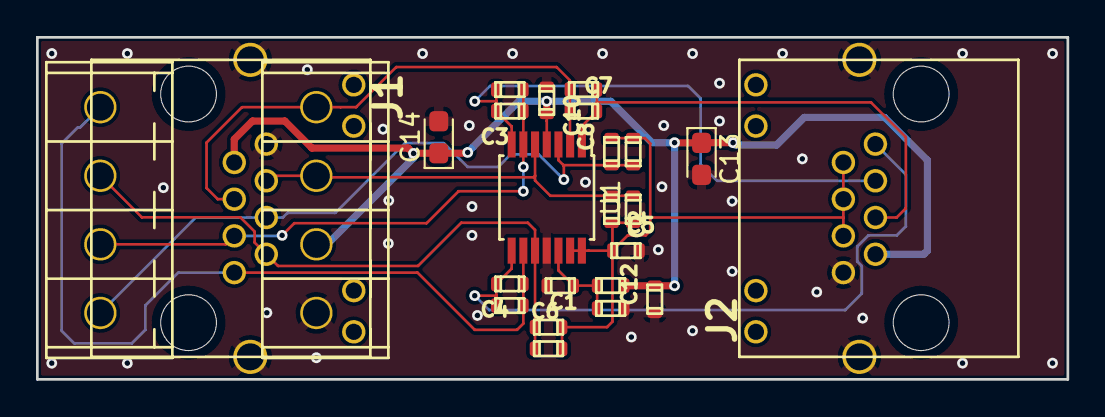
[picture p84: board 11ua.kicad_pcb from above]

Board: 2 copper layers, 57.2 x 19.0 mm, 26 parts (1 on the bottom side), 13 nets.
