AndriesTuinhof/stmbl/hardware/old designs/eagle/uhu-adapter.brd

## EAGLE design hardware/old designs/eagle/uhu-adapter.brd (2022-10-24, an earlier design)

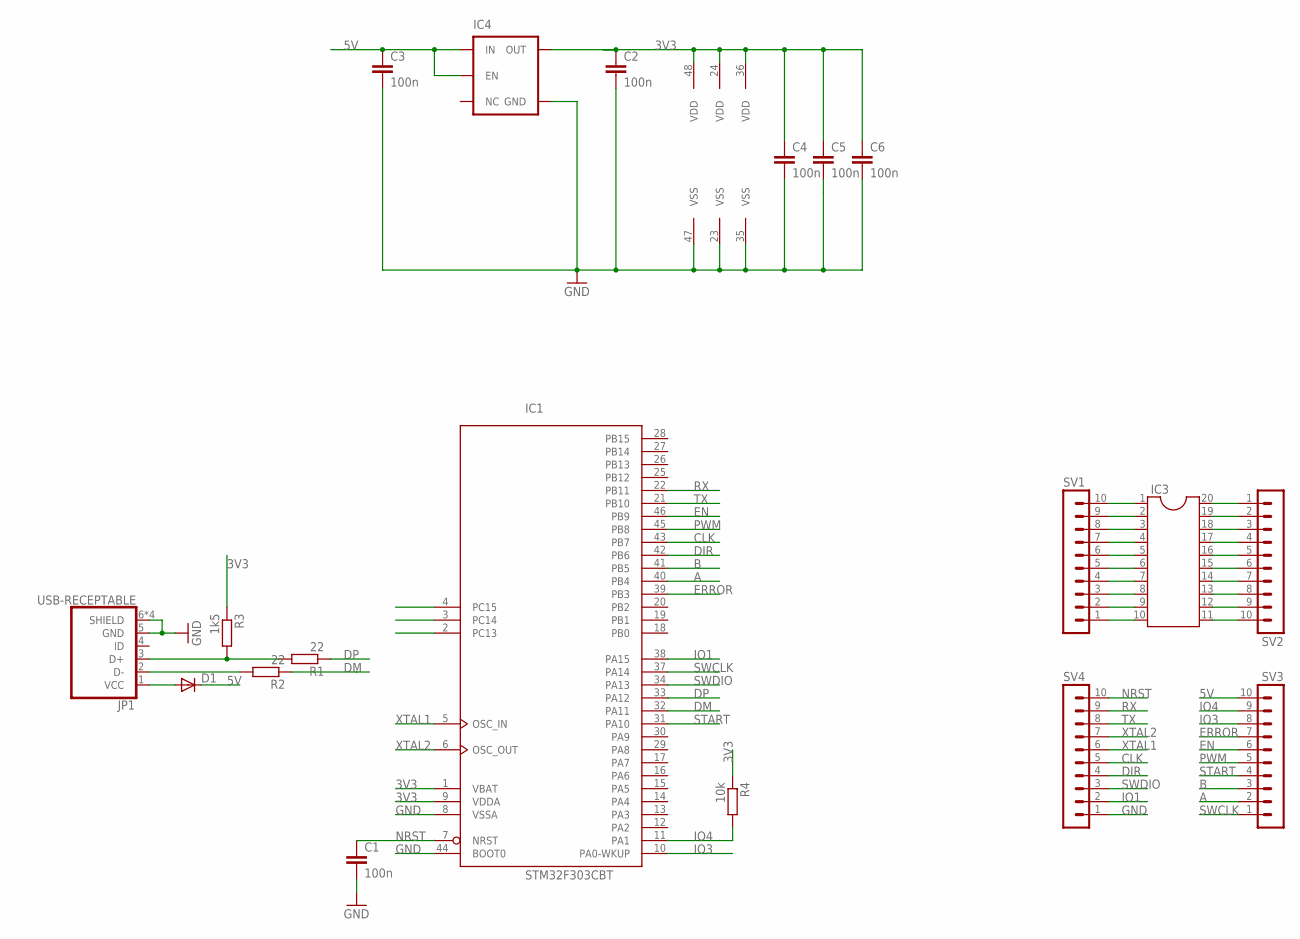
[picture p85: schematic uhu-adapter.sch]

Parts:
C1, C2, C3, C4, C5, C6: 100n; C0603
D1: DIODE-SOD123; SOD123
IC1: STM32F303CBT; LQFP48
IC3: DIL20
IC4: V_REG_TPS76433SOT23-5; SOT23-5
JP1: USB-RECEPTABLE; FCI-10103594-0001LF
R1, R2: 22; R0603
R3: 1k5; R0603
R4: 10k; R0603
SV1, SV2, SV3, SV4: MA10-1

Connections:
3V3: C2.1, C4.1, C5.1, C6.1, IC1.1 (VBAT), IC1.9 (VDDA), IC1.24 (VDD), IC1.36 (VDD), IC1.48 (VDD), IC4.5 (OUT), R3.1, R4.1
5V: C3.1, D1.C, IC4.1 (IN), IC4.3 (EN), SV3.10
5VUSB: D1.A, JP1.1 (VCC)
A: IC1.40 (PB4), SV3.2
B: IC1.41 (PB5), SV3.3
CLK: IC1.43 (PB7), SV4.5
DIR: IC1.42 (PB6), SV4.4
DM: IC1.32 (PA11), R2.1
DP: IC1.33 (PA12), R1.1
EN: IC1.46 (PB9), SV3.6
ERROR: IC1.39 (PB3), SV3.7
GND: C1.2, C2.2, C3.2, C4.2, C5.2, C6.2, IC1.8 (VSSA), IC1.23 (VSS), IC1.35 (VSS), IC1.44 (BOOT0), IC1.47 (VSS), IC4.2 (GND), JP1.5 (GND), JP1.6 (SHIELD), JP1.7 (SHIELD), JP1.8 (SHIELD), JP1.9 (SHIELD), SV4.1
IO1: IC1.38 (PA15), SV4.2
IO3: IC1.10 (PA0-WKUP), SV3.8
IO4: IC1.11 (PA1), R4.2, SV3.9
unnamed: IC3.10, SV1.1
unnamed: IC3.9, SV1.2
unnamed: IC3.8, SV1.3
unnamed: IC3.7, SV1.4
unnamed: IC3.6, SV1.5
unnamed: IC3.5, SV1.6
unnamed: IC3.4, SV1.7
unnamed: IC3.3, SV1.8
unnamed: IC3.2, SV1.9
unnamed: IC3.1, SV1.10
unnamed: IC3.20, SV2.1
unnamed: IC3.19, SV2.2
unnamed: IC3.18, SV2.3
unnamed: IC3.17, SV2.4
unnamed: IC3.16, SV2.5
unnamed: IC3.15, SV2.6
unnamed: IC3.14, SV2.7
unnamed: IC3.13, SV2.8
unnamed: IC3.12, SV2.9
unnamed: IC3.11, SV2.10
unnamed: JP1.3 (D+), R1.2, R3.2
unnamed: JP1.2 (D-), R2.2
NRST: C1.1, IC1.7 (NRST), SV4.10
PWM: IC1.45 (PB8), SV3.5
RX: IC1.22 (PB11), SV4.9
START: IC1.31 (PA10), SV3.4
SWCLK: IC1.37 (PA14), SV3.1
SWDIO: IC1.34 (PA13), SV4.3
TX: IC1.21 (PB10), SV4.8
XTAL1: IC1.5 (OSC_IN), SV4.6
XTAL2: IC1.6 (OSC_OUT), SV4.7

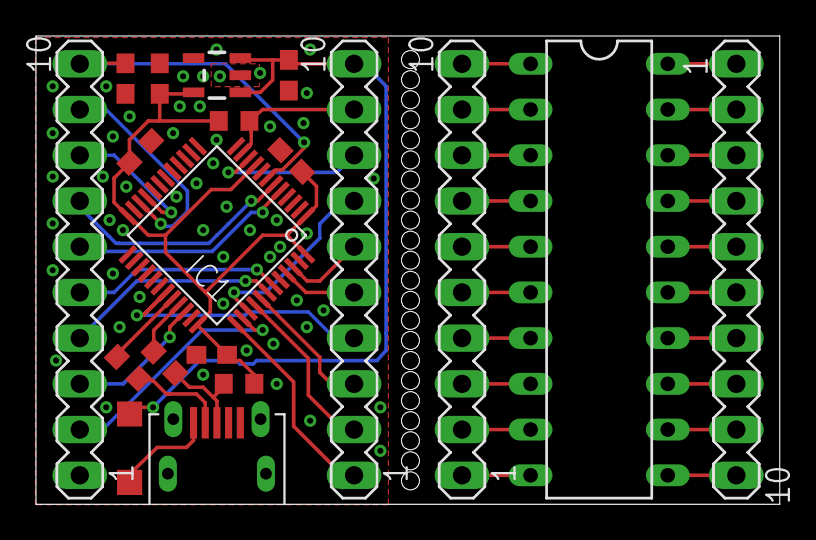
[picture p86: board uhu-adapter.brd from above]

Board: 2 copper layers, 41.3 x 26.0 mm, 19 parts (0 on the bottom side), 46 nets.
