AndriesTuinhof/stmbl/hardware/old designs/eagle/bene2stmbl-smd.brd

## EAGLE design hardware/old designs/eagle/bene2stmbl-smd.brd (2022-10-24, an earlier design)

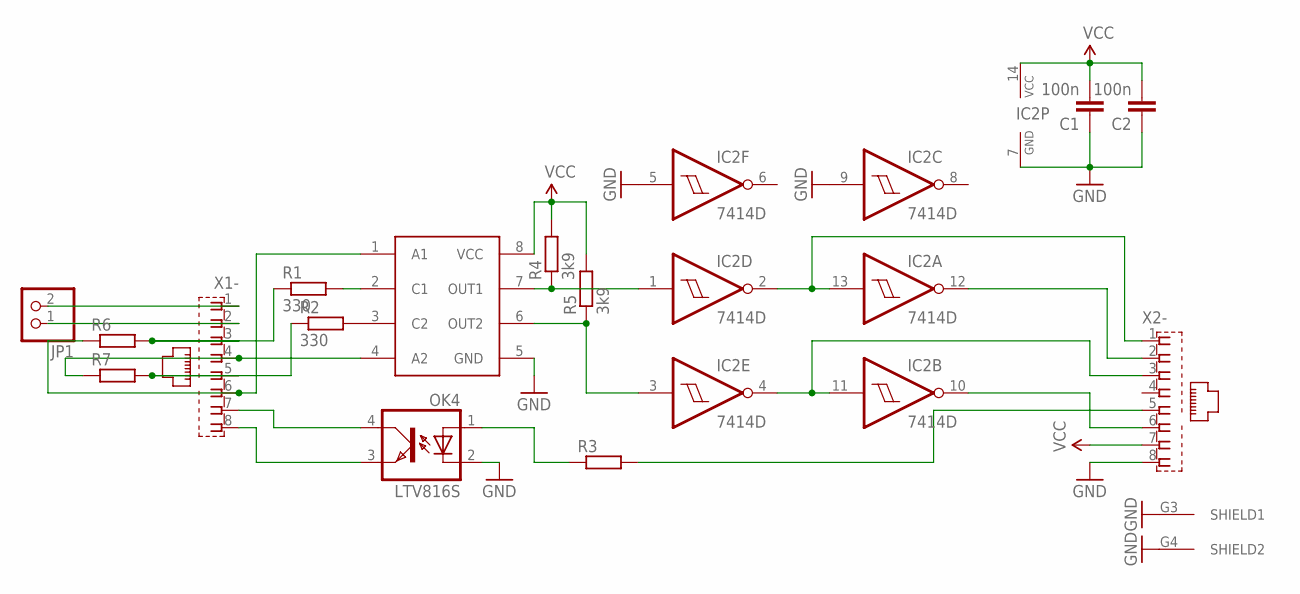
[picture p87: schematic bene2stmbl-smd.sch]

Parts:
C1, C2: 100n; C0603
IC2: 7414D; SO14
JP1: PINHD-1X2; 1X02
OK4: LTV816S; SMD4
R1, R2: 330; R0603
R3, R6, R7: R-EU_R0603; R0603
R4, R5: 3k9; R0603
U$1: HCPL-053L-SMD; SO08
X1, X2: RJ45

Connections:
GND: C1.1, C2.1, IC2.5 (I), IC2.7 (GND), IC2.9 (I), OK4.2 (C), U$1.5 (GND), X2.8, X2.G3 (SHIELD1), X2.G4 (SHIELD2)
unnamed: OK4.3 (EMIT), X1.8
unnamed: OK4.4 (COL), X1.7
unnamed: IC2.2 (O), IC2.13 (I), X2.1
unnamed: R6.1, U$1.1 (A1), X1.6
unnamed: IC2.4 (O), IC2.11 (I), X2.3
unnamed: R2.1, R7.2, X1.5
unnamed: R1.2, U$1.2 (C1)
unnamed: R2.2, U$1.3 (C2)
unnamed: JP1.1, X1.2
unnamed: JP1.2, X1.1
unnamed: IC2.1 (I), R4.1, U$1.7 (OUT1)
unnamed: IC2.12 (O), X2.2
unnamed: R1.1, R6.2, X1.3
unnamed: IC2.10 (O), X2.6
unnamed: OK4.1 (A), R3.1
unnamed: R7.1, U$1.4 (A2), X1.4
unnamed: R3.2, X2.5
unnamed: IC2.3 (I), R5.1, U$1.6 (OUT2)
VCC: C1.2, C2.2, IC2.14 (VCC), R4.2, R5.2, U$1.8 (VCC), X2.7

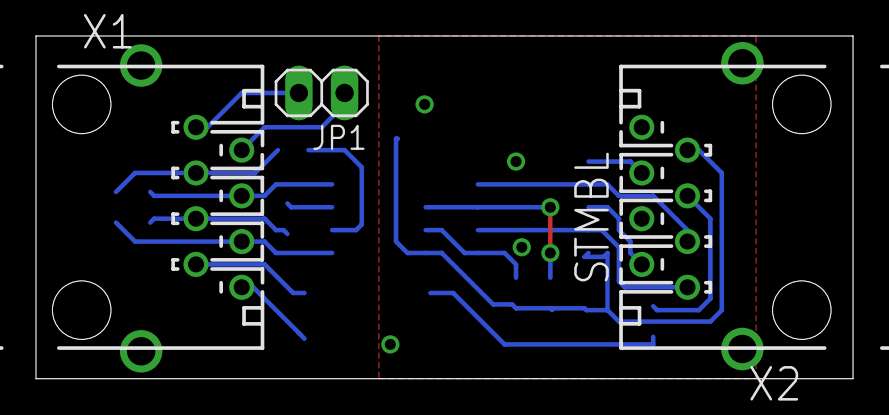
[picture p88: board bene2stmbl-smd.brd from above]

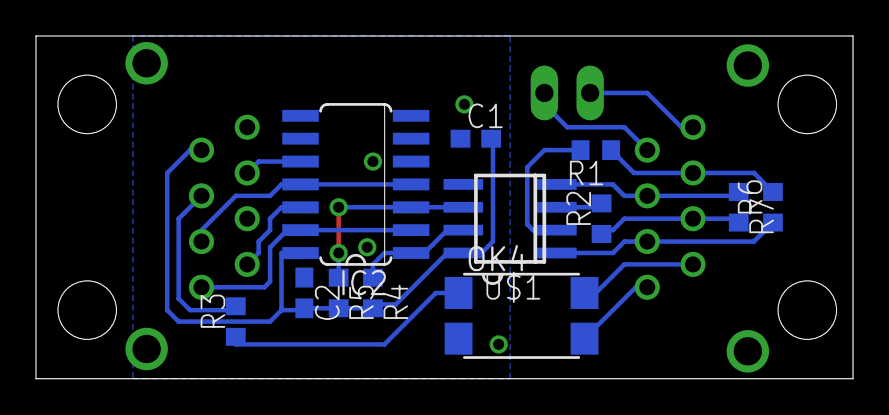
[picture p89: board bene2stmbl-smd.brd from below]

Board: 2 copper layers, 45.4 x 19.0 mm, 15 parts (12 on the bottom side), 20 nets.
