AndriesTuinhof/stmbl/hardware/old designs/eagle/IRAMX-drv-v3.1.brd

## EAGLE design hardware/old designs/eagle/IRAMX-drv-v3.1.brd (2022-10-24, an earlier design)

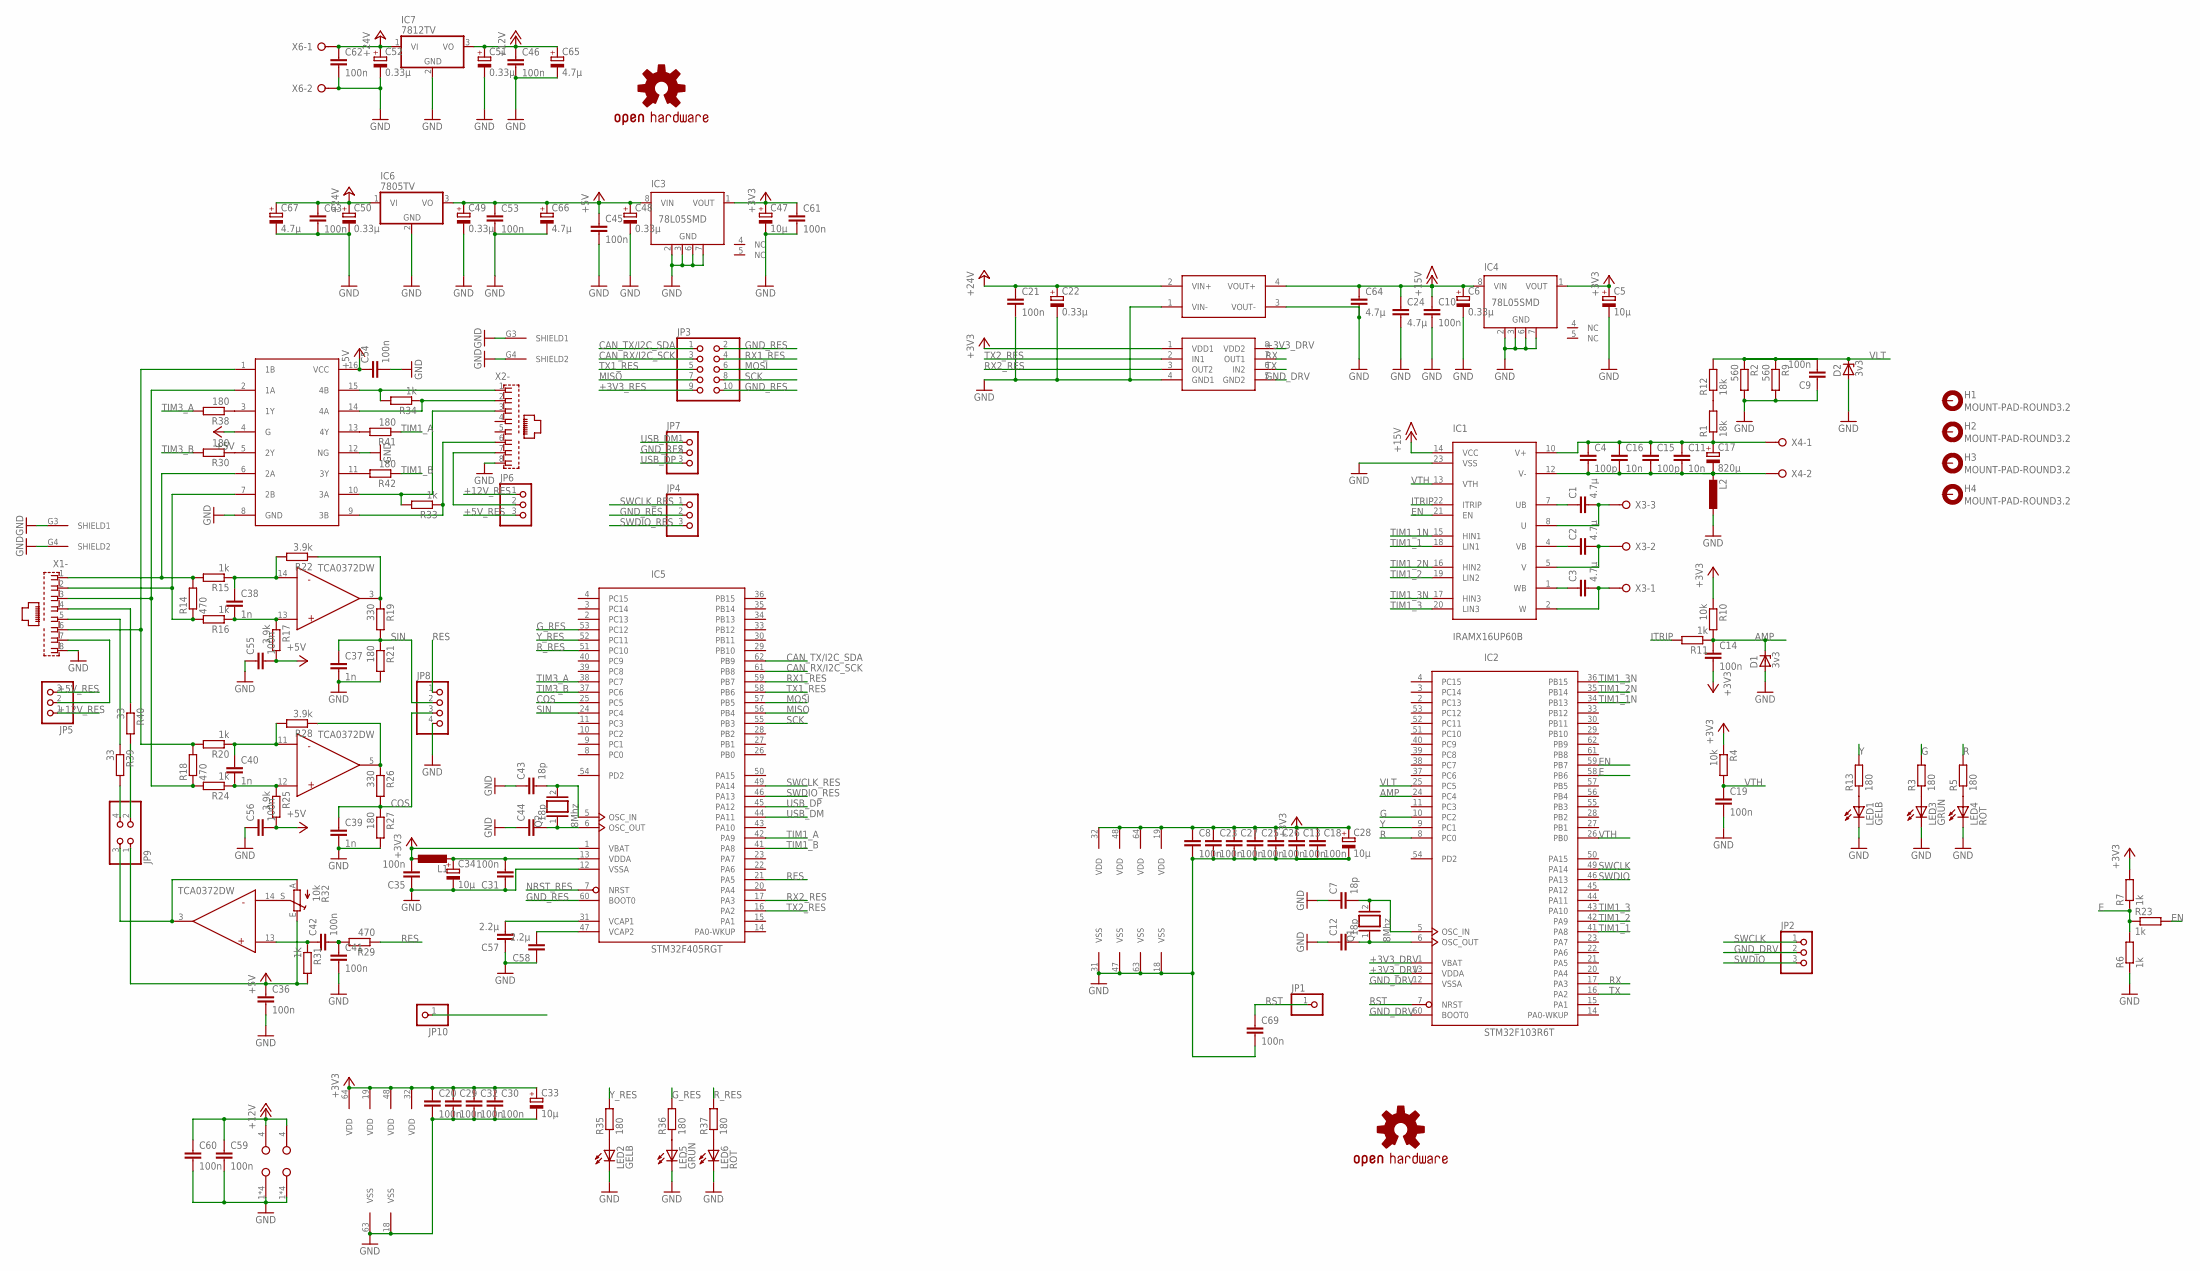
[picture p93: schematic IRAMX-drv-v3.1.sch]

Parts:
C1, C2, C3, C24, C64: 4.7µ; C0805K
C4, C15: 100p; C1206K
C5, C28, C33, C34, C47: 10µ; A/3216-18R
C6, C22, C48, C49, C50, C51, C52: 0.33µ; A/3216-18R
C7, C12, C43, C44: 18p; C0805
C8, C9, C10, C13, C14, C18, C19, C20, C21, C23, C25, C26, C27, C29, C30, C31, C32, C35, C36, C41, C42, C45, C46, C53, C54, C55, C56, C59, C60, C61, C62, C63, C69: 100n; C0805K
C11, C16: 10n; C0805K
C17: 820µ; EB35D
C37, C38, C39, C40: 1n; C0805K
C57, C58: 2.2µ; C0805K
C65, C66, C67: 4.7µ; E2,5-6
D1, D2: 3v3; SOD80C
H1, H2, H3, H4: MOUNT-PAD-ROUND3.2; 3,2-PAD
IC1: IRAMX16UP60B; SIP23_TOP
IC2: STM32F103R6T; LQFP64
IC3, IC4: 78L05SMD; SO08
IC5: STM32F405RGT; LQFP64
IC6: 7805TV; TO220V
IC7: 7812TV; TO220V
JP1, JP10: PINHD-1X1; 1X01
JP2, JP4, JP5, JP6, JP7: PINHD-1X3; 1X03
JP3: PINHD-2X5; 2X05
JP8: PINHD-1X4; 1X04
JP9: PINHD-2X2; 2X02
L1, L2: L-EUL2825P; L2825P
LED1, LED2: GELB; LED3MM
LED3, LED5: GRÜN; LED3MM
LED4, LED6: ROT; LED3MM
LOGO1, LOGO2: OSHW-LOGOL; OSHW-LOGO-L
Q1, Q2: 8Mhz; QS
R1, R12: 18k; CER
R2, R9: 560; R0805
R3, R5, R13, R21, R27, R30, R35, R36, R37, R38, R41, R42: 180; R0805
R4, R10: 10k; R0805
R6, R7, R11, R15, R16, R20, R23, R24, R31, R33, R34: 1k; R0805
R14, R18, R29: 470; R0805
R17, R22, R25, R28: 3.9k; R0805
R19, R26: 330; R0805
R32: 10k; CA6V
R39, R40: 33; R0805
U$1: SI8621; SOIC08
U$2: RO-XXXX; SIP4
U$3, U$4: TCA0372DWDM2; TCA0372DM2
U$5: AM26LS32ACD; SO16
X1, X2: RJ45
X3: W237-03P; W237-133
X4, X6: W237-02P; W237-132

Connections:
+3V3_DRV: C5.+, C8.1, C13.1, C14.2, C18.1, C23.1, C25.1, C26.1, C27.1, C28.+, IC2.1 (VBAT), IC2.13 (VDDA), IC2.19 (VDD), IC2.32 (VDD), IC2.48 (VDD), IC2.64 (VDD), IC4.1 (VOUT), R4.1, R7.2, R10.1, U$1.8 (VDD2)
+3V3_RES: C20.1, C29.1, C30.1, C32.1, C33.+, C35.2, C47.+, C61.1, IC3.1 (VOUT), IC5.1 (VBAT), IC5.19 (VDD), IC5.32 (VDD), IC5.48 (VDD), IC5.64 (VDD), JP3.9, L1.1, U$1.1 (VDD1)
+5V_RES: C36.1, C45.1, C48.+, C49.+, C53.1, C54.1, C55.2, C56.2, C66.+, IC3.8 (VIN), IC6.3 (VO), JP5.3, JP6.3, JP9.1, R17.2, R25.2, R31.2, R32.E, U$5.4 (G), U$5.16 (VCC)
+12V_RES: C46.1, C51.+, C59.1, C60.1, C65.+, IC7.3 (VO), JP5.1, JP6.1, U$3.4 (VCC), U$4.4 (VCC)
+15V_DRV: C6.+, C10.1, C24.1, C64.1, IC1.14 (VCC), IC4.8 (VIN), U$2.4 (VOUT+)
+24V_RES: C21.1, C22.+, C50.+, C52.+, C62.1, C63.1, C67.+, IC6.1 (VI), IC7.1 (VI), U$2.2 (VIN+), X6.1
AMP: C14.1, D1.C, IC2.24 (PC4), R10.2, R11.1
CAN_RX/I2C_SCK: IC5.61 (PB8), JP3.3
CAN_TX/I2C_SDA: IC5.62 (PB9), JP3.1
COS: C39.1, IC5.25 (PC5), JP8.3, R26.2, R27.1
E: IC2.58 (PB6), R6.2, R7.1, R23.1
EN: IC1.21 (EN), IC2.59 (PB7), R23.2
G: IC2.10 (PC2), R3.2
GND_DRV: C5.-, C6.-, C7.1, C8.2, C9.1, C10.2, C12.1, C13.2, C18.2, C19.2, C23.2, C24.2, C25.2, C26.2, C27.2, C28.-, C64.2, C69.2, D1.A, D2.A, IC1.23 (VSS), IC2.12 (VSSA), IC2.18 (VSS), IC2.31 (VSS), IC2.47 (VSS), IC2.60 (BOOT0), IC2.63 (VSS), IC4.2 (GND), IC4.3 (GND), IC4.6 (GND), IC4.7 (GND), JP2.2, L2.1, LED1.K (C), LED3.K (C), LED4.K (C), R2.2, R6.1, R9.2, U$1.5 (GND2), U$2.3 (VOUT-)
GND_RES: C20.2, C21.2, C22.-, C29.2, C30.2, C31.1, C32.2, C33.-, C34.-, C35.1, C36.2, C37.2, C39.2, C41.2, C43.1, C44.1, C45.2, C46.2, C47.-, C48.-, C49.-, C50.-, C51.-, C52.-, C53.2, C54.2, C55.1, C56.1, C57.1, C58.1, C59.2, C60.2, C61.2, C62.2, C63.2, C65.-, C66.-, C67.-, IC3.2 (GND), IC3.3 (GND), IC3.6 (GND), IC3.7 (GND), IC5.12 (VSSA), IC5.18 (VSS), IC5.60 (BOOT0), IC5.63 (VSS), IC6.2 (GND), IC7.2 (GND), JP3.2, JP3.10, JP4.2, JP7.2, JP8.4, LED2.K (C), LED5.K (C), LED6.K (C), R21.2, R27.2, U$1.4 (GND1), U$2.1 (VIN-), U$3.1 (GND), U$3.8 (GND), U$3.9 (GND), U$3.16 (GND), U$4.1 (GND), U$4.8 (GND), U$4.9 (GND), U$4.16 (GND), U$5.8 (GND), U$5.12 (NG), X1.8, X1.G3 (SHIELD1), X1.G4 (SHIELD2), X2.8, X2.G3 (SHIELD1), X2.G4 (SHIELD2), X6.2
G_RES: IC5.53 (PC12), R36.2
ITRIP: IC1.22 (ITRIP), R11.2
MISO: IC5.56 (PB4), JP3.7
MOSI: IC5.57 (PB5), JP3.6
unnamed: C1.1, IC1.7 (UB)
unnamed: R1.P$2 (2), R12.P$1 (1)
unnamed: C2.1, IC1.4 (VB)
unnamed: LED2.A, R35.1
unnamed: C3.1, IC1.1 (WB)
unnamed: R32.S, U$4.14 (IN-)
unnamed: LED3.A, R3.1
unnamed: LED4.A, R5.1
unnamed: C7.2, IC2.5 (OSC_IN), Q1.2
unnamed: LED5.A, R36.1
unnamed: C12.2, IC2.6 (OSC_OUT), Q1.1
unnamed: C58.2, IC5.47 (VCAP2)
unnamed: C57.2, IC5.31 (VCAP1)
unnamed: C44.2, IC5.6 (OSC_OUT), Q2.1
unnamed: JP5.2, X1.7
unnamed: JP9.4, R39.2
unnamed: R19.1, R22.1, U$3.3 (OUT)
unnamed: C38.2, R16.1, R17.1, U$3.13 (IN+)
unnamed: LED6.A, R37.1
unnamed: JP9.2, R40.2
unnamed: C40.2, R24.1, R25.1, U$3.12 (IN+)
unnamed: JP6.2, X2.7
unnamed: R26.1, R28.1, U$3.5 (OUT)
unnamed: R40.1, X1.4
unnamed: C40.1, R20.1, R28.2, U$3.11 (IN-)
unnamed: R34.2, U$5.15 (4B), X2.1
unnamed: C41.1, C42.2, R29.2
unnamed: C42.1, R31.1, U$4.13 (IN+)
unnamed: C38.1, R15.1, R22.2, U$3.14 (IN-)
unnamed: JP9.3, R32.A, U$4.3 (OUT)
unnamed: R39.1, X1.5
unnamed: R30.1, U$5.5 (2Y)
unnamed: R34.1, U$5.14 (4A), X2.2
unnamed: R33.2, U$5.10 (3A), X2.3
unnamed: R33.1, U$5.9 (3B), X2.6
unnamed: C43.2, IC5.5 (OSC_IN), Q2.2
unnamed: R18.2, R20.2, U$5.1 (1B), X1.6
unnamed: R14.1, R16.2, U$5.7 (2B), X1.2
unnamed: R42.2, U$5.11 (3Y)
unnamed: LED1.A, R13.1
unnamed: R41.2, U$5.13 (4Y)
unnamed: R38.1, U$5.3 (1Y)
unnamed: C31.2, C34.+, IC5.13 (VDDA), L1.2
unnamed: R14.2, R15.2, U$5.6 (2A), X1.1
unnamed: R18.1, R24.2, U$5.2 (1A), X1.3
NRST_RES: IC5.7 (NRST), JP10.1
R: IC2.8 (PC0), R5.2
RES: IC5.21 (PA5), JP8.1, R29.1
RST: C69.1, IC2.7 (NRST), JP1.1
RX: IC2.17 (PA3), U$1.7 (OUT1)
RX1_RES: IC5.59 (PB7), JP3.4
RX2_RES: IC5.17 (PA3), U$1.3 (OUT2)
R_RES: IC5.51 (PC10), R37.2
SCK: IC5.55 (PB3), JP3.8
SIN: C37.1, IC5.24 (PC4), JP8.2, R19.2, R21.1
SWCLK: IC2.49 (PA14), JP2.1
SWCLK_RES: IC5.49 (PA14), JP4.1
SWDIO: IC2.46 (PA13), JP2.3
SWDIO_RES: IC5.46 (PA13), JP4.3
TIM1_1: IC1.18 (LIN1), IC2.41 (PA8)
TIM1_1N: IC1.15 (HIN1), IC2.34 (PB13)
TIM1_2: IC1.19 (LIN2), IC2.42 (PA9)
TIM1_2N: IC1.16 (HIN2), IC2.35 (PB14)
TIM1_3: IC1.20 (LIN3), IC2.43 (PA10)
TIM1_3N: IC1.17 (HIN3), IC2.36 (PB15)
TIM1_A: IC5.42 (PA9), R41.1
TIM1_B: IC5.41 (PA8), R42.1
TIM3_A: IC5.38 (PC7), R38.2
TIM3_B: IC5.37 (PC6), R30.2
TX: IC2.16 (PA2), U$1.6 (IN2)
TX1_RES: IC5.58 (PB6), JP3.5
TX2_RES: IC5.16 (PA2), U$1.2 (IN1)
U: C1.2, IC1.8 (U), X3.3
USB_DM: IC5.44 (PA11), JP7.1
USB_DP: IC5.45 (PA12), JP7.3
V: C2.2, IC1.5 (V), X3.2
V+: C4.1, C11.1, C15.1, C16.1, C17.+, IC1.10 (V+), R1.P$1 (1), X4.1
V-: C4.2, C11.2, C15.2, C16.2, C17.-, IC1.12 (V-), L2.2, X4.2
VLT: C9.2, D2.C, IC2.25 (PC5), R2.1, R9.1, R12.P$2 (2)
VTH: C19.1, IC1.13 (VTH), IC2.26 (PB0), R4.2
W: C3.2, IC1.2 (W), X3.1
Y: IC2.9 (PC1), R13.2
Y_RES: IC5.52 (PC11), R35.2

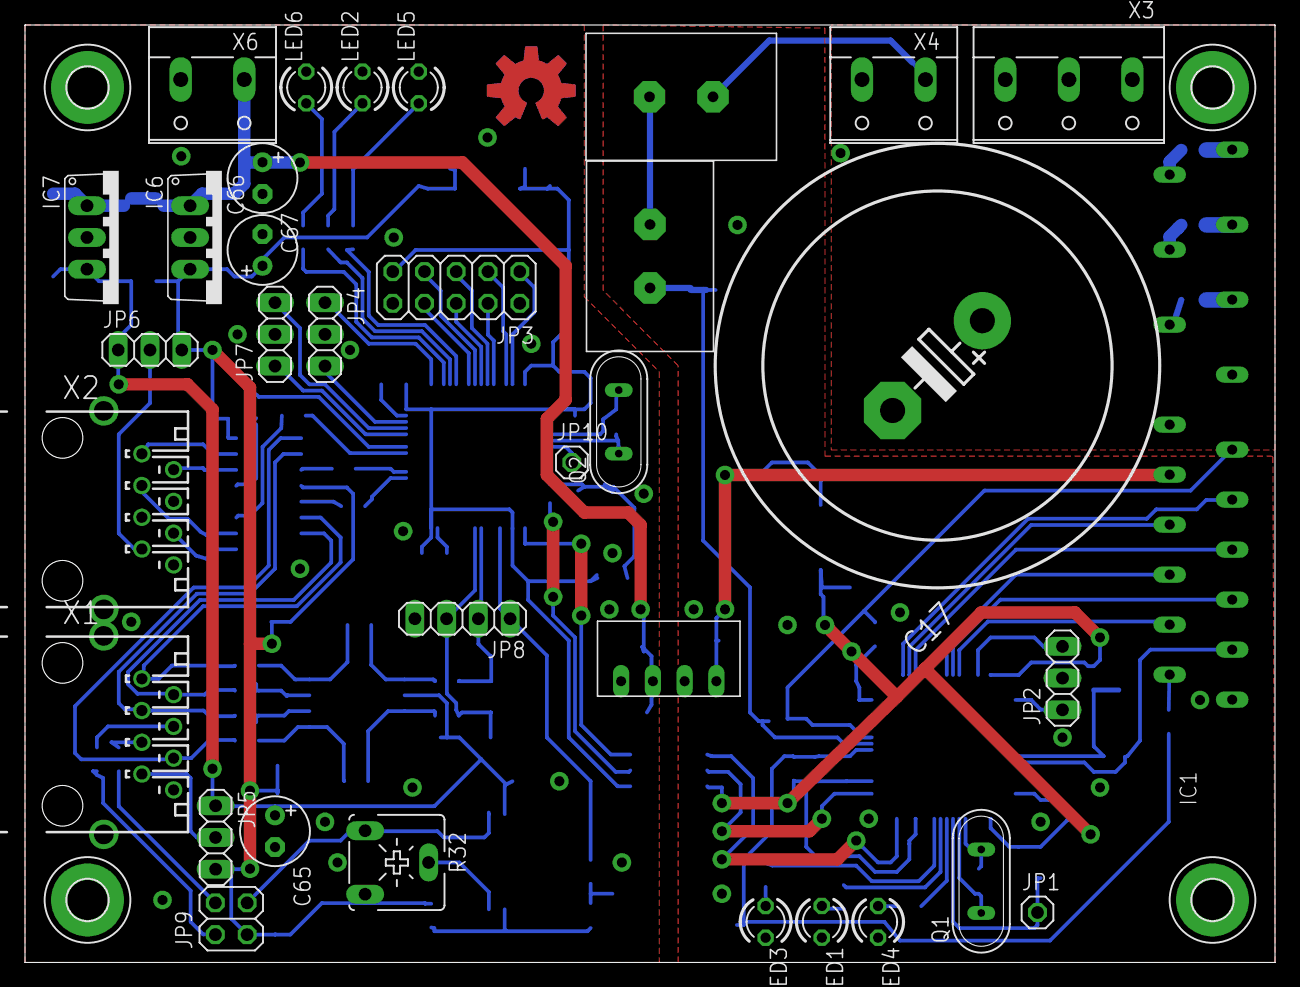
[picture p94: board IRAMX-drv-v3.1.brd from above]

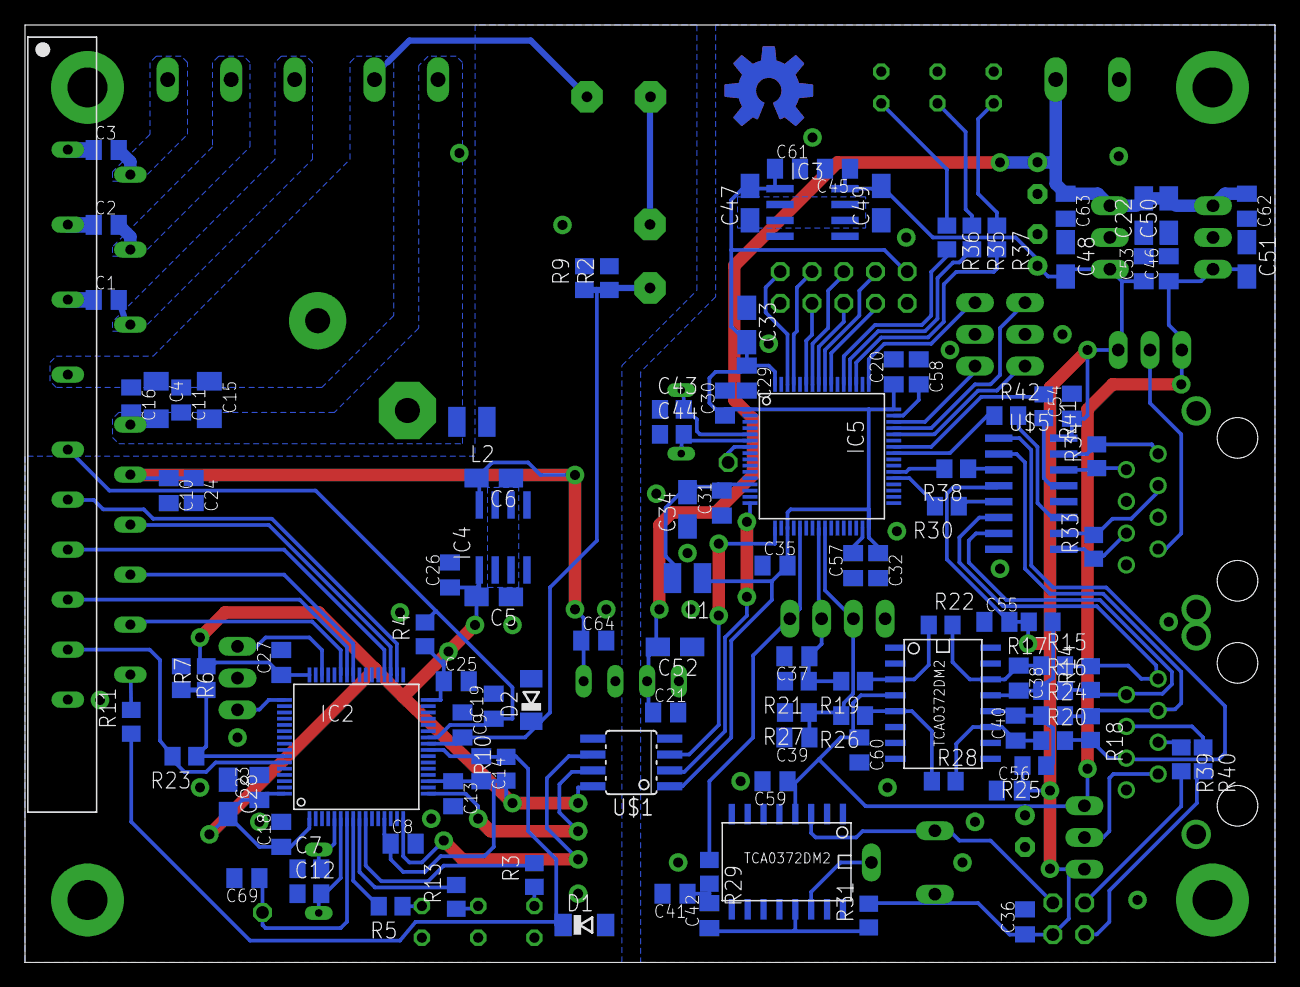
[picture p95: board IRAMX-drv-v3.1.brd from below]

Board: 2 copper layers, 100.0 x 75.0 mm, 154 parts (115 on the bottom side), 102 nets.
