AndriesTuinhof/stmbl/hardware/old designs/eagle/IRAMX-drv-v3.4.brd

## EAGLE design hardware/old designs/eagle/IRAMX-drv-v3.4.brd (2022-10-24, an earlier design)

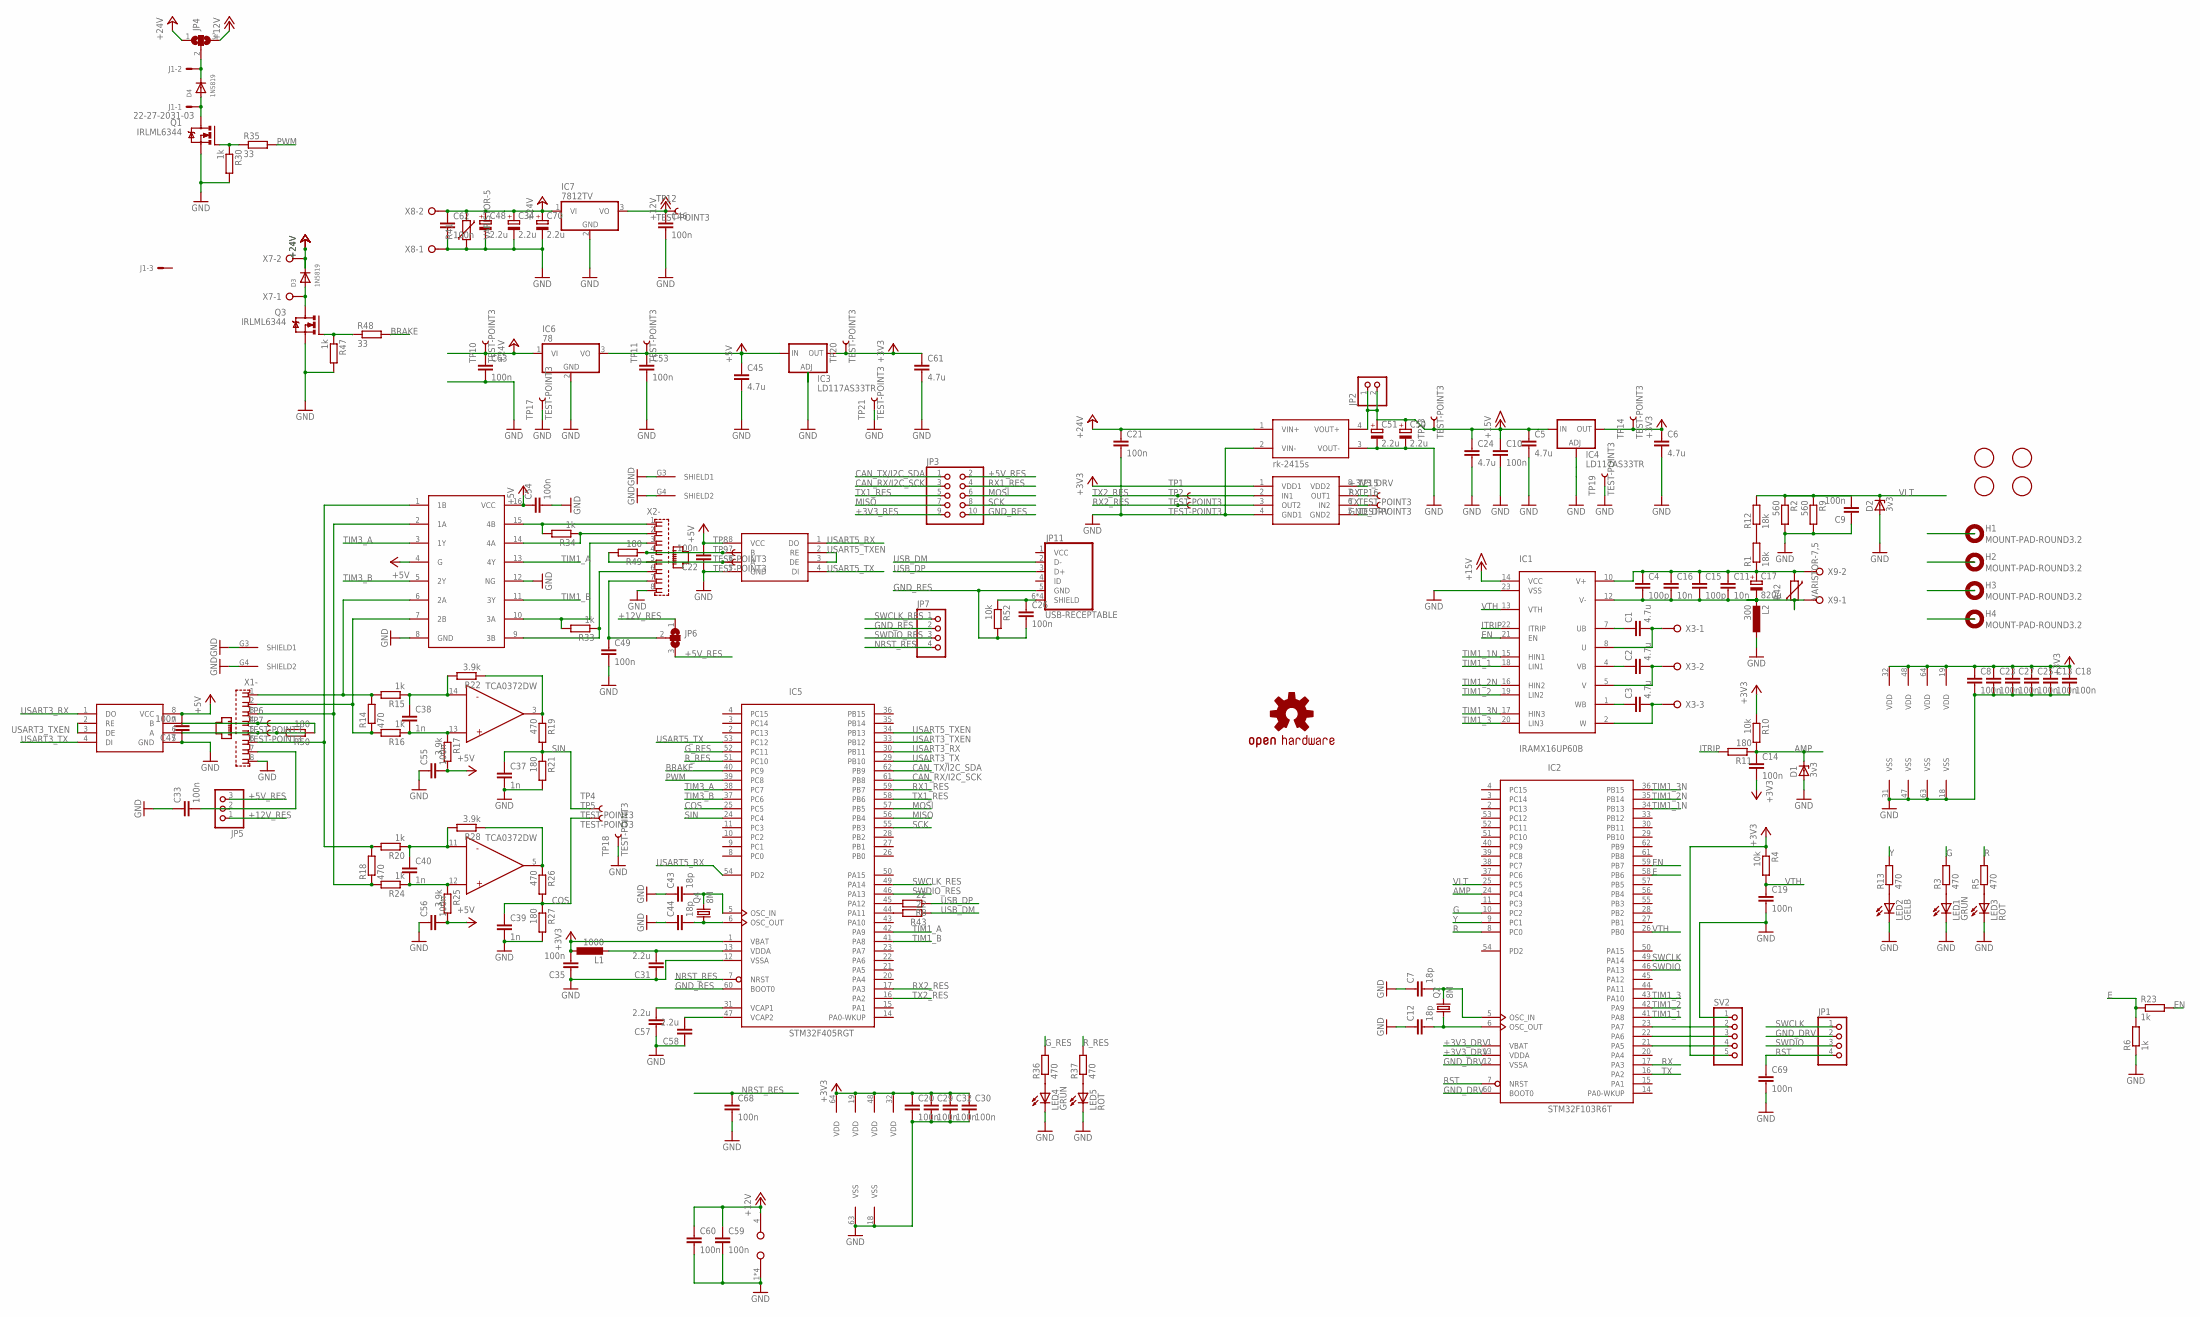
[picture p96: schematic IRAMX-drv-v3.4.sch]

Parts:
C1, C2, C3, C5, C6, C24, C45, C61: 4.7u; C0805
C4, C15: 100p; C1206K
C7, C12, C43, C44: 18p; C0603
C8, C9, C10, C13, C14, C18, C19, C20, C21, C22, C23, C25, C26, C27, C29, C30, C32, C33, C35, C46, C47, C49, C53, C54, C55, C56, C59, C60, C62, C63, C68, C69: 100n; C0603
C11, C16: 10n; C1206K
C17: 820µ; EB35D
C31, C57, C58: 2.2u; C0603
C34, C50, C70: 2.2u; 153CLV-0405
C37, C38, C39, C40: 1n; C0603
C48, C51: 2.2u; E2,5-6E
D1, D2: 3v3; SOD80C
D3, D4: 1N5819; SOD-123
H1, H2, H3, H4: MOUNT-PAD-ROUND3.2; 3,2-PAD
IC1: IRAMX16UP60B; SIP23_TOP
IC2: STM32F103R6T; LQFP64
IC3, IC4: LD117AS33TR; SOT223
IC5: STM32F405RGT; LQFP64
IC6: 78; R-78E
IC7: 7812TV; TO220V
IC8, IC9: ADM485SOIC8; SOIC08
IC10: TCA0372DWDM2; TCA0372DM2
IC12: SI8621; SOIC08
IC13: AM26LS32ACD; SO16
IC14: rk-2415s; SIP7
J1: 22-27-2031-03; 6410-03
JP1, JP7: PINHD-1X4; 1X04
JP2: PINHD-1X2; 1X02
JP3: PINHD-2X5; 2X05
JP4, JP6: SJ2W; SJ_2
JP5: PINHD-1X3; 1X03
JP11: USB-RECEPTABLE; FCI-10103594-0001LF
L1: 1000; L2825P
L2: 300; L2825P
LED1, LED4: GRÜN; LED3MM
LED2: GELB; LED3MM
LED3, LED5: ROT; LED3MM
LOGO1: OSHW-LOGOL; OSHW-LOGO-L
Q1, Q3: IRLML6344; MICRO3
Q2, Q4: 8M; CTS406
R1, R12: 18k; CER
R2, R9: 560; R0805
R3, R5, R13, R14, R18, R19, R26, R36, R37: 470; R0603
R4, R10, R52: 10k; R0603
R6, R15, R16, R20, R23, R24, R30, R33, R34, R47: 1k; R0603
R8, R43: 22; R0603
R11, R21, R27, R49, R50: 180; R0603
R17, R22, R25, R28: 3.9k; R0603
R35, R48: 33; R0603
R41: VARISTOR-5; R-5
R42: VARISTOR-7,5; R-7,5
SV2: PINHD-1X5; 1X05
TP1, TP2, TP4, TP5, TP6, TP7, TP8, TP9, TP10, TP11, TP12, TP13, TP14, TP15, TP16, TP17, TP18, TP19, TP20, TP21: TEST-POINT3; PAD.03X.03
U$8, U$9, U$10, U$11: FIDUCIAL; FIDUCIAL_1MM
X1, X2: RJ45
X3: AKL230-03
X7, X8, X9: AKL230-02

Connections:
+3V3_DRV: C6.1, C8.1, C13.1, C14.2, C18.1, C23.1, C25.1, C27.1, IC2.1 (VBAT), IC2.13 (VDDA), IC2.19 (VDD), IC2.32 (VDD), IC2.48 (VDD), IC2.64 (VDD), IC4.2 (OUT), IC4.4 (OUT), IC12.8 (VDD2), R4.1, R10.1, SV2.5, TP14.P$1
+3V3_RES: C20.1, C29.1, C30.1, C32.1, C35.2, C61.1, IC3.2 (OUT), IC3.4 (OUT), IC5.1 (VBAT), IC5.19 (VDD), IC5.32 (VDD), IC5.48 (VDD), IC5.64 (VDD), IC12.1 (VDD1), JP3.9, L1.1, TP20.P$1
+5V_RES: C22.2, C45.1, C47.2, C53.1, C54.1, C55.2, C56.2, IC3.3 (IN), IC6.3 (VO), IC8.8 (VCC), IC9.8 (VCC), IC13.4 (G), IC13.16 (VCC), JP3.2, JP5.3, JP6.3, R17.2, R25.2, TP11.P$1
+12V_RES: C46.1, C59.1, C60.1, IC7.3 (VO), IC10.4 (VCC), JP4.3, JP5.1, JP6.1, TP12.P$1
+15V_DRV: C5.1, C10.1, C24.1, C50.+, C51.+, IC1.14 (VCC), IC4.3 (IN), IC14.4 (VOUT+), JP2.1, JP2.2, TP13.P$1
+24V_RES: C21.1, C34.+, C48.+, C62.1, C63.1, C70.+, D3.C, IC6.1 (VI), IC7.1 (VI), IC14.1 (VIN+), JP4.1, R41.1, TP10.P$1, X7.2, X8.2
AMP: C14.1, D1.C, IC2.24 (PC4), R10.2, R11.1
BRAKE: IC5.40 (PC9), R48.2
CAN_RX/I2C_SCK: IC5.61 (PB8), JP3.3
CAN_TX/I2C_SDA: IC5.62 (PB9), JP3.1
COS: C39.1, IC5.25 (PC5), R26.2, R27.1, TP5.P$1
E: IC2.58 (PB6), R6.2, R23.1
EN: IC1.21 (EN), IC2.59 (PB7), R23.2
G: IC2.10 (PC2), R3.2
GND_DRV: C5.2, C6.2, C7.1, C8.2, C9.1, C10.2, C12.1, C13.2, C18.2, C19.2, C23.2, C24.2, C25.2, C27.2, C50.-, C51.-, C69.2, D1.A, D2.A, IC1.23 (VSS), IC2.12 (VSSA), IC2.18 (VSS), IC2.31 (VSS), IC2.47 (VSS), IC2.60 (BOOT0), IC2.63 (VSS), IC4.1 (ADJ), IC12.5 (GND2), IC14.3 (VOUT-), JP1.2, L2.1, LED1.K (C), LED2.K (C), LED3.K (C), R2.2, R6.1, R9.2, SV2.1, TP19.P$1
GND_RES: C20.2, C21.2, C22.1, C26.2, C29.2, C30.2, C31.1, C32.2, C33.1, C34.-, C35.1, C37.2, C39.2, C43.1, C44.1, C45.2, C46.2, C47.1, C48.-, C49.2, C53.2, C54.2, C55.1, C56.1, C57.1, C58.1, C59.2, C60.2, C61.2, C62.2, C63.2, C68.2, C70.-, IC3.1 (ADJ), IC5.12 (VSSA), IC5.18 (VSS), IC5.60 (BOOT0), IC5.63 (VSS), IC6.2 (GND), IC7.2 (GND), IC8.5 (GND), IC9.5 (GND), IC10.1 (GND), IC10.8 (GND), IC10.9 (GND), IC10.16 (GND), IC12.4 (GND1), IC13.8 (GND), IC13.12 (NG), IC14.2 (VIN-), JP3.10, JP7.2, JP11.5 (GND), LED4.K (C), LED5.K (C), Q1.2 (S), Q3.2 (S), R21.2, R27.2, R30.2, R41.2, R47.2, R52.2, TP17.P$1, TP18.P$1, TP21.P$1, X1.8, X1.G3 (SHIELD1), X1.G4 (SHIELD2), X2.8, X2.G3 (SHIELD1), X2.G4 (SHIELD2), X8.1
G_RES: IC5.52 (PC11), R36.2
ITRIP: IC1.22 (ITRIP), R11.2
MISO: IC5.56 (PB4), JP3.7
MOSI: IC5.57 (PB5), JP3.6
unnamed: C1.1, IC1.7 (UB)
unnamed: R1.P$2 (2), R12.P$1 (1)
unnamed: C2.1, IC1.4 (VB)
unnamed: C3.1, IC1.1 (WB)
unnamed: LED1.A, R3.1
unnamed: LED3.A, R5.1
unnamed: C7.2, IC2.5 (OSC_IN), Q2.3 (2)
unnamed: LED4.A, R36.1
unnamed: C12.2, IC2.6 (OSC_OUT), Q2.1
unnamed: C33.2, JP5.2, X1.7
unnamed: IC10.3 (OUT), R19.1, R22.1
unnamed: C38.2, IC10.13 (IN+), R16.1, R17.1
unnamed: LED5.A, R37.1
unnamed: C40.2, IC10.12 (IN+), R24.1, R25.1
unnamed: C49.1, JP6.2, X2.7
unnamed: IC10.5 (OUT), R26.1, R28.1
unnamed: IC9.7 (B), R50.1, TP6.P$1, X1.4
unnamed: C40.1, IC10.11 (IN-), R20.1, R28.2
unnamed: IC13.15 (4B), R34.2, X2.1
unnamed: C38.1, IC10.14 (IN-), R15.1, R22.2
unnamed: IC9.6 (A), R50.2, TP7.P$1, X1.5
unnamed: IC13.14 (4A), R34.1, X2.2
unnamed: IC13.10 (3A), R33.2, X2.3
unnamed: IC13.9 (3B), R33.1, X2.6
unnamed: IC13.1 (1B), R18.2, R20.2, X1.6
unnamed: IC13.7 (2B), R14.1, R16.2, X1.2
unnamed: D4.A, J1.1, Q1.3 (D)
unnamed: LED2.A, R13.1
unnamed: Q1.1 (G), R30.1, R35.1
unnamed: IC13.6 (2A), R14.2, R15.2, X1.1
unnamed: IC13.2 (1A), R18.1, R24.2, X1.3
unnamed: D4.C, J1.2, JP4.2
unnamed: IC8.6 (A), R49.2, TP9.P$1, X2.5
unnamed: IC8.7 (B), R49.1, TP8.P$1, X2.4
unnamed: D3.A, Q3.3 (D), X7.1
unnamed: Q3.1 (G), R47.1, R48.1
NRST_RES: C68.1, IC5.7 (NRST), JP7.4
OSC_IN: C43.2, IC5.5 (OSC_IN), Q4.3 (2)
OSC_OUT: C44.2, IC5.6 (OSC_OUT), Q4.1
PA5: IC2.21 (PA5), SV2.4
PA6: IC2.22 (PA6), SV2.3
PA7: IC2.23 (PA7), SV2.2
PWM: IC5.39 (PC8), R35.2
R: IC2.8 (PC0), R5.2
RST: C69.1, IC2.7 (NRST), JP1.4
RX: IC2.17 (PA3), IC12.7 (OUT1), TP15.P$1
RX1_RES: IC5.59 (PB7), JP3.4
RX2_RES: IC5.17 (PA3), IC12.3 (OUT2), TP2.P$1
R_RES: IC5.51 (PC10), R37.2
SCK: IC5.55 (PB3), JP3.8
SIN: C37.1, IC5.24 (PC4), R19.2, R21.1, TP4.P$1
SWCLK: IC2.49 (PA14), JP1.1
SWCLK_RES: IC5.49 (PA14), JP7.1
SWDIO: IC2.46 (PA13), JP1.3
SWDIO_RES: IC5.46 (PA13), JP7.3
TIM1_1: IC1.18 (LIN1), IC2.41 (PA8)
TIM1_1N: IC1.15 (HIN1), IC2.34 (PB13)
TIM1_2: IC1.19 (LIN2), IC2.42 (PA9)
TIM1_2N: IC1.16 (HIN2), IC2.35 (PB14)
TIM1_3: IC1.20 (LIN3), IC2.43 (PA10)
TIM1_3N: IC1.17 (HIN3), IC2.36 (PB15)
TIM1_A: IC5.42 (PA9), IC13.13 (4Y)
TIM1_B: IC5.41 (PA8), IC13.11 (3Y)
TIM3_A: IC5.38 (PC7), IC13.3 (1Y)
TIM3_B: IC5.37 (PC6), IC13.5 (2Y)
TX: IC2.16 (PA2), IC12.6 (IN2), TP16.P$1
TX1_RES: IC5.58 (PB6), JP3.5
TX2_RES: IC5.16 (PA2), IC12.2 (IN1), TP1.P$1
U: C1.2, IC1.8 (U), X3.1
USART3_RX: IC5.30 (PB11), IC9.1 (DO)
USART3_TX: IC5.29 (PB10), IC9.4 (DI)
USART3_TXEN: IC5.33 (PB12), IC9.2 (RE), IC9.3 (DE)
USART5_RX: IC5.54 (PD2), IC8.1 (DO)
USART5_TX: IC5.53 (PC12), IC8.4 (DI)
USART5_TXEN: IC5.34 (PB13), IC8.2 (RE), IC8.3 (DE)
USB_DM: JP11.2 (D-), R43.1
USB_DM_: IC5.44 (PA11), R43.2
USB_DP: JP11.3 (D+), R8.1
USB_DP_: IC5.45 (PA12), R8.2
USB_SHIELD: C26.1, JP11.6 (SHIELD), JP11.7 (SHIELD), JP11.8 (SHIELD), JP11.9 (SHIELD), R52.1
V: C2.2, IC1.5 (V), X3.2
V+: C4.1, C11.1, C15.1, C16.1, C17.+, IC1.10 (V+), R1.P$1 (1), R42.1, X9.2
V-: C4.2, C11.2, C15.2, C16.2, C17.-, IC1.12 (V-), L2.2, R42.2, X9.1
VCAP1: C57.2, IC5.31 (VCAP1)
VCAP2: C58.2, IC5.47 (VCAP2)
VDDA: C31.2, IC5.13 (VDDA), L1.2
VLT: C9.2, D2.C, IC2.25 (PC5), R2.1, R9.1, R12.P$2 (2)
VTH: C19.1, IC1.13 (VTH), IC2.26 (PB0), R4.2
W: C3.2, IC1.2 (W), X3.3
Y: IC2.9 (PC1), R13.2

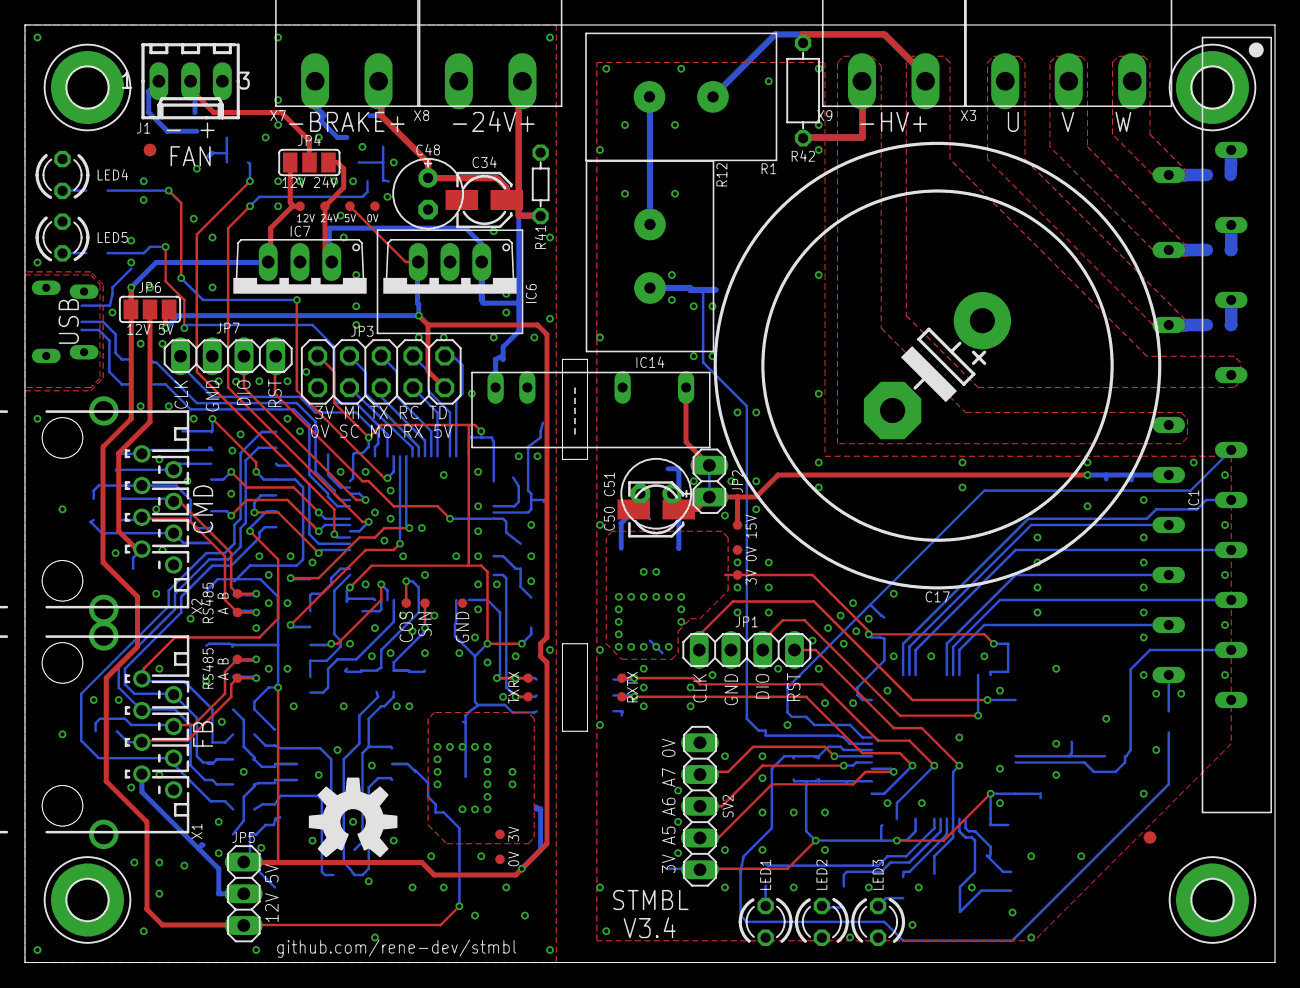
[picture p97: board IRAMX-drv-v3.4.brd from above]

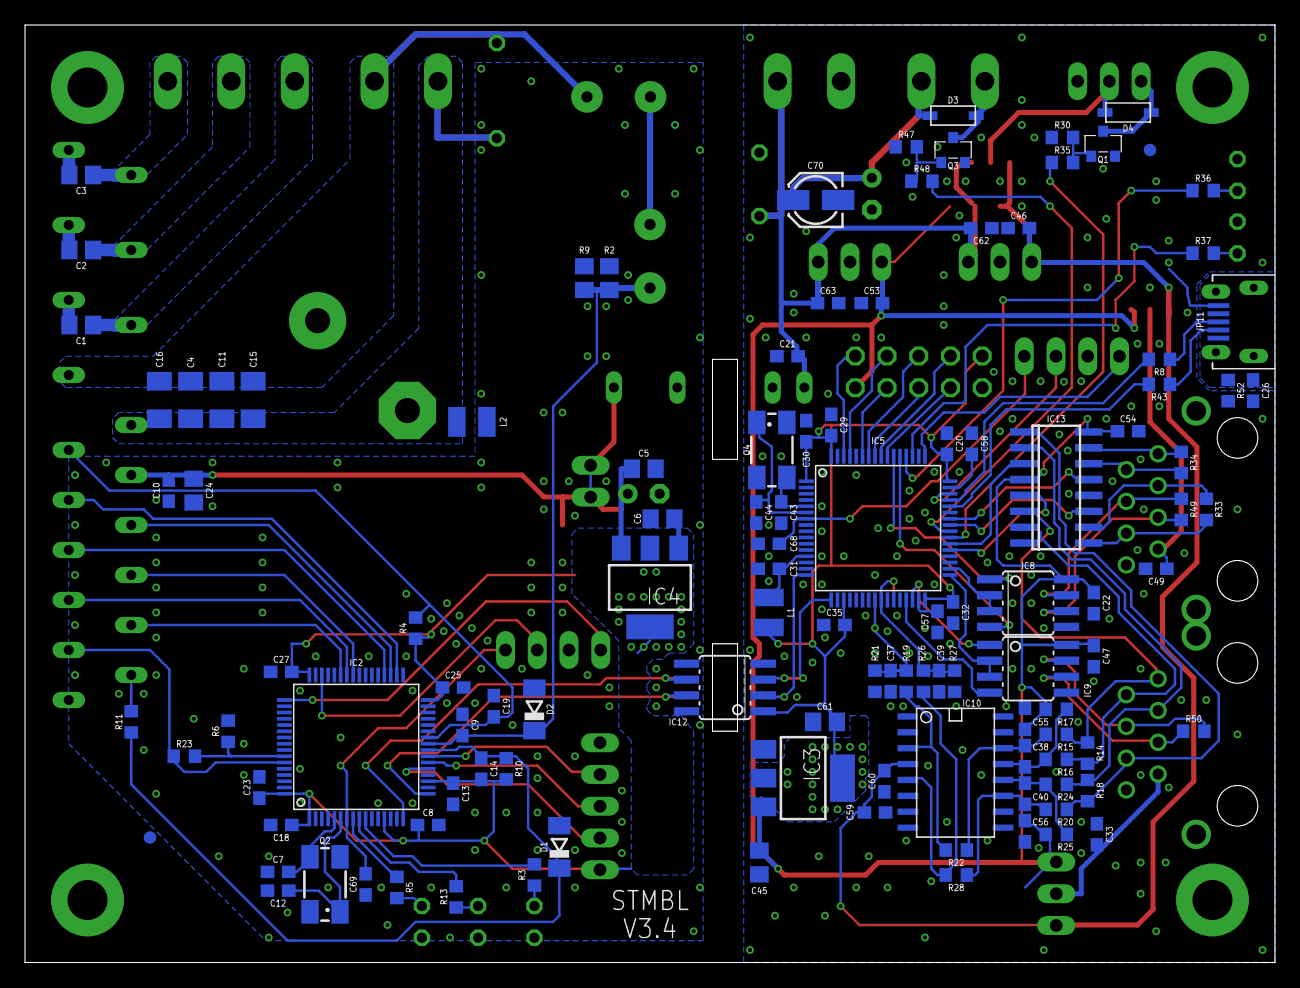
[picture p98: board IRAMX-drv-v3.4.brd from below]

Board: 2 copper layers, 100.0 x 75.0 mm, 175 parts (115 on the bottom side), 110 nets.
