AndriesTuinhof/stmbl/hardware/IRAM256A/doc/f303cbt.ioc

Mcu.UserName=STM32F303CBTx
PA1.Signal=SharedAnalog_PA1
PA10.Signal=USART1_RX
PA11.Signal=USB_DM
PA12.Signal=USB_DP
PA13.Signal=SYS_JTMS-SWDIO
PA14.Signal=SYS_JTCK-SWCLK
PA15.Signal=GPIO_Output
PA2.Signal=OPAMP1_VOUT
PA3.Signal=ADC1_IN4
PA4.Signal=COMP_DAC1_group
PA5.Signal=ADC2_IN2
PA6.Signal=OPAMP2_VOUT
PA7.Signal=SharedAnalog_PA7
PA8.Signal=GPIO_Output
PA9.Signal=USART1_TX
PB0.Signal=SharedAnalog_PB0
PB1.Signal=OPAMP3_VOUT
PB10.Signal=USART3_TX
PB11.Signal=USART3_RX
PB12.Signal=ADC4_IN3
PB13.Signal=ADC3_IN5
PB14.Signal=ADC4_IN4
PB15.Signal=ADC4_IN5
PB3.Signal=TIM8_CH1N
PB4.Signal=TIM8_CH2N
PB5.Signal=TIM8_CH3N
PB6.Signal=S_TIM8_CH1
PB7.Signal=GPIO_Input
PB8.Signal=S_TIM8_CH2
PB9.Signal=S_TIM8_CH3
PF0-OSC_IN.Signal=RCC_OSC_IN
PF1-OSC_OUT.Signal=RCC_OSC_OUT
