AndriesTuinhof/stmbl/firmware/src/main.c

/*
* This file is part of the stmbl project.
*
* Copyright (C) 2013-2015 Rene Hopf <renehopf@mac.com>
* Copyright (C) 2013-2015 Nico Stute <crinq@crinq.de>
*
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
* You should have received a copy of the GNU General Public License
* along with this program.  If not, see <http://www.gnu.org/licenses/>.
*/

//#include "stm32f4xx_conf.h"
#include "hal.h"
#include "setup.h"
#include "defines.h"
#include <string.h>
#include <stdio.h>
#include <stdlib.h>
#include "main.h"
#include "commands.h"

extern RCC_ClocksTypeDef RCC_Clocks;

uint32_t hal_get_systick_value() {
  return (SysTick->VAL);
}

uint32_t hal_get_systick_reload() {
  return (SysTick->LOAD);
}

uint32_t hal_get_systick_freq() {
  return (RCC_Clocks.HCLK_Frequency);
}

volatile uint64_t systime = 0;

void SysTick_Handler(void) {
  systime++;
}

//20kHz
void TIM_SLAVE_HANDLER(void) {
  TIM_ClearITPendingBit(TIM_SLAVE, TIM_IT_Update);
  hal_run_frt();
  if(TIM_GetITStatus(TIM_SLAVE, TIM_IT_Update) == SET) {
    hal_stop();
    hal.hal_state = FRT_TOO_LONG;
  }
}

//5 kHz interrupt for hal. at this point all ADCs have been sampled,
//see setup_res() in setup.c if you are interested in the magic behind this.
void DMA2_Stream0_IRQHandler(void) {
  DMA_ClearITPendingBit(DMA2_Stream0, DMA_IT_TCIF0);
  hal_run_rt();
  if(DMA_GetITStatus(DMA2_Stream0, DMA_IT_TCIF0) == SET) {
    hal_stop();
    hal.hal_state = RT_TOO_LONG;
  }
}

void bootloader(char *ptr) {
  hal_stop();

  NVIC_DisableIRQ(TIM_SLAVE_IRQ);
  NVIC_DisableIRQ(DMA2_Stream0_IRQn);
  NVIC_DisableIRQ(SysTick_IRQn);

  void (*SysMemBootJump)(void);
  volatile uint32_t addr = 0x1FFF0000;

  RCC_DeInit();
  SysTick->CTRL = 0;
  SysTick->LOAD = 0;
  SysTick->VAL  = 0;

  RCC->AHB1RSTR = 0x22E017FF;
  RCC->AHB1RSTR = 0;
  RCC->AHB2RSTR = 0xF1;
  RCC->AHB2RSTR = 0;
  RCC->AHB3RSTR = 0x1;
  RCC->AHB3RSTR = 0;
  RCC->APB1RSTR = 0xF6FEC9FF;
  RCC->APB1RSTR = 0;
  RCC->APB2RSTR = 0x4777933;
  RCC->APB2RSTR = 0;

  SYSCFG->MEMRMP = 0x01;
  SysMemBootJump = (void (*)(void))(*((uint32_t *)(addr + 4)));
  __set_MSP(*(uint32_t *)addr);
  SysMemBootJump();
}
COMMAND("bootloader", bootloader, "enter bootloader");

void nv_reset(char *ptr) {
  NVIC_SystemReset();
}
COMMAND("reset", nv_reset, "reset STMBL");

void about(char *ptr) {
  printf("######## software info ########\n");
  printf(
      "%s v%i.%i.%i %s\n",
      version_info.product_name,
      version_info.major,
      version_info.minor,
      version_info.patch,
      version_info.git_version);
  printf("Branch %s\n", version_info.git_branch);
  printf("Compiled %s %s ", version_info.build_date, version_info.build_time);
  printf("by %s on %s\n", version_info.build_user, version_info.build_host);
  printf("GCC        %s\n", __VERSION__);
  printf("newlib     %s\n", _NEWLIB_VERSION);
#ifdef __CM4_CMSIS_VERSION
  printf("CMSIS      %i.%i\n", __CM4_CMSIS_VERSION_MAIN, __CM4_CMSIS_VERSION_SUB);
#endif
#ifdef __STM32F4XX_STDPERIPH_VERSION
  printf("StdPeriph  %i.%i.%i\n", __STM32F4XX_STDPERIPH_VERSION_MAIN, __STM32F4XX_STDPERIPH_VERSION_SUB1, __STM32F4XX_STDPERIPH_VERSION_SUB2);
#endif
#ifdef __STM32F3xx_HAL_VERSION
  printf("HAL lib... TODO: print version\n");
#endif
  // printf("CPU ID     %lx %lx %lx\n",U_ID[0], U_ID[1], U_ID[2]);
  printf("size: %lu crc:%lx\n", version_info.image_size, version_info.image_crc);
  volatile const version_info_t *bt_version_info = (void *)0x08000188;
  printf("######## Bootloader info ########\n");
  printf(
      "%s v%i.%i.%i %s\n",
      bt_version_info->product_name,
      bt_version_info->major,
      bt_version_info->minor,
      bt_version_info->patch,
      bt_version_info->git_version);
  extern uint8_t _binary_obj_hvf3_hvf3_bin_start;
  extern uint8_t _binary_obj_hvf3_hvf3_bin_size;
  extern uint8_t _binary_obj_hvf3_hvf3_bin_end;
  volatile const version_info_t *hv_version_info = (void *)(&_binary_obj_hvf3_hvf3_bin_start + 0x188);
  printf("######## HV info ########\n");
  printf(
      "%s v%i.%i.%i %s\n",
      hv_version_info->product_name,
      hv_version_info->major,
      hv_version_info->minor,
      hv_version_info->patch,
      hv_version_info->git_version);
  // printf("Branch %s\n",bt_version_info->git_branch);
  // printf("Compiled %s %s ",bt_version_info->build_date, bt_version_info->build_time);
  // printf("by %s on %s\n",bt_version_info->build_user, bt_version_info->build_host);
  //

  printf("hv start:%p ,size:%p ,end%p \n", &_binary_obj_hvf3_hvf3_bin_start, &_binary_obj_hvf3_hvf3_bin_size, &_binary_obj_hvf3_hvf3_bin_end);
}

COMMAND("about", about, "show system infos");


void sleep(char *ptr) {
  float foo = 0;
  sscanf(ptr, " %f", &foo);
  printf("sleeping for %fs\n", foo);
  Wait((uint32_t)(foo * 1000));
  printf("wakeup\n");
}

COMMAND("sleep", sleep, "sleep [s]");

int main(void) {
  // Relocate interrupt vectors
  extern void *g_pfnVectors;
  SCB->VTOR = (uint32_t)&g_pfnVectors;

  setup();
  hal_init(0.0002, 0.00005);
  // hal load comps
  load_comp(comp_by_name("term"));
  hal_parse("flashloadconf");
  hal_parse("loadconf");
  hal_parse("relink");
  hal_parse("start");

  TIM_Cmd(TIM_MASTER, ENABLE);
  TIM_ITConfig(TIM_SLAVE, TIM_IT_Update, ENABLE);

  while(1)  //run non realtime stuff
  {
    hal_run_nrt();
    //cdc_poll();
    Wait(1);
  }
}

void Wait(uint32_t ms) {
  uint64_t t = systime + ms;
  while(t >= systime) {
  }
}
