AndriesTuinhof/stmbl/firmware/src/comps/sserial.c

#include "sserial_comp.h"
/*
* This file is part of the stmbl project.
*
* Copyright (C) 2013 Rene Hopf <renehopf@mac.com>
* Copyright (C) 2015 Ian McMahon <facetious.ian@gmail.com>
* Copyright (C) 2013 Nico Stute <crinq@crinq.de>
*
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
* You should have received a copy of the GNU General Public License
* along with this program.  If not, see <http://www.gnu.org/licenses/>.
*/

#include "commands.h"
#include "hal.h"
#include "math.h"
#include "defines.h"
#include "stm32f4xx_conf.h"
#include "hw/hw.h"
#include "sserial.h"
#include "crc8.h"
#include "setup.h"
#include <string.h>

HAL_COMP(sserial);

// pins
HAL_PIN(error);
HAL_PIN(crc_error);  //counts crc errors, is never reset
HAL_PIN(connected);  //connection status TODO: not stable during startup, needs link to pd
HAL_PIN(timeout);    // 20khz / 1khz * 2 reads = 40

HAL_PIN(pos_cmd);
HAL_PIN(pos_cmd_d);
HAL_PIN(pos_fb);
HAL_PIN(vel_fb);
HAL_PIN(current);
HAL_PIN(scale);

HAL_PIN(clock_scale);
HAL_PIN(available);
HAL_PIN(phase);

HAL_PIN(in0);
HAL_PIN(in1);
HAL_PIN(in2);
HAL_PIN(in3);
HAL_PIN(fault);

HAL_PIN(out0);
HAL_PIN(out1);
HAL_PIN(out2);
HAL_PIN(out3);
HAL_PIN(enable);
HAL_PIN(index_clear);
HAL_PIN(index_out);
HAL_PIN(pos_advance);

//TODO: move to ctx
struct sserial_ctx_t {
  uint32_t phase;
};

static volatile uint8_t rxbuf[128];  //rx dma buffer
static volatile uint8_t txbuf[128];  //tx dma buffer
static uint16_t address;             //current address pointer
static int rxpos;                    //read pointer for rx ringbuffer
static uint32_t timeout;
static lbp_t lbp;
static const char name[] = LBPCardName;
static unit_no_t unit;
static uint32_t max_waste_ticks;
static uint32_t block_bytes;

#pragma pack(push, 1)
//*****************************************************************************
uint8_t sserial_slave[] = {
  0x0B,0x09,0x8B,0x01,0xA5,0x01,0x00,0x00,// 0..7
  0x00,0x00,0x00,0x00,0xA0,0x20,0x10,0x80,// 8..15
  0x00,0x00,0x80,0xFF,0x00,0x00,0x80,0x7F,// 16..23
  0x08,0x00,0x72,0x61,0x64,0x00,0x70,0x6F,// 24..31
  0x73,0x5F,0x63,0x6D,0x64,0x00,0x00,0x00,// 32..39
  0x00,0x00,0x00,0x00,0xA0,0x20,0x10,0x80,// 40..47
  0x00,0x00,0x80,0xFF,0x00,0x00,0x80,0x7F,// 48..55
  0x26,0x00,0x72,0x61,0x64,0x00,0x76,0x65,// 56..63
  0x6C,0x5F,0x63,0x6D,0x64,0x00,0x00,0x00,// 64..71
  0xA0,0x04,0x01,0x80,0x00,0x00,0x00,0x00,// 72..79
  0x00,0x00,0x80,0x3F,0x46,0x00,0x6E,0x6F,// 80..87
  0x6E,0x65,0x00,0x6F,0x75,0x74,0x00,0x00,// 88..95
  0xA0,0x01,0x07,0x80,0x00,0x00,0x00,0x00,// 96..103
  0x00,0x00,0x80,0x3F,0x5F,0x00,0x6E,0x6F,// 104..111
  0x6E,0x65,0x00,0x65,0x6E,0x61,0x62,0x6C,// 112..119
  0x65,0x00,0x00,0x00,0x00,0x00,0x00,0x00,// 120..127
  0xA0,0x20,0x10,0x00,0x00,0x00,0x80,0xFF,// 128..135
  0x00,0x00,0x80,0x7F,0x7A,0x00,0x72,0x61,// 136..143
  0x64,0x00,0x70,0x6F,0x73,0x5F,0x66,0x62,// 144..151
  0x00,0x00,0x00,0x00,0x00,0x00,0x00,0x00,// 152..159
  0xA0,0x20,0x10,0x00,0x00,0x00,0x80,0xFF,// 160..167
  0x00,0x00,0x80,0x7F,0x99,0x00,0x72,0x61,// 168..175
  0x64,0x00,0x76,0x65,0x6C,0x5F,0x66,0x62,// 176..183
  0x00,0x00,0x00,0x00,0xA0,0x08,0x03,0x00,// 184..191
  0x00,0x00,0xF0,0xC1,0x00,0x00,0xF0,0x41,// 192..199
  0xB9,0x00,0x41,0x00,0x63,0x75,0x72,0x72,// 200..207
  0x65,0x6E,0x74,0x00,0x00,0x00,0x00,0x00,// 208..215
  0xA0,0x04,0x01,0x00,0x00,0x00,0xC8,0xC2,// 216..223
  0x00,0x00,0xC8,0x42,0xD4,0x00,0x6E,0x6F,// 224..231
  0x6E,0x65,0x00,0x69,0x6E,0x00,0x00,0x00,// 232..239
  0xA0,0x01,0x07,0x00,0x00,0x00,0x00,0x00,// 240..247
  0x00,0x00,0x80,0x3F,0xEE,0x00,0x6E,0x6F,// 248..255
  0x6E,0x65,0x00,0x66,0x61,0x75,0x6C,0x74,// 256..263
  0x00,0x00,0x00,0x00,0xA0,0x01,0x07,0x40,// 264..271
  0x00,0x00,0x00,0x00,0x00,0x00,0x80,0x3F,// 272..279
  0x09,0x01,0x6E,0x6F,0x6E,0x65,0x00,0x69,// 280..287
  0x6E,0x64,0x65,0x78,0x5F,0x65,0x6E,0x61,// 288..295
  0x62,0x6C,0x65,0x00,0x00,0x00,0x00,0x00,// 296..303
  0xA0,0x20,0x10,0x80,0x00,0x00,0x80,0xFF,// 304..311
  0x00,0x00,0x80,0x7F,0x2C,0x01,0x6E,0x6F,// 312..319
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
};

const discovery_rpc_t discovery = {
    .ptocp  = 0x018B,
    .gtocp  = 0x01A5,
    .input  = 11,
    .output = 9,
};

typedef struct {
  float pos_cmd;
  float vel_cmd;
  uint32_t out_0 : 1;
  uint32_t out_1 : 1;
  uint32_t out_2 : 1;
  uint32_t out_3 : 1;
  uint32_t enable : 1;
  uint32_t index_enable : 1;
  uint32_t padding : 2;
} sserial_out_process_data_t;  //size:9 bytes
_Static_assert(sizeof(sserial_out_process_data_t) == 9, "sserial_out_process_data_t size error!");

typedef struct {
  float pos_fb;
  float vel_fb;
  int8_t current;
  uint32_t in_0 : 1;
  uint32_t in_1 : 1;
  uint32_t in_2 : 1;
  uint32_t in_3 : 1;
  uint32_t fault : 1;
  uint32_t index_enable : 1;
  uint32_t padding : 2;
} sserial_in_process_data_t;  //size:10 bytes
_Static_assert(sizeof(sserial_in_process_data_t) == 10, "sserial_in_process_data_t size error!");
//global name:scale addr:0x12c size:32 dir:0x80
#define scale_address 300
//******************************************************************************
#pragma pack(pop)

static sserial_out_process_data_t data_out;
static sserial_in_process_data_t data_in;

static uint8_t crc_reuest(uint8_t len) {
  uint8_t crc = crc8_init();
  for(int i = rxpos; i < rxpos + len; i++) {
    crc = crc8_update(crc, (void *)&(rxbuf[i % sizeof(rxbuf)]), 1);
  }
  crc = crc8_finalize(crc);
  return crc == rxbuf[(rxpos + len) % sizeof(rxbuf)];
}

static uint8_t crc8(uint8_t *addr, uint8_t len) {
  uint8_t crc = crc8_init();
  crc         = crc8_update(crc, addr, len);
  return crc8_finalize(crc);
}

static void send(uint8_t len, uint8_t docrc) {
  timeout = 0;
  if(docrc) {
    txbuf[len] = crc8((uint8_t *)txbuf, len);
    DMA_SetCurrDataCounter(DMA1_Stream4, len + 1);
  } else {
    DMA_SetCurrDataCounter(DMA1_Stream4, len);
  }
  DMA_Cmd(DMA1_Stream4, DISABLE);
  DMA_ClearFlag(DMA1_Stream4, DMA_FLAG_TCIF4);
  DMA_Cmd(DMA1_Stream4, ENABLE);
}

//v3
//pb13 txen
//pc12 usart5 tx
//pa9 usart1 tx as rx
//USART5 TX DMA1 stream7 channel4
//USART1 RX DMA2 stream5 channel4

//v4.1
//pa0 usart4 tx DMA1 stream4 channel4 CMD_36
//pa10 usart1 rx DMA2 stream5 channel4 CMD_12

//TODO: lbp command 0xe6 to set mode

static void hw_init(void *ctx_ptr, hal_pin_inst_t *pin_ptr) {
  // struct sserial_ctx_t * ctx = (struct sserial_ctx_t *)ctx_ptr;
  struct sserial_pin_ctx_t *pins = (struct sserial_pin_ctx_t *)pin_ptr;

  PIN(timeout) = 100.0;  // 20khz / 1khz * 2 reads = 40

  GPIO_InitTypeDef GPIO_InitStruct;
  USART_InitTypeDef USART_InitStruct;
  DMA_InitTypeDef DMA_InitStructure;
  RCC_APB2PeriphClockCmd(RCC_APB2Periph_USART1, ENABLE);
  RCC_APB1PeriphClockCmd(RCC_APB1Periph_UART4, ENABLE);
  //USART TX
  GPIO_PinAFConfig(GPIOA, GPIO_PinSource0, GPIO_AF_UART4);
  GPIO_InitStruct.GPIO_Pin   = GPIO_Pin_0;
  GPIO_InitStruct.GPIO_Mode  = GPIO_Mode_AF;
  GPIO_InitStruct.GPIO_Speed = GPIO_Speed_50MHz;
  GPIO_InitStruct.GPIO_OType = GPIO_OType_PP;
  GPIO_InitStruct.GPIO_PuPd  = GPIO_PuPd_UP;
  GPIO_Init(GPIOA, &GPIO_InitStruct);

  //USART RX
  GPIO_PinAFConfig(GPIOA, GPIO_PinSource10, GPIO_AF_USART1);
  GPIO_InitStruct.GPIO_Pin = GPIO_Pin_10;
  GPIO_Init(GPIOA, &GPIO_InitStruct);

  USART_InitStruct.USART_BaudRate            = 2500000;
  USART_InitStruct.USART_WordLength          = USART_WordLength_8b;
  USART_InitStruct.USART_StopBits            = USART_StopBits_1;
  USART_InitStruct.USART_Parity              = USART_Parity_No;
  USART_InitStruct.USART_HardwareFlowControl = USART_HardwareFlowControl_None;
  USART_InitStruct.USART_Mode                = USART_Mode_Rx;
  USART_Init(USART1, &USART_InitStruct);
  USART_InitStruct.USART_Mode = USART_Mode_Tx;
  USART_Init(UART4, &USART_InitStruct);

  USART_Cmd(USART1, ENABLE);
  USART_Cmd(UART4, ENABLE);

  //RX DMA

  DMA_Cmd(DMA2_Stream5, DISABLE);
  DMA_DeInit(DMA2_Stream5);

  // DMA2-Config
  DMA_InitStructure.DMA_Channel            = DMA_Channel_4;
  DMA_InitStructure.DMA_PeripheralBaseAddr = (uint32_t) & (USART1->DR);
  DMA_InitStructure.DMA_Memory0BaseAddr    = (uint32_t)&rxbuf;
  DMA_InitStructure.DMA_DIR                = DMA_DIR_PeripheralToMemory;
  DMA_InitStructure.DMA_BufferSize         = sizeof(rxbuf);
  DMA_InitStructure.DMA_PeripheralInc      = DMA_PeripheralInc_Disable;
  DMA_InitStructure.DMA_MemoryInc          = DMA_MemoryInc_Enable;
  DMA_InitStructure.DMA_PeripheralDataSize = DMA_PeripheralDataSize_Byte;
  DMA_InitStructure.DMA_MemoryDataSize     = DMA_PeripheralDataSize_Byte;
  DMA_InitStructure.DMA_Mode               = DMA_Mode_Circular;
  DMA_InitStructure.DMA_Priority           = DMA_Priority_High;
  DMA_InitStructure.DMA_FIFOMode           = DMA_FIFOMode_Disable;
  DMA_InitStructure.DMA_FIFOThreshold      = DMA_FIFOThreshold_HalfFull;
  DMA_InitStructure.DMA_MemoryBurst        = DMA_MemoryBurst_Single;
  DMA_InitStructure.DMA_PeripheralBurst    = DMA_PeripheralBurst_Single;
  DMA_Init(DMA2_Stream5, &DMA_InitStructure);

  DMA_Cmd(DMA2_Stream5, ENABLE);

  USART_DMACmd(USART1, USART_DMAReq_Rx, ENABLE);

  //TX DMA

  DMA_Cmd(DMA1_Stream4, DISABLE);
  DMA_DeInit(DMA1_Stream4);

  // DMA2-Config
  DMA_InitStructure.DMA_Channel            = DMA_Channel_4;
  DMA_InitStructure.DMA_PeripheralBaseAddr = (uint32_t) & (UART4->DR);
  DMA_InitStructure.DMA_Memory0BaseAddr    = (uint32_t)&txbuf;
  DMA_InitStructure.DMA_DIR                = DMA_DIR_MemoryToPeripheral;
  DMA_InitStructure.DMA_BufferSize         = sizeof(txbuf);
  DMA_InitStructure.DMA_PeripheralInc      = DMA_PeripheralInc_Disable;
  DMA_InitStructure.DMA_MemoryInc          = DMA_MemoryInc_Enable;
  DMA_InitStructure.DMA_PeripheralDataSize = DMA_PeripheralDataSize_Byte;
  DMA_InitStructure.DMA_MemoryDataSize     = DMA_PeripheralDataSize_Byte;
  DMA_InitStructure.DMA_Mode               = DMA_Priority_Low;
  DMA_InitStructure.DMA_Priority           = DMA_Priority_High;
  DMA_InitStructure.DMA_FIFOMode           = DMA_FIFOMode_Disable;
  DMA_InitStructure.DMA_FIFOThreshold      = DMA_FIFOThreshold_HalfFull;
  DMA_InitStructure.DMA_MemoryBurst        = DMA_MemoryBurst_Single;
  DMA_InitStructure.DMA_PeripheralBurst    = DMA_PeripheralBurst_Single;
  DMA_Init(DMA1_Stream4, &DMA_InitStructure);

  USART_DMACmd(UART4, USART_DMAReq_Tx, ENABLE);

  //tx enable
  GPIO_InitStruct.GPIO_Pin   = GPIO_Pin_7;
  GPIO_InitStruct.GPIO_Mode  = GPIO_Mode_OUT;
  GPIO_InitStruct.GPIO_OType = GPIO_OType_PP;
  GPIO_InitStruct.GPIO_Speed = GPIO_Speed_2MHz;
  GPIO_InitStruct.GPIO_PuPd  = GPIO_PuPd_NOPULL;
  GPIO_Init(GPIOB, &GPIO_InitStruct);

  GPIO_SetBits(GPIOB, GPIO_Pin_7);

  //generate unit number from 96bit unique chip ID
  unit.unit = U_ID[0] ^ U_ID[1] ^ U_ID[2];

  rxpos   = 0;
  timeout = 1000;  //make sure we start in timeout

  //bytes to wait before expected end of transmission to prevent timeouts
  block_bytes = 5;
  //calculate timeout in systicks for block_bytes
  max_waste_ticks = (1.0 / 2500000.0) * 11.0 * (float)block_bytes / (1.0f / (float)hal_get_systick_freq());

  PIN(clock_scale) = 1.0;
  PIN(phase) = 0;
}

// static void rt_func(float period, void *ctx_ptr, hal_pin_inst_t *pin_ptr) {
//   struct sserial_pin_ctx_t *pins = (struct sserial_pin_ctx_t *)pin_ptr;
//   //struct sserial_ctx_t *mem = (struct sserial_ctx_t *)ctx_ptr;
//   PIN(phase) = 0;
// }

static void frt_func(float period, void *ctx_ptr, hal_pin_inst_t *pin_ptr) {
  struct sserial_pin_ctx_t *pins = (struct sserial_pin_ctx_t *)pin_ptr;
  //struct sserial_ctx_t *mem = (struct sserial_ctx_t *)ctx_ptr;
  //next received packet will be written to bufferpos
  uint32_t bufferpos = sizeof(rxbuf) - DMA_GetCurrDataCounter(DMA2_Stream5);
  //how many packets we have the the rx buffer for processing
  uint32_t available = (bufferpos - rxpos + sizeof(rxbuf)) % sizeof(rxbuf);

  PIN(phase) += 1.0;
  
  uint32_t goal = 5;
  PIN(clock_scale) = 1.0;
  if(PIN(phase) > 3){
    PIN(phase) = 0;
    if(available > goal){
    PIN(clock_scale) = 0.9;
    }
    else if(available < goal && available > 0){
      PIN(clock_scale) = 1.1;
    }
  }

  PIN(available) = available;

  if(available >= 1) {
    lbp.byte = rxbuf[rxpos];

    if(lbp.ct == CT_LOCAL && lbp.wr == 0) {  //local read, cmd+crc = 2b
      timeout = 0;
      if(available >= 2) {
        switch(lbp.byte) {
          case LBPCookieCMD:
            txbuf[0] = LBPCookie;
            break;
          case LBPStatusCMD:  //TODO: return status
            txbuf[0] = 0x00;
            break;
          case LBPCardName0Cmd ... LBPCardName3Cmd:
            txbuf[0] = name[lbp.byte - LBPCardName0Cmd];
            break;
          default:  //TODO: handle unknown command condition
            txbuf[0] = 0x00;
        }
        send(1, 1);
        rxpos += 2;
      }
    } else if(lbp.ct == CT_LOCAL && lbp.wr == 1) {  //local write, cmd+data+crc = 3b
      timeout = 0;
      //0xFF and 0xFC are not followed by crc
      if(rxbuf[rxpos] == 0xFF) {
        // reset parser
        rxpos += 1;
      } else if(rxbuf[rxpos] == 0xFC) {
        // todo
        rxpos += 1;
      } else if(available >= 3) {  //writes do not expect crc in reply
        txbuf[0] = 0x00;
        send(1, 0);
        rxpos += 3;
      }
    } else if(lbp.ct == CT_RPC) {  //RPC TODO: check for ct should not required for rpc
      timeout = 0;
      if(lbp.byte == UnitNumberRPC && available >= 2) {  //unit number, cmd+crc = 2b
        txbuf[0] = unit.byte[0];
        txbuf[1] = unit.byte[1];
        txbuf[2] = unit.byte[2];
        txbuf[3] = unit.byte[3];
        send(4, 1);
        rxpos += 2;
      } else if(lbp.byte == DiscoveryRPC && available >= 2) {  //discovery, cmd+crc = 2b
        memcpy((void *)txbuf, ((uint8_t *)&discovery), sizeof(discovery));
        send(sizeof(discovery), 1);
        rxpos += 2;
      } else if(lbp.byte == ProcessDataRPC && available >= discovery.output + 2 - block_bytes) {  //process data, requires cmd+output bytes+crc
        uint32_t t1         = hal_get_systick_value();
        uint32_t wait_ticks = 0;
        //wait with timeout until rest of process data is received
        do {
          uint32_t t2 = hal_get_systick_value();
          if(t1 < t2) {
            t1 += hal_get_systick_reload();
          }
          wait_ticks = t1 - t2;
          //next received packet will be written to bufferpos
          bufferpos = sizeof(rxbuf) - DMA_GetCurrDataCounter(DMA2_Stream5);
          //how many packets we have the the rx buffer for processing
          available = (bufferpos - rxpos + sizeof(rxbuf)) % sizeof(rxbuf);
        } while(available < discovery.output + 2 && wait_ticks <= max_waste_ticks);
        //TODO: fault handling on timeout...
        //set input pins
        data_in.pos_fb  = PIN(pos_fb) + PIN(vel_fb) * PIN(pos_advance);
        data_in.vel_fb  = PIN(vel_fb);
        data_in.current = CLAMP(PIN(current) / (30.0f / 128.0f), -127, 127);
        data_in.in_0    = (PIN(in0) > 0) ? 1 : 0;
        data_in.in_1    = (PIN(in1) > 0) ? 1 : 0;
        data_in.in_2    = (PIN(in2) > 0) ? 1 : 0;
        data_in.in_3    = (PIN(in3) > 0) ? 1 : 0;
        data_in.fault   = (PIN(fault) > 0) ? 1 : 0;

        //copy output pins from rx buffer
        for(int i = 0; i < discovery.output; i++) {
          ((uint8_t *)(&data_out))[i] = rxbuf[(rxpos + i + 1) % sizeof(rxbuf)];
        }

        //set bidirectional pins
        PIN(index_out)       = data_out.index_enable;
        data_in.index_enable = (PIN(index_clear) > 0) ? 0 : data_out.index_enable;

        //copy input pins to tx buffer
        txbuf[0] = 0x00;  //fault byte
        for(int i = 0; i < (discovery.input - 1); i++) {
          txbuf[i + 1] = ((uint8_t *)(&data_in))[i];
        }
        if(crc_reuest(discovery.output + 1)) {
          //send buffer
          DMA_SetCurrDataCounter(DMA1_Stream4, discovery.input + 1);
          DMA_Cmd(DMA1_Stream4, DISABLE);
          DMA_ClearFlag(DMA1_Stream4, DMA_FLAG_TCIF4);
          DMA_Cmd(DMA1_Stream4, ENABLE);
          txbuf[discovery.input] = crc8((uint8_t *)txbuf, discovery.input);
          //send(discovery.input, 1);
          timeout = 0;
          //set output pins

          PIN(pos_cmd)   = data_out.pos_cmd;
          PIN(pos_cmd_d) = data_out.vel_cmd;
          PIN(out0)      = data_out.out_0;
          PIN(out1)      = data_out.out_1;
          PIN(out2)      = data_out.out_2;
          PIN(out3)      = data_out.out_3;
          PIN(enable)    = data_out.enable;
        } else {
          PIN(crc_error)
          ++;
          PIN(connected) = 0;
          PIN(error)     = 1;
          PIN(pos_cmd)   = 0;
          PIN(pos_cmd_d) = 0;
          PIN(out0)      = 0;
          PIN(out1)      = 0;
          PIN(out2)      = 0;
          PIN(out3)      = 0;
          PIN(enable)    = 0;
        }
        rxpos += discovery.output + 2;
      }
    } else if(lbp.ct == CT_RW && lbp.wr == 0) {  //read
      //size = 1 + 2*lbp.as  + 1
      int size = 2 * lbp.as + 2;
      timeout  = 0;
      if(available >= size) {
        if(lbp.as) {  //address included in command = cmd+addr+addr+crc
          address = rxbuf[(rxpos + 1) % sizeof(rxbuf)] + (rxbuf[(rxpos + 2) % sizeof(rxbuf)] << 8);
          rxpos += 4;
        } else {  //address not included in command = cmd+crc
          rxpos += 2;
        }
        //TODO: causes timeouts...
        //if((address + (1 << lbp.ds)) < ARRAY_SIZE(sserial_slave)) {  //check if address is valid
        memcpy((void *)txbuf, &sserial_slave[address], (1 << lbp.ds));
        send((1 << lbp.ds), 1);
        //}
        if(lbp.ai) {  //auto increment address by datasize
          address += (1 << lbp.ds);
        }
      }
    } else if(lbp.ct == CT_RW && lbp.wr == 1) {  // lbp (addr1 addr2) data0, data1,...
      //size = 1 + 2*ai +ds +crc
      int size = 2 * lbp.as + (1 << lbp.ds) + 2;
      timeout  = 0;
      if(available >= size) {
        if(lbp.as) {  //address included in command = cmd+addr+addr+crc
          address = rxbuf[(rxpos + 1) % sizeof(rxbuf)] + (rxbuf[(rxpos + 2) % sizeof(rxbuf)] << 8);
          rxpos += 3;
        } else {  //address not included in command = cmd+crc
          rxpos += 1;
        }
        //TODO: check size
        if((address + (1 << lbp.ds)) < ARRAY_SIZE(sserial_slave)) {  //check if address is valid
          for(int i = 0; i < (1 << lbp.ds); i++) {
            sserial_slave[address + i] = rxbuf[(rxpos + i) % sizeof(rxbuf)];
          }
        }
        rxpos += (1 << lbp.ds) + 1;
        //update globals
        float tmp;
        memcpy(&tmp, &sserial_slave[scale_address], 4);
        PIN(scale) = tmp;
        if(lbp.ai) {  //auto increment address by datasize
          address += (1 << lbp.ds);
        }
      }
    } else {
      //TODO: handle unkown packet
    }
  }

  if(timeout > PIN(timeout)) {  //TODO: clamping
    PIN(connected) = 0;
    PIN(error)     = 1;
    PIN(pos_cmd)   = 0;
    PIN(pos_cmd_d) = 0;
    PIN(out0)      = 0;
    PIN(out1)      = 0;
    PIN(out2)      = 0;
    PIN(out3)      = 0;
    PIN(enable)    = 0;
    rxpos          = bufferpos;
  } else {
    PIN(connected) = 1;
    PIN(error)     = 0;
  }
  rxpos = rxpos % sizeof(rxbuf);
  timeout++;
}

const hal_comp_t sserial_comp_struct = {
    .name      = "sserial",
    .nrt       = 0,  //nrt_func,
    .rt        = 0,
    .frt       = frt_func,
    .nrt_init  = 0,
    .hw_init   = hw_init,
    .rt_start  = 0,
    .frt_start = 0,
    .rt_stop   = 0,
    .frt_stop  = 0,
    .ctx_size  = sizeof(struct sserial_ctx_t),
    .pin_count = sizeof(struct sserial_pin_ctx_t) / sizeof(struct hal_pin_inst_t),
};
