AndriesTuinhof/stmbl/firmware/src/config.c

/*
* This file is part of the stmbl project.
*
* Copyright (C) 2013-2015 Rene Hopf <renehopf@mac.com>
* Copyright (C) 2013-2015 Nico Stute <crinq@crinq.de>
*
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
* You should have received a copy of the GNU General Public License
* along with this program.  If not, see <http://www.gnu.org/licenses/>.
*/

#include <stdio.h>
#include <string.h>
#include "hal.h"
#include "commands.h"
#include "stm32f4xx_conf.h"

char config[15 * 1024];
const char *config_ro = (char *)0x08008000;

void confcrc(char *ptr) {
  uint32_t len = strnlen(config, sizeof(config) - 1);
  CRC_ResetDR();
  uint32_t crc = CRC_CalcBlockCRC((uint32_t *)config, len / 4);
  for(int i = 0; i < len; i++) {
    printf("%x ", config[i]);
  }
  printf("\n");
  printf("size: %lu words: %lu crc:%lx\n", len, len / 4, crc);
}
COMMAND("confcrc", confcrc, "foo");

void flashloadconf(char *ptr) {
  strncpy(config, config_ro, sizeof(config));
}
COMMAND("flashloadconf", flashloadconf, "load config from flash");

void flashsaveconf(char *ptr) {
  printf("erasing flash page...\n");
  FLASH_Unlock();
  if(FLASH_EraseSector(FLASH_Sector_2, VoltageRange_3) != FLASH_COMPLETE) {
    printf("error!\n");
    FLASH_Lock();
    return;
  }
  printf("saving conf\n");
  int i   = 0;
  int ret = 0;
  do {
    ret = FLASH_ProgramByte((uint32_t)(config_ro + i), config[i]) != FLASH_COMPLETE;
    if(ret) {
      printf("error writing %i\n", ret);
      break;
    }
  } while(config[i++] != 0);
  printf("OK %i bytes written\n", i);
  FLASH_Lock();
}
COMMAND("flashsaveconf", flashsaveconf, "save config to flash");

void loadconf(char *ptr) {
  hal_parse(config);
}
COMMAND("loadconf", loadconf, "parse config");

void showconf(char *ptr) {
  printf("%s", config_ro);
}
COMMAND("showconf", showconf, "show config");

void appendconf(char *ptr) {
  printf("adding %s\n", ptr);
  strncat(config, ptr, sizeof(config) - 1);
  strncat(config, "\n", sizeof(config) - 1);
}
COMMAND("appendconf", appendconf, "append string to config");

void deleteconf(char *ptr) {
  config[0] = '\0';
}
COMMAND("deleteconf", deleteconf, "delete config");

void hardboot(char *ptr) {
  printf("erasing flash page...\n");
  FLASH_Unlock();
  if(FLASH_EraseSector(FLASH_Sector_4, VoltageRange_3) != FLASH_COMPLETE) {
    printf("error!\n");
    FLASH_Lock();
    return;
  }
  printf("OK, call bootloader\n");
  FLASH_Lock();
  NVIC_SystemReset();
}
COMMAND("hardboot", hardboot, "destroy firmware to force bootloader");
