AndriesTuinhof/stmbl/firmware/inc/setup.h

//
//  setup.h
//  test
//
//  Created by Rene on 09/12/13.
//  Copyright (c) 2013 Rene Hopf. All rights reserved.
//

#pragma once

#include "stm32f4xx_conf.h"
//#include "misc.h"
#include "version.h"
#include "common.h"
#include "hw/hw.h"
#define U_ID ((__IO uint32_t *)0x1FFF7A10)

void setup(void);
void setup_res(void);
