AndriesTuinhof/stmbl/(commit log)

2022-10-24 file structure change
    [11ua.kicad_pcb, 11ua.sch, Bob.kicad_pcb, Bob.sch, IRAMX-drv-v3.1.brd, IRAMX-drv-v3.1.sch, IRAMX-drv-v3.3.brd, IRAMX-drv-v3.3.sch]
2022-10-24 file structure change + kicad update
    [cmd.kicad_sch, cmd.sch, ctrl.kicad_sch, ctrl.sch, cur.kicad_sch, cur.sch, f3.kicad_sch, f3.sch]
2022-10-24 Structure change + kicad 3d models updated
    [cmd.kicad_sch, ctrl.kicad_sch, cur.kicad_sch, f3.kicad_sch, f4.kicad_sch, fb.kicad_sch, hv.kicad_sch, hv_drive.kicad_sch]
2022-10-29 Update some package (3D models) + replaced ACT4088 with AOZ1280
    AOZ1280 is quite similar to the act4088 with the benefit of being still available for a reasonable price. with the drawback of pinout being different. The schematic had to be moved around and is no longer the same for the three voltage levels.
    [stmbl_4.0.kicad_sch, supply.kicad_sch]
2022-10-29 Added pin header & cap 3d model
2023-01-08 intermediate update
    [hv_supply.kicad_sch, stmbl_4.0.kicad_sch, supply.kicad_sch]
